Astrelis-Nav/SWARM_COMMs/README.md

# SWARM_COMMs
A modular communication system for underwater ROV swarms and multi-node vehicle systems.
