Astrelis-Nav/SWARM_COMMs/SWARM_PCB_Rev_2/Improvement Notes.txt

Pico 2 EN - floating not tied to GND (or 3.3V like previously)
