Astrelis-Nav/SWARM_COMMs/PCB Design/COMMs_Rev_2/RX_Rev_2/RX_3D_Model_Rev_2.1.step

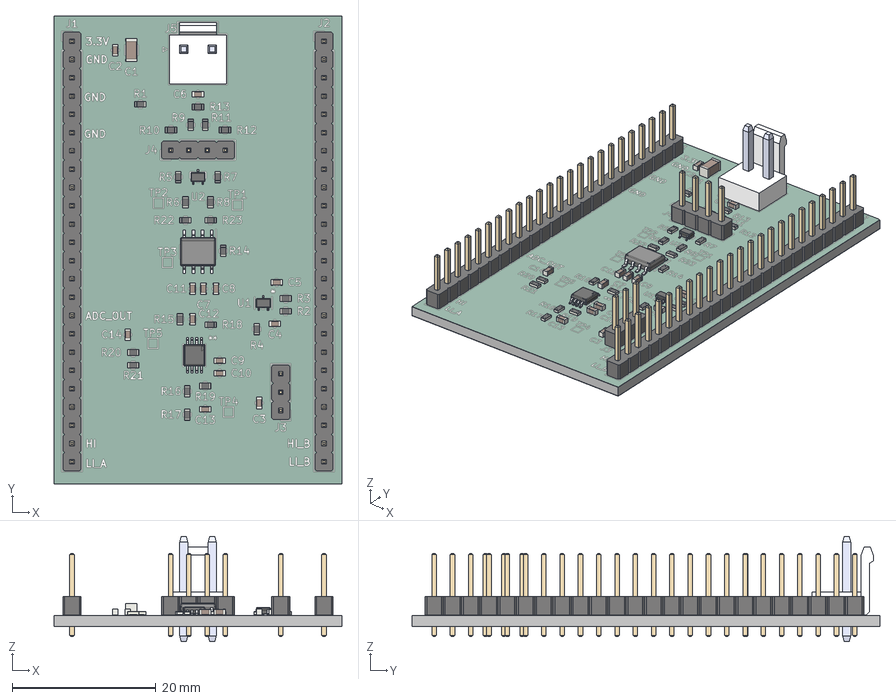
[picture p1: CAD file, 2026-03-30]
PCB Design/COMMs_Rev_2/RX_Rev_2/RX_3D_Model_Rev_2.1.step
40.0 x 65.0 x 14.6 mm
R_0603_1608Metric x 23
C_0603_1608Metric x 13
BODY_MUA08A
LEAD_MUA08A x 8
PinHeader_1x03_P2.54mm_Vertical
PinHeader_1x24_P2.54mm_Vertical x 2
BxP-VH_2
pin x 2
PinHeader_1x04_P2.54mm_Vertical
BODY-SOT x 2
LEAD-SOT x 6
PIN1-ID x 2
BODY-SO
LEAD-D0008A x 8
C_1206_3216Metric
RX_silkscreen x 2
RX_soldermask x 2
RX_PCB
