Astrelis-Nav/SWARM_COMMs/PCB Design/SENSOR_Rev_1/SENSOR_3D_Model_Rev_1.1.step

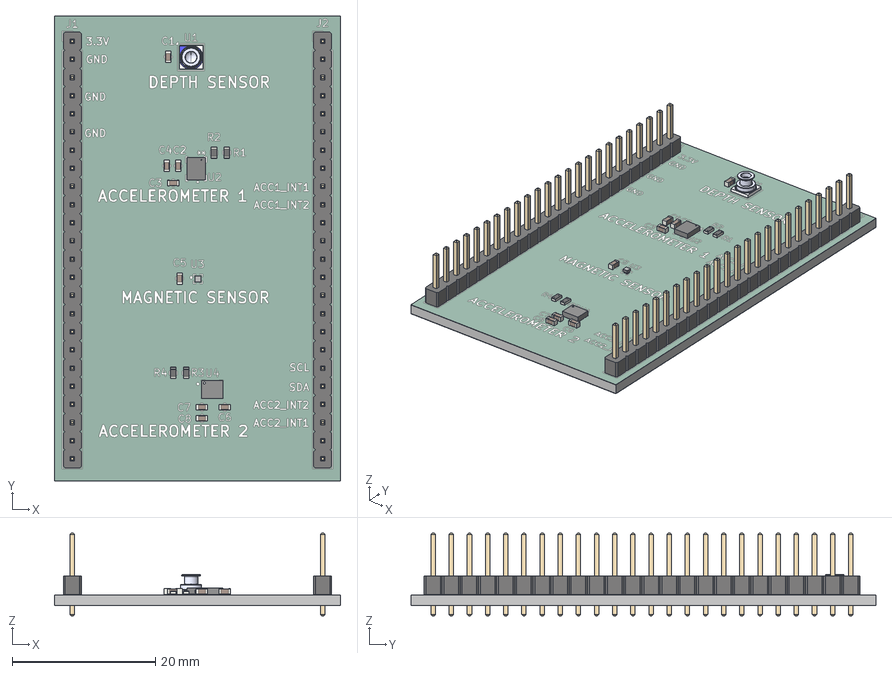
[picture p2: CAD file, 2026-03-30]
PCB Design/SENSOR_Rev_1/SENSOR_3D_Model_Rev_1.1.step
40.0 x 65.0 x 11.5 mm
C_0603_1608Metric x 8
LGA14_2P5X3_STM
R_0603_1608Metric x 4
PinHeader_1x24_P2.54mm_Vertical x 2
LSM6DSO32TR
MS583730BA01-50_MS583730BA01-50
MMC5603NJ
SENSOR_silkscreen x 2
SENSOR_soldermask x 2
SENSOR_PCB
