Astrelis-Nav/SWARM_COMMs/PCB Design/OUTPUTs_Rev_1/OUTPUTs_Schematic_Rev_1.2.pdf

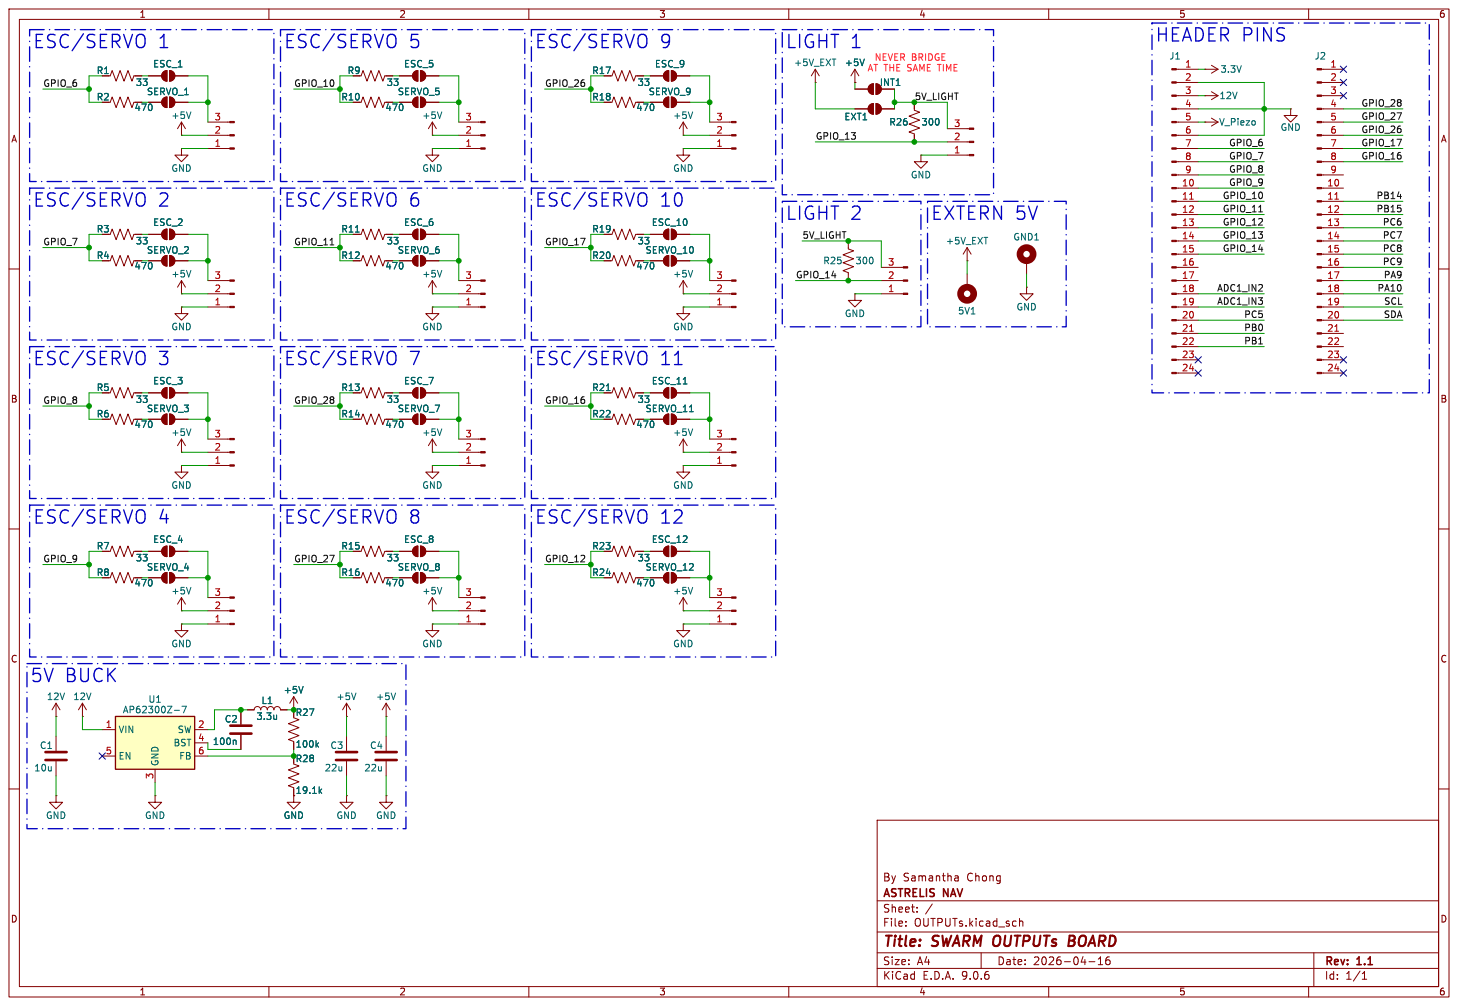
[picture p3: page 1]

Id: 1/1 Title: SWARM OUTPUTs BOARD
