Astrelis-Nav/SWARM_COMMs/PCB Design/PWR_Rev_1/PWR_Schematic_Rev_1.2.pdf

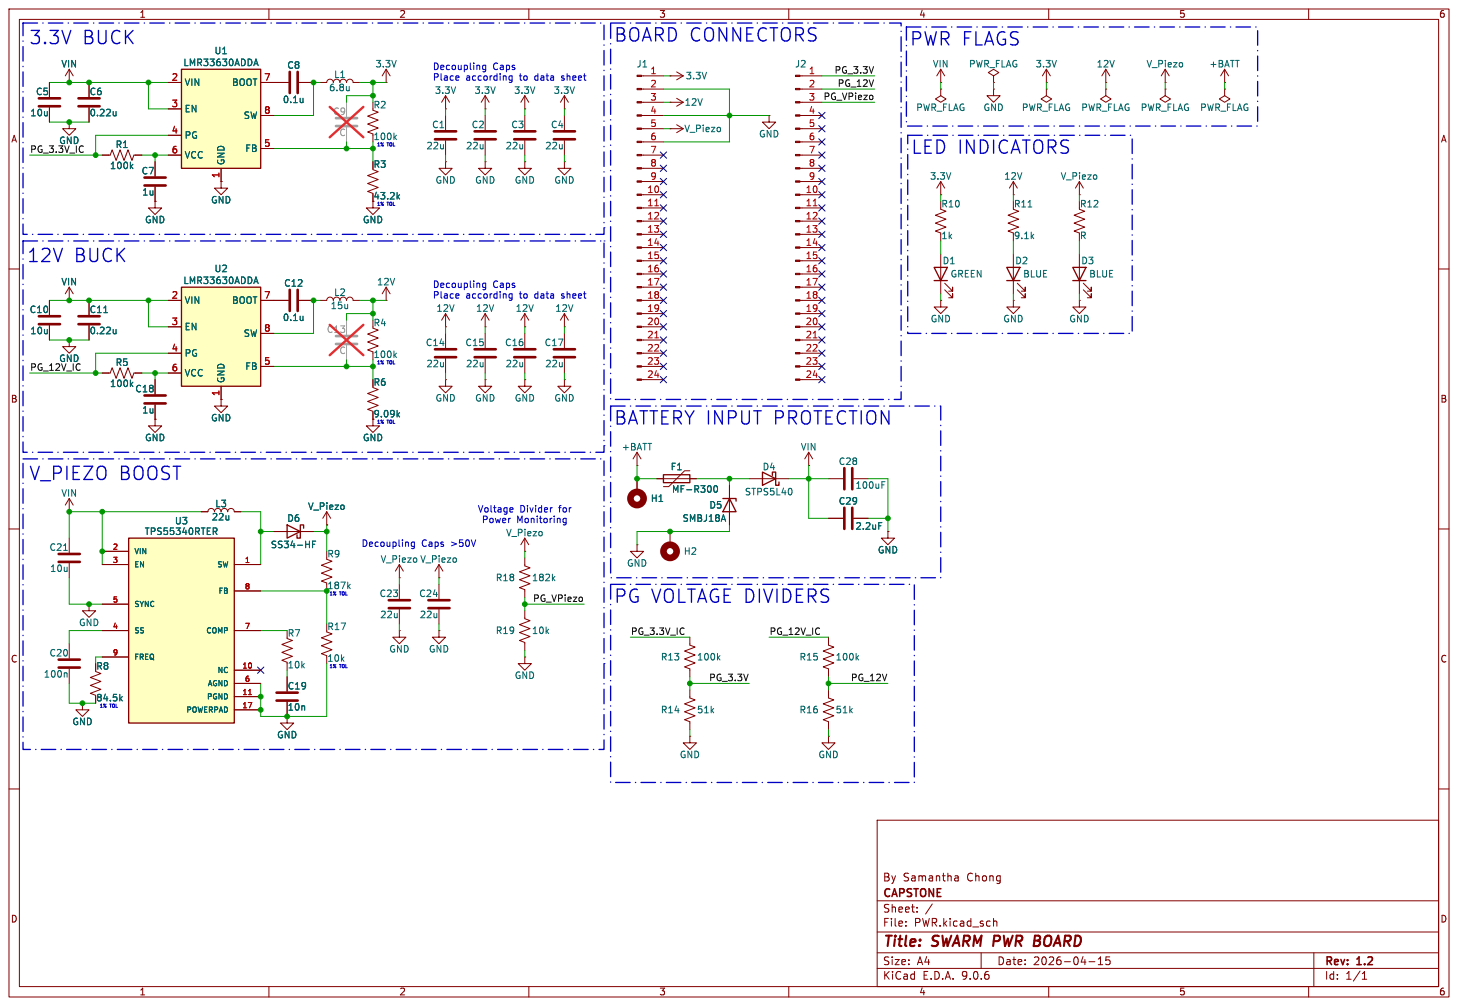
[picture p4: page 1]

1 BOOT 7 SW 8 FB GND 5 R1

By Samantha Chong
File: PWR.kicad_sch Sheet: / CAPSTONE

Id: 1/1 Title: SWARM PWR BOARD
