Astrelis-Nav/SWARM_COMMs/PCB Design/CONTROL_Rev_1/CONTROL_Schematic_Rev_1.1.pdf

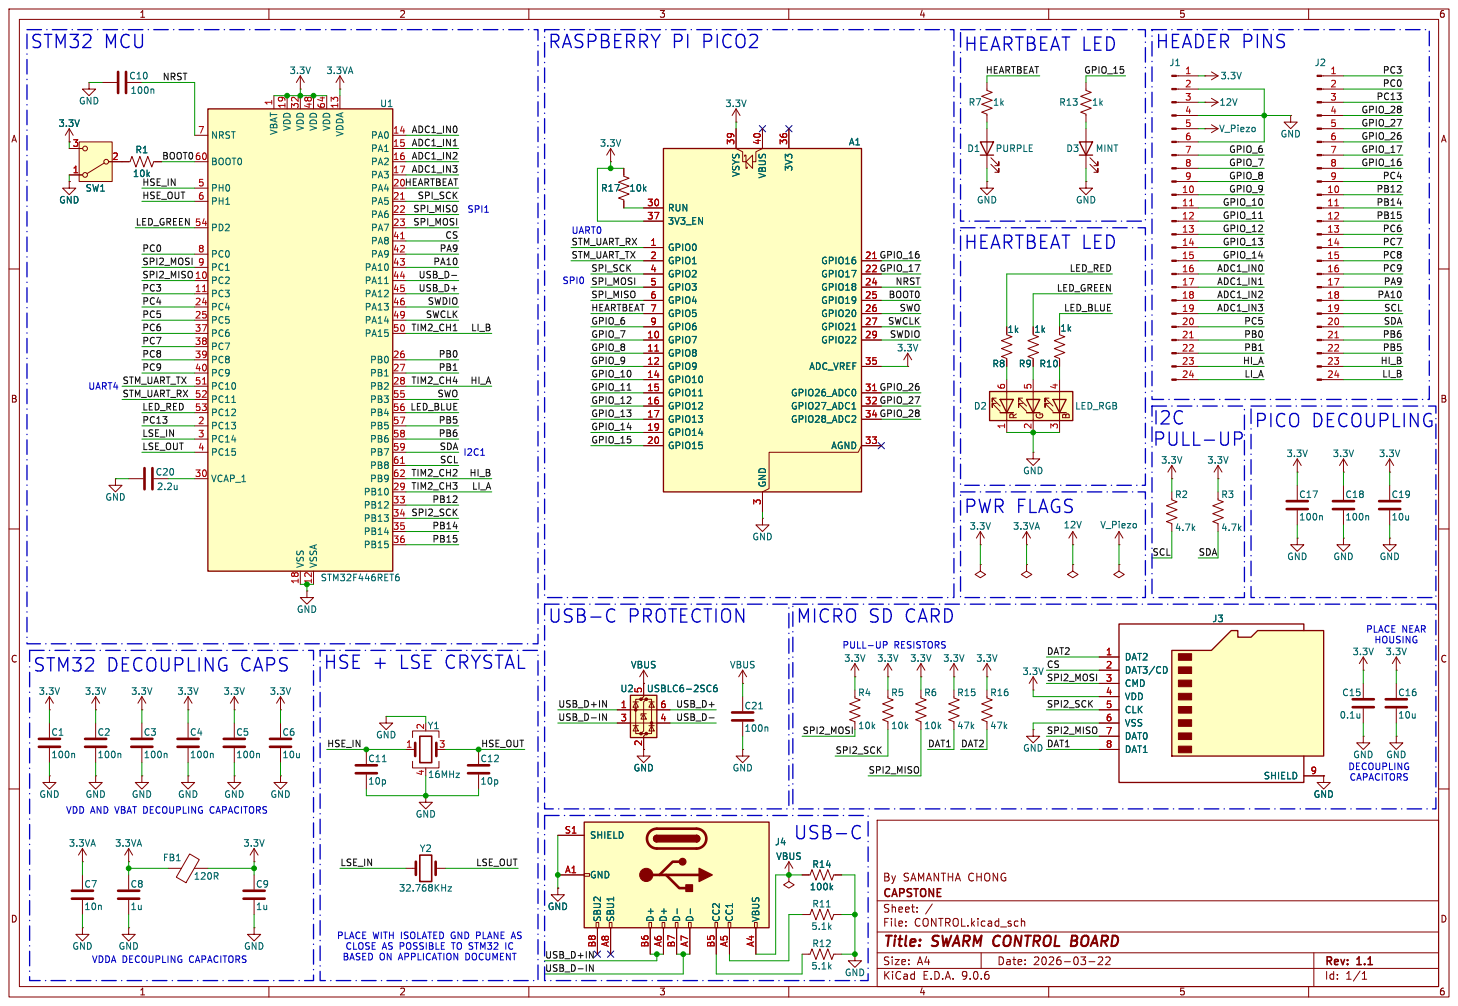
[picture p5: page 1]

1 VDD 19 VDD 32 VSS 18 VDD 48 VSSA 12 VDD 64 VDDA 13 PA0 14 PA1 15 PA2 16 PA3 17 PA4 20 PA5 21 PA6 22 PA7 23 PA8 41 PA9 42 PA10 43 PA11 44 PA12 45 PA13 46 PA14 49 PA15 50 PB0 26 PB1 27 PB2 28 PB3 55 PB4 56 PB5 57 PB6 58 PB7 59 PB8 61 PB9 62 PB10 29 PB12 33 PB13 34 PB14 35 PB15 36 U1 STM32F446RET6 D1 PURPLE R7 1k GND

100k VBUS GND
VDD AND VBAT DECOUPLING CAPACITORS

By SAMANTHA CHONG
File: CONTROL.kicad_sch Sheet: / CAPSTONE

Id: 1/1 Title: SWARM CONTROL BOARD

PLACE WITH ISOLATED GND PLANE AS CLOSE AS POSSIBLE TO STM32 IC

BASED ON APPLICATION DOCUMENT
