Astrelis-Nav/SWARM_COMMs/PCB Design/SENSOR_Rev_1/SENSOR_Schematic_Rev_1.1.pdf

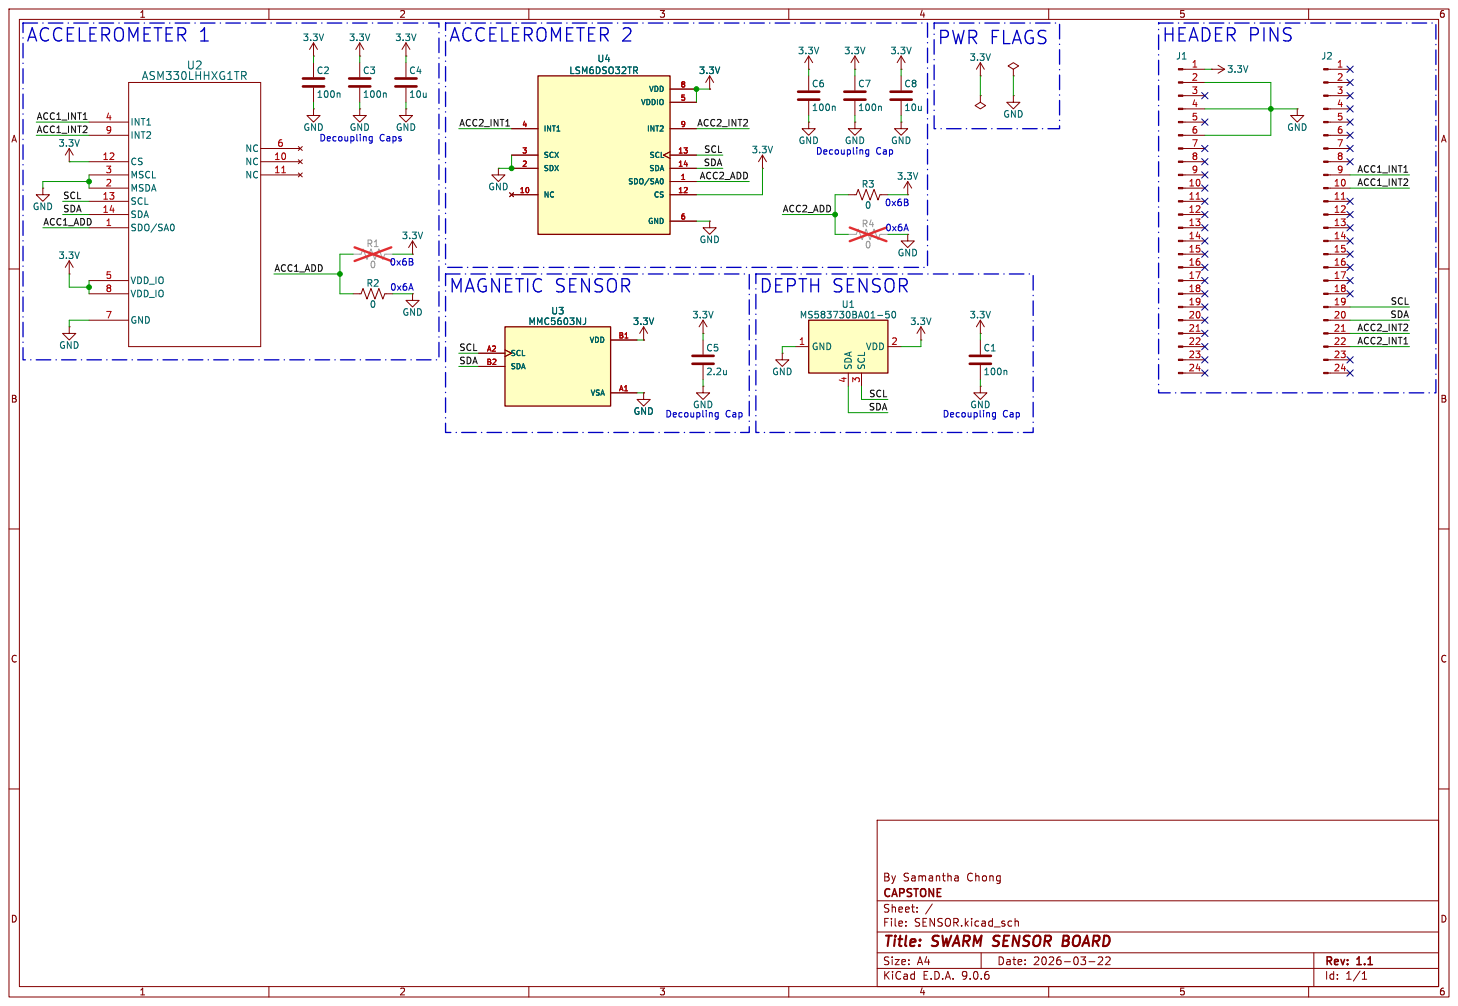
[picture p6: page 1]

By Samantha Chong
File: SENSOR.kicad_sch Sheet: / CAPSTONE

Id: 1/1 Title: SWARM SENSOR BOARD
