Astrelis-Nav/SWARM_COMMs/PCB Design/COMMs_Rev_2/RX_Rev_2/RX_Schematic_Rev_2.1.pdf

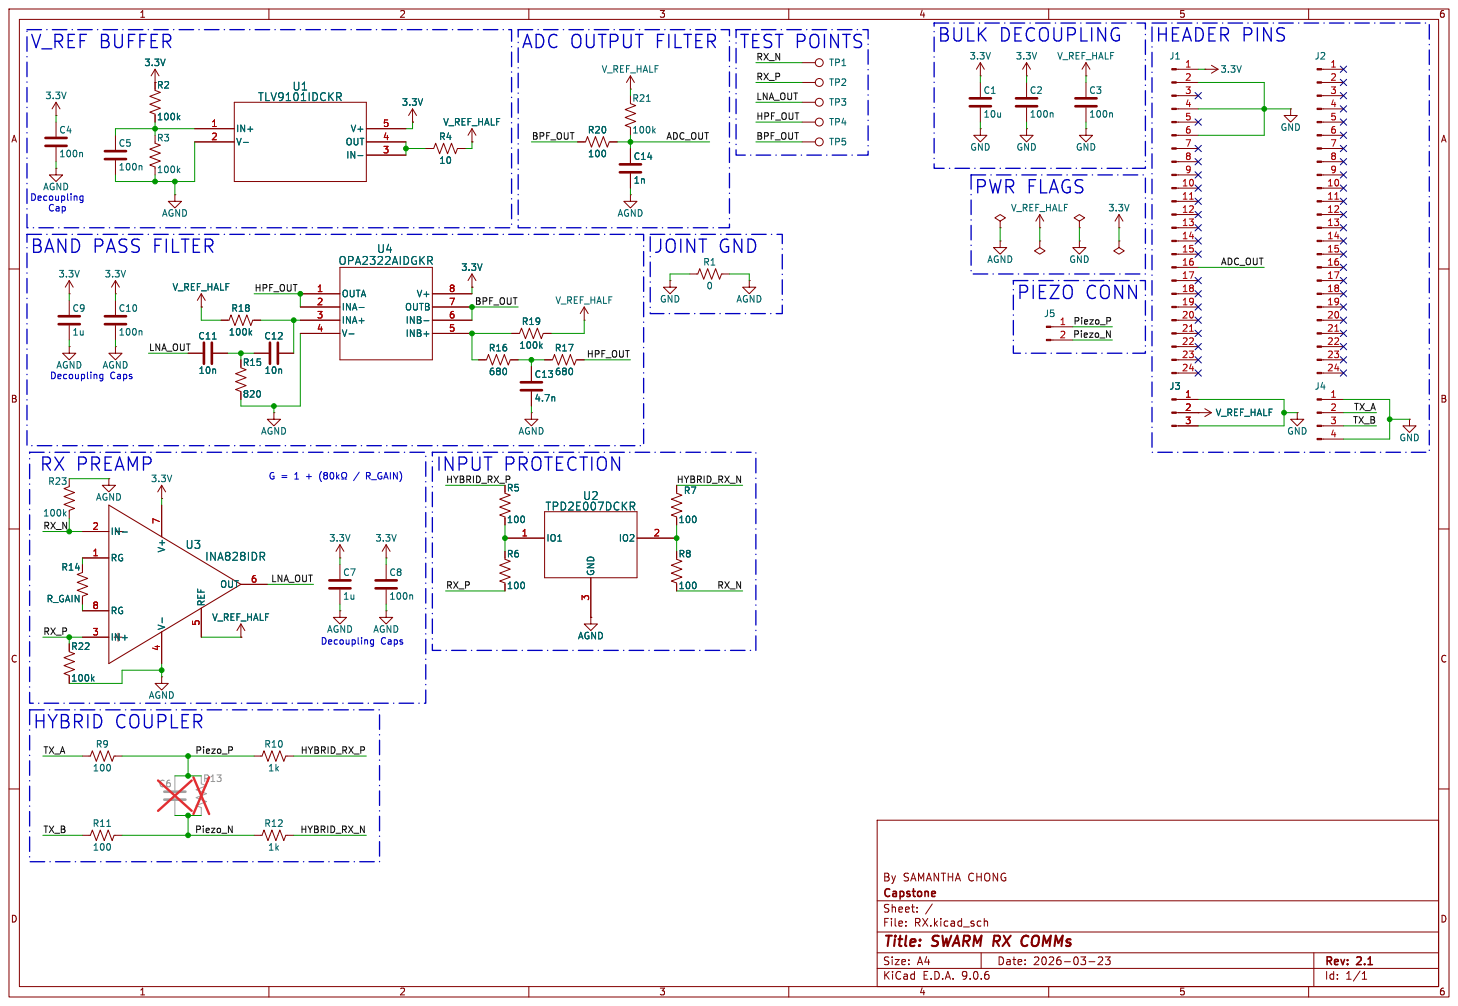
[picture p7: page 1]

By SAMANTHA CHONG
File: RX.kicad_sch Sheet: / Capstone

Id: 1/1 Title: SWARM RX COMMs
