Astrelis-Nav/SWARM_COMMs/PCB Design/COMMs_Rev_2/TX_Rev_2/TX_Schematic_Rev_2.1.pdf

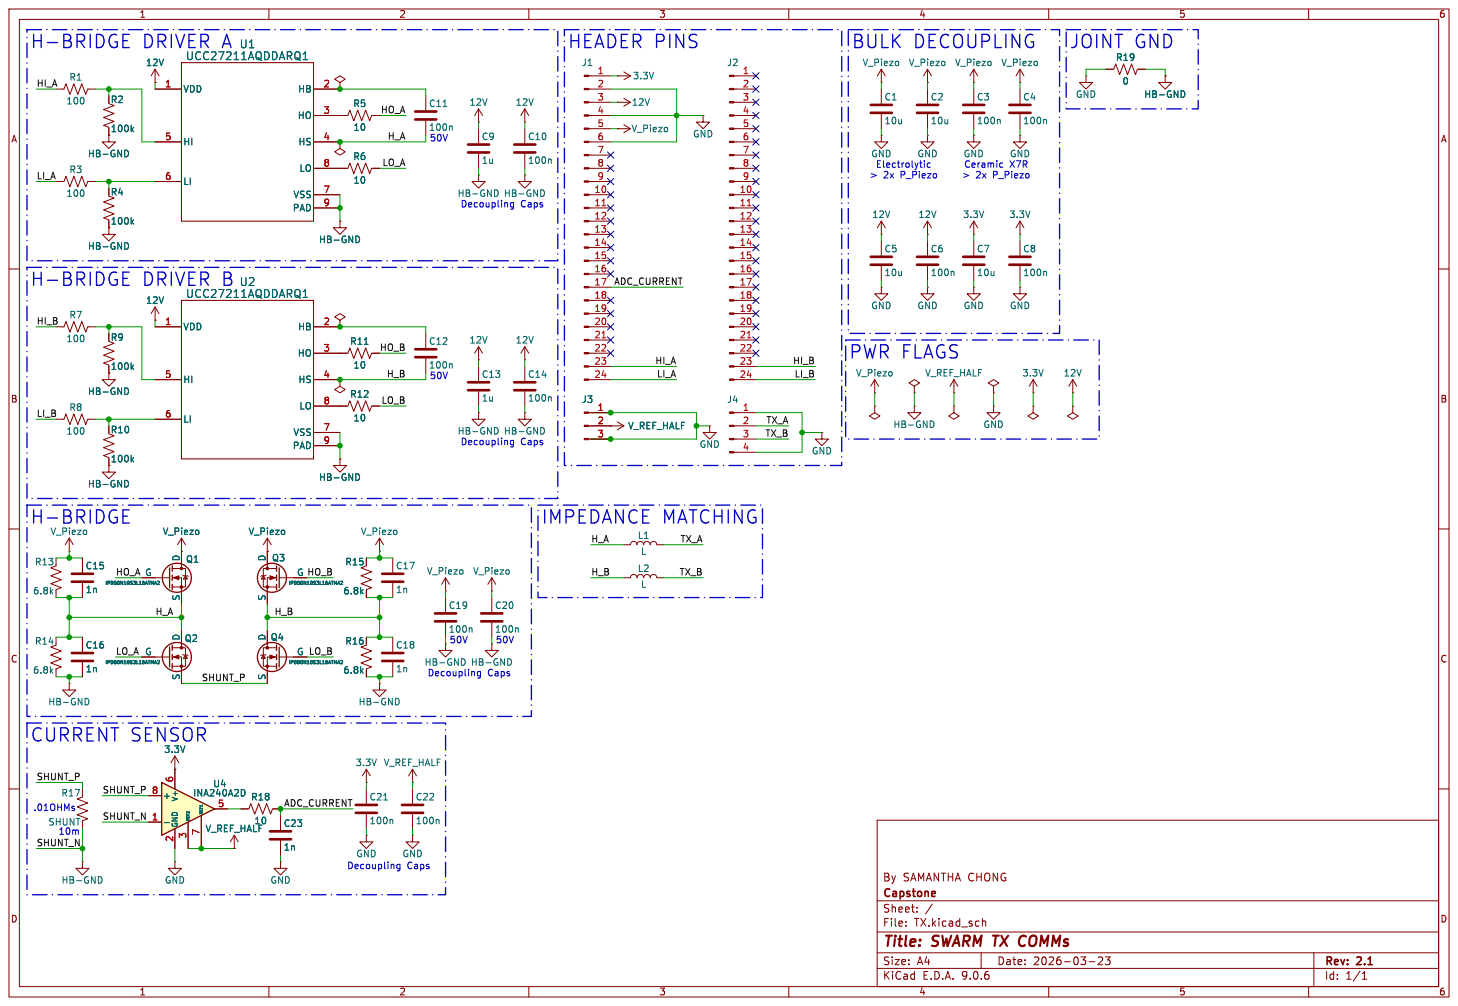
[picture p8: page 1]

By SAMANTHA CHONG
File: TX.kicad_sch Sheet: / Capstone

Id: 1/1 Title: SWARM TX COMMs
