Astrelis-Nav/SWARM_COMMs/SWARM_PCB_Rev_2/SWARM_PCB_Rev_2.pdf

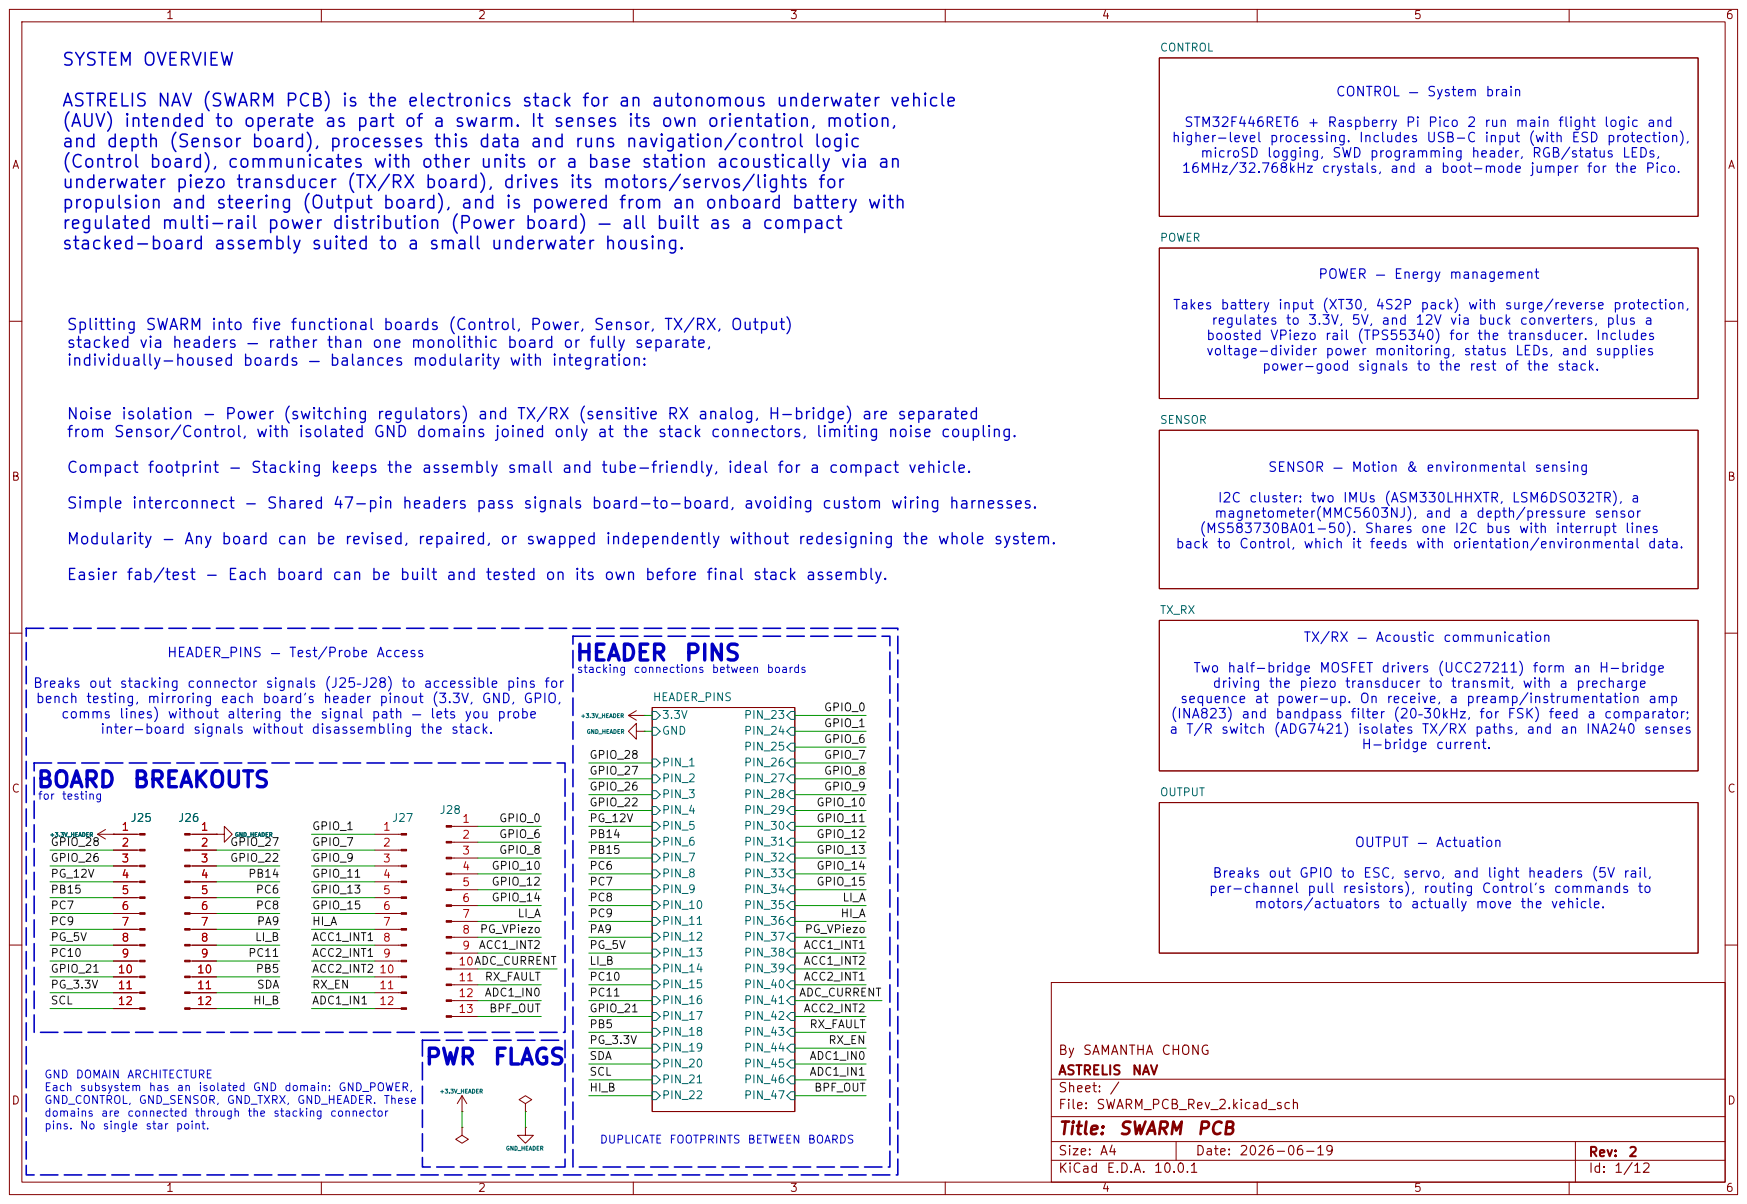
[picture p9: page 1]

ASTRELIS NAV (SWARM PCB) is the electronics stack for an autonomous underwater vehicle
(AUV) intended to operate as part of a swarm. It senses its own orientation, motion,
and depth (Sensor board), processes this data and runs navigation/control logic
(Control board), communicates with other units or a base station acoustically via an
underwater piezo transducer (TX/RX board), drives its motors/servos/lights for
propulsion and steering (Output board), and is powered from an onboard battery with
regulated multi-rail power distribution (Power board) — all built as a compact
stacked-board assembly suited to a small underwater housing.

STM32F446RET6 + Raspberry Pi Pico 2 run main flight logic and
higher-level processing. Includes USB-C input (with ESD protection),

stacked via headers — rather than one monolithic board or fully separate,
individually-housed boards — balances modularity with integration:

boosted VPiezo rail (TPS55340) for the transducer. Includes

power-good signals to the rest of the stack.

SENSOR — Motion & environmental sensing

TX/RX — Acoustic communication

Breaks out stacking connector signals (J25–J28) to accessible pins for

Two half-bridge MOSFET drivers (UCC27211) form an H-bridge

inter-board signals without disassembling the stack.
BOARD BREAKOUTS
for testing

motors/actuators to actually move the vehicle.

PWR FLAGS

GND DOMAIN ARCHITECTURE
Each subsystem has an isolated GND domain: GND_POWER,

Size: A4 | Rev: 2
KiCad E.D.A. 10.0.1 | Id: 1/12

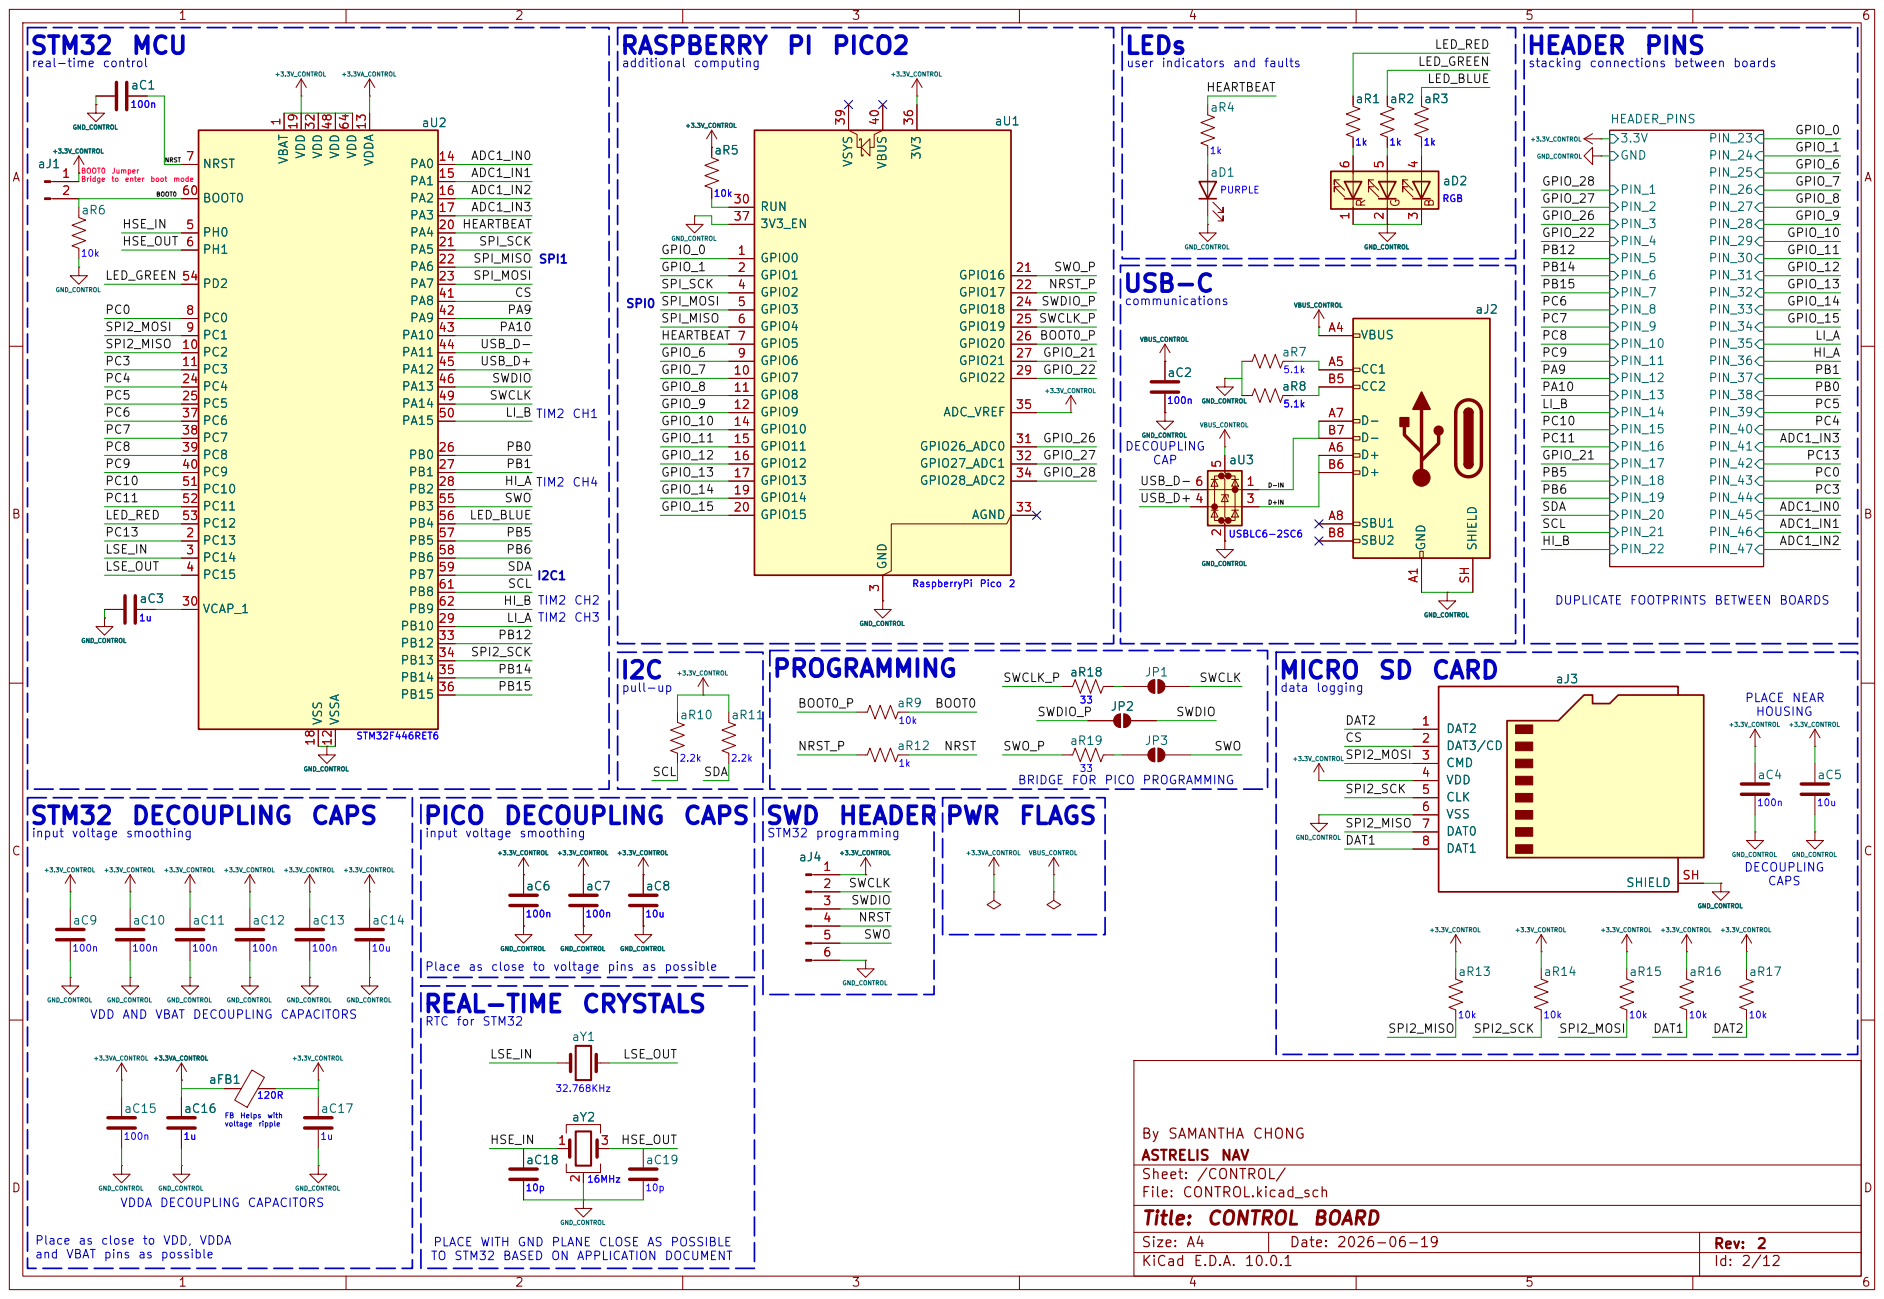
[picture p10: page 2]

user indicators and faults LEDs

VDD AND VBAT DECOUPLING CAPACITORS

TO STM32 BASED ON APPLICATION DOCUMENT

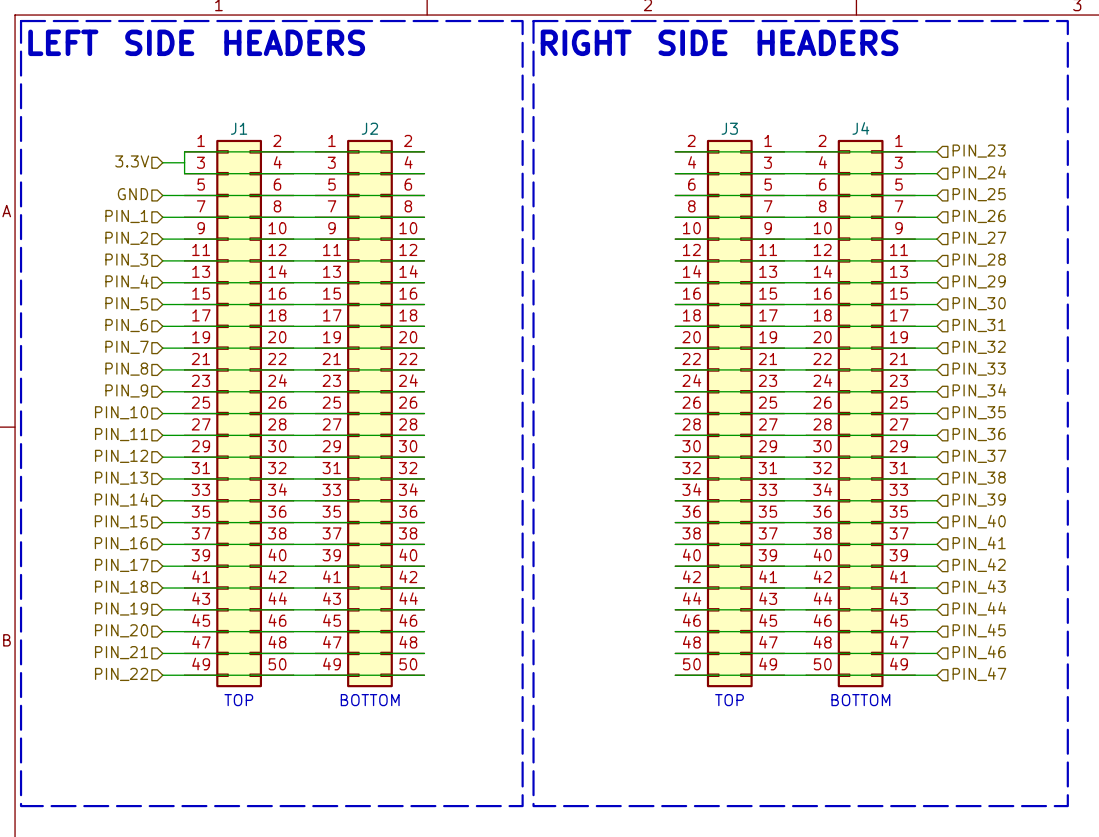
[picture p11: page 3]

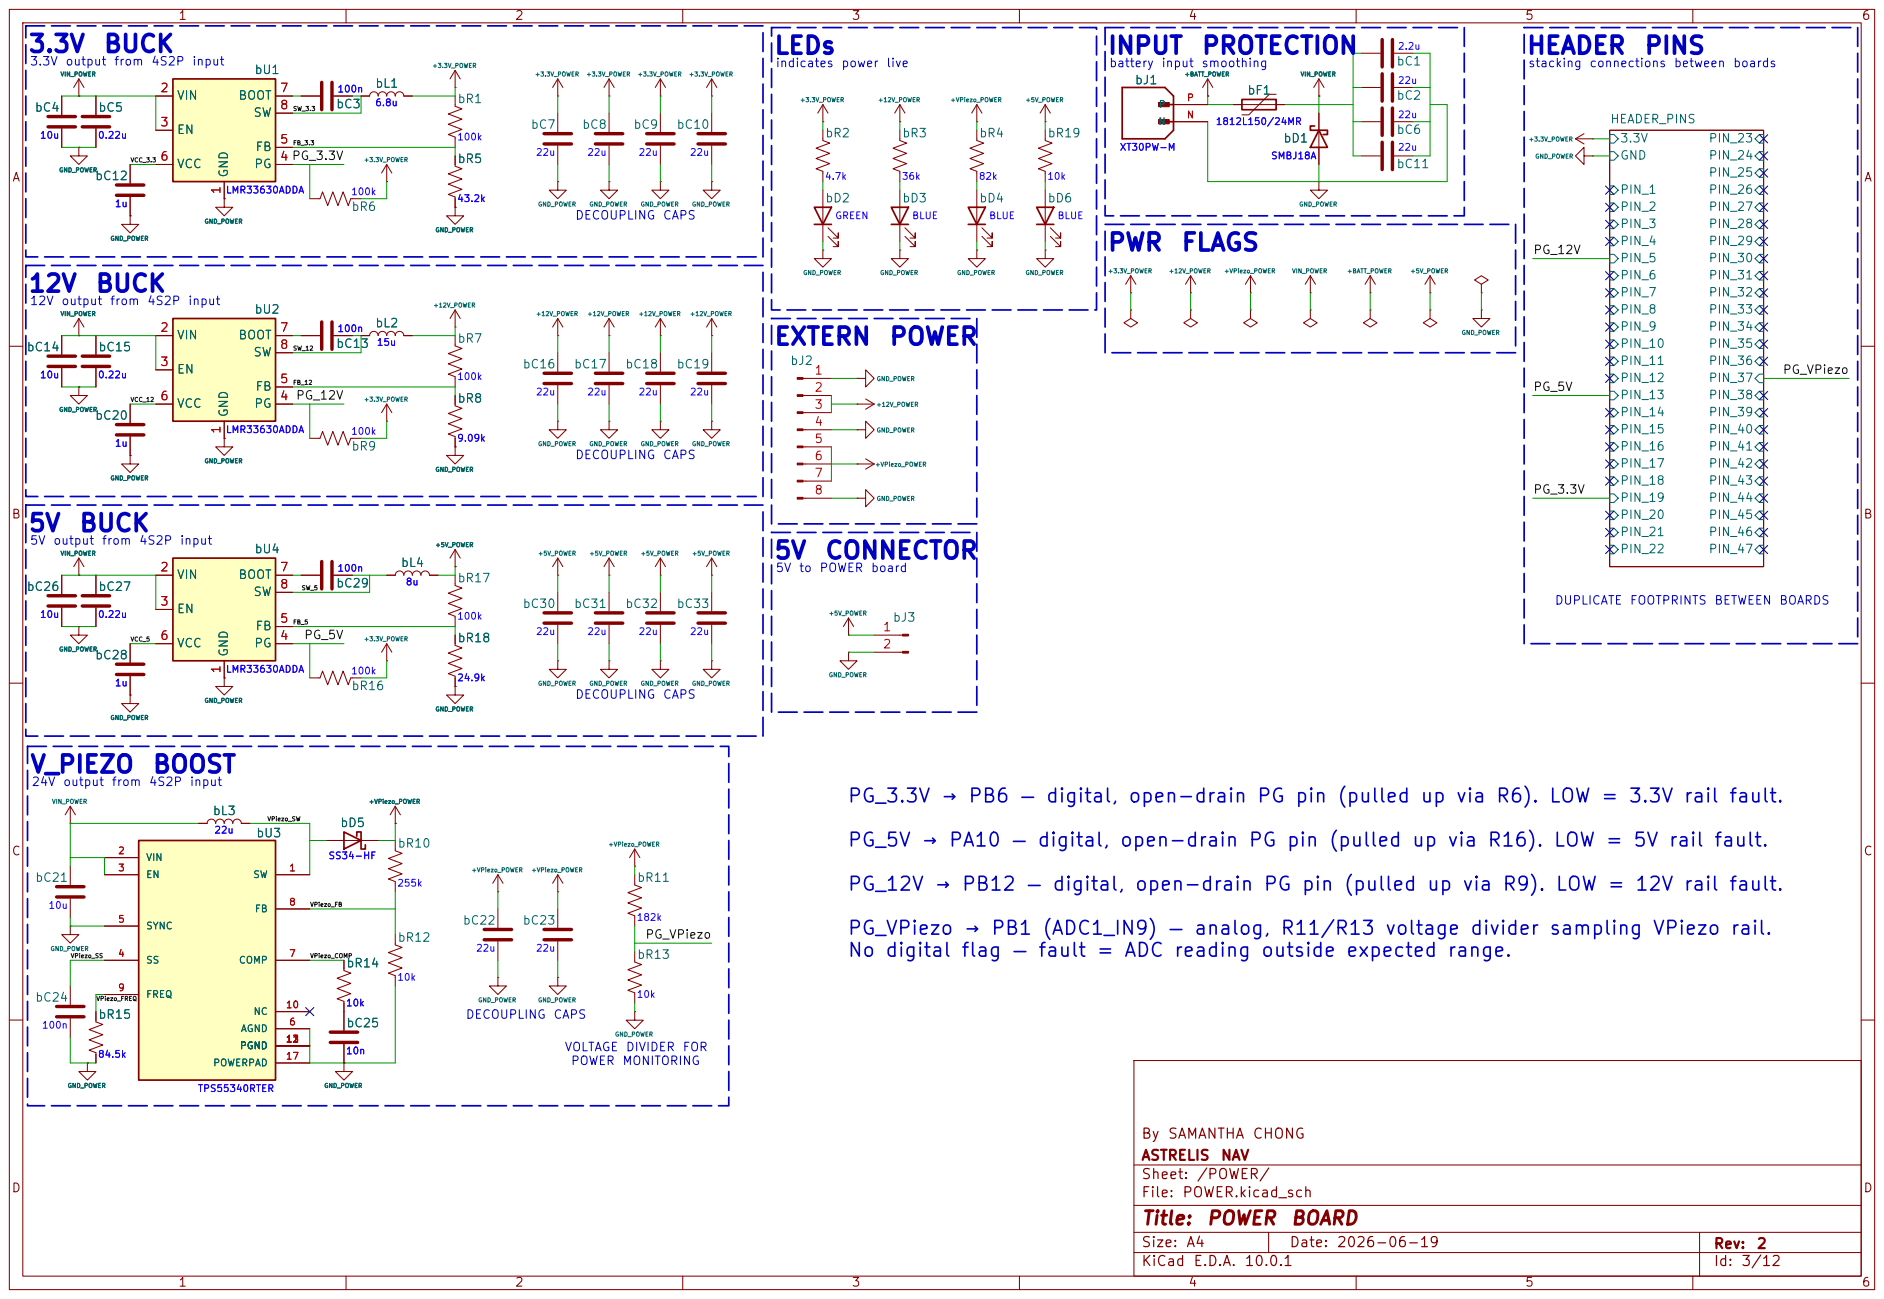
[picture p12: page 4]

3.3V BUCK 3.3V output from 4S2P input | LEDs +3.3V_POWER +12V_POWER 4.7k bR2 bR3 82k 10k GND_POWER

DECOUPLING CAPS 12V BUCK 12V output from 4S2P input

PG_3.3V → PB6 — digital, open-drain PG pin (pulled up via R6). LOW = 3.3V rail fault.

PG_5V → PA10 — digital, open-drain PG pin (pulled up via R16). LOW = 5V rail fault.

PG_12V → PB12 — digital, open-drain PG pin (pulled up via R9). LOW = 12V rail fault.

PG_VPiezo → PB1 (ADC1_IN9) — analog, R11/R13 voltage divider sampling VPiezo rail.
No digital flag — fault = ADC reading outside expected range.

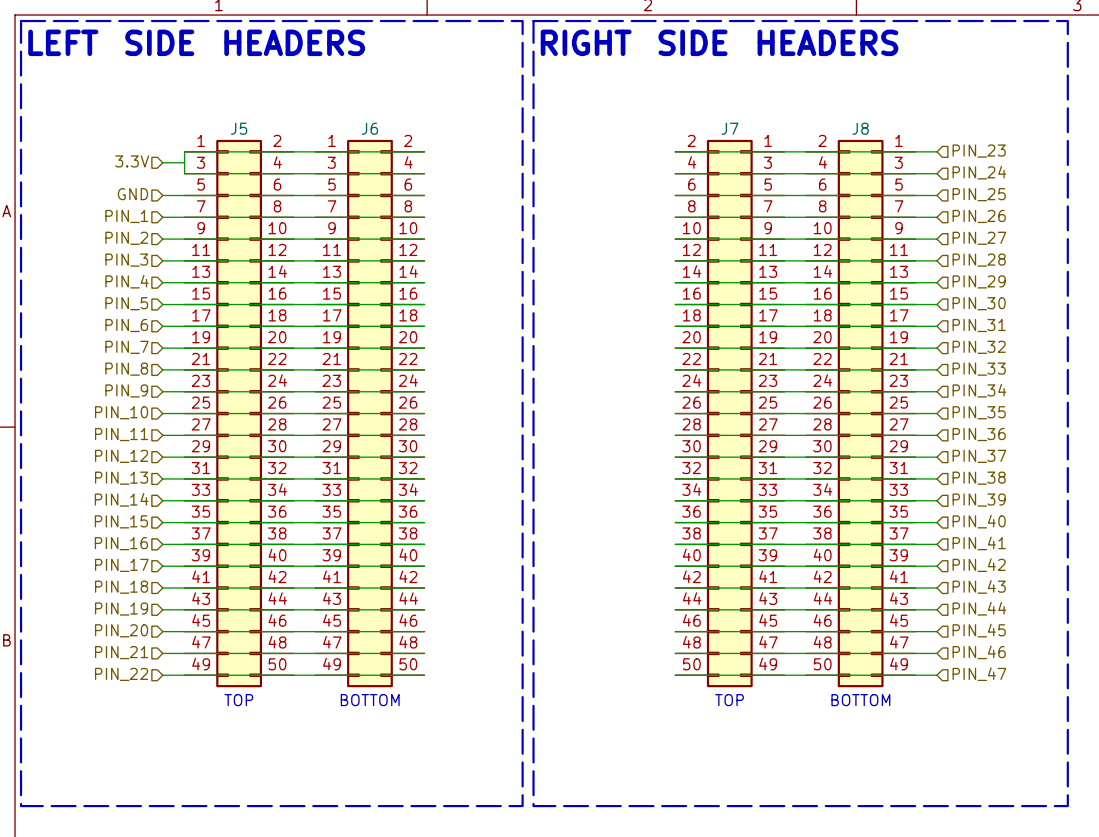
[picture p13: page 5]

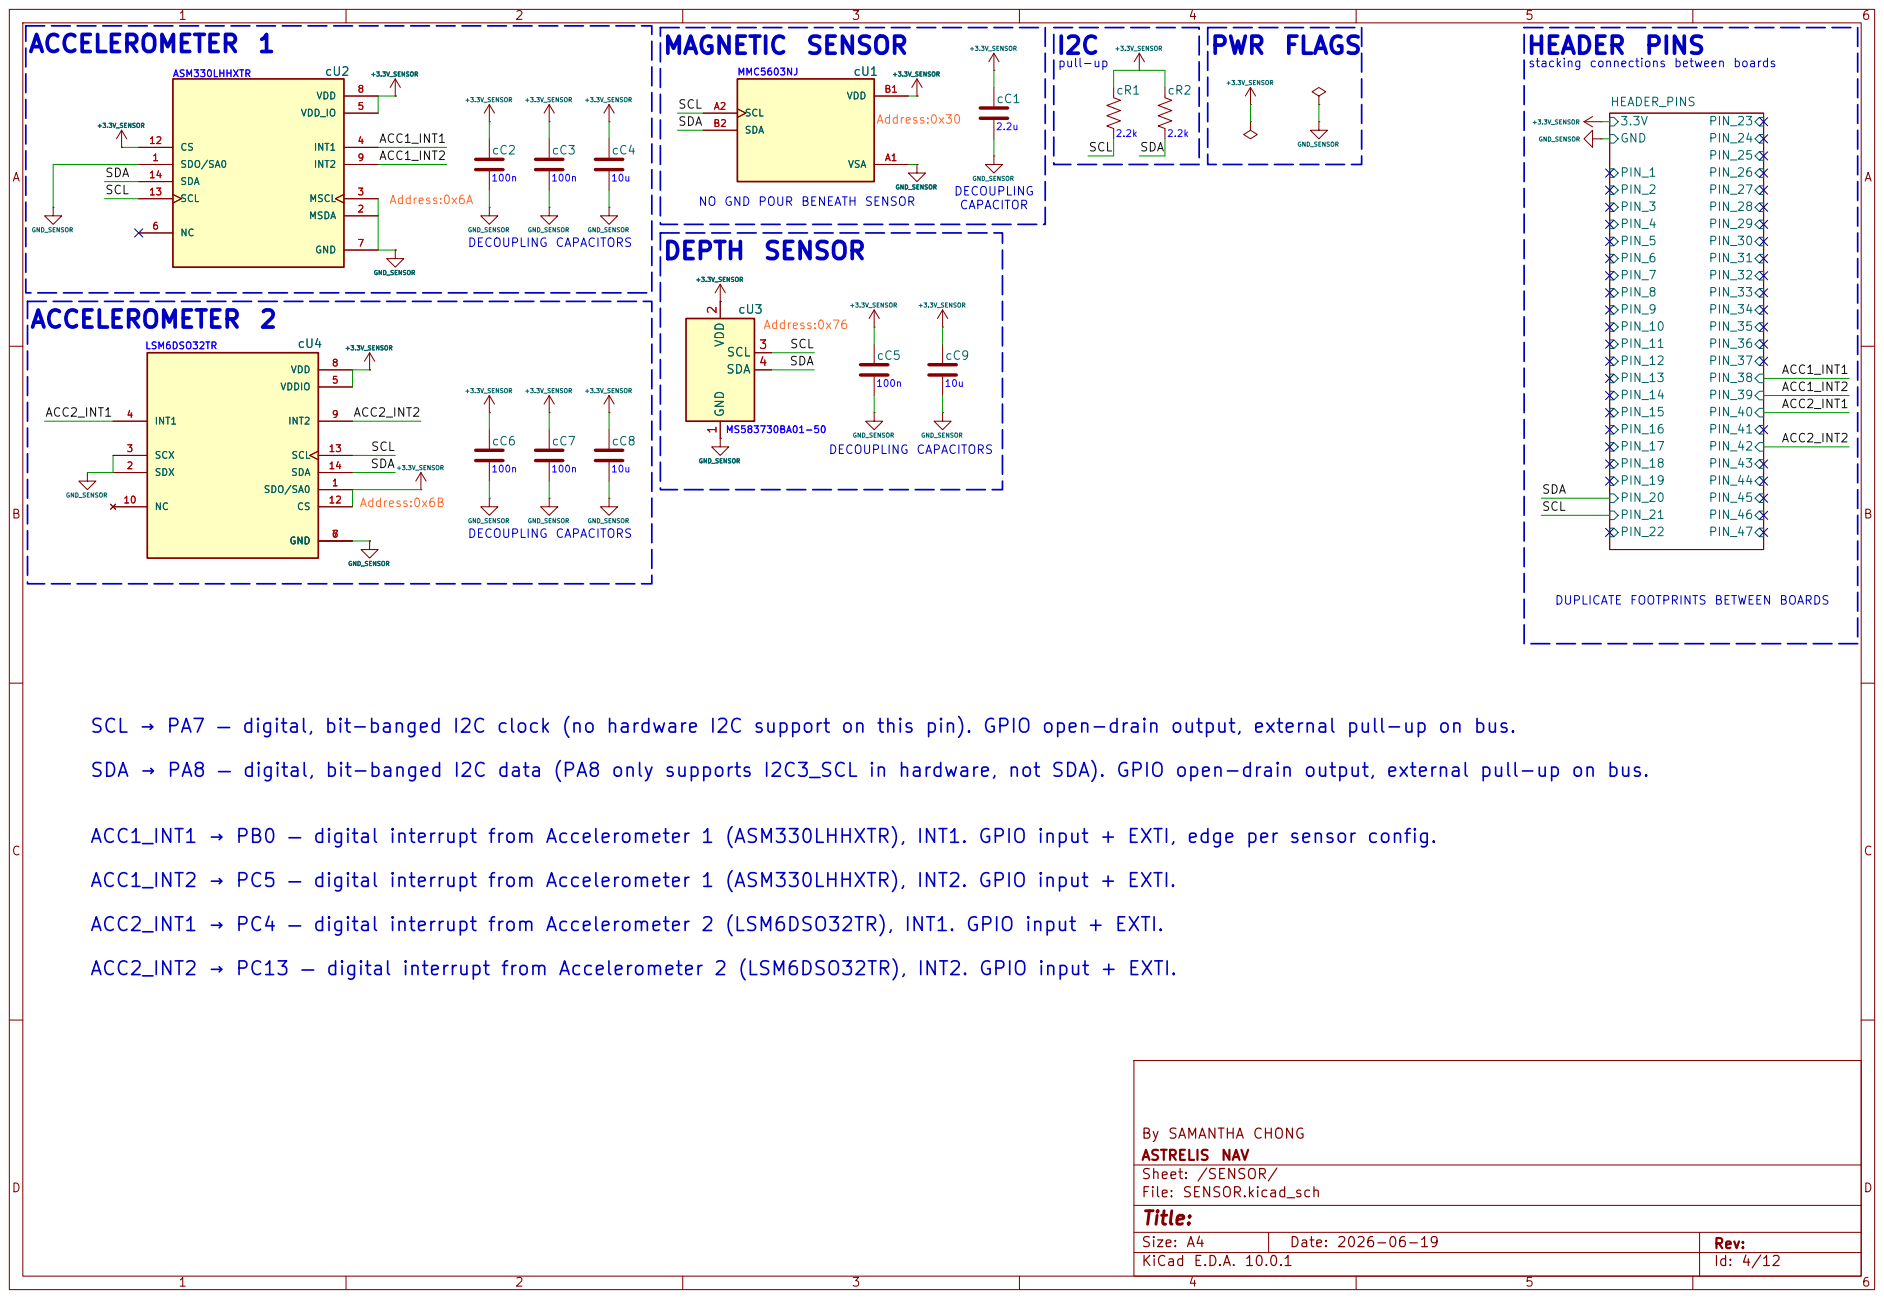
[picture p14: page 6]

SCL → PA7 — digital, bit-banged I2C clock (no hardware I2C support on this pin). GPIO open-drain output, external pull-up on bus.

SDA → PA8 — digital, bit-banged I2C data (PA8 only supports I2C3_SCL in hardware, not SDA). GPIO open-drain output, external pull-up on bus.

ACC1_INT1 → PB0 — digital interrupt from Accelerometer 1 (ASM330LHHXTR), INT1. GPIO input + EXTI, edge per sensor config.

ACC1_INT2 → PC5 — digital interrupt from Accelerometer 1 (ASM330LHHXTR), INT2. GPIO input + EXTI.

ACC2_INT1 → PC4 — digital interrupt from Accelerometer 2 (LSM6DSO32TR), INT1. GPIO input + EXTI.

ACC2_INT2 → PC13 — digital interrupt from Accelerometer 2 (LSM6DSO32TR), INT2. GPIO input + EXTI.

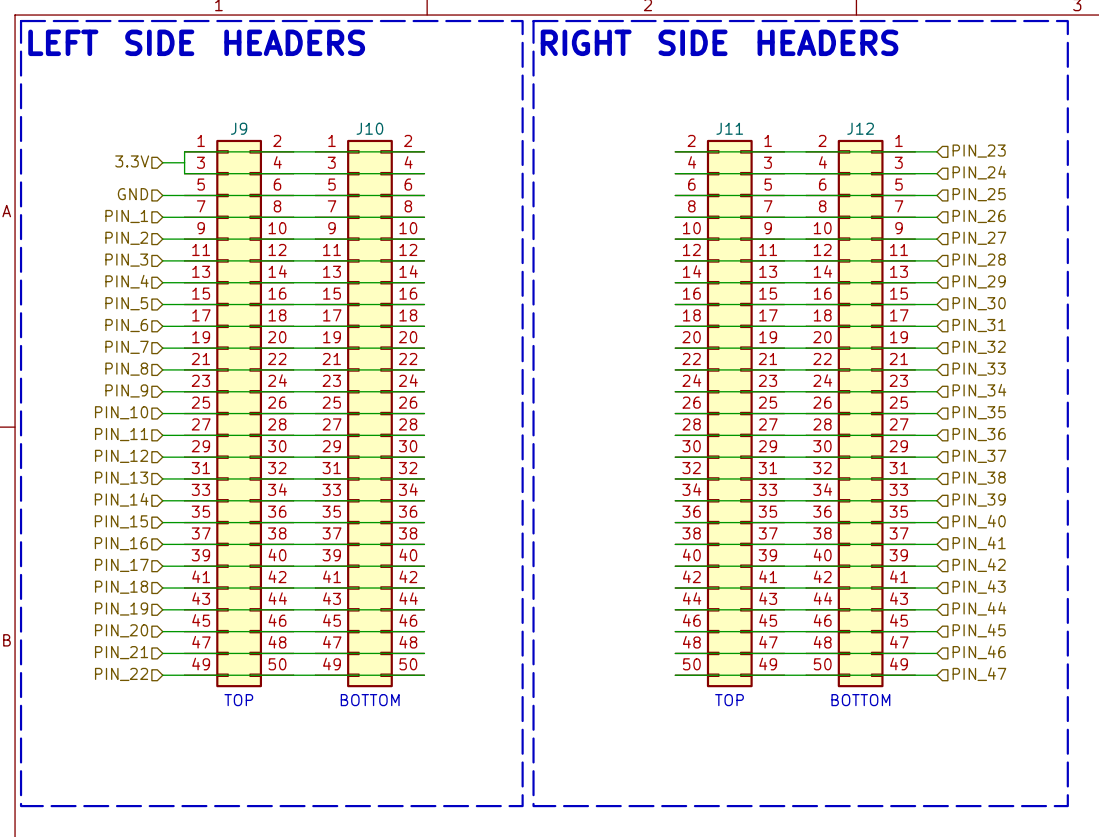
[picture p15: page 7]

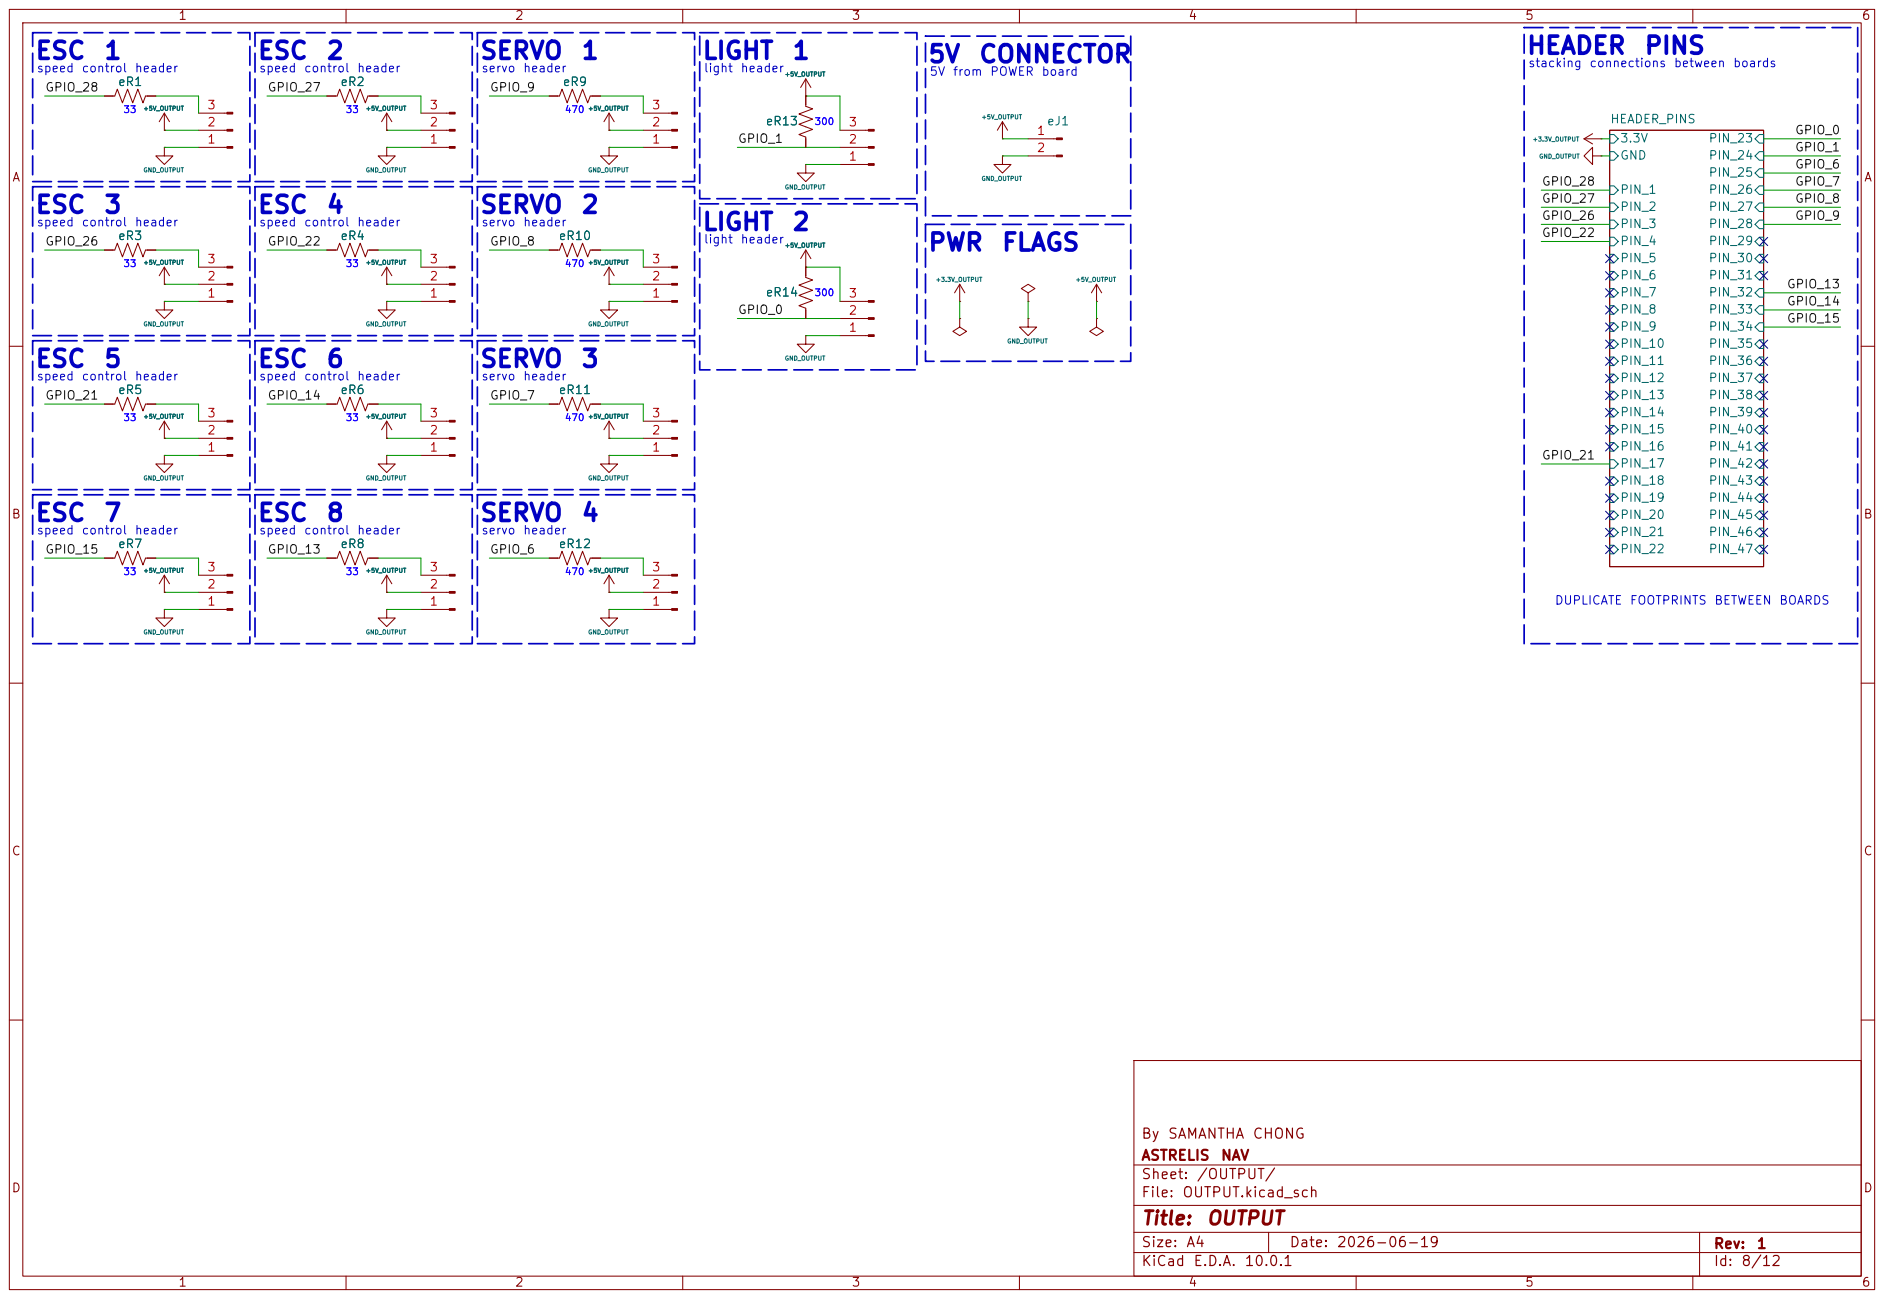
[picture p16: page 8]

5V from POWER board 5V CONNECTOR

speed control header ESC 5

speed control header | | ESC 4 speed control header ESC 3 speed control header ESC 6 eR4 | | servo header eR4 | 1

GND_OUTPUT | 1 | speed control header | 1 | servo header SERVO 3 servo header ESC 7

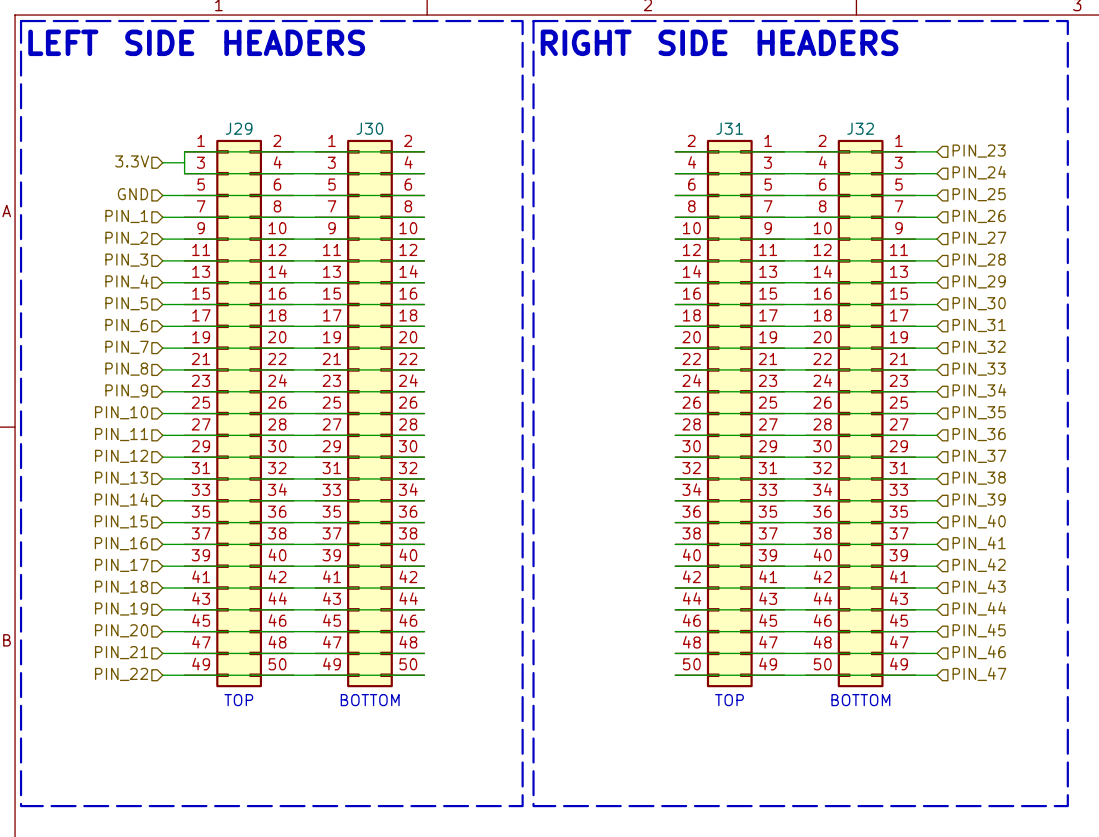
[picture p17: page 9]

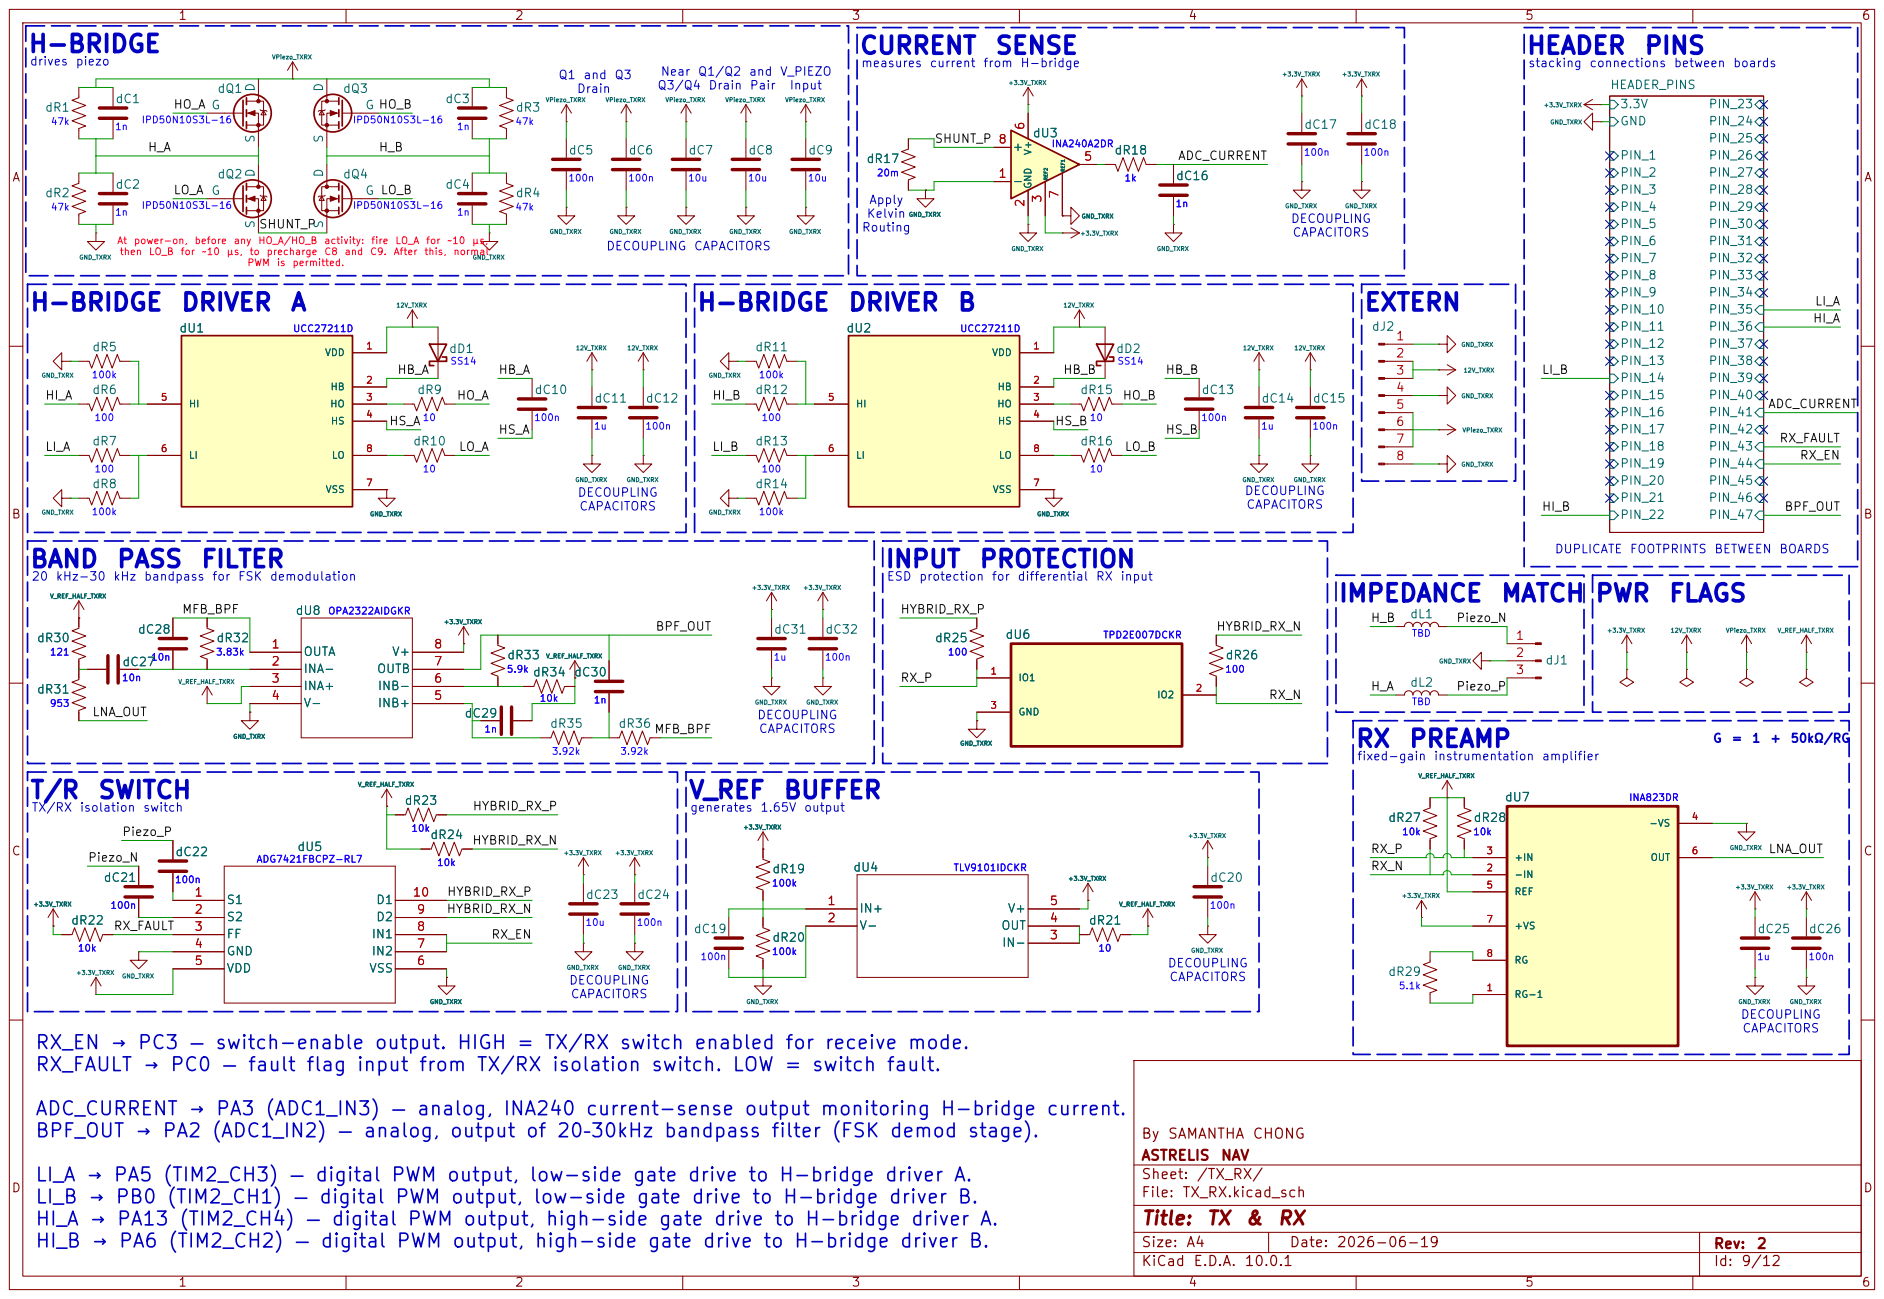
[picture p18: page 10]

H-BRIDGE
stacking connections between boards Q1 and Q3 Drain 20 kHz-30 kHz bandpass for FSK demodulation

CURRENT SENSE measures current from H-bridge

fixed-gain instrumentation amplifier DECOUPLING

DUPLICATE FOOTPRINTS BETWEEN BOARDS
GND_TXRX +3.3V_TXRX

RX PREAMP V_REF_HALF_TXRX V_REF_HALF_TXRXdR28

V_REF_HALF_TXRX | V_REF BUFFER generates 1.65V output

CAPACITORS RX_EN → PC3 — switch-enable output. HIGH = TX/RX switch enabled for receive mode.
RX_FAULT → PC0 — fault flag input from TX/RX isolation switch. LOW = switch fault.

ADC_CURRENT → PA3 (ADC1_IN3) — analog, INA240 current-sense output monitoring H-bridge current.
BPF_OUT → PA2 (ADC1_IN2) — analog, output of 20–30kHz bandpass filter (FSK demod stage).

LI_A → PA5 (TIM2_CH3) — digital PWM output, low-side gate drive to H-bridge driver A.
LI_B → PB0 (TIM2_CH1) — digital PWM output, low-side gate drive to H-bridge driver B.
HI_A → PA13 (TIM2_CH4) — digital PWM output, high-side gate drive to H-bridge driver A.
HI_B → PA6 (TIM2_CH2) — digital PWM output, high-side gate drive to H-bridge driver B.

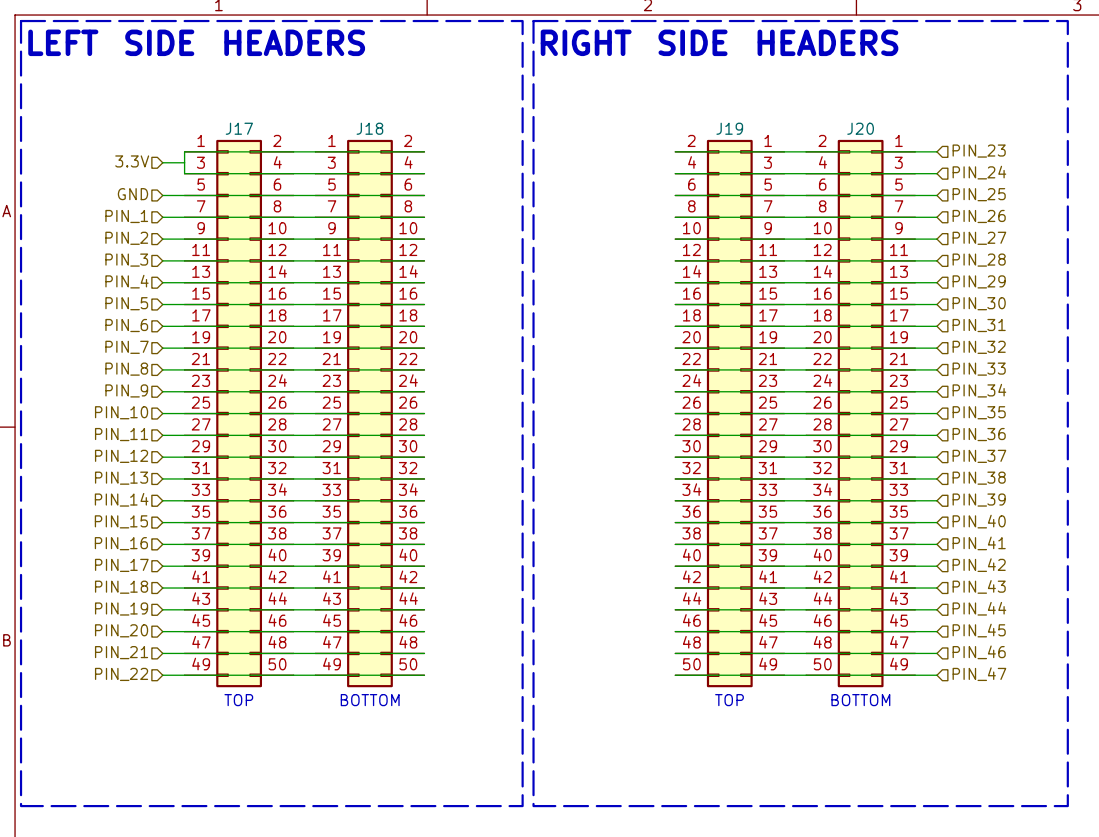
[picture p19: page 11]

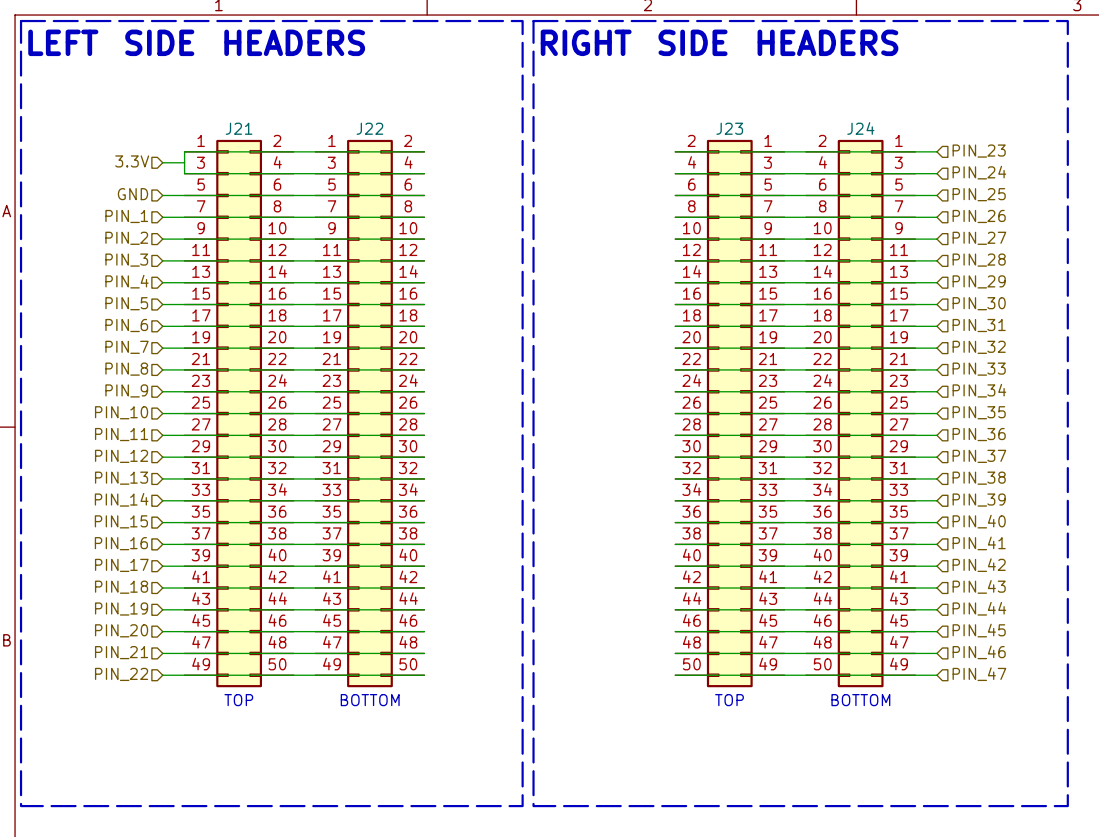
[picture p20: page 12]
