Astrelis-Nav/SWARM_COMMs/PCB Design/COMMs_Rev_1/COMMs_V1.0_Schematic.pdf

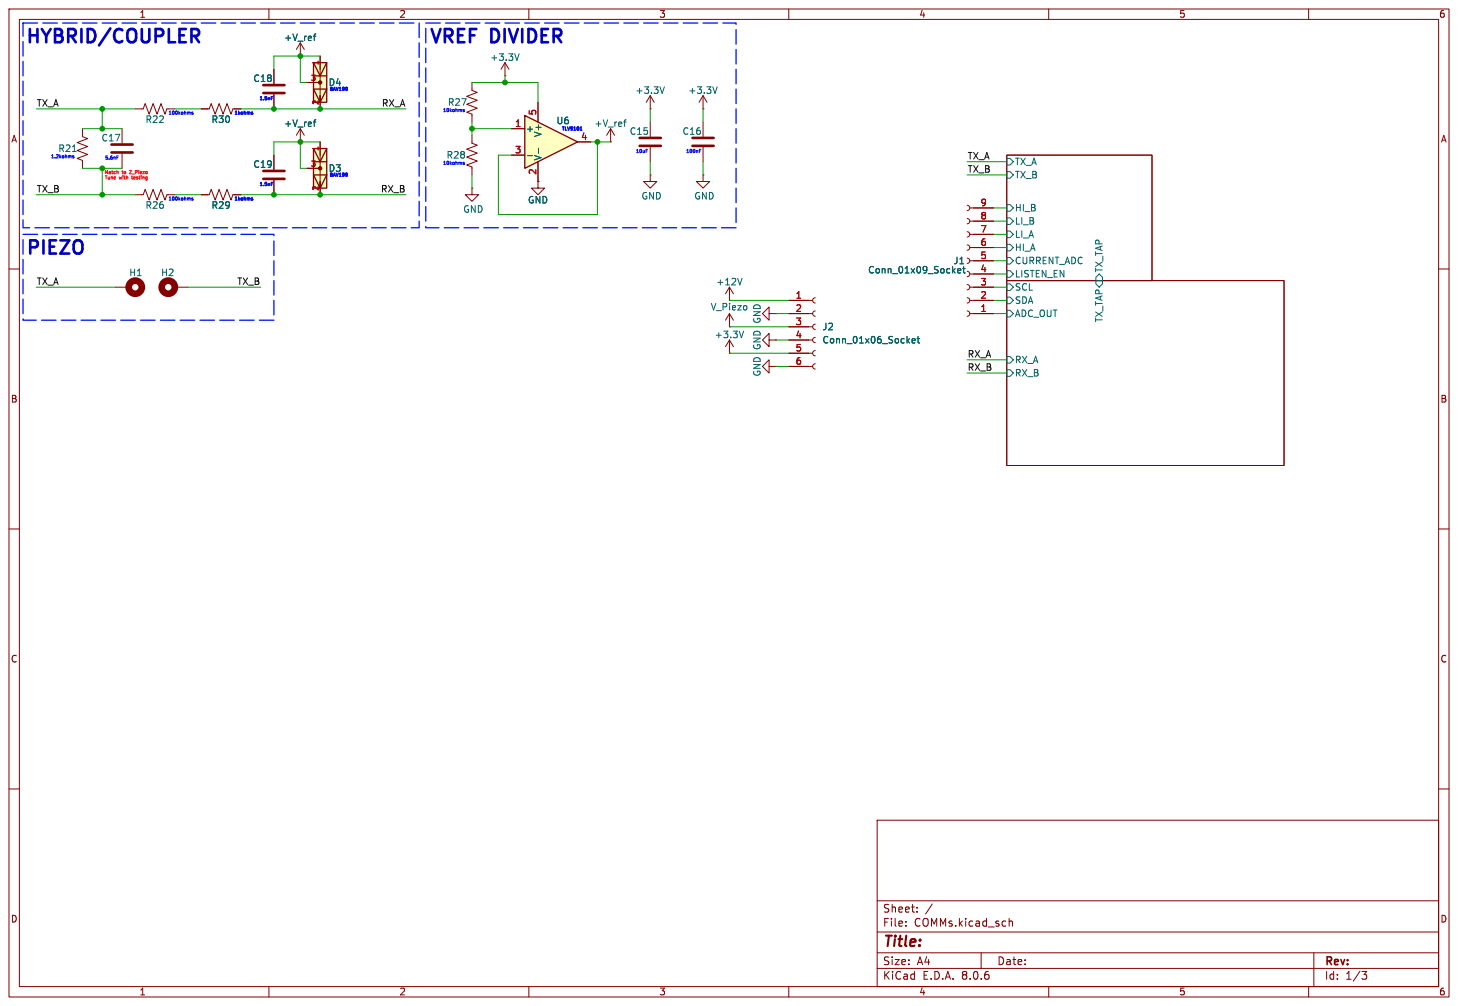
[picture p21: page 1]

Id: 1/3 Title: File: COMMs.kicad_sch Sheet: /

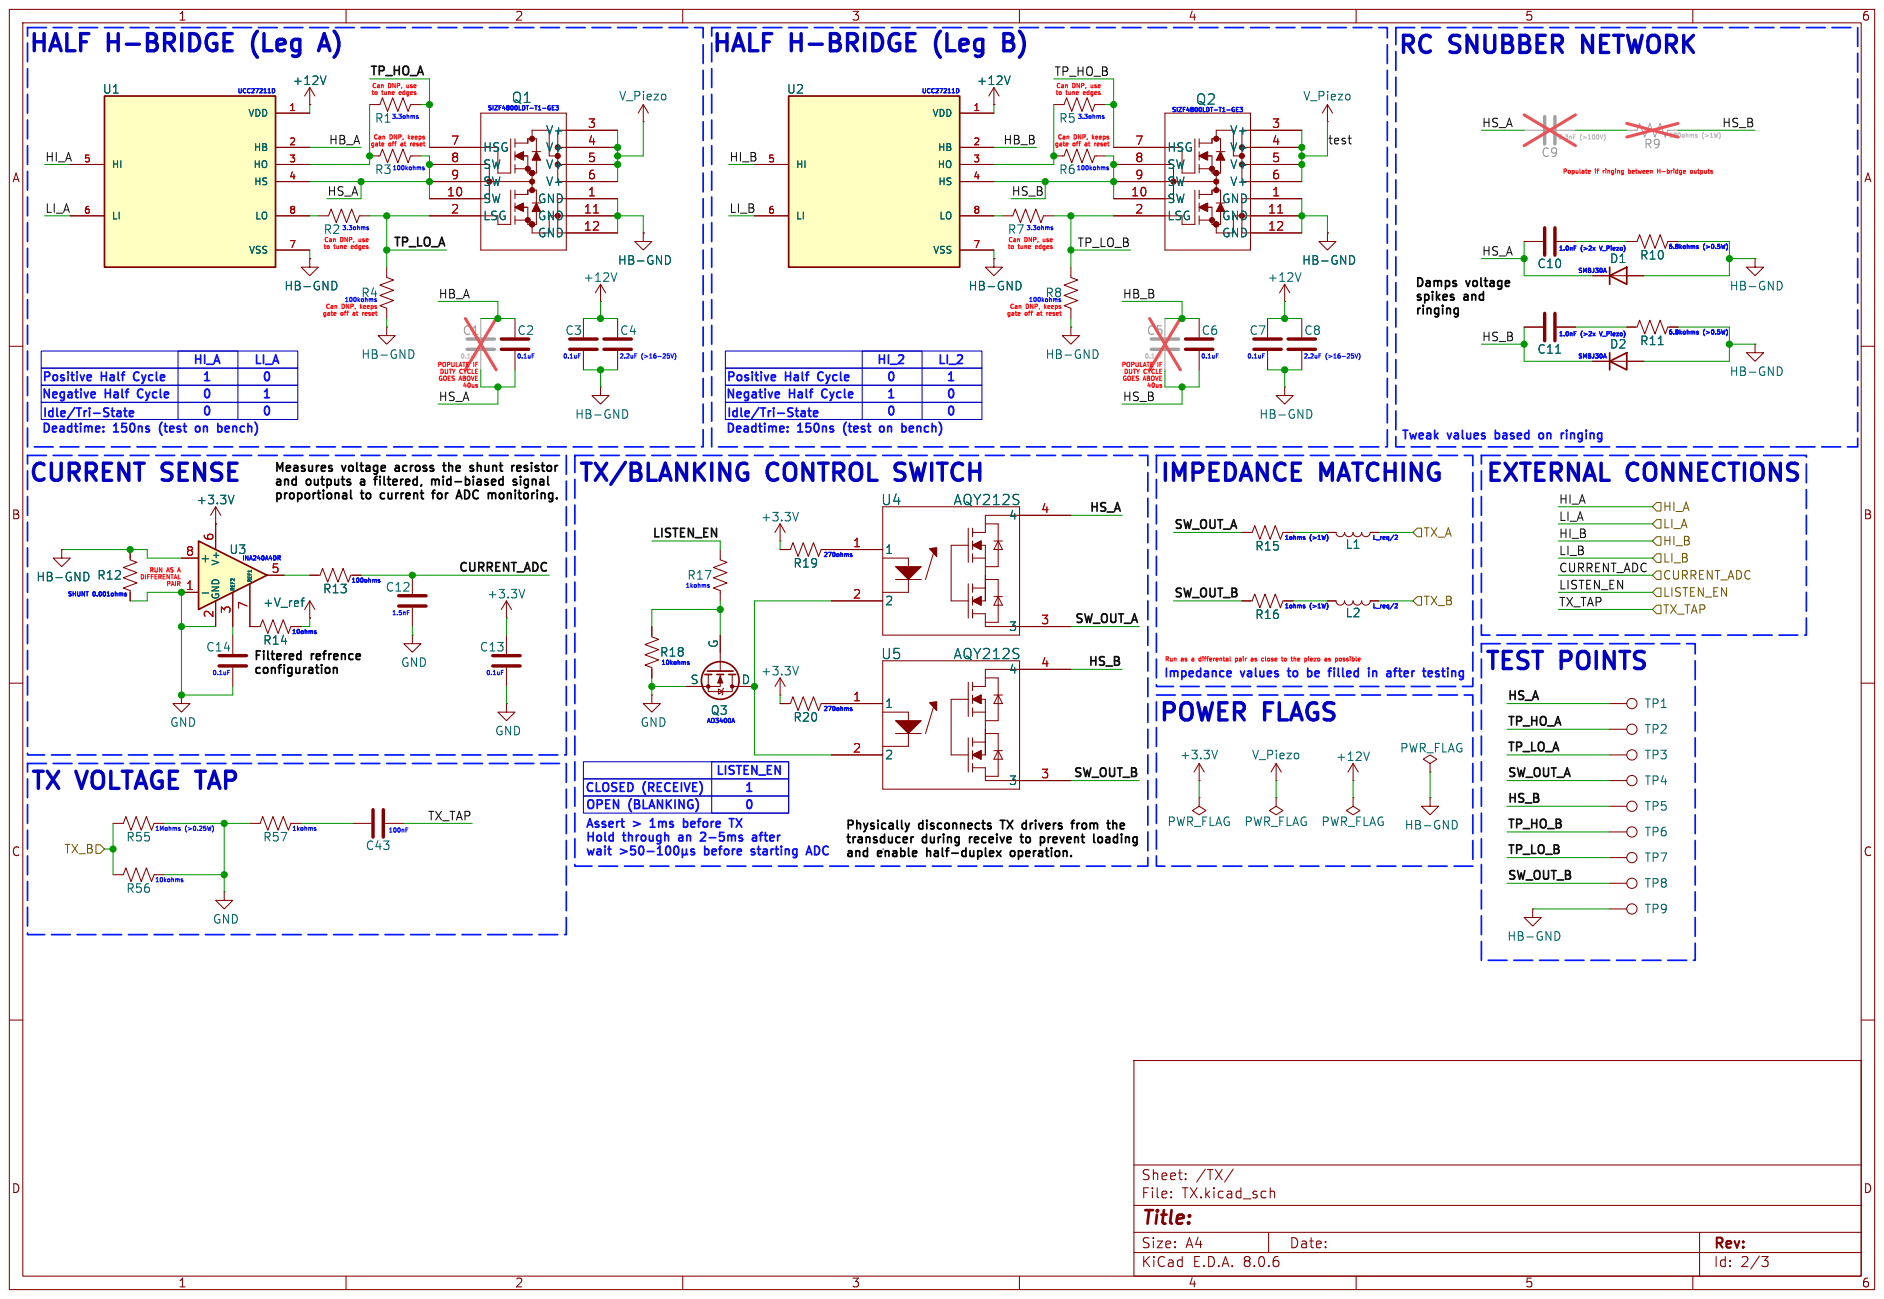
[picture p22: page 2]

to tune edges Positive Half Cycle

to tune edges Can DNP, use

Can DNP, keeps gate off at reset CURRENT SENSE

to tune edges Can DNP, keeps gate off at reset Negative Half Cycle

POPULATE IF DUTY CYCLE GOES ABOVE

Deadtime: 150ns (test on bench)

Tweak values based on ringing
EXTERNAL CONNECTIONS

TX/BLANKING CONTROL SWITCH

RUN AS A DIFFERENTAL PAIR TX VOLTAGE TAP

Id: 2/3 Title: File: TX.kicad_sch Sheet: /TX/ C12

transducer during receive to prevent loading

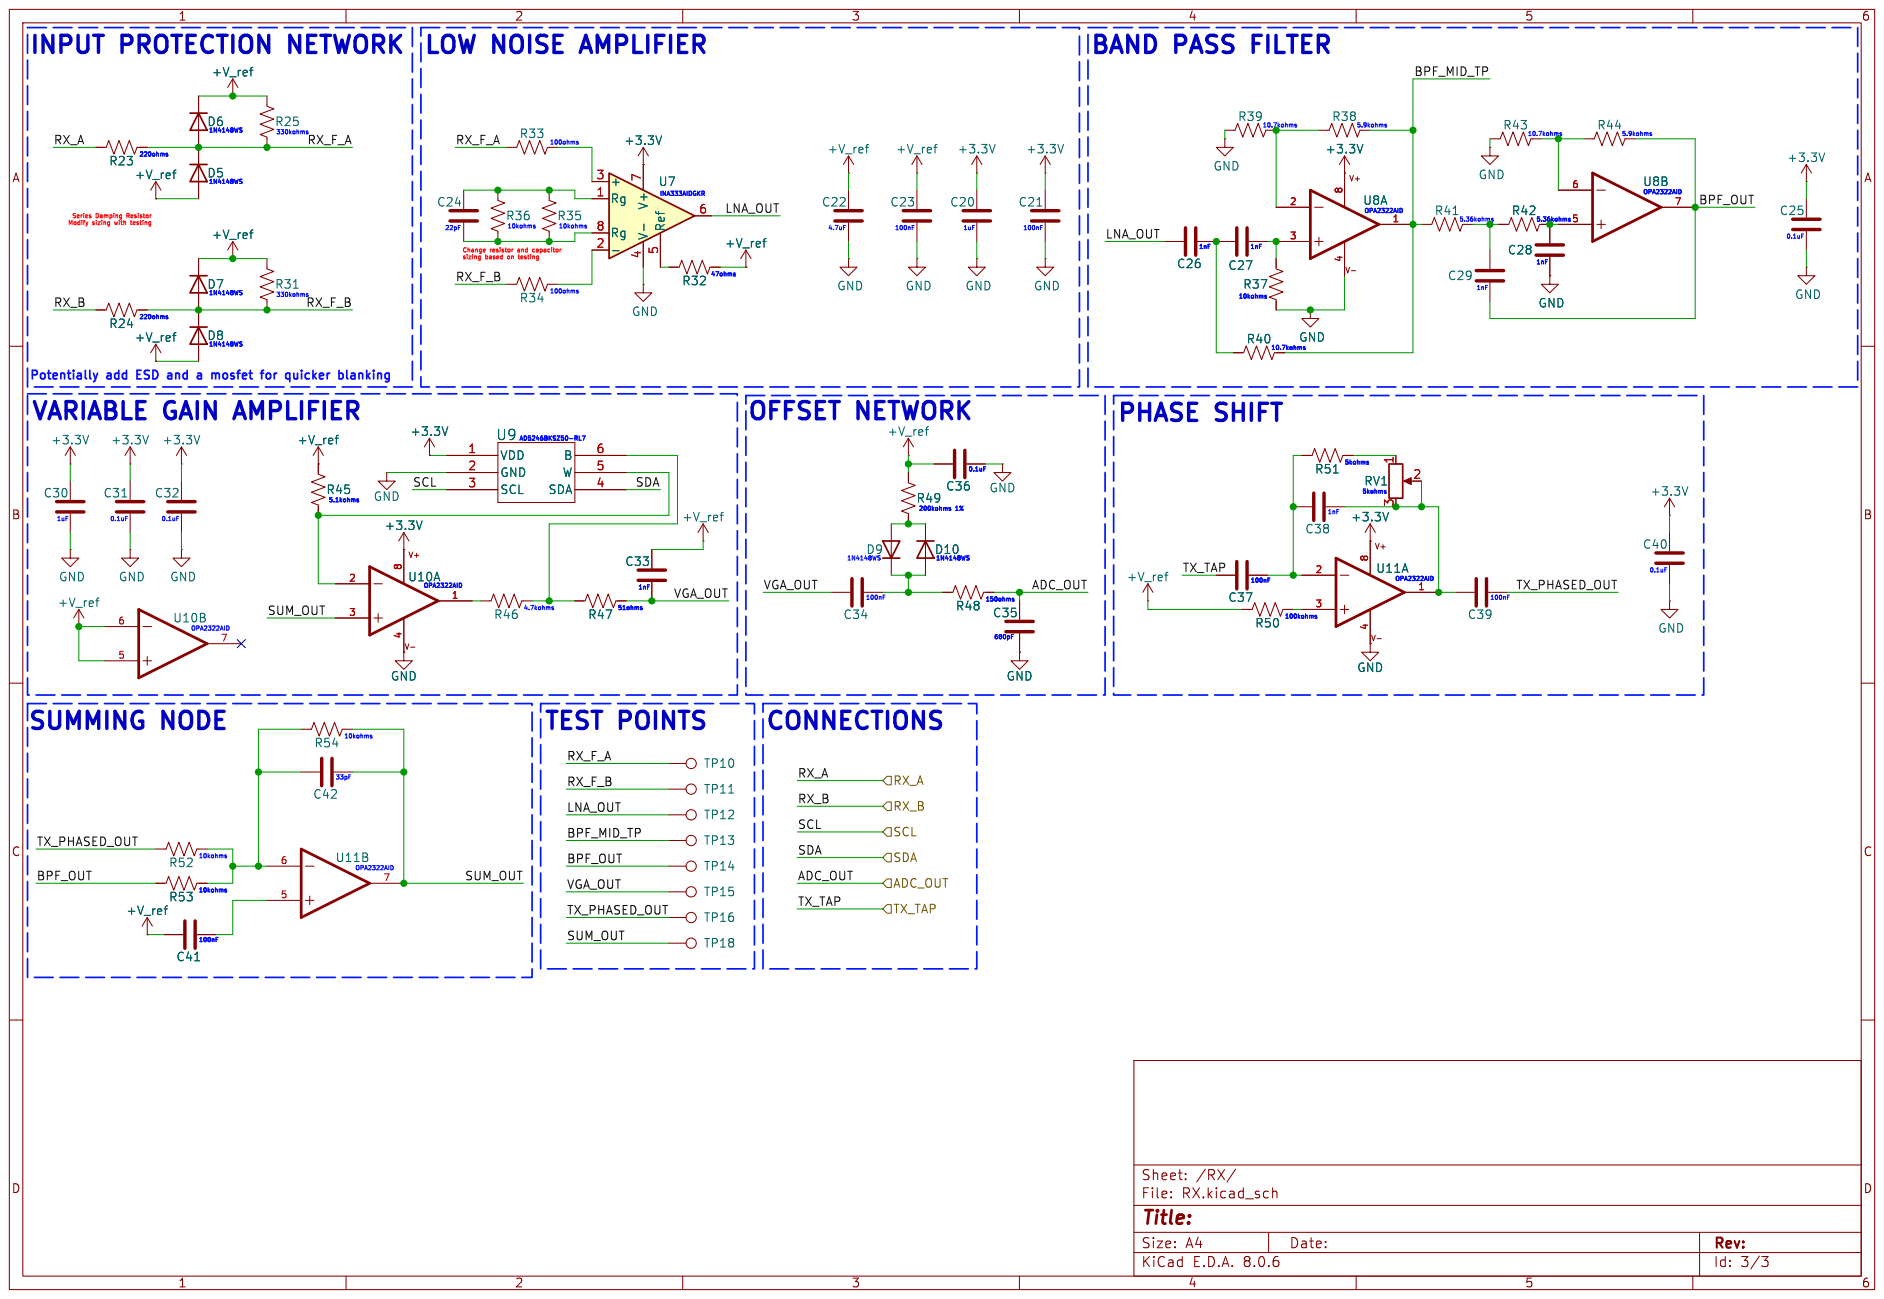
[picture p23: page 3]

Id: 3/3 Title: File: RX.kicad_sch Sheet: /RX/
