Astrelis-Nav/SWARM_COMMs/PCB Design/COMMs_Rev_1/Schematic/COMMs.pdf

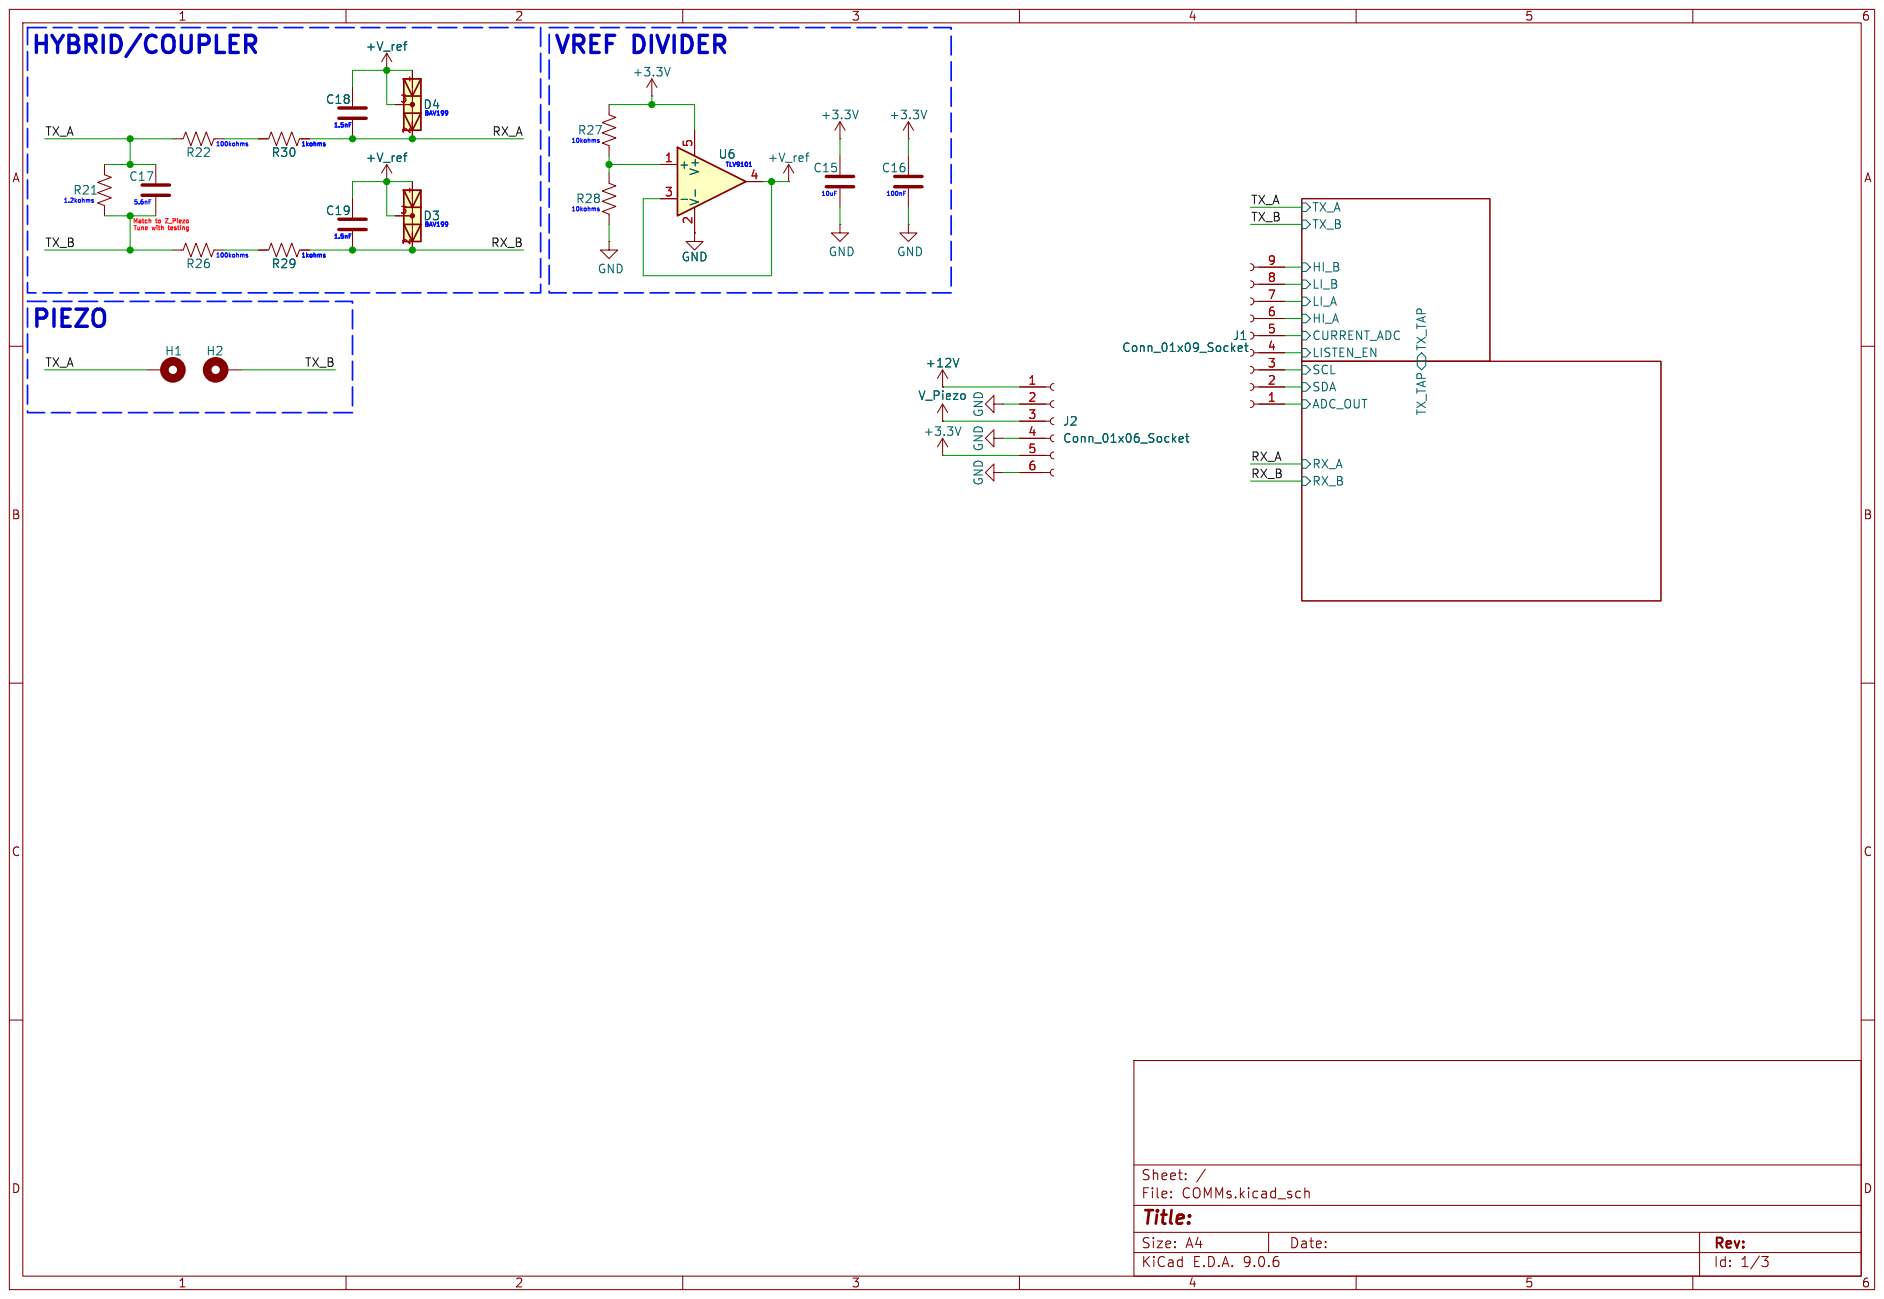
[picture p24: page 1]

Id: 1/3 Title: File: COMMs.kicad_sch Sheet: /

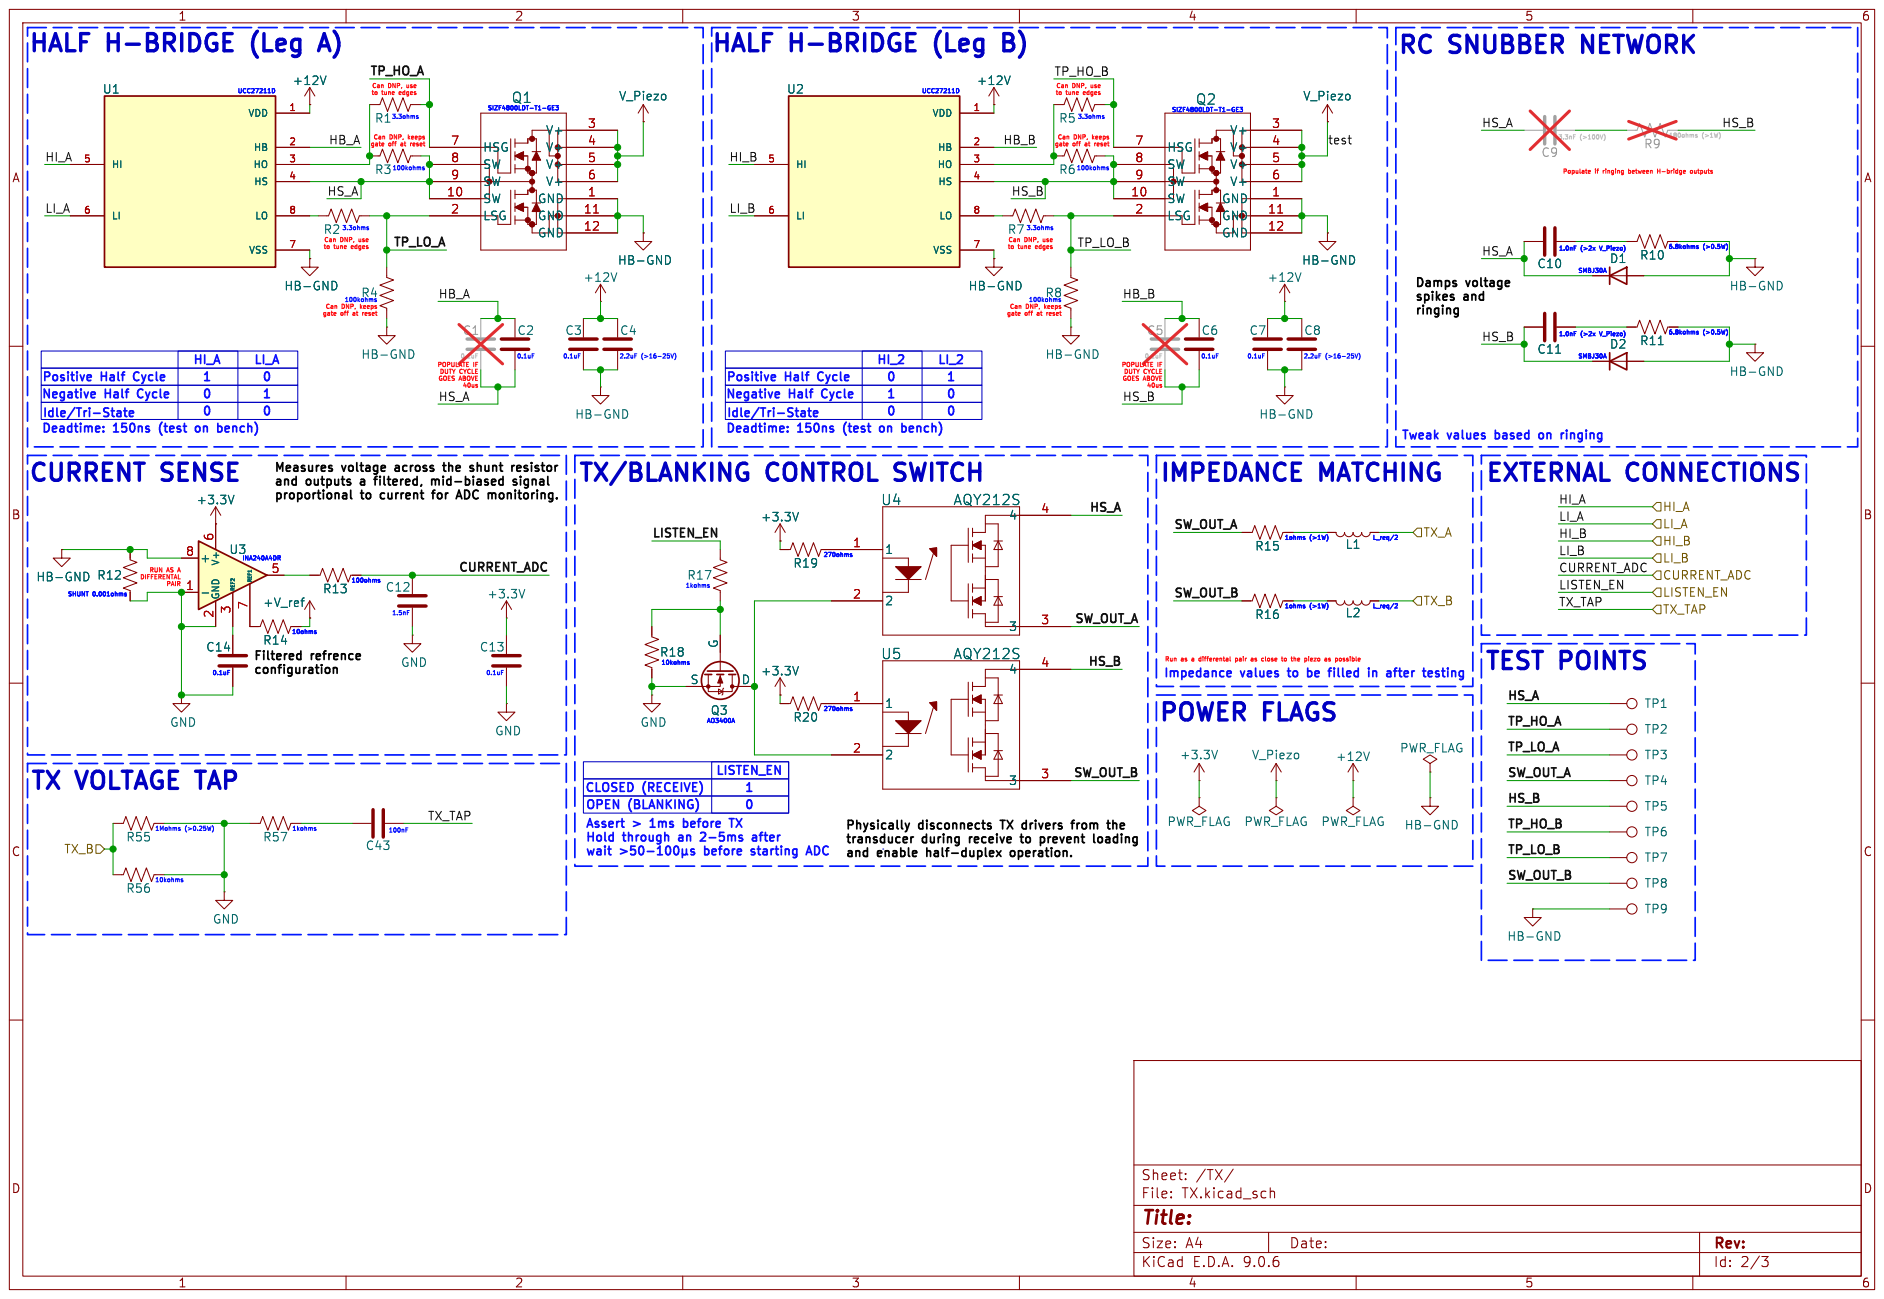
[picture p25: page 2]

40us Can DNP, keeps gate off at reset Can DNP, use

V_Piezo GND
to tune edges TX/BLANKING CONTROL SWITCH

Can DNP, keeps gate off at reset Deadtime: 150ns (test on bench)

to tune edges CURRENT SENSE

Can DNP, keeps gate off at reset Can DNP, use

SMBJ30A R12
Deadtime: 150ns (test on bench)

POPULATE IF DUTY CYCLE GOES ABOVE

Tweak values based on ringing

RUN AS A DIFFERENTAL PAIR TX VOLTAGE TAP
HB-GND

Impedance values to be filled in after testing

Physically disconnects TX drivers from the
transducer during receive to prevent loading

Id: 2/3 Title: File: TX.kicad_sch Sheet: /TX/

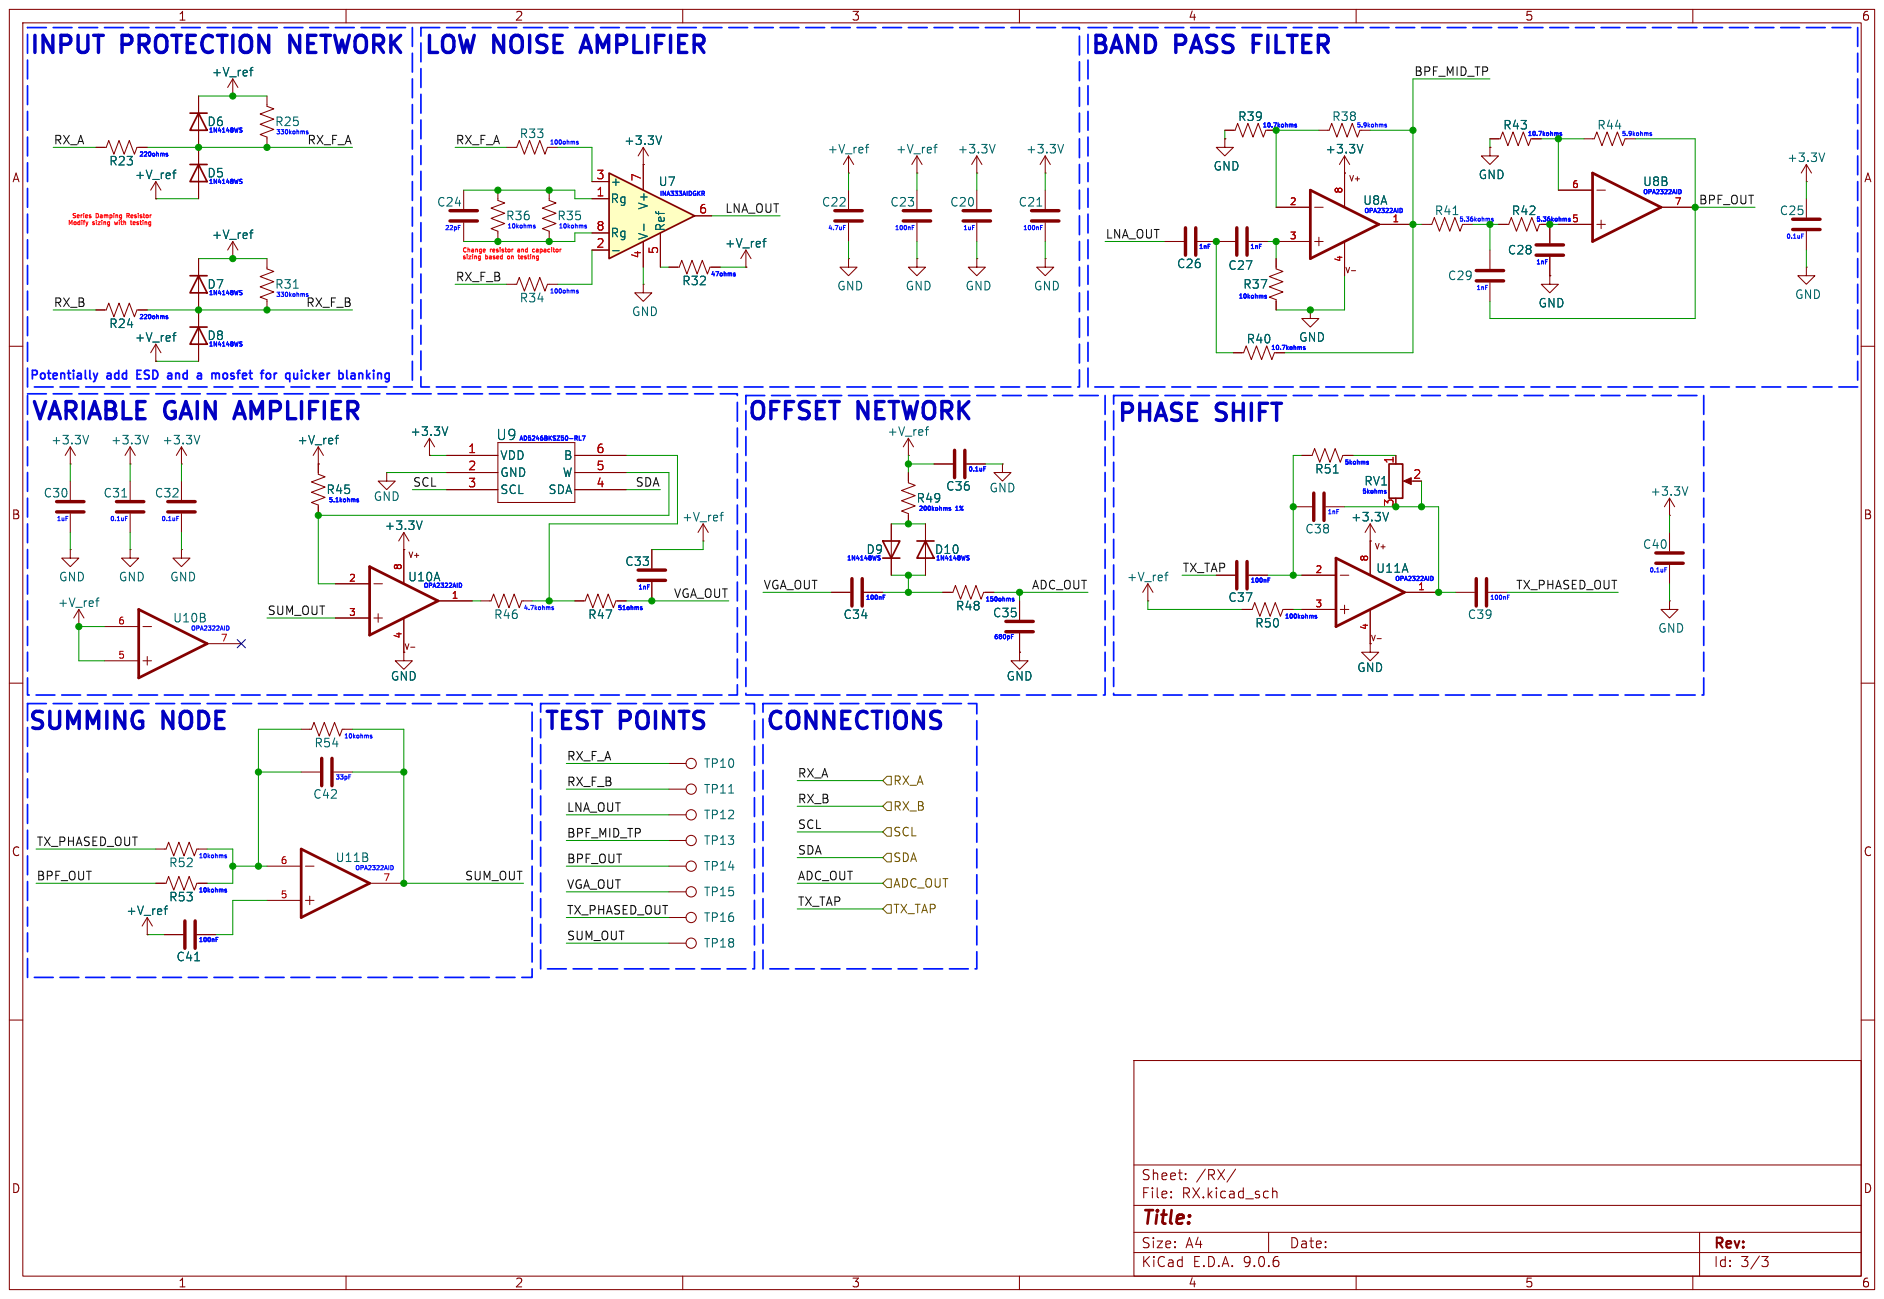
[picture p26: page 3]

Id: 3/3 Title: File: RX.kicad_sch Sheet: /RX/
