Astrelis-Nav/SWARM_COMMs/SWARM_PCB_Rev_2/SWARM_PCB_Rev_2.kicad_pcb

## KiCad design SWARM_PCB_Rev_2/SWARM_PCB_Rev_2.kicad_pcb (2026-07-07)

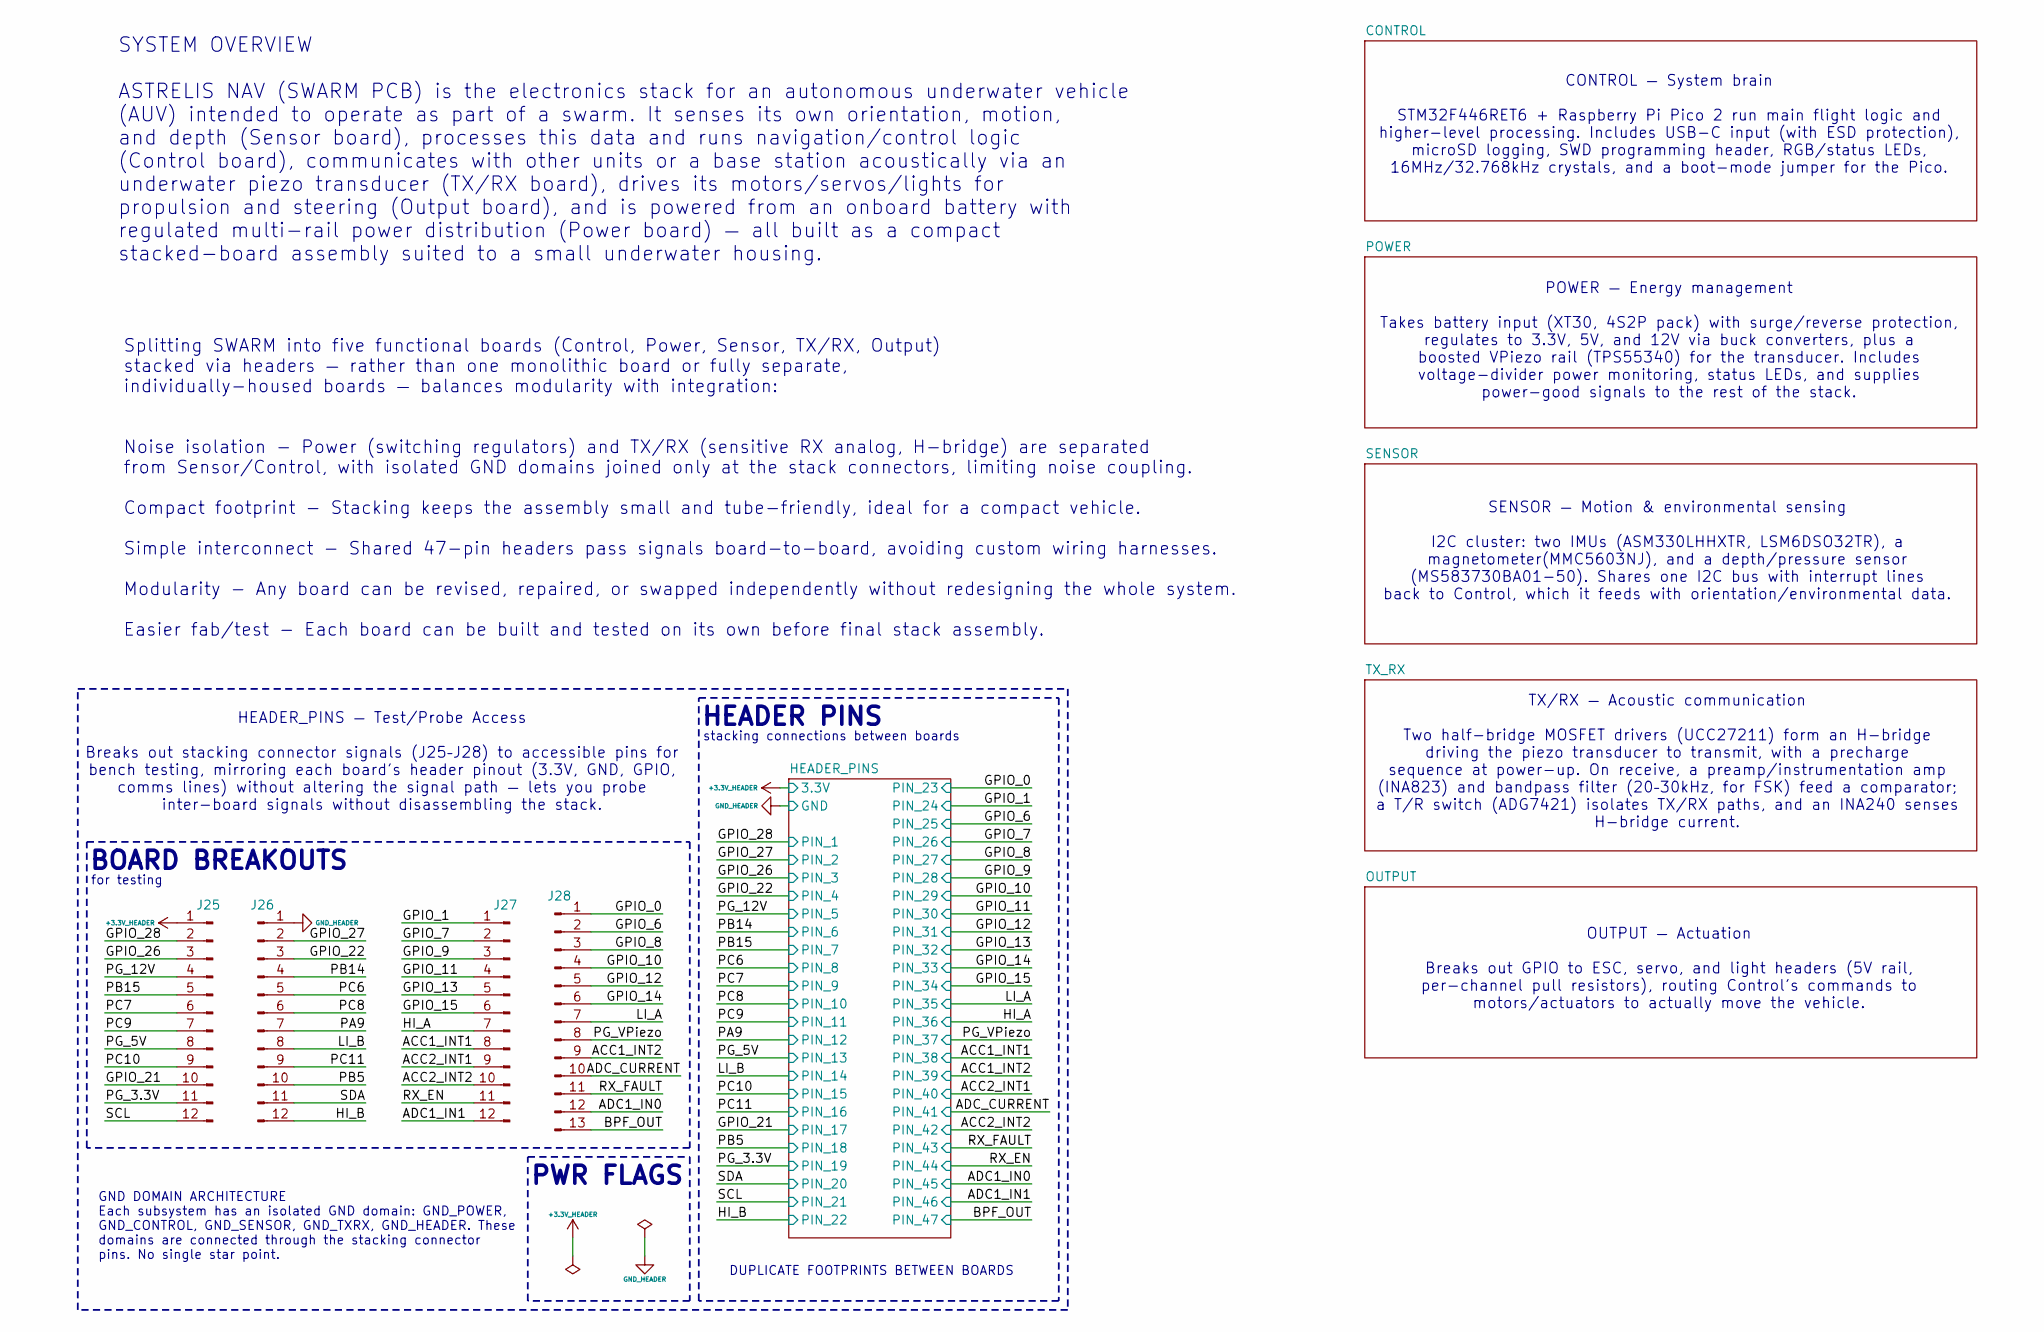
[picture p27: schematic SWARM_PCB_Rev_2.kicad_sch, SWARM PCB]

Parts:
J25, J26, J27: Conn_01x12_Pin; PinSocket_1x12_P2.54mm_Vertical
J28: Conn_01x13_Pin; PinSocket_1x13_P2.54mm_Vertical

Connections:
+3.3V_HEADER: J25.1; also elsewhere on the board
/ACC1_INT1: J27.8; also elsewhere on the board
/ACC1_INT2: J28.9; also elsewhere on the board
/ACC2_INT1: J27.9; also elsewhere on the board
/ACC2_INT2: J27.10; also elsewhere on the board
/ADC1_IN0: J28.12; also elsewhere on the board
/ADC1_IN1: J27.12; also elsewhere on the board
/ADC_CURRENT: J28.10; also elsewhere on the board
/BPF_OUT: J28.13; also elsewhere on the board
/GPIO_0: J28.1; also elsewhere on the board
/GPIO_1: J27.1; also elsewhere on the board
/GPIO_6: J28.2; also elsewhere on the board
/GPIO_7: J27.2; also elsewhere on the board
/GPIO_8: J28.3; also elsewhere on the board
/GPIO_9: J27.3; also elsewhere on the board
/GPIO_10: J28.4; also elsewhere on the board
/GPIO_11: J27.4; also elsewhere on the board
/GPIO_12: J28.5; also elsewhere on the board
/GPIO_13: J27.5; also elsewhere on the board
/GPIO_14: J28.6; also elsewhere on the board
/GPIO_15: J27.6; also elsewhere on the board
/GPIO_21: J25.10; also elsewhere on the board
/GPIO_22: J26.3; also elsewhere on the board
/GPIO_26: J25.3; also elsewhere on the board
/GPIO_27: J26.2; also elsewhere on the board
/GPIO_28: J25.2; also elsewhere on the board
/HI_A: J27.7; also elsewhere on the board
/HI_B: J26.12; also elsewhere on the board
/LI_A: J28.7; also elsewhere on the board
/LI_B: J26.8; also elsewhere on the board
/PA9: J26.7; also elsewhere on the board
/PB5: J26.10; also elsewhere on the board
/PB14: J26.4; also elsewhere on the board
/PB15: J25.5; also elsewhere on the board
/PC6: J26.5; also elsewhere on the board
/PC7: J25.6; also elsewhere on the board
/PC8: J26.6; also elsewhere on the board
/PC9: J25.7; also elsewhere on the board
/PC10: J25.9; also elsewhere on the board
/PC11: J26.9; also elsewhere on the board
/PG_3.3V: J25.11; also elsewhere on the board
/PG_5V: J25.8; also elsewhere on the board
/PG_12V: J25.4; also elsewhere on the board
/PG_VPiezo: J28.8; also elsewhere on the board
/RX_EN: J27.11; also elsewhere on the board
/RX_FAULT: J28.11; also elsewhere on the board
/SCL: J25.12; also elsewhere on the board
/SDA: J26.11; also elsewhere on the board
GND_HEADER: J26.1; also elsewhere on the board

Notes on the sheet:
SYSTEM OVERVIEW ASTRELIS NAV (SWARM PCB) is the electronics stack for an autonomous underwater vehicle (AUV) intended to operate as part of a swarm. It senses its own orientation, motion, and depth (Sensor board), processes this data and runs navigation/control logic (Control board), communicates w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
for testing
DUPLICATE FOOTPRINTS BETWEEN BOARDS
HEADER_PINS — Test/Probe Access Breaks out stacking connector signals (J25–J28) to accessible pins for bench testing, mirroring each board's header pinout (3.3V, GND, GPIO, comms lines) without altering the signal path — lets you probe inter-board signals without disassembling the stack.
SENSOR — Motion & environmental sensing I2C cluster: two IMUs (ASM330LHHXTR, LSM6DSO32TR), a magnetometer(MMC5603NJ), and a depth/pressure sensor (MS583730BA01-50). Shares one I2C bus with interrupt lines back to Control, which it feeds with orientation/environmental data.
Splitting SWARM into five functional boards (Control, Power, Sensor, TX/RX, Output) stacked via headers — rather than one monolithic board or fully separate, individually-housed boards — balances modularity with integration: Noise isolation - Power (switching regulators) and TX/RX (sensitive RX ana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
POWER — Energy management Takes battery input (XT30, 4S2P pack) with surge/reverse protection, regulates to 3.3V, 5V, and 12V via buck converters, plus a boosted VPiezo rail (TPS55340) for the transducer. Includes voltage-divider power monitoring, status LEDs, and supplies power-good signals to the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
stacking connections between boards
BOARD BREAKOUTS
GND DOMAIN ARCHITECTURE Each subsystem has an isolated GND domain: GND_POWER, GND_CONTROL, GND_SENSOR, GND_TXRX, GND_HEADER. These domains are connected through the stacking connector pins. No single star point.
OUTPUT — Actuation Breaks out GPIO to ESC, servo, and light headers (5V rail, per-channel pull resistors), routing Control's commands to motors/actuators to actually move the vehicle.
CONTROL — System brain STM32F446RET6 + Raspberry Pi Pico 2 run main flight logic and higher-level processing. Includes USB-C input (with ESD protection), microSD logging, SWD programming header, RGB/status LEDs, 16MHz/32.768kHz crystals, and a boot-mode jumper for the Pico.
TX/RX — Acoustic communication Two half-bridge MOSFET drivers (UCC27211) form an H-bridge driving the piezo transducer to transmit, with a precharge sequence at power-up. On receive, a preamp/instrumentation amp (INA823) and bandpass filter (20–30kHz, for FSK) feed a comparator; a T/R switch (ADG74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
HEADER PINS
PWR FLAGS

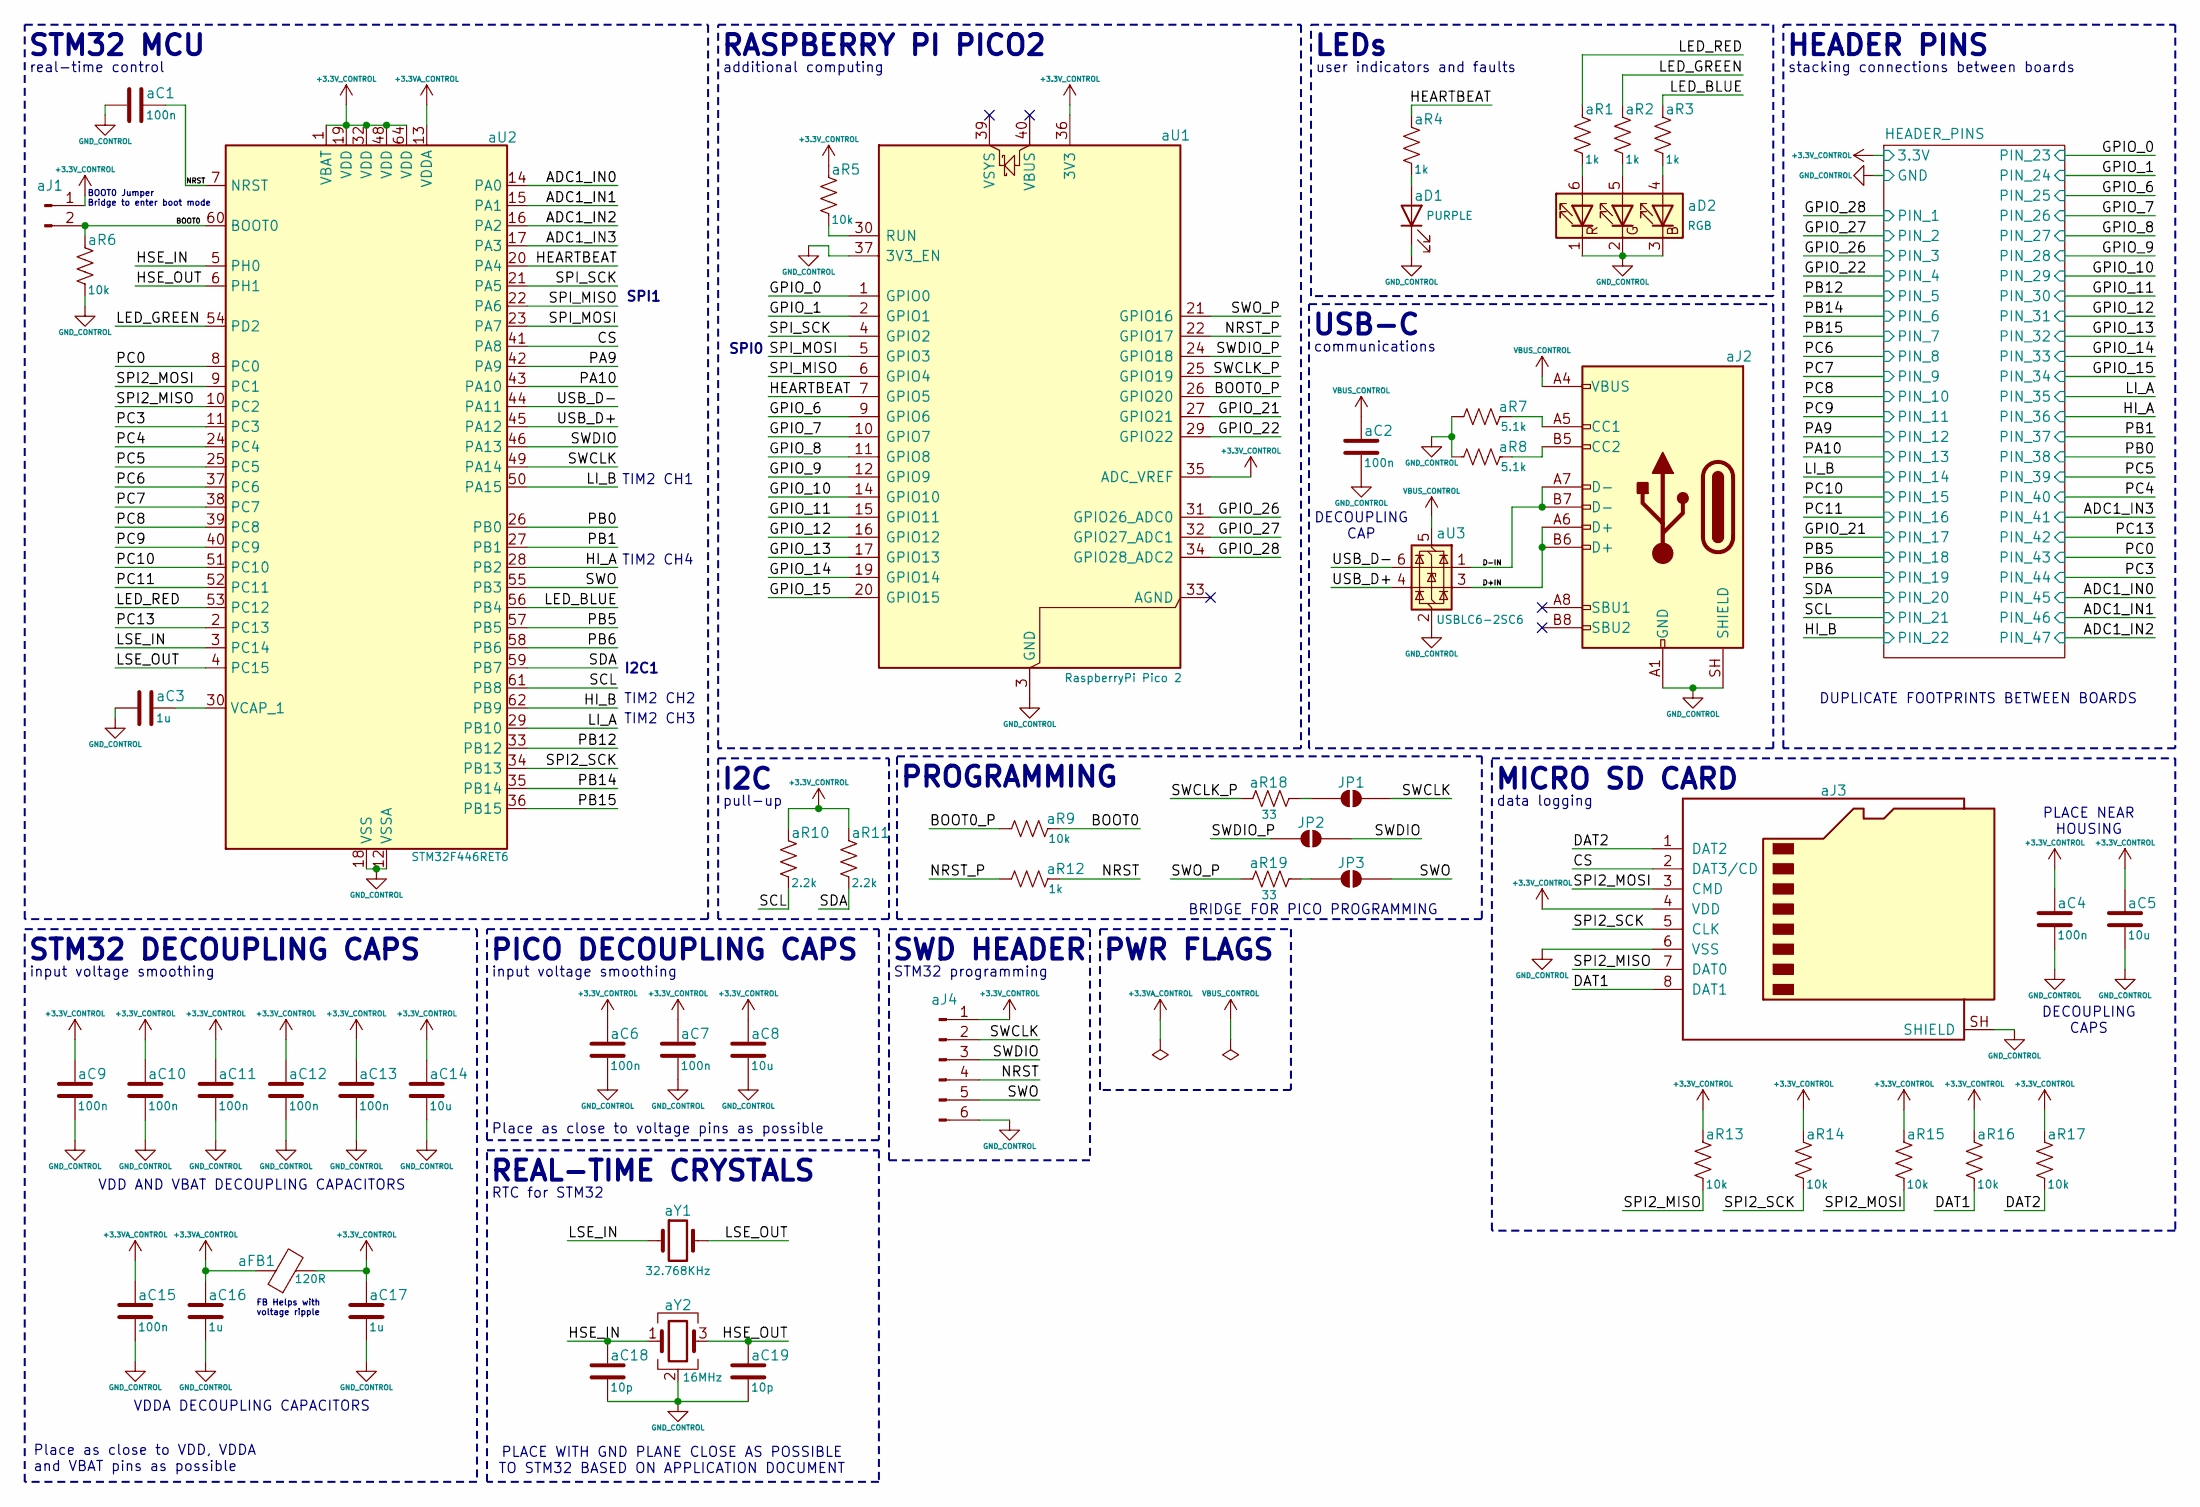
[picture p28: schematic CONTROL.kicad_sch, CONTROL BOARD]

Parts:
JP1, JP2, JP3: SolderJumper_2_Open; SolderJumper-2_P1.3mm_Open_TrianglePad1.0x1.5mm
aC1, aC2, aC4, aC6, aC7, aC9, aC10, aC11, aC12, aC13, aC15: 100n; C_0603_1608Metric; MPN GRM188R71C104KA01D
aC3: 1u; C_0603_1608Metric; MPN GRM188R60J105KE15D
aC5, aC8, aC14: 10u; C_0603_1608Metric; MPN GRM188R60J106ME47D
aC16, aC17: 1u; C_0603_1608Metric; MPN GRM188R61A105KA61D
aC18, aC19: 10p; C_0603_1608Metric; MPN GRM1885C1H100JA01D
aD1: PURPLE; LED_JE2835_CRW
aD2: RGB; LED_RGB_PLCC-6
aFB1: 120R; R_0603_1608Metric; MPN BLM18BD121SN1D
aJ1: Conn_01x02_Pin; PinHeader_1x02_P1.00mm_Vertical
aJ2: USB_C_Receptacle_USB2.0_16P; USB_C_Receptacle_GCT_USB4085; MPN USB4085-GF-A
aJ3: Micro_SD_Card; AMPHENOL_1140084168; MPN 1140084168
aJ4: Conn_01x06_Pin; PinHeader_1x06_P1.00mm_Vertical
aR1, aR2, aR3, aR4, aR12: 1k; R_0603_1608Metric; MPN RC0603FR-071KL
aR5, aR6, aR9, aR13, aR14, aR15, aR16, aR17: 10k; R_0603_1608Metric; MPN RC0603FR-0710KL
aR7, aR8: 5.1k; R_0603_1608Metric; MPN RC0603FR-075K1L
aR10, aR11: 2.2k; R_0603_1608Metric; MPN RC0603FR-074K7L
aR18, aR19: 33; R_0603_1608Metric; MPN RC0603FR-0733RL
aU1: RaspberryPi Pico 2; RaspberryPi_Pico_SMD; MPN SC0918
aU2: STM32F446RET6; LQFP-64_10x10mm_P0.5mm; MPN STM32F446RET6
aU3: USBLC6-2SC6; SOT-23-6; MPN USBLC6-2SC6
aY1: 32.768KHz; Crystal_SMD_MicroCrystal_CM9V-T1A-2Pin_1.6x1.0mm; MPN CM9V-T1A-32.768KDZB-UT
aY2: 16MHz; Crystal_SMD_SeikoEpson_FA238-4Pin_3.2x2.5mm; MPN FA-238 16.0000MB

Connections:
+3.3VA_CONTROL: aC15.2, aC16.2, aFB1.1, aU2.13 (VDDA)
+3.3V_CONTROL: aC4.2, aC5.2, aC6.2, aC7.2, aC8.2, aC9.2, aC10.2, aC11.2, aC12.2, aC13.2, aC14.2, aC17.2, aFB1.2, aJ1.1, aJ3.4 (VDD), aJ4.1, aR5.2, aR10.2, aR11.2, aR13.2, aR14.2, aR15.2, aR16.2, aR17.2, aU1.35 (ADC_VREF), aU1.36 (3V3), aU2.1 (VBAT), aU2.19 (VDD), aU2.32 (VDD), aU2.48 (VDD), aU2.64 (VDD); also elsewhere on the board
/CONTROL/ADC1_IN0: aU2.14 (PA0); also elsewhere on the board
/CONTROL/ADC1_IN1: aU2.15 (PA1); also elsewhere on the board
/CONTROL/ADC1_IN2: aU2.16 (PA2); also elsewhere on the board
/CONTROL/ADC1_IN3: aU2.17 (PA3); also elsewhere on the board
/CONTROL/BOOT0: aJ1.2, aR6.2, aR9.1, aU2.60 (BOOT0)
/CONTROL/BOOT0_P: aR9.2, aU1.26 (GPIO20)
/CONTROL/CS: aJ3.2 (DAT3/CD), aU2.41 (PA8)
/CONTROL/D+IN: aJ2.A6 (D+), aJ2.B6 (D+), aU3.3 (I/O2)
/CONTROL/D-IN: aJ2.A7 (D-), aJ2.B7 (D-), aU3.1 (I/O1)
/CONTROL/DAT1: aJ3.8 (DAT1), aR16.1
/CONTROL/DAT2: aJ3.1 (DAT2), aR17.1
/CONTROL/GPIO_0: aU1.1 (GPIO0); also elsewhere on the board
/CONTROL/GPIO_1: aU1.2 (GPIO1); also elsewhere on the board
/CONTROL/GPIO_6: aU1.9 (GPIO6); also elsewhere on the board
/CONTROL/GPIO_7: aU1.10 (GPIO7); also elsewhere on the board
/CONTROL/GPIO_8: aU1.11 (GPIO8); also elsewhere on the board
/CONTROL/GPIO_9: aU1.12 (GPIO9); also elsewhere on the board
/CONTROL/GPIO_10: aU1.14 (GPIO10); also elsewhere on the board
/CONTROL/GPIO_11: aU1.15 (GPIO11); also elsewhere on the board
/CONTROL/GPIO_12: aU1.16 (GPIO12); also elsewhere on the board
/CONTROL/GPIO_13: aU1.17 (GPIO13); also elsewhere on the board
/CONTROL/GPIO_14: aU1.19 (GPIO14); also elsewhere on the board
/CONTROL/GPIO_15: aU1.20 (GPIO15); also elsewhere on the board
/CONTROL/GPIO_21: aU1.27 (GPIO21); also elsewhere on the board
/CONTROL/GPIO_22: aU1.29 (GPIO22); also elsewhere on the board
/CONTROL/GPIO_26: aU1.31 (GPIO26_ADC0); also elsewhere on the board
/CONTROL/GPIO_27: aU1.32 (GPIO27_ADC1); also elsewhere on the board
/CONTROL/GPIO_28: aU1.34 (GPIO28_ADC2); also elsewhere on the board
/CONTROL/HEARTBEAT: aR4.2, aU1.7 (GPIO5), aU2.20 (PA4)
/CONTROL/HI_A: aU2.28 (PB2); also elsewhere on the board
/CONTROL/HI_B: aU2.62 (PB9); also elsewhere on the board
/CONTROL/HSE_IN: aC18.2, aU2.5 (PH0), aY2.1
/CONTROL/HSE_OUT: aC19.2, aU2.6 (PH1), aY2.3
/CONTROL/LED_BLUE: aR3.2, aU2.56 (PB4)
/CONTROL/LED_GREEN: aR2.2, aU2.54 (PD2)
/CONTROL/LED_RED: aR1.2, aU2.53 (PC12)
/CONTROL/LI_A: aU2.29 (PB10); also elsewhere on the board
/CONTROL/LI_B: aU2.50 (PA15); also elsewhere on the board
/CONTROL/LSE_IN: aU2.3 (PC14), aY1.1
/CONTROL/LSE_OUT: aU2.4 (PC15), aY1.2
/CONTROL/NRST: aC1.2, aJ4.4, aR12.1, aU2.7 (NRST)
/CONTROL/NRST_P: aR12.2, aU1.22 (GPIO17)
/CONTROL/PA9: aU2.42 (PA9); also elsewhere on the board
/CONTROL/PA10: aU2.43 (PA10); also elsewhere on the board
/CONTROL/PB0: aU2.26 (PB0); also elsewhere on the board
/CONTROL/PB1: aU2.27 (PB1); also elsewhere on the board
/CONTROL/PB5: aU2.57 (PB5); also elsewhere on the board
/CONTROL/PB6: aU2.58 (PB6); also elsewhere on the board
/CONTROL/PB12: aU2.33 (PB12); also elsewhere on the board
/CONTROL/PB14: aU2.35 (PB14); also elsewhere on the board
/CONTROL/PB15: aU2.36 (PB15); also elsewhere on the board
/CONTROL/PC0: aU2.8 (PC0); also elsewhere on the board
/CONTROL/PC3: aU2.11 (PC3); also elsewhere on the board
/CONTROL/PC4: aU2.24 (PC4); also elsewhere on the board
/CONTROL/PC5: aU2.25 (PC5); also elsewhere on the board
/CONTROL/PC6: aU2.37 (PC6); also elsewhere on the board
/CONTROL/PC7: aU2.38 (PC7); also elsewhere on the board
/CONTROL/PC8: aU2.39 (PC8); also elsewhere on the board
/CONTROL/PC9: aU2.40 (PC9); also elsewhere on the board
/CONTROL/PC10: aU2.51 (PC10); also elsewhere on the board
/CONTROL/PC11: aU2.52 (PC11); also elsewhere on the board
/CONTROL/PC13: aU2.2 (PC13); also elsewhere on the board
/CONTROL/SCL: aR10.1, aU2.61 (PB8); also elsewhere on the board
/CONTROL/SDA: aR11.1, aU2.59 (PB7); also elsewhere on the board
/CONTROL/SPI2_MISO: aJ3.7 (DAT0), aR13.1, aU2.10 (PC2)
/CONTROL/SPI2_MOSI: aJ3.3 (CMD), aR15.1, aU2.9 (PC1)
/CONTROL/SPI2_SCK: aJ3.5 (CLK), aR14.1, aU2.34 (PB13)
/CONTROL/SPI_MISO: aU1.6 (GPIO4), aU2.22 (PA6)
/CONTROL/SPI_MOSI: aU1.5 (GPIO3), aU2.23 (PA7)
/CONTROL/SPI_SCK: aU1.4 (GPIO2), aU2.21 (PA5)
/CONTROL/SWCLK: JP1.2 (B), aJ4.2, aU2.49 (PA14)
/CONTROL/SWCLK_P: aR18.2, aU1.25 (GPIO19)
/CONTROL/SWDIO: JP2.2 (B), aJ4.3, aU2.46 (PA13)
/CONTROL/SWDIO_P: JP2.1 (A), aU1.24 (GPIO18)
/CONTROL/SWO: JP3.2 (B), aJ4.5, aU2.55 (PB3)
/CONTROL/SWO_P: aR19.2, aU1.21 (GPIO16)
/CONTROL/USB_D+: aU2.45 (PA12), aU3.4 (I/O2)
/CONTROL/USB_D-: aU2.44 (PA11), aU3.6 (I/O1)
GND_CONTROL: aC1.1, aC2.1, aC3.1, aC4.1, aC5.1, aC6.1, aC7.1, aC8.1, aC9.1, aC10.1, aC11.1, aC12.1, aC13.1, aC14.1, aC15.1, aC16.1, aC17.1, aC18.1, aC19.1, aD1.1 (K), aD2.1 (RK), aD2.2 (GK), aD2.3 (BK), aJ2.A1 (GND), aJ2.A12 (GND), aJ2.B1 (GND), aJ2.B12 (GND), aJ2.SH (SHIELD), aJ3.6 (VSS), aJ3.SH (SHIELD), aJ4.6, aR6.1, aR7.2, aR8.2, aU1.3 (GND), aU1.8 (GND), aU1.13 (GND), aU1.18 (GND), aU1.23 (GND), aU1.28 (GND), aU1.37 (3V3_EN), aU1.38 (GND), aU2.12 (VSSA), aU2.18 (VSS), aU2.31 (VSS), aU2.47 (VSS), aU2.63 (VSS), aU3.2 (GND), aY2.2 (G), aY2.4 (G); also elsewhere on the board
unnamed: JP1.1 (A), aR18.1
unnamed: JP3.1 (A), aR19.1
unnamed: aD1.2 (A), aR4.1
unnamed: aD2.4 (BA), aR3.1
unnamed: aD2.5 (GA), aR2.1
unnamed: aD2.6 (RA), aR1.1
unnamed: aJ2.A5 (CC1), aR7.1
unnamed: aJ2.B5 (CC2), aR8.1
unnamed: aR5.1, aU1.30 (RUN)
unnamed: aC3.2, aU2.30 (VCAP_1)
VBUS_CONTROL: aC2.2, aJ2.A4 (VBUS), aJ2.A9 (VBUS), aJ2.B4 (VBUS), aJ2.B9 (VBUS), aU3.5 (VBUS)

Notes on the sheet:
DECOUPLING CAP
VDDA DECOUPLING CAPACITORS
user indicators and faults
real-time control
DECOUPLING CAPS
Place as close to voltage pins as possible
data logging
FB Helps with voltage ripple
STM32 MCU
BOOT0 Jumper Bridge to enter boot mode
SPI1
BRIDGE FOR PICO PROGRAMMING
STM32 programming
communications
Place as close to VDD, VDDA and VBAT pins as possible
USB-C
I2C
STM32 DECOUPLING CAPS
TIM2 CH3
PLACE WITH GND PLANE CLOSE AS POSSIBLE TO STM32 BASED ON APPLICATION DOCUMENT
PLACE NEAR HOUSING
SWD HEADER
additional computing
PWR FLAGS
input voltage smoothing
RTC for STM32
LEDs
TIM2 CH4
VDD AND VBAT DECOUPLING CAPACITORS
SPI0
HEADER PINS
I2C1
MICRO SD CARD
TIM2 CH2
PROGRAMMING
pull-up
RASPBERRY PI PICO2
stacking connections between boards
PICO DECOUPLING CAPS
TIM2 CH1
DUPLICATE FOOTPRINTS BETWEEN BOARDS
REAL-TIME CRYSTALS

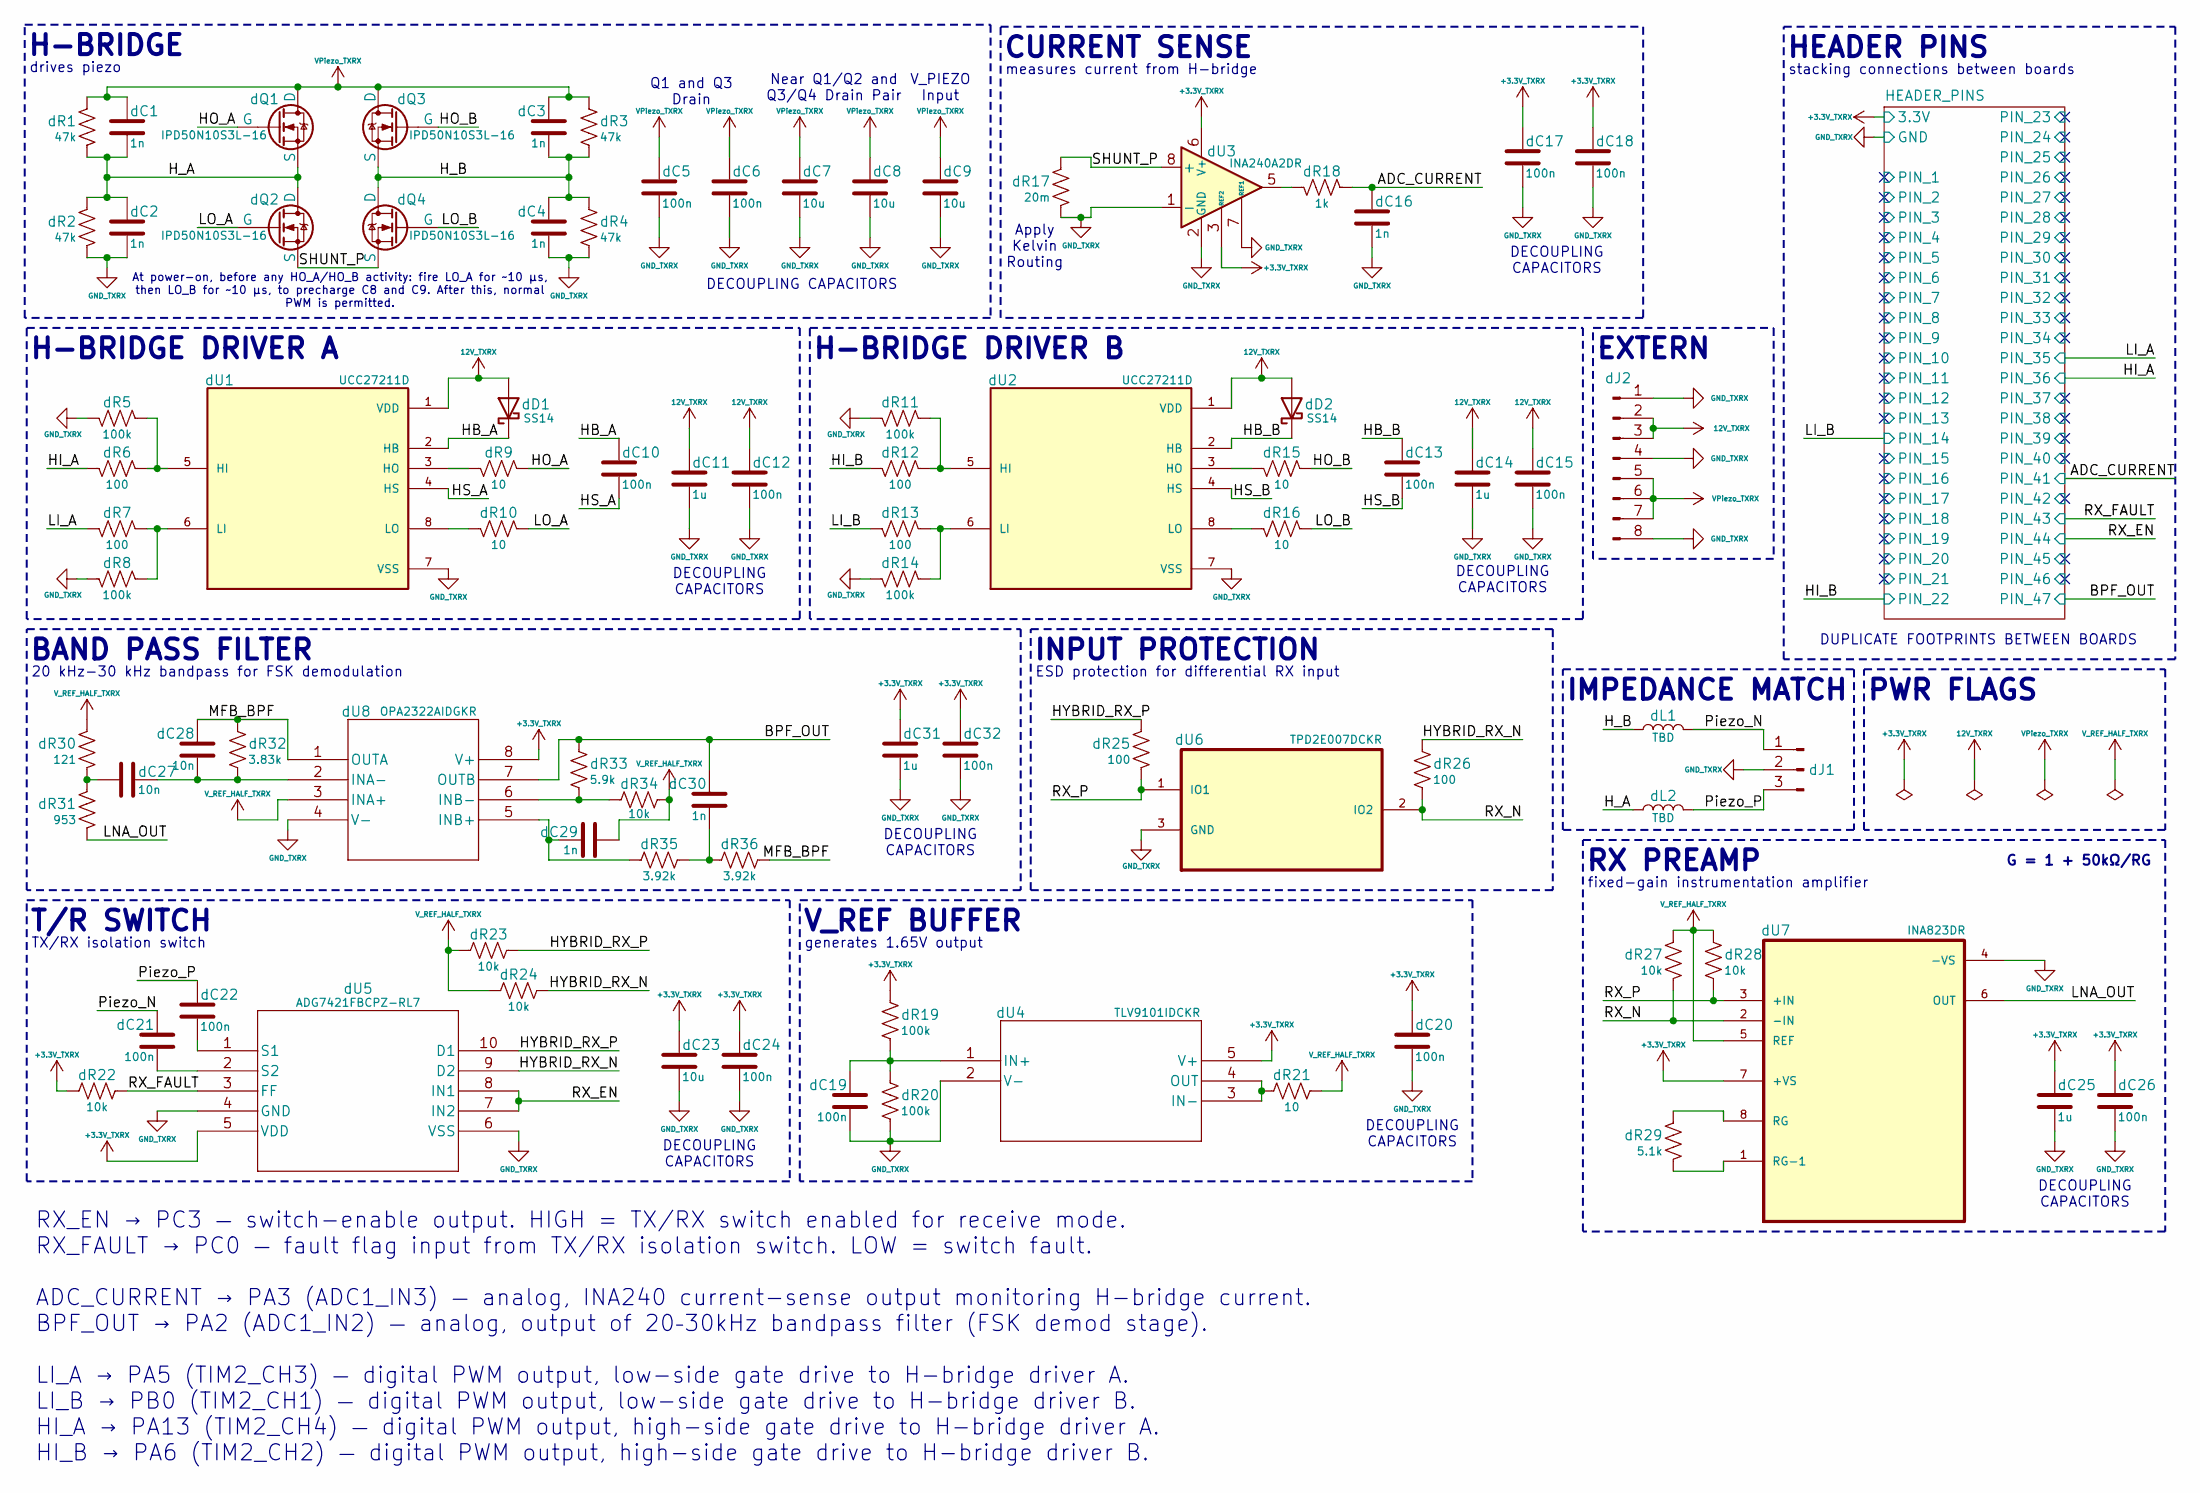
[picture p29: schematic TX_RX.kicad_sch, TX & RX]

Parts:
dC1, dC2, dC3, dC4, dC16, dC29, dC30: 1n; C_0603_1608Metric; MPN GRM1885C1H102JA01D
dC5, dC6, dC10, dC12, dC13, dC15, dC17, dC18, dC19, dC20, dC21, dC22, dC24, dC26, dC32: 100n; C_0603_1608Metric; MPN GRM188R71C104KA01D
dC7, dC8, dC9: 10u; C_1210_3225Metric; MPN GRM32ER71H106KA12
dC11, dC14: 1u; C_0805_2012Metric; MPN GRM21BR61A105KA73L
dC23: 10u; C_0805_2012Metric_Pad1.18x1.45mm_HandSolder; MPN GRM21BR61A106KE18L
dC25, dC31: 1u; C_0603_1608Metric; MPN GRM188R61A105KA61D
dC27, dC28: 10n; C_0603_1608Metric; MPN GRM188R71H103KA01D
dD1, dD2: SS14; D_SMA
dJ1: Conn_01x03_Pin; JST_XH_B3B-XH-AM_1x03_P2.50mm_Vertical; MPN B3B-XH-AM
dJ2: Conn_01x08_Pin; JST_PH_B8B-PH-SM4-TB_1x08-1MP_P2.00mm_Vertical; MPN B8B-PH-SM4-TB(LF)(SN)
dL1, dL2: TBD; L_Panasonic_PCC-M0630M
dQ1, dQ2, dQ3, dQ4: IPD50N10S3L-16; TO-252-2; MPN IPD50N10S3L-16
dR1, dR2, dR3, dR4: 47k; R_0603_1608Metric; MPN RC0603FR-0747KL
dR5, dR8, dR11, dR14, dR19, dR20: 100k; R_0603_1608Metric; MPN RC0603FR-07100KL
dR6, dR7, dR12, dR13, dR25, dR26: 100; R_0603_1608Metric; MPN RC0603FR-07100RL
dR9, dR10, dR15, dR16, dR21: 10; R_0603_1608Metric; MPN RC0603FR-0710RL
dR17: 20m; R_2512_6332Metric; MPN WSL2512R0200FEA
dR18: 1k; R_0603_1608Metric; MPN RC0603FR-071KL
dR22, dR23, dR24, dR27, dR28, dR34: 10k; R_0603_1608Metric; MPN RC0603FR-0710KL
dR29: 5.1k; R_0603_1608Metric; MPN RC0603FR-075K1L
dR30: 121; R_0603_1608Metric; MPN RC0603FR-07121RL
dR31: 953; R_0603_1608Metric; MPN RC0603FR-07953RL
dR32: 3.83k; R_0603_1608Metric; MPN RC0603FR-073K83L
dR33: 5.9k; R_0603_1608Metric; MPN RC0603FR-075K9L
dR35, dR36: 3.92k; R_0603_1608Metric; MPN RC0603FR-073K92L
dU1, dU2: UCC27211D; SOIC127P599X175-8N; PARTREV F; DigiKey_Part_Number 296-30016-5-ND
dU3: INA240A2DR; SOIC-8_3.9x4.9mm_P1.27mm; MPN INA240A2DR
dU4: TLV9101IDCKR; SC70-5_DCK_TEX; MPN TLV9101IDCKR
dU5: ADG7421FBCPZ-RL7; CP-10-16_ADI; MPN ADG7421FBCPZ-RL7
dU6: TPD2E007DCKR; DCK3; MPN TPD2E007DCKR
dU7: INA823DR; SOIC127P599X175-8N; MPN INA823DR
dU8: OPA2322AIDGKR; DGK8; MPN OPA2322AIDGKR

Connections:
12V_TXRX: dC11.2, dC12.2, dC14.2, dC15.2, dD1.2 (A), dD2.2 (A), dJ2.2, dJ2.3, dU1.1 (VDD), dU2.1 (VDD)
+3.3V_TXRX: dC17.2, dC18.2, dC20.2, dC23.2, dC24.2, dC25.2, dC26.2, dC31.2, dC32.2, dR19.2, dR22.2, dU3.3 (REF2), dU3.6 (V+), dU4.5 (V+), dU5.5 (VDD), dU7.7 (+VS), dU8.8 (V+); also elsewhere on the board
/TX_RX/ADC_CURRENT: dC16.2, dR18.1; also elsewhere on the board
/TX_RX/BPF_OUT: dC30.2, dR33.2, dU8.7 (OUTB); also elsewhere on the board
/TX_RX/HB_A: dC10.2, dD1.1 (K), dU1.2 (HB)
/TX_RX/HB_B: dC13.2, dD2.1 (K), dU2.2 (HB)
/TX_RX/HI_A: dR6.2; also elsewhere on the board
/TX_RX/HI_B: dR12.2; also elsewhere on the board
/TX_RX/HS_A: dC10.1, dU1.4 (HS)
/TX_RX/HS_B: dC13.1, dU2.4 (HS)
/TX_RX/HYBRID_RX_N: dR24.1, dR26.2, dU5.9 (D2)
/TX_RX/HYBRID_RX_P: dR23.1, dR25.2, dU5.10 (D1)
/TX_RX/LI_A: dR7.2; also elsewhere on the board
/TX_RX/LI_B: dR13.2; also elsewhere on the board
/TX_RX/LNA_OUT: dR31.1, dU7.6 (OUT)
/TX_RX/MFB_BPF: dC28.2, dR32.2, dR36.1, dU8.1 (OUTA)
/TX_RX/Piezo_N: dC21.2, dJ1.1, dL1.2
/TX_RX/Piezo_P: dC22.2, dJ1.3, dL2.2
/TX_RX/RX_EN: dU5.7 (IN2), dU5.8 (IN1); also elsewhere on the board
/TX_RX/RX_FAULT: dR22.1, dU5.3 (FF); also elsewhere on the board
/TX_RX/RX_N: dR26.1, dR27.1, dU6.2 (IO2), dU7.2 (-IN)
/TX_RX/RX_P: dR25.1, dR28.1, dU6.1 (IO1), dU7.3 (+IN)
/TX_RX/SHUNT_P: dQ2.3 (S), dQ4.3 (S), dR17.2, dU3.8 (+)
GND_TXRX: dC2.1, dC4.1, dC5.1, dC6.1, dC7.1, dC8.1, dC9.1, dC11.1, dC12.1, dC14.1, dC15.1, dC16.1, dC17.1, dC18.1, dC19.1, dC20.1, dC23.1, dC24.1, dC25.1, dC26.1, dC31.1, dC32.1, dJ1.2, dJ2.1, dJ2.4, dJ2.8, dR2.1, dR4.1, dR5.2, dR8.2, dR11.2, dR14.2, dR17.1, dR20.1, dU1.7 (VSS), dU2.7 (VSS), dU3.1 (-), dU3.2 (GND), dU3.4 (GND), dU3.7 (REF1), dU4.2 (V-), dU5.4 (GND), dU5.6 (VSS), dU6.3 (GND), dU7.4 (-VS), dU8.4 (V-); also elsewhere on the board
unnamed: dC27.2, dR30.1, dR31.2
unnamed: dC30.1, dR35.1, dR36.2
unnamed: dR18.2, dU3.5
unnamed: dR5.1, dR6.1, dU1.5 (HI)
unnamed: dR9.2, dU1.3 (HO)
unnamed: dR7.1, dR8.1, dU1.6 (LI)
unnamed: dR10.2, dU1.8 (LO)
unnamed: dR11.1, dR12.1, dU2.5 (HI)
unnamed: dR15.2, dU2.3 (HO)
unnamed: dR13.1, dR14.1, dU2.6 (LI)
unnamed: dR16.2, dU2.8 (LO)
unnamed: dC19.2, dR19.1, dR20.2, dU4.1 (IN+)
unnamed: dR21.2, dU4.3 (IN-), dU4.4 (OUT)
unnamed: dC22.1, dU5.1 (S1)
unnamed: dC21.1, dU5.2 (S2)
unnamed: dR29.2, dU7.8 (RG)
unnamed: dR29.1, dU7.1 (RG-1)
unnamed: dC27.1, dC28.1, dR32.1, dU8.2 (INA-)
unnamed: dC29.1, dR35.2, dU8.5 (INB+)
unnamed: dR33.1, dR34.2, dU8.6 (INB-)
V_REF_HALF_TXRX: dC29.2, dR21.1, dR23.2, dR24.2, dR27.2, dR28.2, dR30.2, dR34.1, dU7.5 (REF), dU8.3 (INA+)

Notes on the sheet:
DECOUPLING CAPACITORS
INPUT PROTECTION
H-BRIDGE DRIVER B
stacking connections between boards
20 kHz-30 kHz bandpass for FSK demodulation
drives piezo
V_PIEZO Input
Near Q1/Q2 and Q3/Q4 Drain Pair
CURRENT SENSE
G = 1 + 50kΩ/RG
EXTERN
Q1 and Q3 Drain
ESD protection for differential RX input
BAND PASS FILTER
T/R SWITCH
PWR FLAGS
IMPEDANCE MATCH
Apply Kelvin Routing
TX/RX isolation switch
DUPLICATE FOOTPRINTS BETWEEN BOARDS
H-BRIDGE DRIVER A
V_REF BUFFER
RX_EN → PC3 — switch-enable output. HIGH = TX/RX switch enabled for receive mode. RX_FAULT → PC0 — fault flag input from TX/RX isolation switch. LOW = switch fault. ADC_CURRENT → PA3 (ADC1_IN3) — analog, INA240 current-sense output monitoring H-bridge current. BPF_OUT → PA2 (ADC1_IN2) — analog, out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
H-BRIDGE
generates 1.65V output
HEADER PINS
RX PREAMP
measures current from H-bridge
fixed-gain instrumentation amplifier
DECOUPLING CAPACITORS
At power-on, before any HO_A/HO_B activity: fire LO_A for ~10 µs, then LO_B for ~10 µs, to precharge C8 and C9. After this, normal PWM is permitted.
