Astrelis-Nav/SWARM_COMMs/SWARM_PCB_Rev_2/SWARM_PCB_Rev_2.kicad_pcb

## KiCad design SWARM_PCB_Rev_2/SWARM_PCB_Rev_2.kicad_pcb (continued)

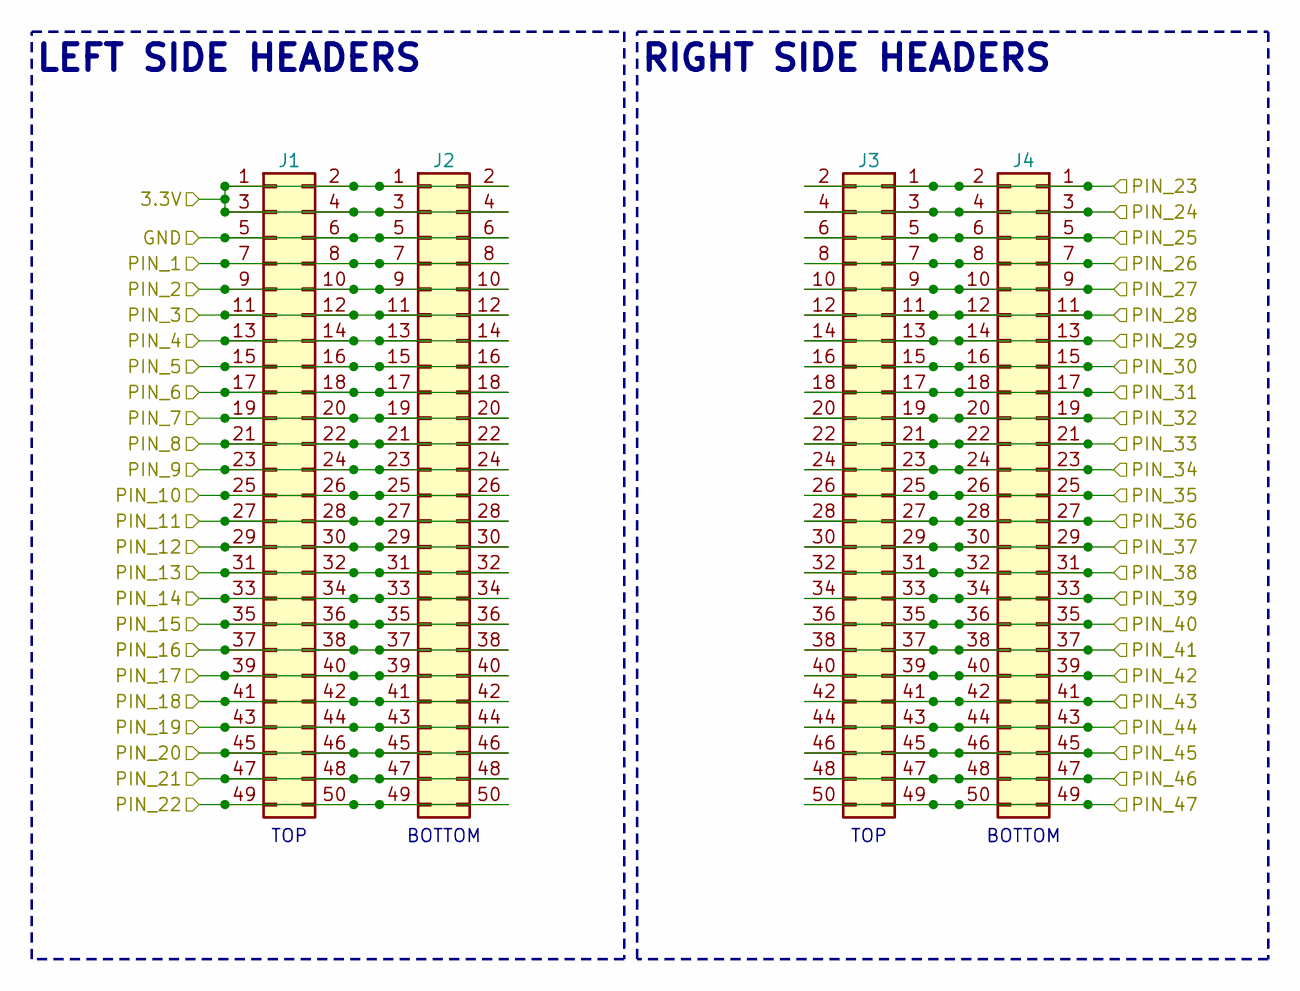
[picture p30: schematic HEADER_PINS.kicad_sch]

Parts:
J1: Conn_02x25_Odd_Even; HIROSE_DF40C-50DP-0.4V_51_
J2, J3, J4: Conn_02x25_Odd_Even; HIROSE_DF40C-50DP-0.4V_51_; MPN DF40C-50DP-0.4V(51)

Connections:
+3.3V_CONTROL: J1.1, J1.2, J1.3, J1.4, J2.1, J2.2, J2.3, J2.4; also elsewhere on the board
/CONTROL/ADC1_IN0: J3.45, J3.46, J4.45, J4.46; also elsewhere on the board
/CONTROL/ADC1_IN1: J3.47, J3.48, J4.47, J4.48; also elsewhere on the board
/CONTROL/ADC1_IN2: J3.49, J3.50, J4.49, J4.50; also elsewhere on the board
/CONTROL/ADC1_IN3: J3.37, J3.38, J4.37, J4.38; also elsewhere on the board
/CONTROL/GPIO_0: J3.1, J3.2, J4.1, J4.2; also elsewhere on the board
/CONTROL/GPIO_1: J3.3, J3.4, J4.3, J4.4; also elsewhere on the board
/CONTROL/GPIO_6: J3.5, J3.6, J4.5, J4.6; also elsewhere on the board
/CONTROL/GPIO_7: J3.7, J3.8, J4.7, J4.8; also elsewhere on the board
/CONTROL/GPIO_8: J3.9, J3.10, J4.9, J4.10; also elsewhere on the board
/CONTROL/GPIO_9: J3.11, J3.12, J4.11, J4.12; also elsewhere on the board
/CONTROL/GPIO_10: J3.13, J3.14, J4.13, J4.14; also elsewhere on the board
/CONTROL/GPIO_11: J3.15, J3.16, J4.15, J4.16; also elsewhere on the board
/CONTROL/GPIO_12: J3.17, J3.18, J4.17, J4.18; also elsewhere on the board
/CONTROL/GPIO_13: J3.19, J3.20, J4.19, J4.20; also elsewhere on the board
/CONTROL/GPIO_14: J3.21, J3.22, J4.21, J4.22; also elsewhere on the board
/CONTROL/GPIO_15: J3.23, J3.24, J4.23, J4.24; also elsewhere on the board
/CONTROL/GPIO_21: J1.39, J1.40, J2.39, J2.40; also elsewhere on the board
/CONTROL/GPIO_22: J1.13, J1.14, J2.13, J2.14; also elsewhere on the board
/CONTROL/GPIO_26: J1.11, J1.12, J2.11, J2.12; also elsewhere on the board
/CONTROL/GPIO_27: J1.9, J1.10, J2.9, J2.10; also elsewhere on the board
/CONTROL/GPIO_28: J1.7, J1.8, J2.7, J2.8; also elsewhere on the board
/CONTROL/HI_A: J3.27, J3.28, J4.27, J4.28; also elsewhere on the board
/CONTROL/HI_B: J1.49, J1.50, J2.49, J2.50; also elsewhere on the board
/CONTROL/LI_A: J3.25, J3.26, J4.25, J4.26; also elsewhere on the board
/CONTROL/LI_B: J1.33, J1.34, J2.33, J2.34; also elsewhere on the board
/CONTROL/PA9: J1.29, J1.30, J2.29, J2.30; also elsewhere on the board
/CONTROL/PA10: J1.31, J1.32, J2.31, J2.32; also elsewhere on the board
/CONTROL/PB0: J3.31, J3.32, J4.31, J4.32; also elsewhere on the board
/CONTROL/PB1: J3.29, J3.30, J4.29, J4.30; also elsewhere on the board
/CONTROL/PB5: J1.41, J1.42, J2.41, J2.42; also elsewhere on the board
/CONTROL/PB6: J1.43, J1.44, J2.43, J2.44; also elsewhere on the board
/CONTROL/PB12: J1.15, J1.16, J2.15, J2.16; also elsewhere on the board
/CONTROL/PB14: J1.17, J1.18, J2.17, J2.18; also elsewhere on the board
/CONTROL/PB15: J1.19, J1.20, J2.19, J2.20; also elsewhere on the board
/CONTROL/PC0: J3.41, J3.42, J4.41, J4.42; also elsewhere on the board
/CONTROL/PC3: J3.43, J3.44, J4.43, J4.44; also elsewhere on the board
/CONTROL/PC4: J3.35, J3.36, J4.35, J4.36; also elsewhere on the board
/CONTROL/PC5: J3.33, J3.34, J4.33, J4.34; also elsewhere on the board
/CONTROL/PC6: J1.21, J1.22, J2.21, J2.22; also elsewhere on the board
/CONTROL/PC7: J1.23, J1.24, J2.23, J2.24; also elsewhere on the board
/CONTROL/PC8: J1.25, J1.26, J2.25, J2.26; also elsewhere on the board
/CONTROL/PC9: J1.27, J1.28, J2.27, J2.28; also elsewhere on the board
/CONTROL/PC10: J1.35, J1.36, J2.35, J2.36; also elsewhere on the board
/CONTROL/PC11: J1.37, J1.38, J2.37, J2.38; also elsewhere on the board
/CONTROL/PC13: J3.39, J3.40, J4.39, J4.40; also elsewhere on the board
/CONTROL/SCL: J1.47, J1.48, J2.47, J2.48; also elsewhere on the board
/CONTROL/SDA: J1.45, J1.46, J2.45, J2.46; also elsewhere on the board
GND_CONTROL: J1.5, J1.6, J2.5, J2.6; also elsewhere on the board

Parts of its further copies:
J5, J9, J17, J21, J29: Conn_02x25_Odd_Even; HIROSE_DF40C-50DP-0.4V_51_
J6, J7, J8, J10, J11, J12, J18, J19, J20, J22, J23, J24, J30, J31, J32: Conn_02x25_Odd_Even; HIROSE_DF40C-50DP-0.4V_51_; MPN DF40C-50DP-0.4V(51)

Connections of its further copies:
+3.3V_HEADER: J21.1, J21.2, J21.3, J21.4, J22.1, J22.2, J22.3, J22.4; also elsewhere on the board
+3.3V_OUTPUT: J29.1, J29.2, J29.3, J29.4, J30.1, J30.2, J30.3, J30.4
+3.3V_POWER: J5.1, J5.2, J5.3, J5.4, J6.1, J6.2, J6.3, J6.4; also elsewhere on the board
+3.3V_SENSOR: J9.1, J9.2, J9.3, J9.4, J10.1, J10.2, J10.3, J10.4; also elsewhere on the board
+3.3V_TXRX: J17.1, J17.2, J17.3, J17.4, J18.1, J18.2, J18.3, J18.4; also elsewhere on the board
/ACC1_INT1: J23.31, J23.32, J24.31, J24.32; also elsewhere on the board
/ACC1_INT2: J23.33, J23.34, J24.33, J24.34; also elsewhere on the board
/ACC2_INT1: J23.35, J23.36, J24.35, J24.36; also elsewhere on the board
/ACC2_INT2: J23.39, J23.40, J24.39, J24.40; also elsewhere on the board
/ADC1_IN0: J23.45, J23.46, J24.45, J24.46; also elsewhere on the board
/ADC1_IN1: J23.47, J23.48, J24.47, J24.48; also elsewhere on the board
/ADC_CURRENT: J23.37, J23.38, J24.37, J24.38; also elsewhere on the board
/BPF_OUT: J23.49, J23.50, J24.49, J24.50; also elsewhere on the board
/GPIO_0: J23.1, J23.2, J24.1, J24.2; also elsewhere on the board
/GPIO_1: J23.3, J23.4, J24.3, J24.4; also elsewhere on the board
/GPIO_6: J23.5, J23.6, J24.5, J24.6; also elsewhere on the board
/GPIO_7: J23.7, J23.8, J24.7, J24.8; also elsewhere on the board
/GPIO_8: J23.9, J23.10, J24.9, J24.10; also elsewhere on the board
/GPIO_9: J23.11, J23.12, J24.11, J24.12; also elsewhere on the board
/GPIO_10: J23.13, J23.14, J24.13, J24.14; also elsewhere on the board
/GPIO_11: J23.15, J23.16, J24.15, J24.16; also elsewhere on the board
/GPIO_12: J23.17, J23.18, J24.17, J24.18; also elsewhere on the board
/GPIO_13: J23.19, J23.20, J24.19, J24.20; also elsewhere on the board
/GPIO_14: J23.21, J23.22, J24.21, J24.22; also elsewhere on the board
/GPIO_15: J23.23, J23.24, J24.23, J24.24; also elsewhere on the board
/GPIO_21: J21.39, J21.40, J22.39, J22.40; also elsewhere on the board
/GPIO_22: J21.13, J21.14, J22.13, J22.14; also elsewhere on the board
/GPIO_26: J21.11, J21.12, J22.11, J22.12; also elsewhere on the board
/GPIO_27: J21.9, J21.10, J22.9, J22.10; also elsewhere on the board
/GPIO_28: J21.7, J21.8, J22.7, J22.8; also elsewhere on the board
/HI_A: J23.27, J23.28, J24.27, J24.28; also elsewhere on the board
/HI_B: J21.49, J21.50, J22.49, J22.50; also elsewhere on the board
/LI_A: J23.25, J23.26, J24.25, J24.26; also elsewhere on the board
/LI_B: J21.33, J21.34, J22.33, J22.34; also elsewhere on the board
/OUTPUT/GPIO_0: J31.1, J31.2, J32.1, J32.2; also elsewhere on the board
/OUTPUT/GPIO_1: J31.3, J31.4, J32.3, J32.4; also elsewhere on the board
/OUTPUT/GPIO_6: J31.5, J31.6, J32.5, J32.6; also elsewhere on the board
/OUTPUT/GPIO_7: J31.7, J31.8, J32.7, J32.8; also elsewhere on the board
/OUTPUT/GPIO_8: J31.9, J31.10, J32.9, J32.10; also elsewhere on the board
/OUTPUT/GPIO_9: J31.11, J31.12, J32.11, J32.12; also elsewhere on the board
/OUTPUT/GPIO_13: J31.19, J31.20, J32.19, J32.20; also elsewhere on the board
/OUTPUT/GPIO_14: J31.21, J31.22, J32.21, J32.22; also elsewhere on the board
/OUTPUT/GPIO_15: J31.23, J31.24, J32.23, J32.24; also elsewhere on the board
/OUTPUT/GPIO_21: J29.39, J29.40, J30.39, J30.40; also elsewhere on the board
/OUTPUT/GPIO_22: J29.13, J29.14, J30.13, J30.14; also elsewhere on the board
/OUTPUT/GPIO_26: J29.11, J29.12, J30.11, J30.12; also elsewhere on the board
/OUTPUT/GPIO_27: J29.9, J29.10, J30.9, J30.10; also elsewhere on the board
/OUTPUT/GPIO_28: J29.7, J29.8, J30.7, J30.8; also elsewhere on the board
/OUTPUT/HEADER_PINS/PIN_5: J29.15, J29.16, J30.15, J30.16
/OUTPUT/HEADER_PINS/PIN_6: J29.17, J29.18, J30.17, J30.18
/OUTPUT/HEADER_PINS/PIN_7: J29.19, J29.20, J30.19, J30.20
/OUTPUT/HEADER_PINS/PIN_8: J29.21, J29.22, J30.21, J30.22
/OUTPUT/HEADER_PINS/PIN_9: J29.23, J29.24, J30.23, J30.24
/OUTPUT/HEADER_PINS/PIN_10: J29.25, J29.26, J30.25, J30.26
/OUTPUT/HEADER_PINS/PIN_11: J29.27, J29.28, J30.27, J30.28
/OUTPUT/HEADER_PINS/PIN_12: J29.29, J29.30, J30.29, J30.30
/OUTPUT/HEADER_PINS/PIN_13: J29.31, J29.32, J30.31, J30.32
/OUTPUT/HEADER_PINS/PIN_14: J29.33, J29.34, J30.33, J30.34
/OUTPUT/HEADER_PINS/PIN_15: J29.35, J29.36, J30.35, J30.36
/OUTPUT/HEADER_PINS/PIN_16: J29.37, J29.38, J30.37, J30.38
/OUTPUT/HEADER_PINS/PIN_18: J29.41, J29.42, J30.41, J30.42
/OUTPUT/HEADER_PINS/PIN_19: J29.43, J29.44, J30.43, J30.44
/OUTPUT/HEADER_PINS/PIN_20: J29.45, J29.46, J30.45, J30.46
/OUTPUT/HEADER_PINS/PIN_21: J29.47, J29.48, J30.47, J30.48
/OUTPUT/HEADER_PINS/PIN_22: J29.49, J29.50, J30.49, J30.50
/OUTPUT/HEADER_PINS/PIN_29: J31.13, J31.14, J32.13, J32.14
/OUTPUT/HEADER_PINS/PIN_30: J31.15, J31.16, J32.15, J32.16
/OUTPUT/HEADER_PINS/PIN_31: J31.17, J31.18, J32.17, J32.18
/OUTPUT/HEADER_PINS/PIN_35: J31.25, J31.26, J32.25, J32.26
/OUTPUT/HEADER_PINS/PIN_36: J31.27, J31.28, J32.27, J32.28
/OUTPUT/HEADER_PINS/PIN_37: J31.29, J31.30, J32.29, J32.30
/OUTPUT/HEADER_PINS/PIN_38: J31.31, J31.32, J32.31, J32.32
/OUTPUT/HEADER_PINS/PIN_39: J31.33, J31.34, J32.33, J32.34
/OUTPUT/HEADER_PINS/PIN_40: J31.35, J31.36, J32.35, J32.36
/OUTPUT/HEADER_PINS/PIN_41: J31.37, J31.38, J32.37, J32.38
/OUTPUT/HEADER_PINS/PIN_42: J31.39, J31.40, J32.39, J32.40
/OUTPUT/HEADER_PINS/PIN_43: J31.41, J31.42, J32.41, J32.42
/OUTPUT/HEADER_PINS/PIN_44: J31.43, J31.44, J32.43, J32.44
/OUTPUT/HEADER_PINS/PIN_45: J31.45, J31.46, J32.45, J32.46
/OUTPUT/HEADER_PINS/PIN_46: J31.47, J31.48, J32.47, J32.48
/OUTPUT/HEADER_PINS/PIN_47: J31.49, J31.50, J32.49, J32.50
/PA9: J21.29, J21.30, J22.29, J22.30; also elsewhere on the board
/PB5: J21.41, J21.42, J22.41, J22.42; also elsewhere on the board
/PB14: J21.17, J21.18, J22.17, J22.18; also elsewhere on the board
/PB15: J21.19, J21.20, J22.19, J22.20; also elsewhere on the board
/PC6: J21.21, J21.22, J22.21, J22.22; also elsewhere on the board
/PC7: J21.23, J21.24, J22.23, J22.24; also elsewhere on the board
/PC8: J21.25, J21.26, J22.25, J22.26; also elsewhere on the board
/PC9: J21.27, J21.28, J22.27, J22.28; also elsewhere on the board
/PC10: J21.35, J21.36, J22.35, J22.36; also elsewhere on the board
/PC11: J21.37, J21.38, J22.37, J22.38; also elsewhere on the board
/PG_3.3V: J21.43, J21.44, J22.43, J22.44; also elsewhere on the board
/PG_5V: J21.31, J21.32, J22.31, J22.32; also elsewhere on the board
/PG_12V: J21.15, J21.16, J22.15, J22.16; also elsewhere on the board
/PG_VPiezo: J23.29, J23.30, J24.29, J24.30; also elsewhere on the board
/POWER/HEADER_PINS/PIN_1: J5.7, J5.8, J6.7, J6.8
/POWER/HEADER_PINS/PIN_2: J5.9, J5.10, J6.9, J6.10
/POWER/HEADER_PINS/PIN_3: J5.11, J5.12, J6.11, J6.12
/POWER/HEADER_PINS/PIN_4: J5.13, J5.14, J6.13, J6.14
/POWER/HEADER_PINS/PIN_6: J5.17, J5.18, J6.17, J6.18
/POWER/HEADER_PINS/PIN_7: J5.19, J5.20, J6.19, J6.20
/POWER/HEADER_PINS/PIN_8: J5.21, J5.22, J6.21, J6.22
/POWER/HEADER_PINS/PIN_9: J5.23, J5.24, J6.23, J6.24
/POWER/HEADER_PINS/PIN_10: J5.25, J5.26, J6.25, J6.26
/POWER/HEADER_PINS/PIN_11: J5.27, J5.28, J6.27, J6.28
/POWER/HEADER_PINS/PIN_12: J5.29, J5.30, J6.29, J6.30
/POWER/HEADER_PINS/PIN_14: J5.33, J5.34, J6.33, J6.34
/POWER/HEADER_PINS/PIN_15: J5.35, J5.36, J6.35, J6.36
/POWER/HEADER_PINS/PIN_16: J5.37, J5.38, J6.37, J6.38
/POWER/HEADER_PINS/PIN_17: J5.39, J5.40, J6.39, J6.40
/POWER/HEADER_PINS/PIN_18: J5.41, J5.42, J6.41, J6.42
/POWER/HEADER_PINS/PIN_20: J5.45, J5.46, J6.45, J6.46
/POWER/HEADER_PINS/PIN_21: J5.47, J5.48, J6.47, J6.48
/POWER/HEADER_PINS/PIN_22: J5.49, J5.50, J6.49, J6.50
/POWER/HEADER_PINS/PIN_23: J7.1, J7.2, J8.1, J8.2
/POWER/HEADER_PINS/PIN_24: J7.3, J7.4, J8.3, J8.4
/POWER/HEADER_PINS/PIN_25: J7.5, J7.6, J8.5, J8.6
/POWER/HEADER_PINS/PIN_26: J7.7, J7.8, J8.7, J8.8
/POWER/HEADER_PINS/PIN_27: J7.9, J7.10, J8.9, J8.10
/POWER/HEADER_PINS/PIN_28: J7.11, J7.12, J8.11, J8.12
/POWER/HEADER_PINS/PIN_29: J7.13, J7.14, J8.13, J8.14
/POWER/HEADER_PINS/PIN_30: J7.15, J7.16, J8.15, J8.16
/POWER/HEADER_PINS/PIN_31: J7.17, J7.18, J8.17, J8.18
/POWER/HEADER_PINS/PIN_32: J7.19, J7.20, J8.19, J8.20
/POWER/HEADER_PINS/PIN_33: J7.21, J7.22, J8.21, J8.22
/POWER/HEADER_PINS/PIN_34: J7.23, J7.24, J8.23, J8.24
/POWER/HEADER_PINS/PIN_35: J7.25, J7.26, J8.25, J8.26
/POWER/HEADER_PINS/PIN_36: J7.27, J7.28, J8.27, J8.28
/POWER/HEADER_PINS/PIN_38: J7.31, J7.32, J8.31, J8.32
/POWER/HEADER_PINS/PIN_39: J7.33, J7.34, J8.33, J8.34
/POWER/HEADER_PINS/PIN_40: J7.35, J7.36, J8.35, J8.36
/POWER/HEADER_PINS/PIN_41: J7.37, J7.38, J8.37, J8.38
/POWER/HEADER_PINS/PIN_42: J7.39, J7.40, J8.39, J8.40
/POWER/HEADER_PINS/PIN_43: J7.41, J7.42, J8.41, J8.42
/POWER/HEADER_PINS/PIN_44: J7.43, J7.44, J8.43, J8.44
/POWER/HEADER_PINS/PIN_45: J7.45, J7.46, J8.45, J8.46
/POWER/HEADER_PINS/PIN_46: J7.47, J7.48, J8.47, J8.48
/POWER/HEADER_PINS/PIN_47: J7.49, J7.50, J8.49, J8.50
/POWER/PG_3.3V: J5.43, J5.44, J6.43, J6.44; also elsewhere on the board
/POWER/PG_5V: J5.31, J5.32, J6.31, J6.32; also elsewhere on the board
/POWER/PG_12V: J5.15, J5.16, J6.15, J6.16; also elsewhere on the board
/POWER/PG_VPiezo: J7.29, J7.30, J8.29, J8.30; also elsewhere on the board
/RX_EN: J23.43, J23.44, J24.43, J24.44; also elsewhere on the board
/RX_FAULT: J23.41, J23.42, J24.41, J24.42; also elsewhere on the board
/SCL: J21.47, J21.48, J22.47, J22.48; also elsewhere on the board
/SDA: J21.45, J21.46, J22.45, J22.46; also elsewhere on the board
/SENSOR/ACC1_INT1: J11.31, J11.32, J12.31, J12.32; also elsewhere on the board
/SENSOR/ACC1_INT2: J11.33, J11.34, J12.33, J12.34; also elsewhere on the board
/SENSOR/ACC2_INT1: J11.35, J11.36, J12.35, J12.36; also elsewhere on the board
/SENSOR/ACC2_INT2: J11.39, J11.40, J12.39, J12.40; also elsewhere on the board
/SENSOR/HEADER_PINS/PIN_1: J9.7, J9.8, J10.7, J10.8
/SENSOR/HEADER_PINS/PIN_2: J9.9, J9.10, J10.9, J10.10
/SENSOR/HEADER_PINS/PIN_3: J9.11, J9.12, J10.11, J10.12
/SENSOR/HEADER_PINS/PIN_4: J9.13, J9.14, J10.13, J10.14
/SENSOR/HEADER_PINS/PIN_5: J9.15, J9.16, J10.15, J10.16
/SENSOR/HEADER_PINS/PIN_6: J9.17, J9.18, J10.17, J10.18
/SENSOR/HEADER_PINS/PIN_7: J9.19, J9.20, J10.19, J10.20
/SENSOR/HEADER_PINS/PIN_8: J9.21, J9.22, J10.21, J10.22
/SENSOR/HEADER_PINS/PIN_9: J9.23, J9.24, J10.23, J10.24
/SENSOR/HEADER_PINS/PIN_10: J9.25, J9.26, J10.25, J10.26
/SENSOR/HEADER_PINS/PIN_11: J9.27, J9.28, J10.27, J10.28
/SENSOR/HEADER_PINS/PIN_12: J9.29, J9.30, J10.29, J10.30
/SENSOR/HEADER_PINS/PIN_13: J9.31, J9.32, J10.31, J10.32
/SENSOR/HEADER_PINS/PIN_14: J9.33, J9.34, J10.33, J10.34
/SENSOR/HEADER_PINS/PIN_15: J9.35, J9.36, J10.35, J10.36
/SENSOR/HEADER_PINS/PIN_16: J9.37, J9.38, J10.37, J10.38
/SENSOR/HEADER_PINS/PIN_17: J9.39, J9.40, J10.39, J10.40
/SENSOR/HEADER_PINS/PIN_18: J9.41, J9.42, J10.41, J10.42
/SENSOR/HEADER_PINS/PIN_19: J9.43, J9.44, J10.43, J10.44
/SENSOR/HEADER_PINS/PIN_22: J9.49, J9.50, J10.49, J10.50
/SENSOR/HEADER_PINS/PIN_23: J11.1, J11.2, J12.1, J12.2
/SENSOR/HEADER_PINS/PIN_24: J11.3, J11.4, J12.3, J12.4
/SENSOR/HEADER_PINS/PIN_25: J11.5, J11.6, J12.5, J12.6
/SENSOR/HEADER_PINS/PIN_26: J11.7, J11.8, J12.7, J12.8
/SENSOR/HEADER_PINS/PIN_27: J11.9, J11.10, J12.9, J12.10
/SENSOR/HEADER_PINS/PIN_28: J11.11, J11.12, J12.11, J12.12
/SENSOR/HEADER_PINS/PIN_29: J11.13, J11.14, J12.13, J12.14
/SENSOR/HEADER_PINS/PIN_30: J11.15, J11.16, J12.15, J12.16
/SENSOR/HEADER_PINS/PIN_31: J11.17, J11.18, J12.17, J12.18
/SENSOR/HEADER_PINS/PIN_32: J11.19, J11.20, J12.19, J12.20
/SENSOR/HEADER_PINS/PIN_33: J11.21, J11.22, J12.21, J12.22
/SENSOR/HEADER_PINS/PIN_34: J11.23, J11.24, J12.23, J12.24
/SENSOR/HEADER_PINS/PIN_35: J11.25, J11.26, J12.25, J12.26
/SENSOR/HEADER_PINS/PIN_36: J11.27, J11.28, J12.27, J12.28
/SENSOR/HEADER_PINS/PIN_37: J11.29, J11.30, J12.29, J12.30
/SENSOR/HEADER_PINS/PIN_41: J11.37, J11.38, J12.37, J12.38
/SENSOR/HEADER_PINS/PIN_43: J11.41, J11.42, J12.41, J12.42
/SENSOR/HEADER_PINS/PIN_44: J11.43, J11.44, J12.43, J12.44
/SENSOR/HEADER_PINS/PIN_45: J11.45, J11.46, J12.45, J12.46
/SENSOR/HEADER_PINS/PIN_46: J11.47, J11.48, J12.47, J12.48
/SENSOR/HEADER_PINS/PIN_47: J11.49, J11.50, J12.49, J12.50
/SENSOR/SCL: J9.47, J9.48, J10.47, J10.48; also elsewhere on the board
/SENSOR/SDA: J9.45, J9.46, J10.45, J10.46; also elsewhere on the board
/TX_RX/ADC_CURRENT: J19.37, J19.38, J20.37, J20.38; also elsewhere on the board
/TX_RX/BPF_OUT: J19.49, J19.50, J20.49, J20.50; also elsewhere on the board
/TX_RX/HEADER_PINS/PIN_1: J17.7, J17.8, J18.7, J18.8
/TX_RX/HEADER_PINS/PIN_2: J17.9, J17.10, J18.9, J18.10
/TX_RX/HEADER_PINS/PIN_3: J17.11, J17.12, J18.11, J18.12
/TX_RX/HEADER_PINS/PIN_4: J17.13, J17.14, J18.13, J18.14
/TX_RX/HEADER_PINS/PIN_5: J17.15, J17.16, J18.15, J18.16
/TX_RX/HEADER_PINS/PIN_6: J17.17, J17.18, J18.17, J18.18
/TX_RX/HEADER_PINS/PIN_7: J17.19, J17.20, J18.19, J18.20
/TX_RX/HEADER_PINS/PIN_8: J17.21, J17.22, J18.21, J18.22
/TX_RX/HEADER_PINS/PIN_9: J17.23, J17.24, J18.23, J18.24
/TX_RX/HEADER_PINS/PIN_10: J17.25, J17.26, J18.25, J18.26
/TX_RX/HEADER_PINS/PIN_11: J17.27, J17.28, J18.27, J18.28
/TX_RX/HEADER_PINS/PIN_12: J17.29, J17.30, J18.29, J18.30
/TX_RX/HEADER_PINS/PIN_13: J17.31, J17.32, J18.31, J18.32
/TX_RX/HEADER_PINS/PIN_15: J17.35, J17.36, J18.35, J18.36
/TX_RX/HEADER_PINS/PIN_16: J17.37, J17.38, J18.37, J18.38
/TX_RX/HEADER_PINS/PIN_17: J17.39, J17.40, J18.39, J18.40
/TX_RX/HEADER_PINS/PIN_18: J17.41, J17.42, J18.41, J18.42
/TX_RX/HEADER_PINS/PIN_19: J17.43, J17.44, J18.43, J18.44
/TX_RX/HEADER_PINS/PIN_20: J17.45, J17.46, J18.45, J18.46
/TX_RX/HEADER_PINS/PIN_21: J17.47, J17.48, J18.47, J18.48
/TX_RX/HEADER_PINS/PIN_23: J19.1, J19.2, J20.1, J20.2
/TX_RX/HEADER_PINS/PIN_24: J19.3, J19.4, J20.3, J20.4
/TX_RX/HEADER_PINS/PIN_25: J19.5, J19.6, J20.5, J20.6
/TX_RX/HEADER_PINS/PIN_26: J19.7, J19.8, J20.7, J20.8
/TX_RX/HEADER_PINS/PIN_27: J19.9, J19.10, J20.9, J20.10
/TX_RX/HEADER_PINS/PIN_28: J19.11, J19.12, J20.11, J20.12
/TX_RX/HEADER_PINS/PIN_29: J19.13, J19.14, J20.13, J20.14
/TX_RX/HEADER_PINS/PIN_30: J19.15, J19.16, J20.15, J20.16
/TX_RX/HEADER_PINS/PIN_31: J19.17, J19.18, J20.17, J20.18
/TX_RX/HEADER_PINS/PIN_32: J19.19, J19.20, J20.19, J20.20
/TX_RX/HEADER_PINS/PIN_33: J19.21, J19.22, J20.21, J20.22
/TX_RX/HEADER_PINS/PIN_34: J19.23, J19.24, J20.23, J20.24
/TX_RX/HEADER_PINS/PIN_37: J19.29, J19.30, J20.29, J20.30
/TX_RX/HEADER_PINS/PIN_38: J19.31, J19.32, J20.31, J20.32
/TX_RX/HEADER_PINS/PIN_39: J19.33, J19.34, J20.33, J20.34
/TX_RX/HEADER_PINS/PIN_40: J19.35, J19.36, J20.35, J20.36
/TX_RX/HEADER_PINS/PIN_42: J19.39, J19.40, J20.39, J20.40
/TX_RX/HEADER_PINS/PIN_45: J19.45, J19.46, J20.45, J20.46
/TX_RX/HEADER_PINS/PIN_46: J19.47, J19.48, J20.47, J20.48
/TX_RX/HI_A: J19.27, J19.28, J20.27, J20.28; also elsewhere on the board
/TX_RX/HI_B: J17.49, J17.50, J18.49, J18.50; also elsewhere on the board
/TX_RX/LI_A: J19.25, J19.26, J20.25, J20.26; also elsewhere on the board
/TX_RX/LI_B: J17.33, J17.34, J18.33, J18.34; also elsewhere on the board
/TX_RX/RX_EN: J19.43, J19.44, J20.43, J20.44; also elsewhere on the board
/TX_RX/RX_FAULT: J19.41, J19.42, J20.41, J20.42; also elsewhere on the board
GND_HEADER: J21.5, J21.6, J22.5, J22.6; also elsewhere on the board
GND_OUTPUT: J29.5, J29.6, J30.5, J30.6; also elsewhere on the board
GND_POWER: J5.5, J5.6, J6.5, J6.6; also elsewhere on the board
GND_SENSOR: J9.5, J9.6, J10.5, J10.6; also elsewhere on the board
GND_TXRX: J17.5, J17.6, J18.5, J18.6; also elsewhere on the board

Notes on the sheet:
BOTTOM
TOP
RIGHT SIDE HEADERS
LEFT SIDE HEADERS

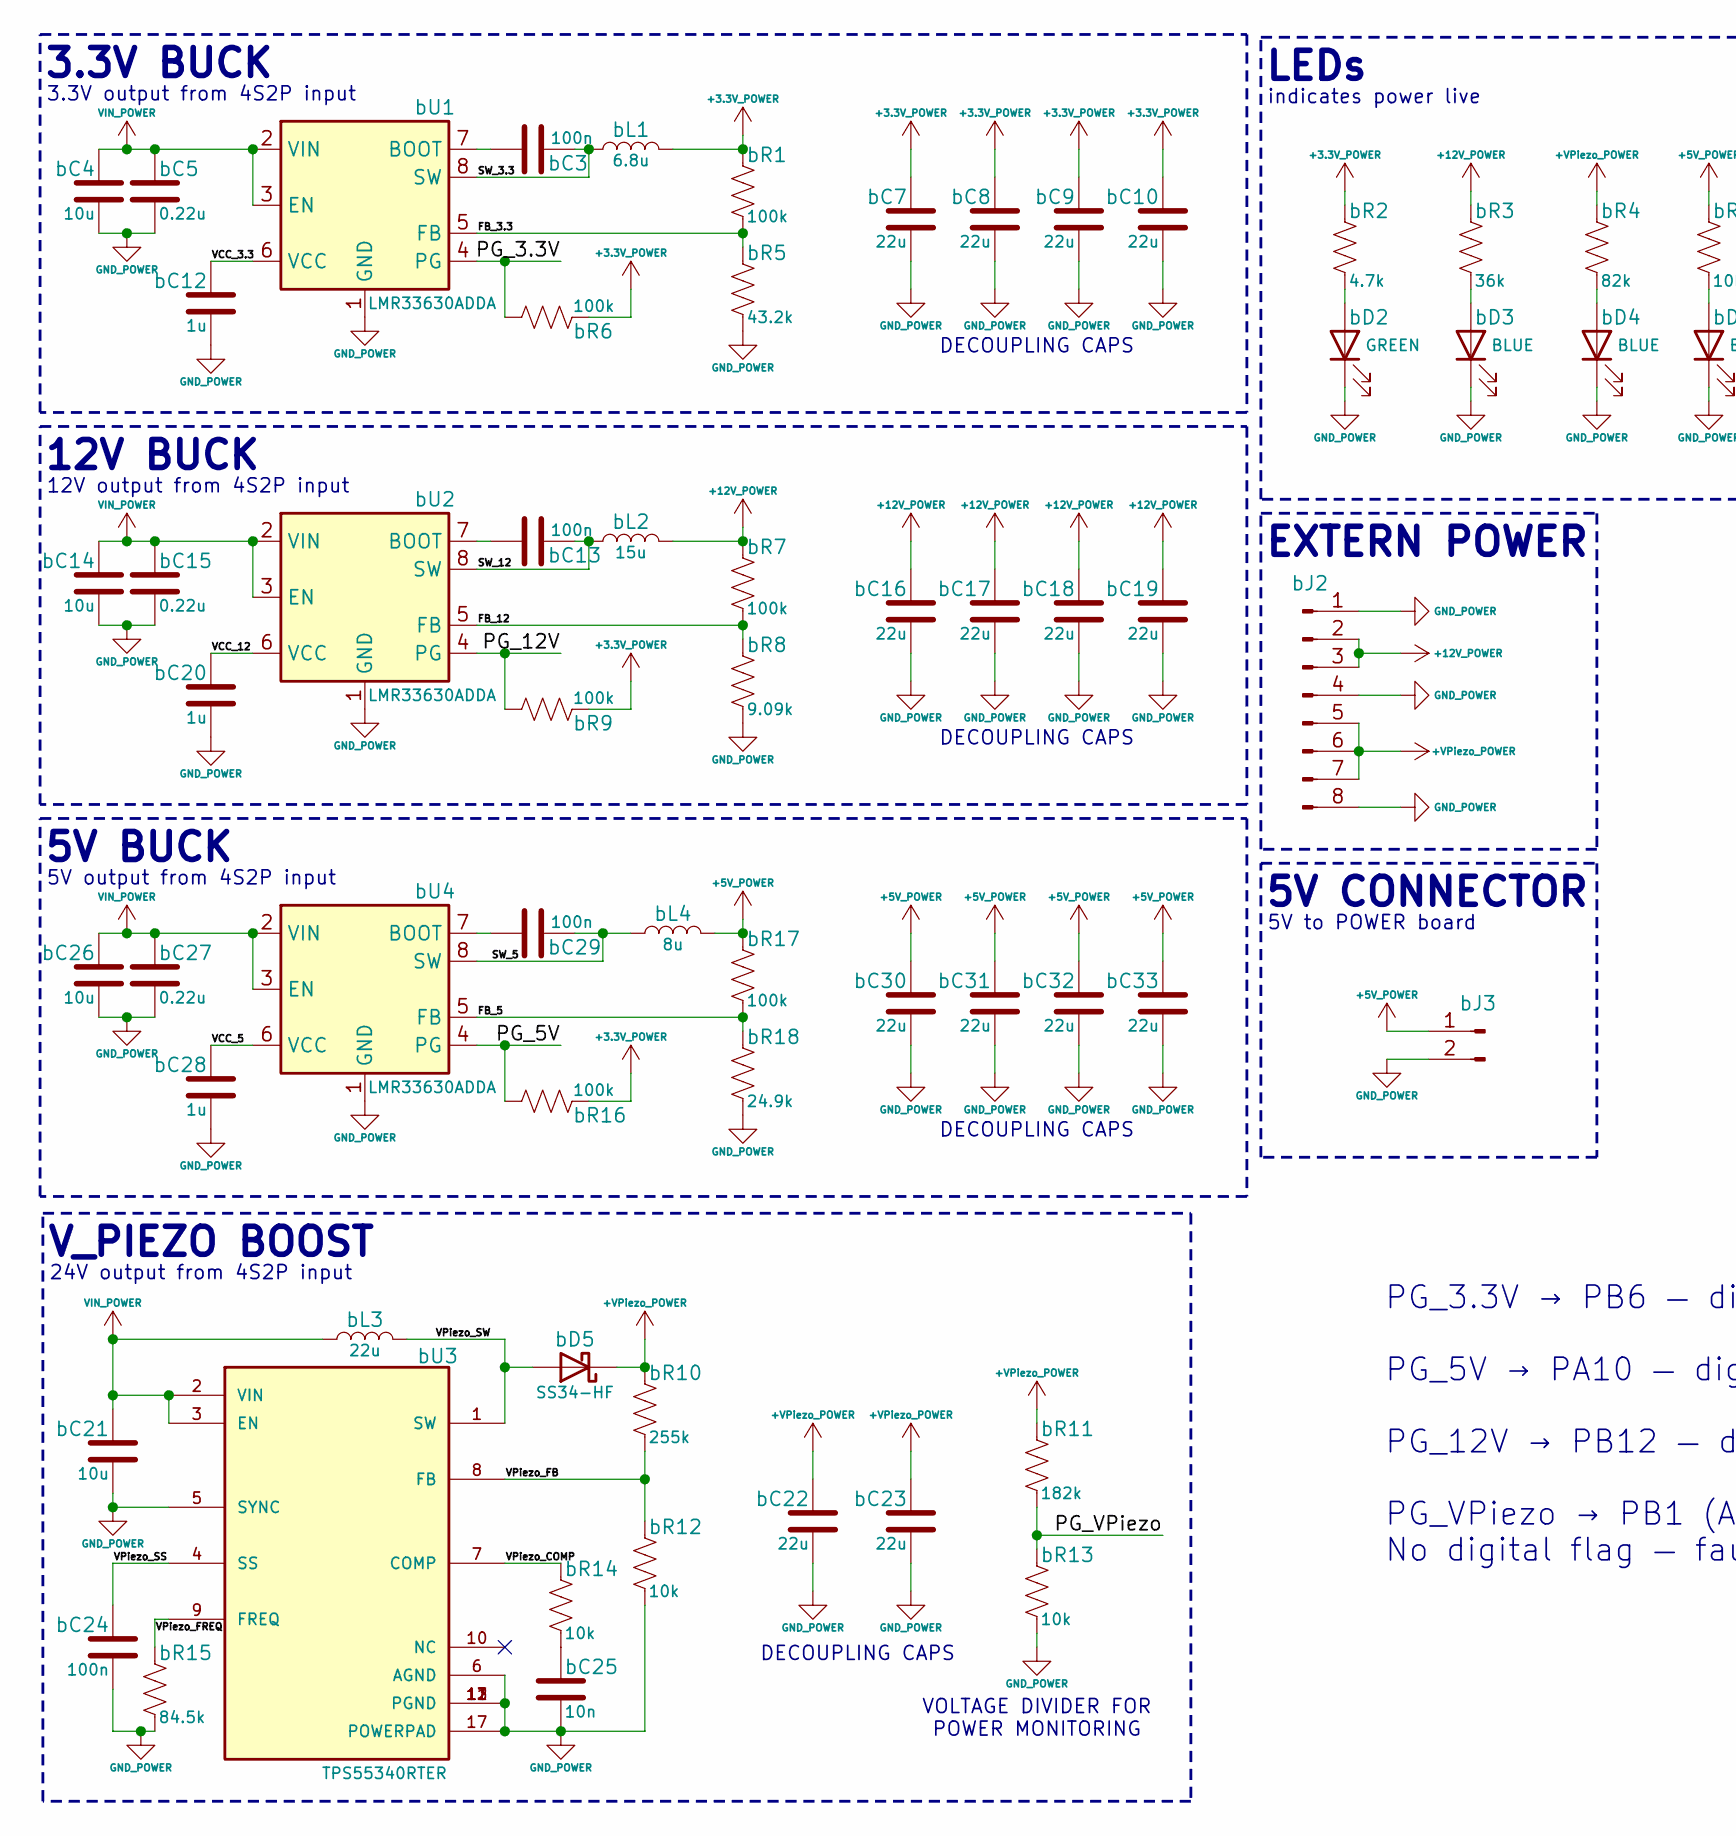
[picture p31: schematic POWER.kicad_sch, POWER BOARD, part in row 1, column 1]

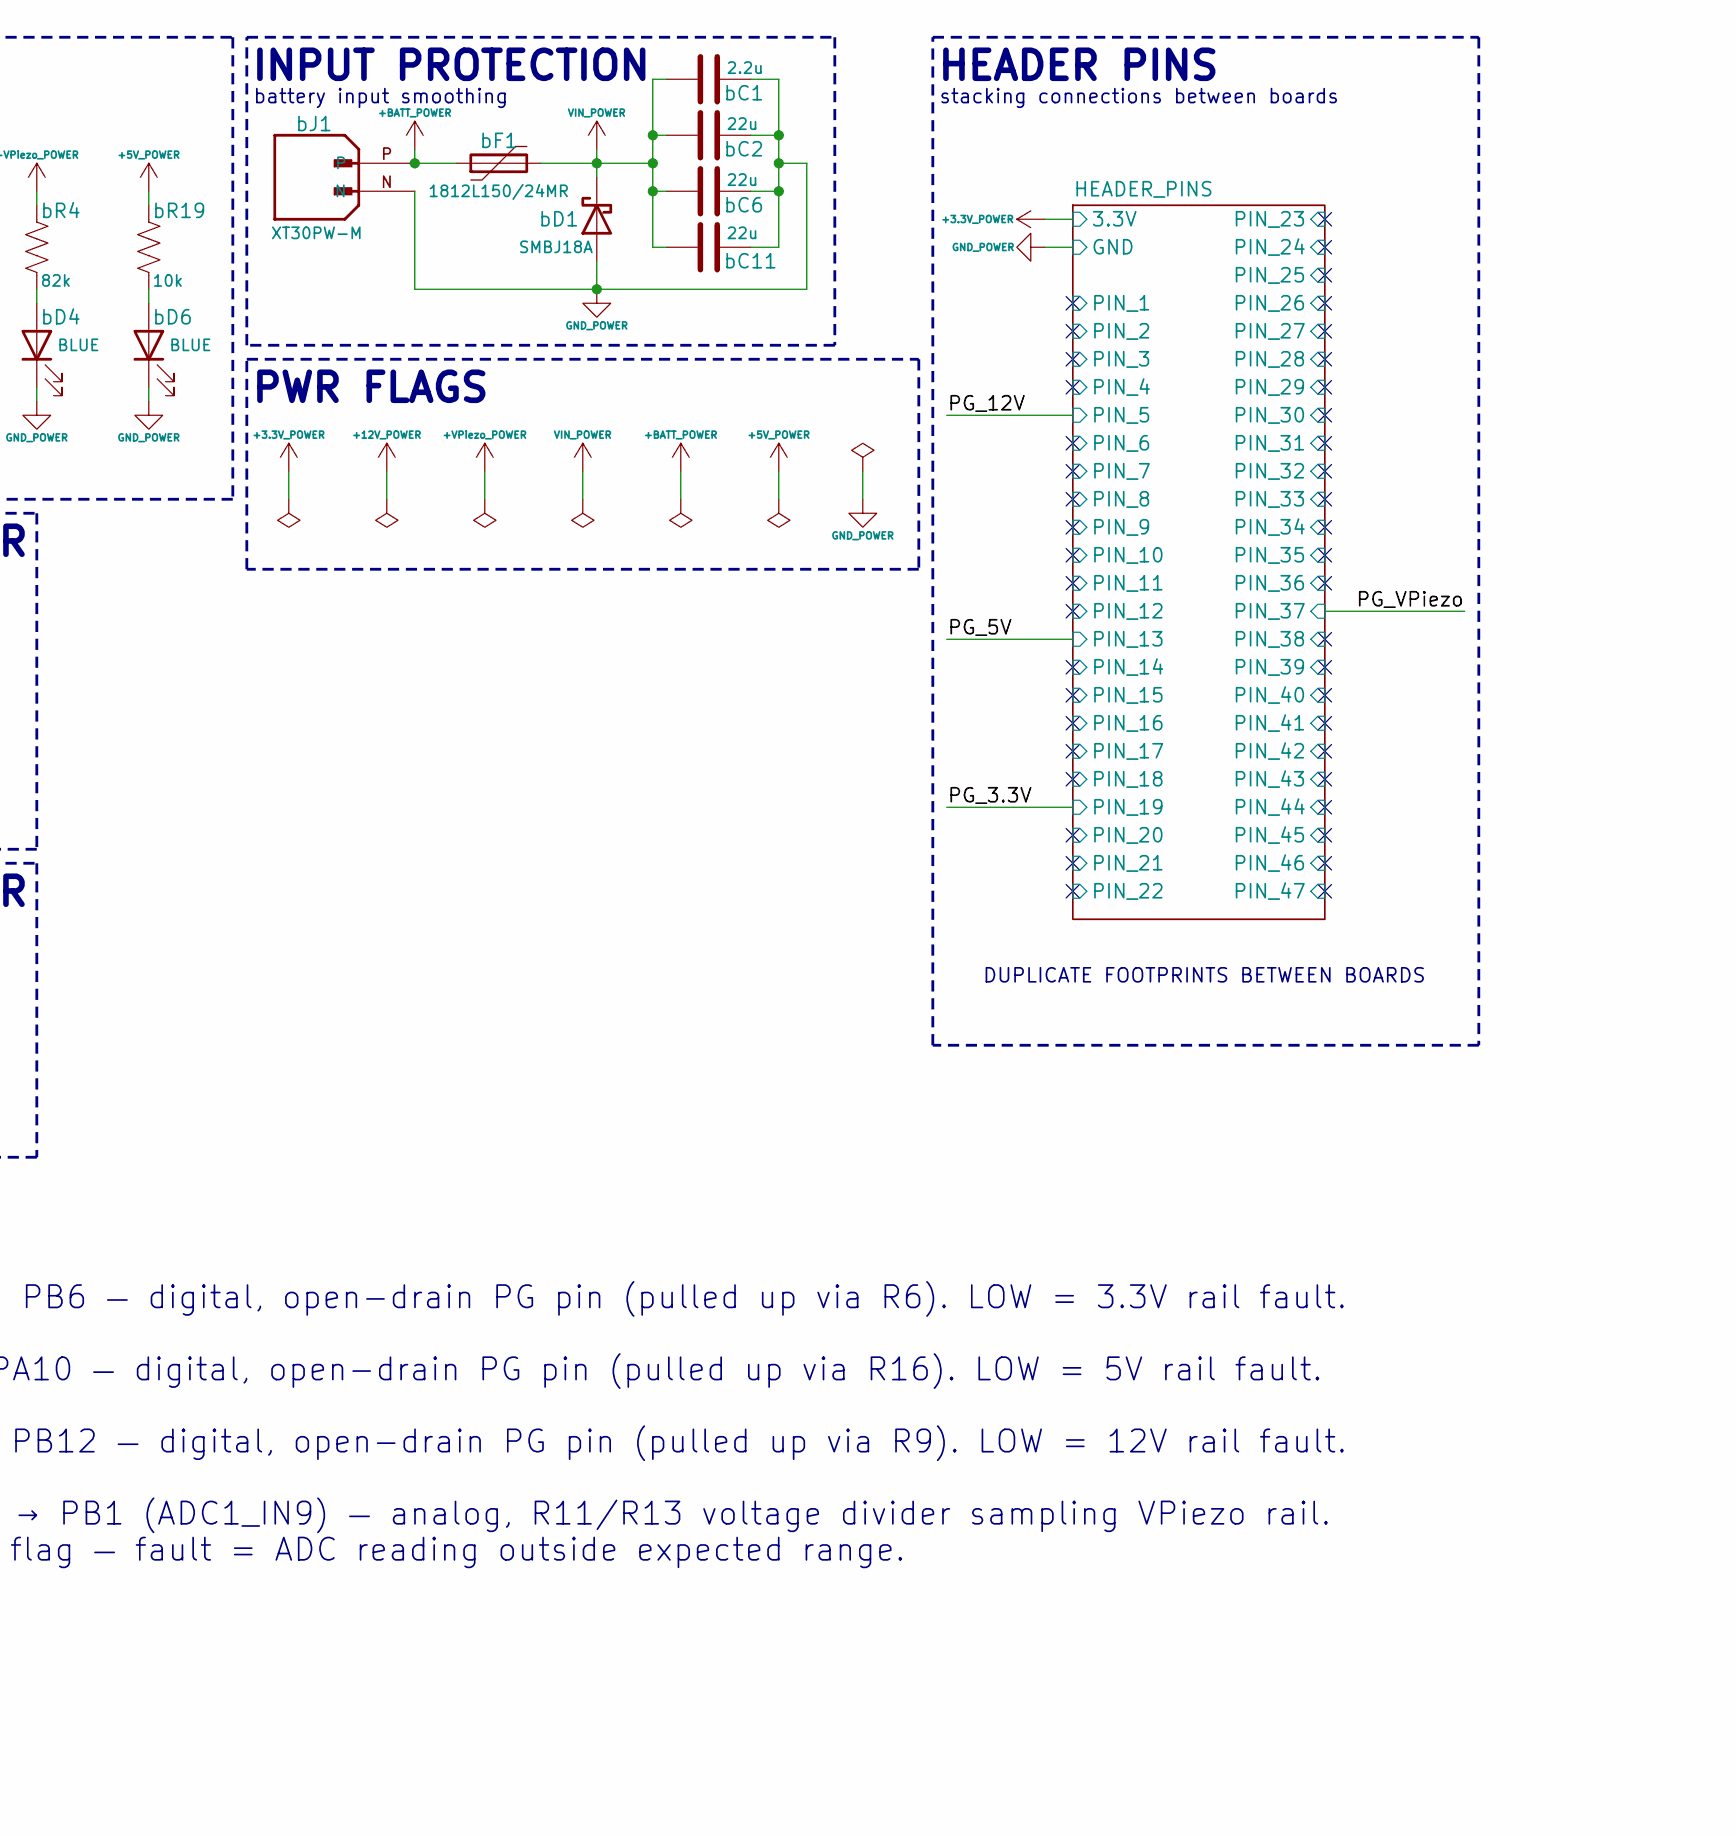
[picture p32: schematic POWER.kicad_sch, POWER BOARD, part in row 1, column 2]

Parts:
bC1: 2.2u; C_0805_2012Metric; MPN GRM21BR71H225KA12L
bC2, bC6, bC11, bC22, bC23: 22u; C_1210_3225Metric; MPN GRM32ER61H226KE15L
bC3, bC13, bC24, bC29: 100n; C_0603_1608Metric; MPN GRM188R71C104KA01D
bC4, bC14, bC21, bC26: 10u; C_0805_2012Metric; MPN GRM21BR71H106KA73L
bC5, bC15, bC27: 0.22u; C_0603_1608Metric; MPN GRM21BR71H224KA73L
bC7, bC8, bC9, bC10, bC16, bC17, bC18, bC19, bC30, bC31, bC32, bC33: 22u; C_0805_2012Metric; MPN GRM21BR61E226ME11L
bC12, bC20, bC28: 1u; C_0603_1608Metric; MPN GRM188R61A105KA61D
bC25: 10n; C_0603_1608Metric; MPN GRM188R71H103KA01D
bD1: SMBJ18A; D_SMB; MPN SMBJ18A
bD2: GREEN; LED_JE2835_CRW
bD3, bD4, bD6: BLUE; LED_JE2835_CRW
bD5: SS34-HF; D_SMA; MPN SS34-HF
bF1: 1812L150/24MR; Fuse_1812_4532Metric; MPN 1812L150/24MR
bJ1: XT30PW-M; AMASS_XT30PW-M; PARTREV 1.2
bJ2: Conn_01x08_Pin; JST_PH_B8B-PH-SM4-TB_1x08-1MP_P2.00mm_Vertical; MPN B8B-PH-SM4-TB(LF)(SN)
bJ3: Conn_01x02_Pin; JST_PH_B2B-PH-SM4-TB_1x02-1MP_P2.00mm_Vertical
bL1: 6.8u; L_Wuerth_MAPI-5030; MPN 7447799068
bL2: 15u; L_Wuerth_MAPI-5030; MPN 7447799150
bL3: 22u; L_Panasonic_PCC-M0630M; MPN ETQP6M220YGC
bL4: 8u; L_Wuerth_MAPI-5030; MPN 7447799068
bR1, bR6, bR7, bR9, bR16, bR17: 100k; R_0603_1608Metric; MPN RC0603FR-07100KL
bR2: 4.7k; R_0603_1608Metric; MPN RC0603FR-074K7L
bR3: 36k; R_0603_1608Metric; MPN RC0603FR-0736KL
bR4: 82k; R_0603_1608Metric; MPN RC0603FR-0782KL
bR5: 43.2k; R_0603_1608Metric; MPN RC0603FR-0743K2L
bR8: 9.09k; R_0603_1608Metric; MPN RC0603FR-079K09L
bR10: 255k; R_0603_1608Metric; MPN RC0603FR-07255KL
bR11: 182k; R_0603_1608Metric; MPN RC0603FR-07182KL
bR12, bR13, bR14: 10k; R_0603_1608Metric; MPN RC0603FR-0710KL
bR15: 84.5k; R_0603_1608Metric; MPN RC0603FR-0784K5L
bR18: 24.9k; R_0603_1608Metric; MPN RC0603FR-0743K2L
bR19: 10k; R_0603_1608Metric; MPN RC0603FR-0782KL
bU1, bU2, bU4: LMR33630ADDA; Texas_HSOP-8-1EP_3.9x4.9mm_P1.27mm_ThermalVias; MPN LMR33630ADDA
bU3: TPS55340RTER; QFN50P300X300X80-17N; MPN TPS55340RTER

Connections:
+3.3V_POWER: bC7.2, bC8.2, bC9.2, bC10.2, bL1.2, bR1.2, bR2.2, bR6.1, bR9.1, bR16.1; also elsewhere on the board
+5V_POWER: bC30.2, bC31.2, bC32.2, bC33.2, bJ3.1, bL4.2, bR17.2, bR19.2
+12V_POWER: bC16.2, bC17.2, bC18.2, bC19.2, bJ2.2, bJ2.3, bL2.2, bR3.2, bR7.2
+BATT_POWER: bF1.1, bJ1.P
+VPiezo_POWER: bC22.2, bC23.2, bD5.1 (K), bJ2.5, bJ2.6, bJ2.7, bR4.2, bR10.2, bR11.2
/POWER/FB_3.3: bR1.1, bR5.2, bU1.5 (FB)
/POWER/FB_5: bR17.1, bR18.2, bU4.5 (FB)
/POWER/FB_12: bR7.1, bR8.2, bU2.5 (FB)
/POWER/PG_3.3V: bR6.2, bU1.4 (PG); also elsewhere on the board
/POWER/PG_5V: bR16.2, bU4.4 (PG); also elsewhere on the board
/POWER/PG_12V: bR9.2, bU2.4 (PG); also elsewhere on the board
/POWER/PG_VPiezo: bR11.1, bR13.2; also elsewhere on the board
/POWER/SW_3.3: bC3.2, bL1.1, bU1.8 (SW)
/POWER/SW_5: bC29.2, bL4.1, bU4.8 (SW)
/POWER/SW_12: bC13.2, bL2.1, bU2.8 (SW)
/POWER/VCC_3.3: bC12.2, bU1.6 (VCC)
/POWER/VCC_5: bC28.2, bU4.6 (VCC)
/POWER/VCC_12: bC20.2, bU2.6 (VCC)
/POWER/VPiezo_COMP: bR14.2, bU3.7 (COMP)
/POWER/VPiezo_FB: bR10.1, bR12.2, bU3.8 (FB)
/POWER/VPiezo_FREQ: bR15.2, bU3.9 (FREQ)
/POWER/VPiezo_SS: bC24.2, bU3.4 (SS)
/POWER/VPiezo_SW: bD5.2 (A), bL3.2, bU3.1 (SW), bU3.15 (SW), bU3.16 (SW)
GND_POWER: bC1.2, bC2.2, bC4.1, bC5.1, bC6.2, bC7.1, bC8.1, bC9.1, bC10.1, bC11.2, bC12.1, bC14.1, bC15.1, bC16.1, bC17.1, bC18.1, bC19.1, bC20.1, bC21.1, bC22.1, bC23.1, bC24.1, bC25.1, bC26.1, bC27.1, bC28.1, bC30.1, bC31.1, bC32.1, bC33.1, bD1.2 (A), bD2.1 (K), bD3.1 (K), bD4.1 (K), bD6.1 (K), bJ1.N, bJ2.1, bJ2.4, bJ2.8, bJ3.2, bR5.1, bR8.1, bR12.1, bR13.1, bR15.1, bR18.1, bU1.1 (GND), bU1.9 (GND), bU2.1 (GND), bU2.9 (GND), bU3.5 (SYNC), bU3.6 (AGND), bU3.11 (PGND), bU3.12 (PGND), bU3.13 (PGND), bU3.17 (POWERPAD), bU4.1 (GND), bU4.9 (GND); also elsewhere on the board
unnamed: bC25.2, bR14.1
unnamed: bD2.2 (A), bR2.1
unnamed: bD3.2 (A), bR3.1
unnamed: bD4.2 (A), bR4.1
unnamed: bD6.2 (A), bR19.1
unnamed: bC3.1, bU1.7 (BOOT)
unnamed: bC13.1, bU2.7 (BOOT)
unnamed: bC29.1, bU4.7 (BOOT)
VIN_POWER: bC1.1, bC2.1, bC4.2, bC5.2, bC6.1, bC11.1, bC14.2, bC15.2, bC21.2, bC26.2, bC27.2, bD1.1 (K), bF1.2, bL3.1, bU1.2 (VIN), bU1.3 (EN), bU2.2 (VIN), bU2.3 (EN), bU3.2 (VIN), bU3.3 (EN), bU4.2 (VIN), bU4.3 (EN)

Notes on the sheet:
DECOUPLING CAPS
3.3V BUCK
24V output from 4S2P input
DUPLICATE FOOTPRINTS BETWEEN BOARDS
HEADER PINS
indicates power live
5V CONNECTOR
5V to POWER board
VOLTAGE DIVIDER FOR POWER MONITORING
LEDs
12V BUCK
5V output from 4S2P input
battery input smoothing
PWR FLAGS
PG_3.3V → PB6 — digital, open-drain PG pin (pulled up via R6). LOW = 3.3V rail fault. PG_5V → PA10 — digital, open-drain PG pin (pulled up via R16). LOW = 5V rail fault. PG_12V → PB12 — digital, open-drain PG pin (pulled up via R9). LOW = 12V rail fault. PG_VPiezo → PB1 (ADC1_IN9) — analog, R11/R13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
INPUT PROTECTION
12V output from 4S2P input
5V BUCK
3.3V output from 4S2P input
stacking connections between boards
V_PIEZO BOOST
EXTERN POWER
