Astrelis-Nav/SWARM_COMMs/SWARM_PCB_Rev_2/SWARM_PCB_Rev_2.kicad_pcb

## KiCad design SWARM_PCB_Rev_2/SWARM_PCB_Rev_2.kicad_pcb (continued)

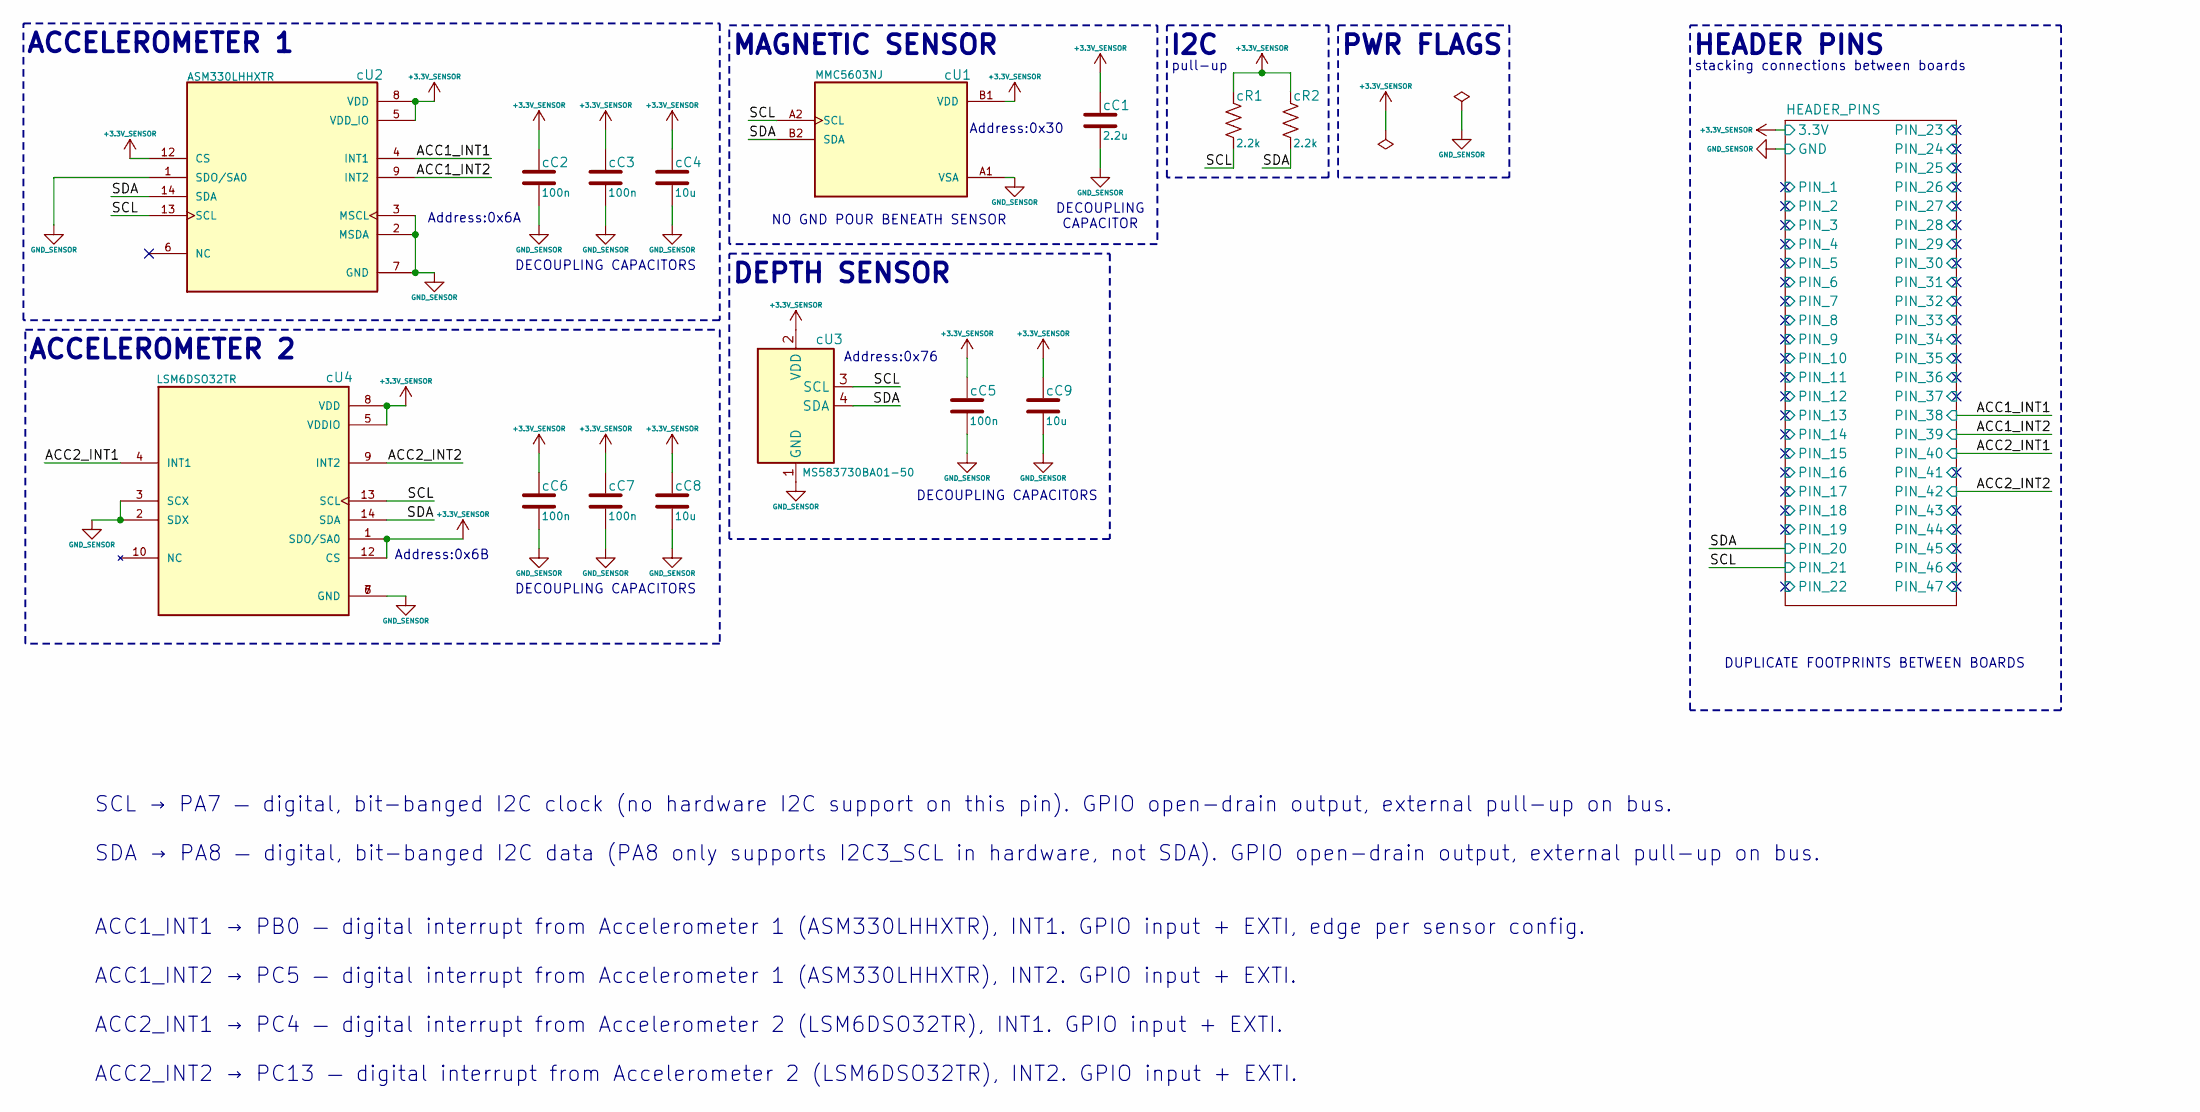
[picture p33: schematic SENSOR.kicad_sch]

Parts:
cC1: 2.2u; C_0603_1608Metric; MPN GRM188R60J225KE15D
cC2, cC3, cC5, cC6, cC7: 100n; C_0603_1608Metric; MPN GRM188R71C104KA01D
cC4, cC8, cC9: 10u; C_0603_1608Metric; MPN GRM188R60J106ME47D
cR1, cR2: 2.2k; R_0603_1608Metric; MPN RC0603FR-072K2L
cU1: MMC5603NJ; XDCR_MMC5603NJ; PARTREV B
cU2: ASM330LHHXTR; XDCR_ASM330LHHXTR; PARTREV 8
cU3: MS583730BA01-50; TE_MS5837-xxBA; MPN MS583730BA01-50
cU4: LSM6DSO32TR; XDCR_LSM6DSO32TR; PARTREV 1

Connections:
+3.3V_SENSOR: cC1.2, cC2.2, cC3.2, cC4.2, cC5.2, cC6.2, cC7.2, cC8.2, cC9.2, cR1.2, cR2.2, cU1.B1 (VDD), cU2.5 (VDD_IO), cU2.8 (VDD), cU2.12 (CS), cU3.2 (VDD), cU4.1 (SDO/SA0), cU4.5 (VDDIO), cU4.8 (VDD), cU4.12 (CS); also elsewhere on the board
/SENSOR/ACC1_INT1: cU2.4 (INT1); also elsewhere on the board
/SENSOR/ACC1_INT2: cU2.9 (INT2); also elsewhere on the board
/SENSOR/ACC2_INT1: cU4.4 (INT1); also elsewhere on the board
/SENSOR/ACC2_INT2: cU4.9 (INT2); also elsewhere on the board
/SENSOR/SCL: cR1.1, cU1.A2 (SCL), cU2.13 (SCL), cU3.3 (SCL), cU4.13 (SCL); also elsewhere on the board
/SENSOR/SDA: cR2.1, cU1.B2 (SDA), cU2.14 (SDA), cU3.4 (SDA), cU4.14 (SDA); also elsewhere on the board
GND_SENSOR: cC1.1, cC2.1, cC3.1, cC4.1, cC5.1, cC6.1, cC7.1, cC8.1, cC9.1, cU1.A1 (VSA), cU2.1 (SDO/SA0), cU2.2 (MSDA), cU2.3 (MSCL), cU2.7 (GND), cU3.1 (GND), cU4.2 (SDX), cU4.3 (SCX), cU4.6 (GND), cU4.7 (GND); also elsewhere on the board

Notes on the sheet:
Address:0x76
DECOUPLING CAPACITOR
DEPTH SENSOR
stacking connections between boards
MAGNETIC SENSOR
Address:0x6A
SCL → PA7 — digital, bit-banged I2C clock (no hardware I2C support on this pin). GPIO open-drain output, external pull-up on bus. SDA → PA8 — digital, bit-banged I2C data (PA8 only supports I2C3_SCL in hardware, not SDA). GPIO open-drain output, external pull-up on bus. ACC1_INT1 → PB0 — digital in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
DUPLICATE FOOTPRINTS BETWEEN BOARDS
DECOUPLING CAPACITORS
pull-up
Address:0x6B
ACCELEROMETER 2
Address:0x30
I2C
NO GND POUR BENEATH SENSOR
DECOUPLING CAPACITORS
PWR FLAGS
ACCELEROMETER 1
HEADER PINS

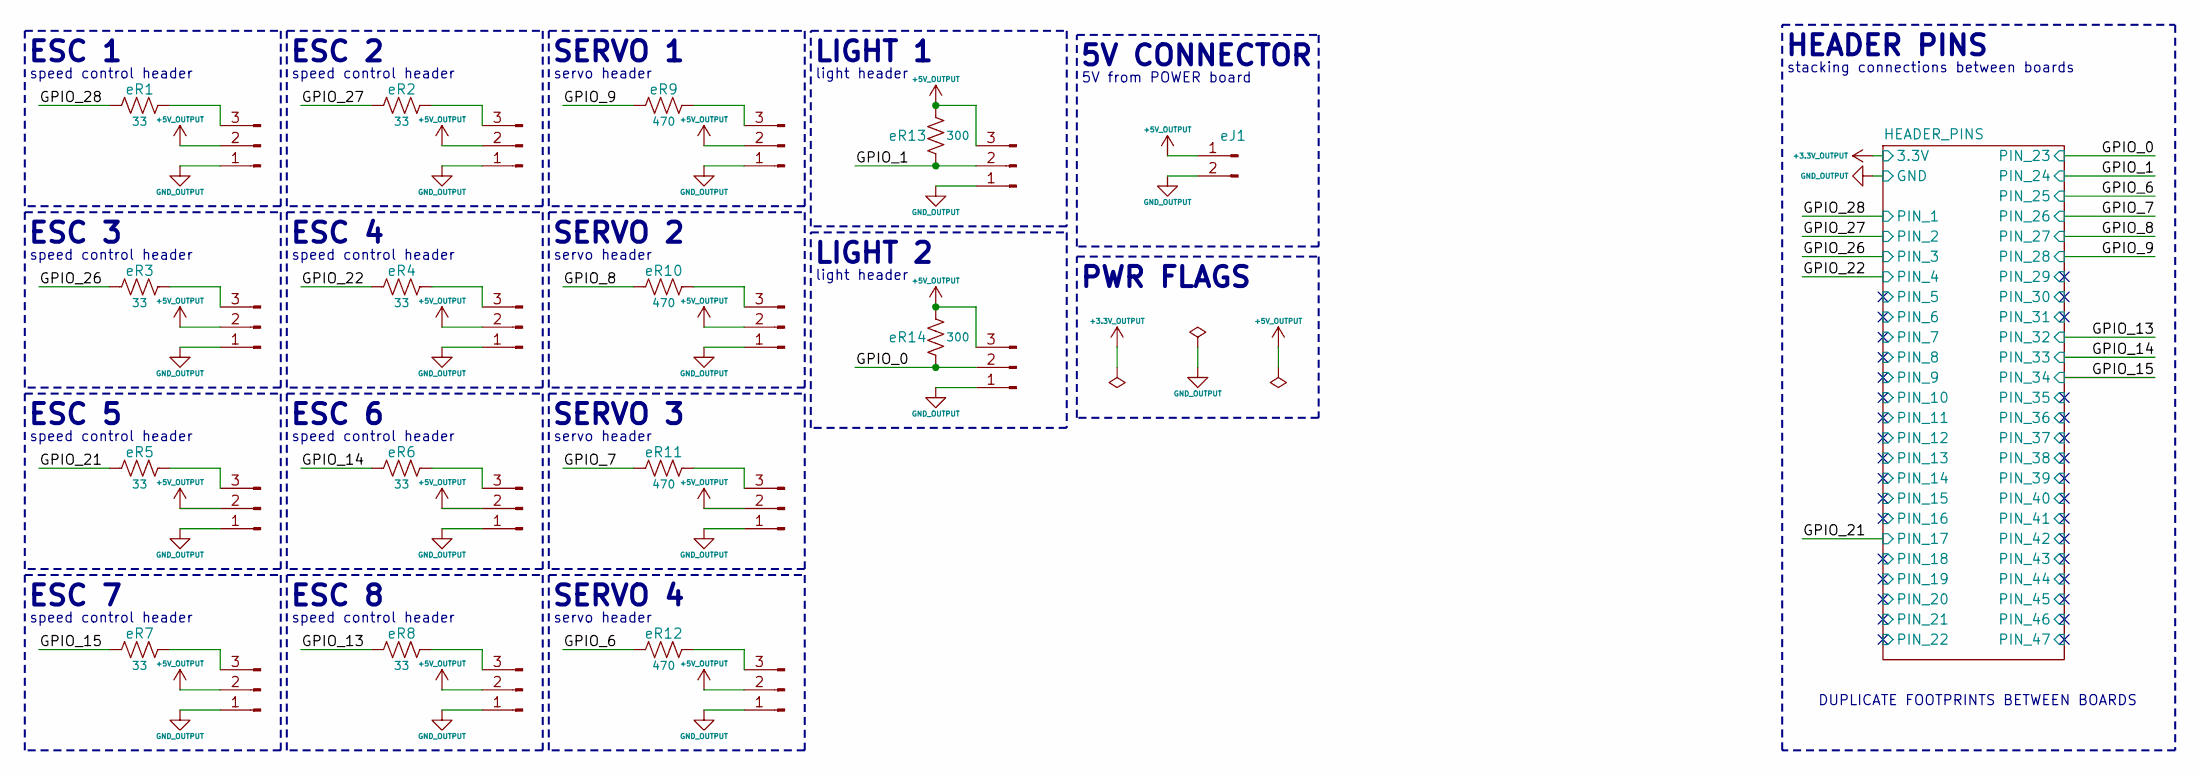
[picture p34: schematic OUTPUT.kicad_sch]

Parts:
OUT_1, OUT_2, OUT_3, OUT_4, OUT_5, OUT_6, OUT_7, OUT_8, OUT_9, OUT_10, OUT_11, OUT_12, OUT_13, OUT_14: Conn_01x03_Pin; PinHeader_1x03_P2.54mm_Vertical
eJ1: Conn_01x02_Pin; JST_PH_B2B-PH-SM4-TB_1x02-1MP_P2.00mm_Vertical
eR1, eR2, eR3, eR4, eR5, eR6, eR7, eR8: 33; R_0603_1608Metric
eR9, eR10, eR11, eR12: 470; R_0603_1608Metric
eR13, eR14: 300; R_0603_1608Metric

Connections:
+5V_OUTPUT: OUT_1.2, OUT_2.2, OUT_3.2, OUT_4.2, OUT_5.2, OUT_6.2, OUT_7.2, OUT_8.2, OUT_9.2, OUT_10.2, OUT_11.2, OUT_12.2, OUT_13.3, OUT_14.3, eJ1.1, eR13.2, eR14.2
/OUTPUT/GPIO_0: OUT_14.2, eR14.1; also elsewhere on the board
/OUTPUT/GPIO_1: OUT_13.2, eR13.1; also elsewhere on the board
/OUTPUT/GPIO_6: eR12.1; also elsewhere on the board
/OUTPUT/GPIO_7: eR11.1; also elsewhere on the board
/OUTPUT/GPIO_8: eR10.1; also elsewhere on the board
/OUTPUT/GPIO_9: eR9.1; also elsewhere on the board
/OUTPUT/GPIO_13: eR8.1; also elsewhere on the board
/OUTPUT/GPIO_14: eR6.1; also elsewhere on the board
/OUTPUT/GPIO_15: eR7.1; also elsewhere on the board
/OUTPUT/GPIO_21: eR5.1; also elsewhere on the board
/OUTPUT/GPIO_22: eR4.1; also elsewhere on the board
/OUTPUT/GPIO_26: eR3.1; also elsewhere on the board
/OUTPUT/GPIO_27: eR2.1; also elsewhere on the board
/OUTPUT/GPIO_28: eR1.1; also elsewhere on the board
GND_OUTPUT: OUT_1.1, OUT_2.1, OUT_3.1, OUT_4.1, OUT_5.1, OUT_6.1, OUT_7.1, OUT_8.1, OUT_9.1, OUT_10.1, OUT_11.1, OUT_12.1, OUT_13.1, OUT_14.1, eJ1.2; also elsewhere on the board
unnamed: OUT_1.3, eR1.2
unnamed: OUT_2.3, eR2.2
unnamed: OUT_3.3, eR3.2
unnamed: OUT_4.3, eR4.2
unnamed: OUT_5.3, eR5.2
unnamed: OUT_6.3, eR6.2
unnamed: OUT_7.3, eR7.2
unnamed: OUT_8.3, eR8.2
unnamed: OUT_9.3, eR9.2
unnamed: OUT_10.3, eR10.2
unnamed: OUT_11.3, eR11.2
unnamed: OUT_12.3, eR12.2

Notes on the sheet:
servo header
ESC 1
SERVO 1
ESC 8
ESC 3
ESC 5
SERVO 2
speed control header
PWR FLAGS
SERVO 4
ESC 4
light header
DUPLICATE FOOTPRINTS BETWEEN BOARDS
ESC 7
ESC 6
LIGHT 2
5V from POWER board
5V CONNECTOR
LIGHT 1
HEADER PINS
stacking connections between boards
ESC 2
SERVO 3

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
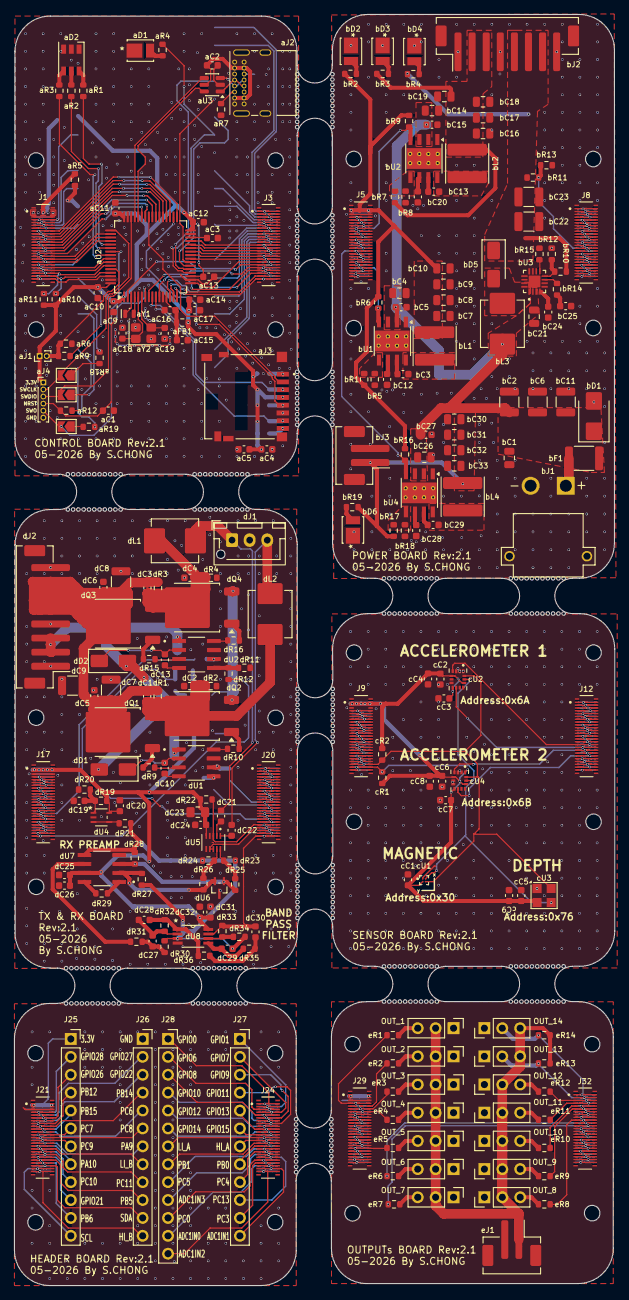
[picture p35: board SWARM_PCB_Rev_2.kicad_pcb from above]

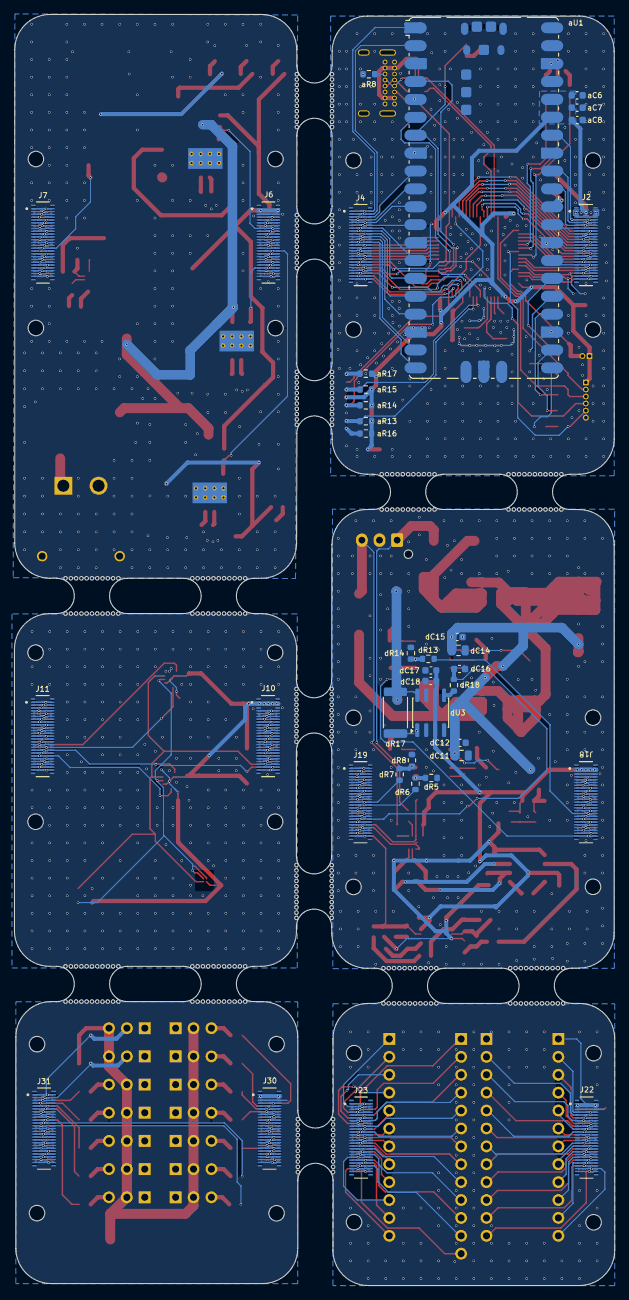
[picture p36: board SWARM_PCB_Rev_2.kicad_pcb from below]

Board: 2 copper layers, 85.2 x 180.4 mm, 295 parts (38 on the bottom side), 419 nets.

Other parts of the board:
mouse-bite-5mm-slot, mouse-bite-5mm-slot#2, mouse-bite-5mm-slot#3, mouse-bite-5mm-slot#4, mouse-bite-5mm-slot#5, mouse-bite-5mm-slot#6, mouse-bite-5mm-slot#7, mouse-bite-5mm-slot#8, mouse-bite-5mm-slot#9, mouse-bite-5mm-slot#10, mouse-bite-5mm-slot#11, mouse-bite-5mm-slot#12, mouse-bite-5mm-slot#13, mouse-bite-5mm-slot#14: VAL**; mouse-bite-5mm-slot
