Astrelis-Nav/SWARM_COMMs/PCB Design/COMMs_Rev_2/RX_Rev_2/RX.kicad_pcb

## KiCad design PCB Design/COMMs_Rev_2/RX_Rev_2/RX.kicad_pcb (2026-04-30)

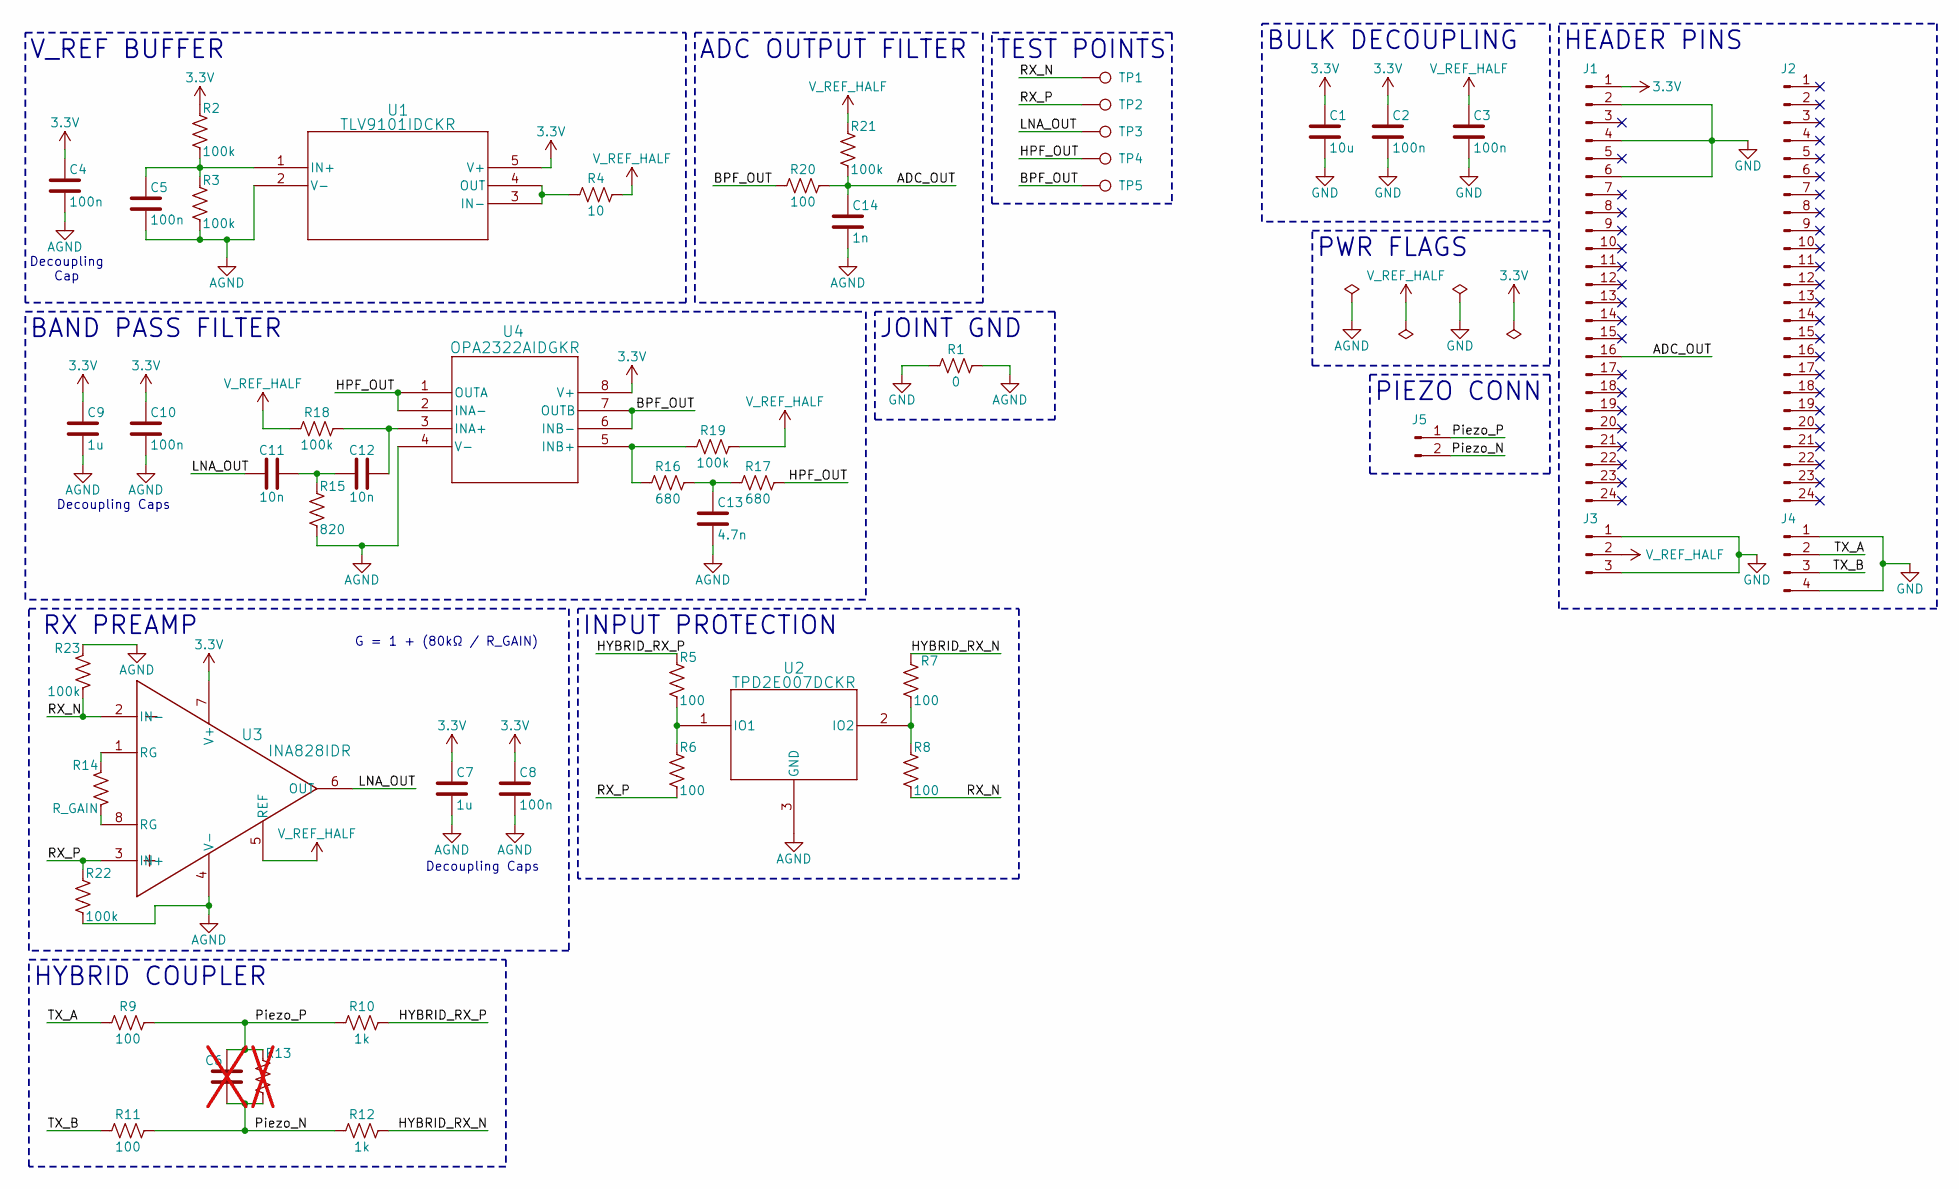
[picture p37: schematic RX.kicad_sch, SWARM RX COMMs]

Parts:
C1: 10u; C_1206_3216Metric
C2, C3, C4, C5, C8, C10: 100n; C_0603_1608Metric
C6: C_0603_1608Metric; not fitted
C7, C9: 1u; C_0603_1608Metric
C11, C12: 10n; C_0603_1608Metric
C13: 4.7n; C_0603_1608Metric
C14: 1n; C_0603_1608Metric
J1, J2: Conn_01x24_Pin; PinHeader_1x24_P2.54mm_Vertical
J3: Conn_01x03_Pin; PinHeader_1x03_P2.54mm_Vertical
J4: Conn_01x04_Pin; PinHeader_1x04_P2.54mm_Vertical
J5: Conn_01x02_Pin; JST_VH_B2P-VH_1x02_P3.96mm_Vertical
R1: 0; R_0603_1608Metric
R2, R3, R18, R19, R21, R22, R23: 100k; R_0603_1608Metric
R4: 10; R_0603_1608Metric
R5, R6, R7, R8, R9, R11, R20: 100; R_0603_1608Metric
R10, R12: 1k; R_0603_1608Metric
R13: R_0603_1608Metric; not fitted
R14: R_GAIN; R_0603_1608Metric
R15: 820; R_0603_1608Metric
R16, R17: 680; R_0603_1608Metric
TP1, TP2, TP3, TP4, TP5: TestPoint; TestPoint_Pad_1.0x1.0mm
U1: TLV9101IDCKR; SC70-5_DCK_TEX
U2: TPD2E007DCKR; DCK3
U3: INA828IDR; D0008A_L
U4: OPA2322AIDGKR; DGK8

Connections:
3.3V: C1.1, C2.1, C4.1, C7.1, C8.1, C9.1, C10.1, J1.1, R2.1, U1.5 (V+), U3.7 (V+), U4.8 (V+)
/ADC_OUT: C14.1, J1.16, R20.2, R21.2
/BPF_OUT: R20.1, TP5.1, U4.6 (INB-), U4.7 (OUTB)
/HPF_OUT: R17.2, TP4.1, U4.1 (OUTA), U4.2 (INA-)
/HYBRID_RX_N: R7.1, R12.2
/HYBRID_RX_P: R5.1, R10.2
/LNA_OUT: C11.1, TP3.1, U3.6 (OUT)
/Piezo_N: C6.2, J5.2, R11.2, R12.1, R13.2
/Piezo_P: C6.1, J5.1, R9.2, R10.1, R13.1
/RX_N: R8.2, R23.2, TP1.1, U3.2 (IN-)
/RX_P: R6.2, R22.1, TP2.1, U3.3 (IN+)
/TX_A: J4.2, R9.1
/TX_B: J4.3, R11.1
AGND: C4.2, C5.2, C7.2, C8.2, C9.2, C10.2, C13.2, C14.2, R1.2, R3.2, R15.2, R22.2, R23.1, U1.2 (V-), U2.3 (GND), U3.4 (V-), U4.4 (V-)
GND: C1.2, C2.2, C3.2, J1.2, J1.4, J1.6, J3.1, J3.3, J4.1, J4.4, R1.1
unnamed: C11.2, C12.1, R15.1
unnamed: C13.1, R16.2, R17.1
unnamed: R14.1, U3.1 (RG)
unnamed: R14.2, U3.8 (RG)
unnamed: C5.1, R2.2, R3.1, U1.1 (IN+)
unnamed: R4.1, U1.3 (IN-), U1.4 (OUT)
unnamed: R5.2, R6.1, U2.1 (IO1)
unnamed: R7.2, R8.1, U2.2 (IO2)
unnamed: C12.2, R18.2, U4.3 (INA+)
unnamed: R16.1, R19.1, U4.5 (INB+)
V_REF_HALF: C3.1, J3.2, R4.2, R18.1, R19.2, R21.1, U3.5 (REF)

Notes on the sheet:
RX PREAMP
ADC OUTPUT FILTER
V_REF BUFFER
HYBRID COUPLER
Decoupling Caps
G = 1 + (80kΩ / R_GAIN)
TEST POINTS
JOINT GND
BAND PASS FILTER
INPUT PROTECTION
PIEZO CONN
BULK DECOUPLING
Decoupling Cap
PWR FLAGS
HEADER PINS

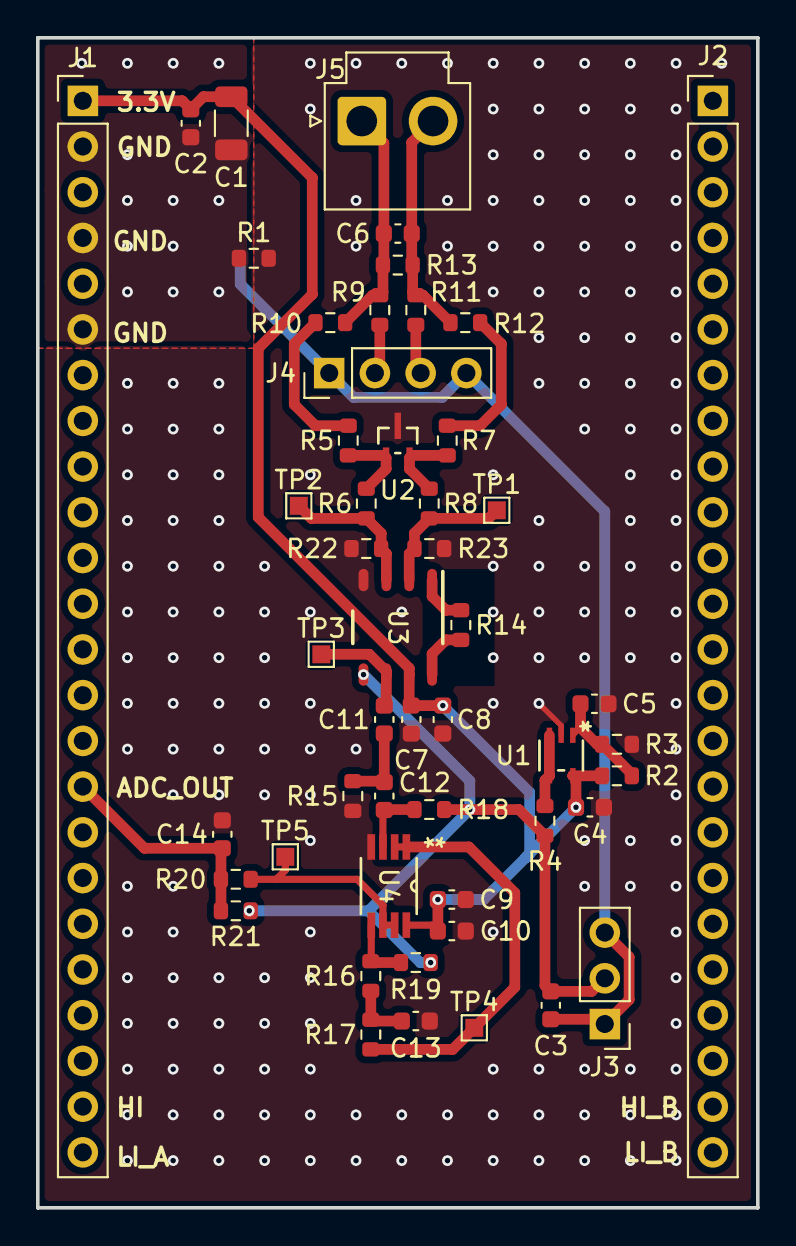
[picture p38: board RX.kicad_pcb from above]

Board: 2 copper layers, 40.0 x 65.0 mm, 51 parts (0 on the bottom side), 26 nets.
