Astrelis-Nav/SWARM_COMMs/PCB Design/CONTROL_Rev_1/CONTROL.kicad_pcb

## KiCad design PCB Design/CONTROL_Rev_1/CONTROL.kicad_pcb (2026-03-30)

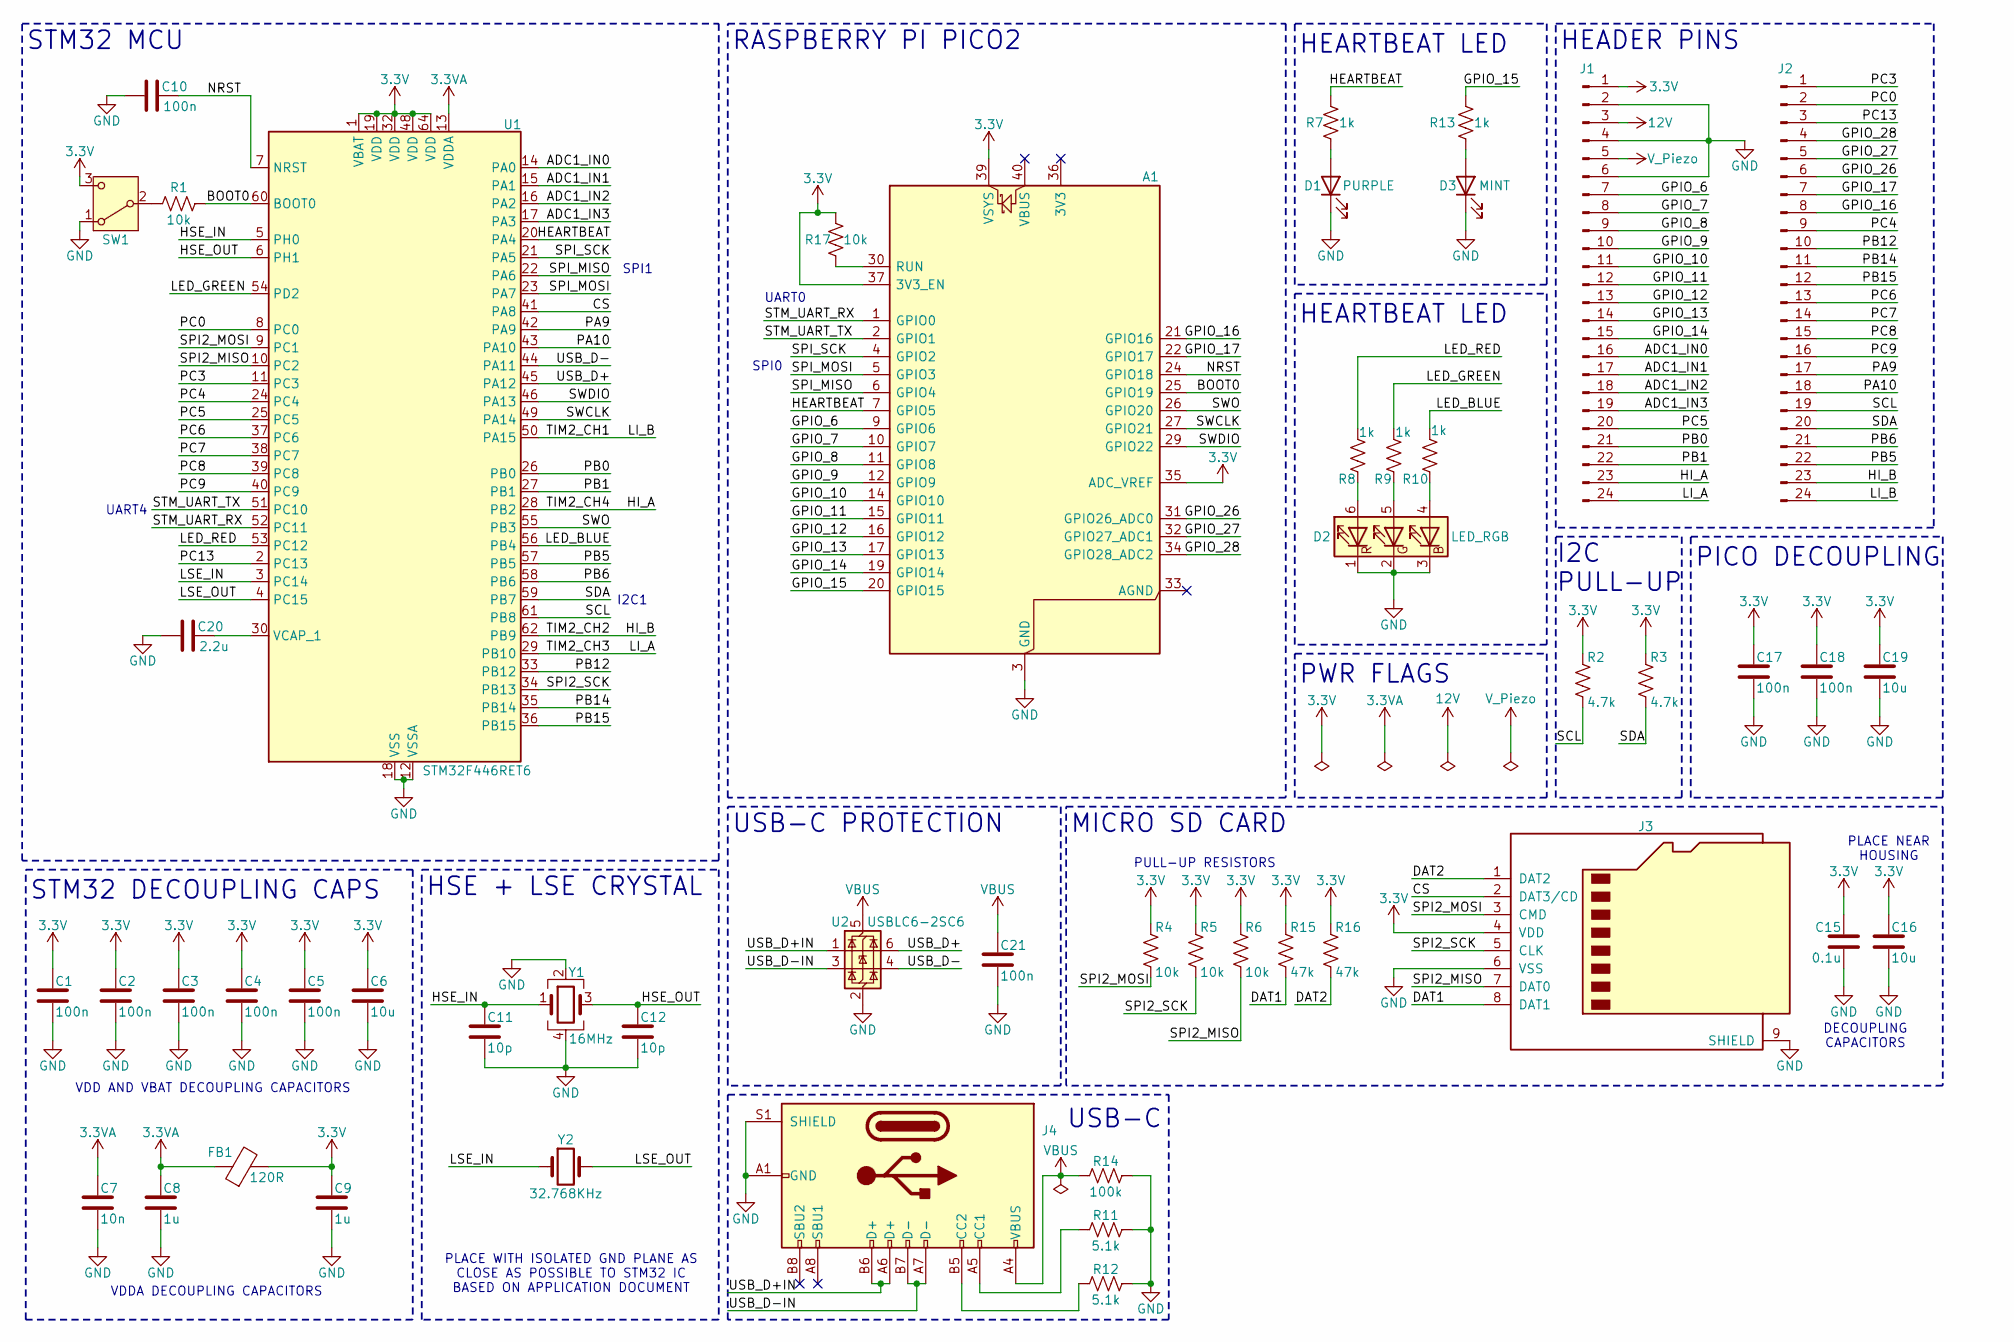
[picture p39: schematic CONTROL.kicad_sch, SWARM CONTROL BOARD]

Parts:
A1: RaspberryPi_Pico; RaspberryPi_Pico_Common_THT
C1, C2, C3, C4, C5, C10, C17, C18, C21: 100n; C_0603_1608Metric
C6, C16, C19: 10u; C_0603_1608Metric
C7: 10n; C_0603_1608Metric
C8, C9: 1u; C_0603_1608Metric
C11, C12: 10p; C_0603_1608Metric
C15: 0.1u; C_0603_1608Metric
C20: 2.2u; C_0603_1608Metric
D1: PURPLE; JB2835AWTWU57EA0000N0000001
D2: LED_RGB; LED_RGB_PLCC-6
D3: MINT; JB2835AWTWU57EA0000N0000001
FB1: 120R; L_0603_1608Metric
J1, J2: Conn_01x24_Pin; PinHeader_1x24_P2.54mm_Vertical
J3: Micro_SD_Card; AMPHENOL_1140084168
J4: USB_C_Receptacle_USB2.0_16P; USB_C_Receptacle_GCT_USB4085
R1, R4, R5, R6, R17: 10k; R_0603_1608Metric
R2, R3: 4.7k; R_0603_1608Metric
R7, R8, R9, R10, R13: 1k; R_0603_1608Metric
R11, R12: 5.1k; R_0603_1608Metric
R14: 100k; R_0603_1608Metric
R15, R16: 47k; R_0603_1608Metric
SW1: SW_SPDT; B-TYPE
U1: STM32F446RET6; LQFP-64_10x10mm_P0.5mm
U2: USBLC6-2SC6; SOT-23-6
Y1: 16MHz; Crystal_SMD_3225-4Pin_3.2x2.5mm
Y2: 32.768KHz; XTAL_ABS05W-32.768KHZ-D-2-T

Connections:
3.3V: A1.35 (ADC_VREF), A1.37 (3V3_EN), A1.39 (VSYS), C1.1, C2.1, C3.1, C4.1, C5.1, C6.1, C9.1, C15.1, C16.1, C17.1, C18.1, C19.1, FB1.2, J1.1, J3.4 (VDD), R2.1, R3.1, R4.1, R5.1, R6.1, R15.1, R16.1, R17.2, SW1.3 (C), U1.1 (VBAT), U1.19 (VDD), U1.32 (VDD), U1.48 (VDD), U1.64 (VDD)
3.3VA: C7.1, C8.1, FB1.1, U1.13 (VDDA)
12V: J1.3
/ADC1_IN0: J1.16, U1.14 (PA0)
/ADC1_IN1: J1.17, U1.15 (PA1)
/ADC1_IN2: J1.18, U1.16 (PA2)
/ADC1_IN3: J1.19, U1.17 (PA3)
/BOOT0: A1.25 (GPIO19), R1.2, U1.60 (BOOT0)
/CS: J3.2 (DAT3/CD), U1.41 (PA8)
/DAT1: J3.8 (DAT1), R15.2
/DAT2: J3.1 (DAT2), R16.2
/GPIO_6: A1.9 (GPIO6), J1.7
/GPIO_7: A1.10 (GPIO7), J1.8
/GPIO_8: A1.11 (GPIO8), J1.9
/GPIO_9: A1.12 (GPIO9), J1.10
/GPIO_10: A1.14 (GPIO10), J1.11
/GPIO_11: A1.15 (GPIO11), J1.12
/GPIO_12: A1.16 (GPIO12), J1.13
/GPIO_13: A1.17 (GPIO13), J1.14
/GPIO_14: A1.19 (GPIO14), J1.15
/GPIO_15: A1.20 (GPIO15), R13.2
/GPIO_16: A1.21 (GPIO16), J2.8
/GPIO_17: A1.22 (GPIO17), J2.7
/GPIO_26: A1.31 (GPIO26_ADC0), J2.6
/GPIO_27: A1.32 (GPIO27_ADC1), J2.5
/GPIO_28: A1.34 (GPIO28_ADC2), J2.4
/HEARTBEAT: A1.7 (GPIO5), R7.2, U1.20 (PA4)
/HI_A: J1.23, U1.28 (PB2)
/HI_B: J2.23, U1.62 (PB9)
/HSE_IN: C11.1, U1.5 (PH0), Y1.1
/HSE_OUT: C12.1, U1.6 (PH1), Y1.3
/LED_BLUE: R10.2, U1.56 (PB4)
/LED_GREEN: R9.2, U1.54 (PD2)
/LED_RED: R8.2, U1.53 (PC12)
/LI_A: J1.24, U1.29 (PB10)
/LI_B: J2.24, U1.50 (PA15)
/LSE_IN: U1.3 (PC14), Y2.1
/LSE_OUT: U1.4 (PC15), Y2.2
/NRST: A1.24 (GPIO18), C10.2, U1.7 (NRST)
/PA9: J2.17, U1.42 (PA9)
/PA10: J2.18, U1.43 (PA10)
/PB0: J1.21, U1.26 (PB0)
/PB1: J1.22, U1.27 (PB1)
/PB5: J2.22, U1.57 (PB5)
/PB6: J2.21, U1.58 (PB6)
/PB12: J2.10, U1.33 (PB12)
/PB14: J2.11, U1.35 (PB14)
/PB15: J2.12, U1.36 (PB15)
/PC0: J2.2, U1.8 (PC0)
/PC3: J2.1, U1.11 (PC3)
/PC4: J2.9, U1.24 (PC4)
/PC5: J1.20, U1.25 (PC5)
/PC6: J2.13, U1.37 (PC6)
/PC7: J2.14, U1.38 (PC7)
/PC8: J2.15, U1.39 (PC8)
/PC9: J2.16, U1.40 (PC9)
/PC13: J2.3, U1.2 (PC13)
/SCL: J2.19, R2.2, U1.61 (PB8)
/SDA: J2.20, R3.2, U1.59 (PB7)
/SPI2_MISO: J3.7 (DAT0), R6.2, U1.10 (PC2)
/SPI2_MOSI: J3.3 (CMD), R4.2, U1.9 (PC1)
/SPI2_SCK: J3.5 (CLK), R5.2, U1.34 (PB13)
/SPI_MISO: A1.6 (GPIO4), U1.22 (PA6)
/SPI_MOSI: A1.5 (GPIO3), U1.23 (PA7)
/SPI_SCK: A1.4 (GPIO2), U1.21 (PA5)
/STM_UART_RX: A1.1 (GPIO0), U1.52 (PC11)
/STM_UART_TX: A1.2 (GPIO1), U1.51 (PC10)
/SWCLK: A1.27 (GPIO21), U1.49 (PA14)
/SWDIO: A1.29 (GPIO22), U1.46 (PA13)
/SWO: A1.26 (GPIO20), U1.55 (PB3)
/USB_D+: U1.45 (PA12), U2.6 (I/O1)
/USB_D+IN: J4.A6 (D+), J4.B6 (D+), U2.1 (I/O1)
/USB_D-: U1.44 (PA11), U2.4 (I/O2)
/USB_D-IN: J4.A7 (D-), J4.B7 (D-), U2.3 (I/O2)
GND: A1.3 (GND), A1.8 (GND), A1.13 (GND), A1.18 (GND), A1.23 (GND), A1.28 (GND), A1.38 (GND), C1.2, C2.2, C3.2, C4.2, C5.2, C6.2, C7.2, C8.2, C9.2, C10.1, C11.2, C12.2, C15.2, C16.2, C17.2, C18.2, C19.2, C20.1, C21.2, D1.1 (K), D2.1 (RK), D2.2 (GK), D2.3 (BK), D3.1 (K), J1.2, J1.4, J1.6, J3.6 (VSS), J3.9 (SHIELD), J4.A1 (GND), J4.A12 (GND), J4.B1 (GND), J4.B12 (GND), J4.S1 (SHIELD), R11.2, R12.2, R14.2, SW1.1 (A), U1.12 (VSSA), U1.18 (VSS), U1.31 (VSS), U1.47 (VSS), U1.63 (VSS), U2.2 (GND), Y1.2, Y1.4
unnamed: A1.30 (RUN), R17.1
unnamed: D1.2 (A), R7.1
unnamed: D2.4 (BA), R10.1
unnamed: D2.5 (GA), R9.1
unnamed: D2.6 (RA), R8.1
unnamed: D3.2 (A), R13.1
unnamed: J4.A5 (CC1), R11.1
unnamed: J4.B5 (CC2), R12.1
unnamed: R1.1, SW1.2 (B)
unnamed: C20.2, U1.30 (VCAP_1)
VBUS: C21.1, J4.A4 (VBUS), J4.A9 (VBUS), J4.B4 (VBUS), J4.B9 (VBUS), R14.1, U2.5 (VBUS)
V_Piezo: J1.5

Notes on the sheet:
SPI0
SPI1
I2C1
PWR FLAGS
UART0
VDD AND VBAT DECOUPLING CAPACITORS
USB-C
HSE + LSE CRYSTAL
PICO DECOUPLING
HEADER PINS
STM32 DECOUPLING CAPS
UART4
USB-C PROTECTION
PULL-UP RESISTORS
HEARTBEAT LED
PLACE WITH ISOLATED GND PLANE AS CLOSE AS POSSIBLE TO STM32 IC BASED ON APPLICATION DOCUMENT
PLACE NEAR HOUSING
STM32 MCU
I2C PULL-UP
MICRO SD CARD
VDDA DECOUPLING CAPACITORS
RASPBERRY PI PICO2
DECOUPLING CAPACITORS

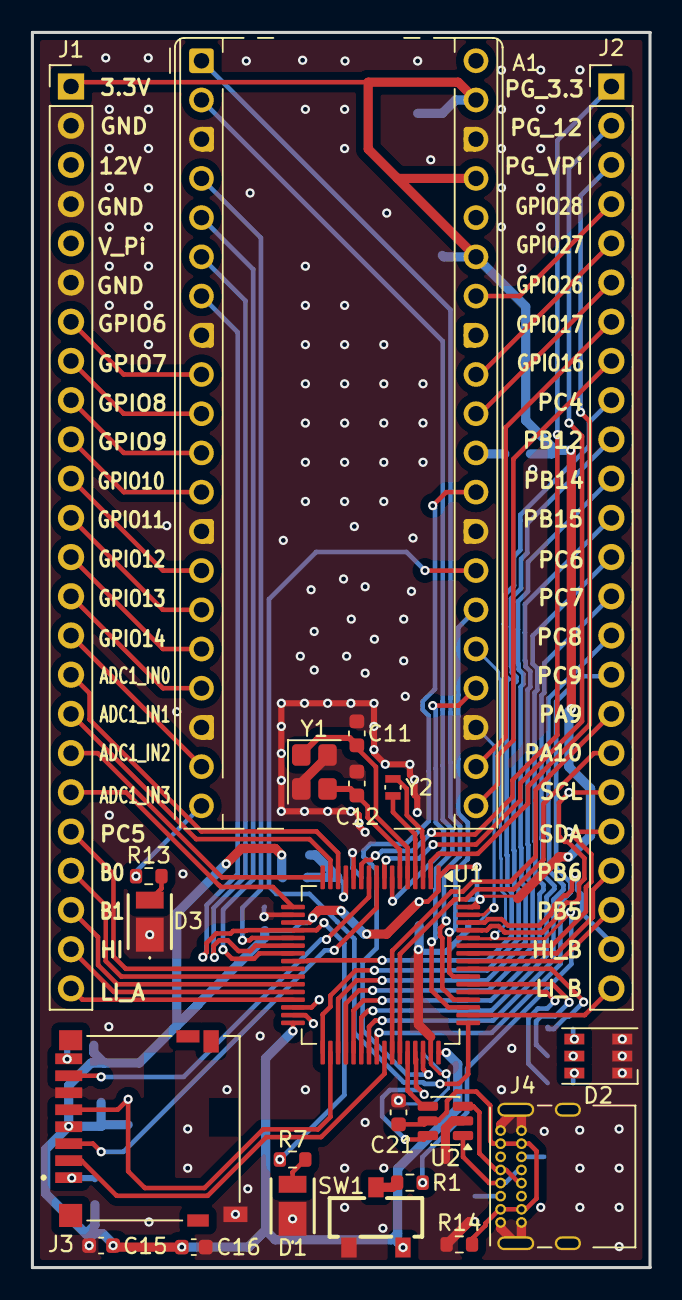
[picture p40: board CONTROL.kicad_pcb from above]

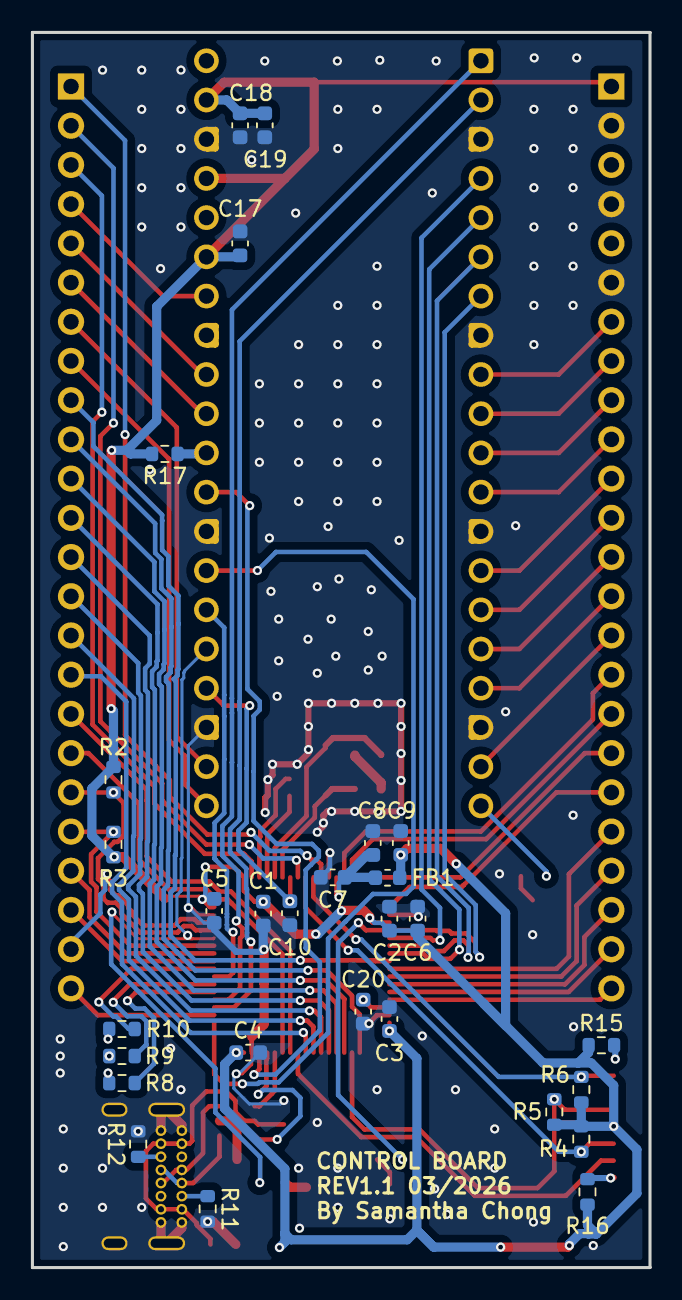
[picture p41: board CONTROL.kicad_pcb from below]

Board: 2 copper layers, 40.0 x 80.0 mm, 50 parts (28 on the bottom side), 85 nets.
