Astrelis-Nav/SWARM_COMMs/PCB Design/PWR_Rev_1/PWR.kicad_pcb

## KiCad design PCB Design/PWR_Rev_1/PWR.kicad_pcb (2026-04-15)

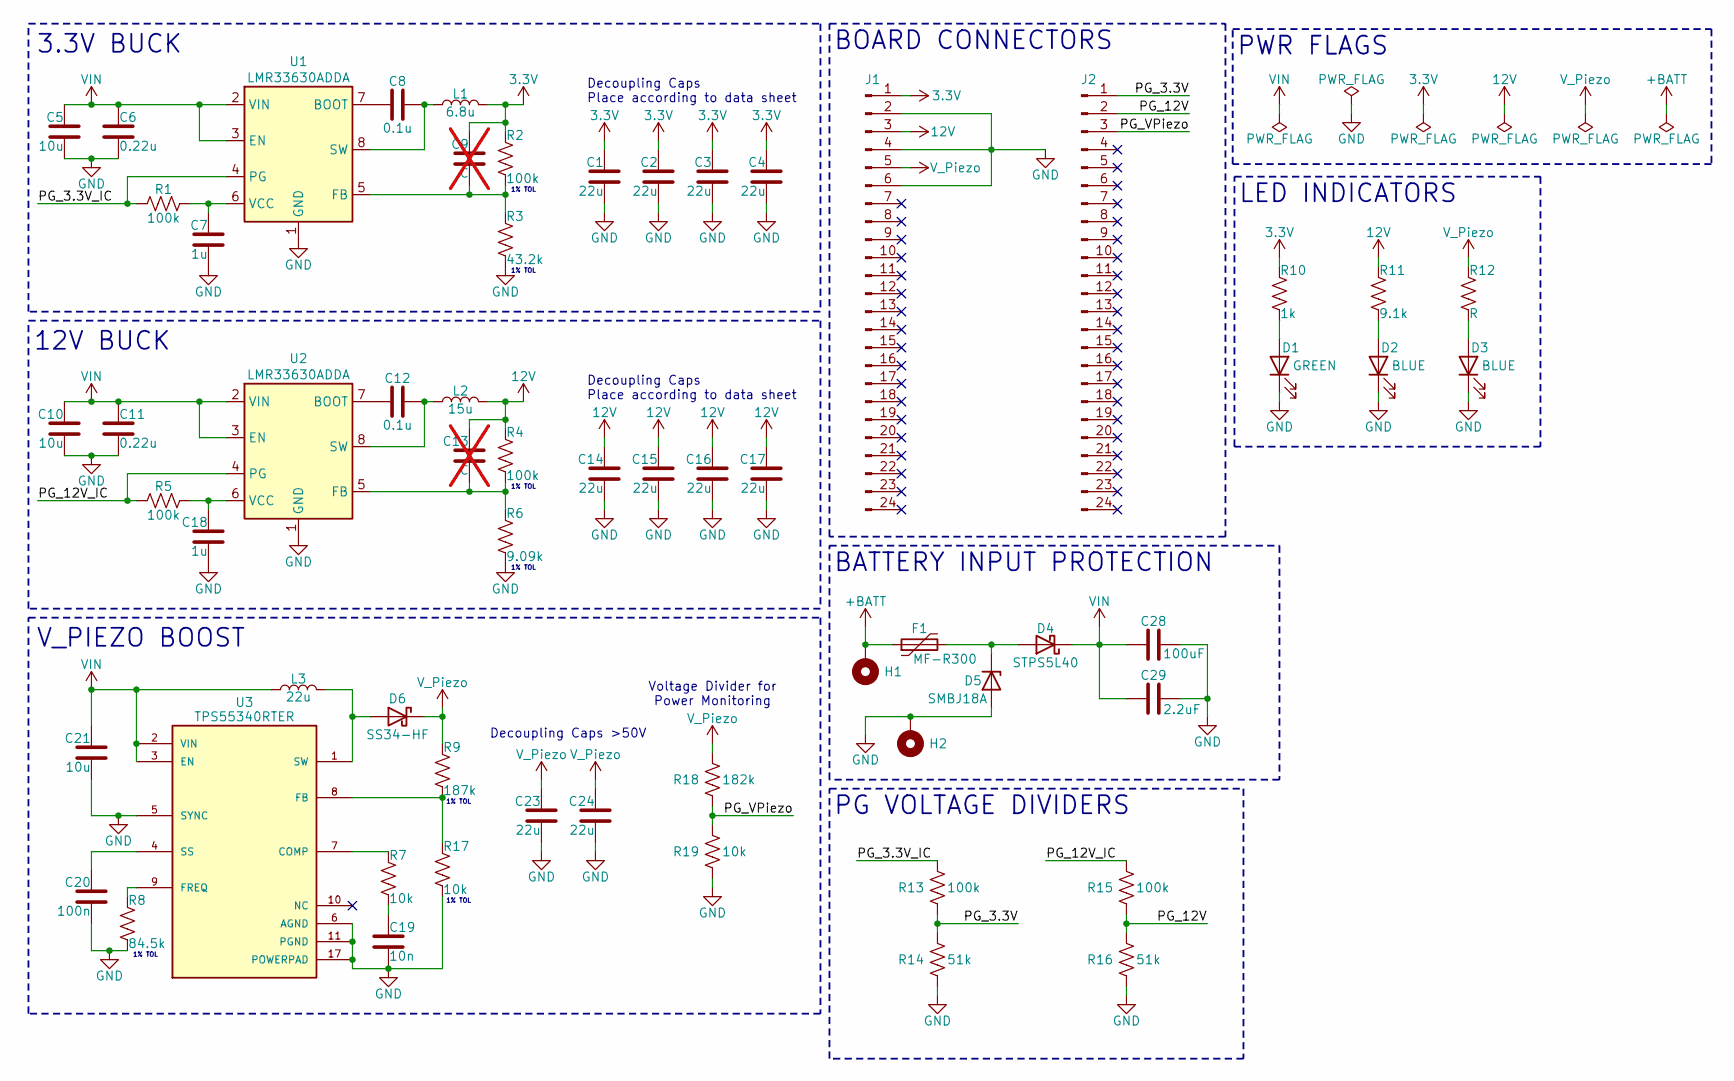
[picture p42: schematic PWR.kicad_sch, SWARM PWR BOARD]

Parts:
C1, C2, C3, C4, C14, C15, C16, C17, C23, C24: 22u; C_1210_3225Metric
C5, C10: 10u; C_1210_3225Metric
C6, C11: 0.22u; C_0603_1608Metric
C7, C18: 1u; C_0603_1608Metric
C8, C12: 0.1u; C_0603_1608Metric
C9, C13: C; C_0603_1608Metric; not fitted
C19: 10n; C_0603_1608Metric
C20: 100n; C_0603_1608Metric
C21: 10u; C_1206_3216Metric
C28: 100uF; C_Elec_6.3x5.8
C29: 2.2uF; C_0603_1608Metric
D1: GREEN; LED_JE2835_CRW
D2, D3: BLUE; LED_JE2835_CRW
D4: STPS5L40; D_DO-201AD_P12.70mm_Horizontal
D5: SMBJ18A; D_SMB
D6: SS34-HF; D_SMA
F1: MF-R300; Fuse_Bourns_MF-RHT300
H1, H2: MountingHole_Pad; MountingHole_2.2mm_M2_Pad_TopBottom
J1, J2: Conn_01x24_Pin; PinHeader_1x24_P2.54mm_Vertical
L1: 6.8u; L_Wuerth_MAPI-5030
L2: 15u; L_Wuerth_MAPI-5030
L3: 22u; L_Bourns_SDR0604
R1, R2, R4, R5, R13, R15: 100k; R_0603_1608Metric
R3: 43.2k; R_0603_1608Metric
R6: 9.09k; R_0603_1608Metric
R7, R17, R19: 10k; R_0603_1608Metric
R8: 84.5k; R_0603_1608Metric
R9: 187k; R_0603_1608Metric
R10: 1k; R_0603_1608Metric
R11: 9.1k; R_0603_1608Metric
R12: R; R_0603_1608Metric
R14, R16: 51k; R_0603_1608Metric
R18: 182k; R_0603_1608Metric
U1, U2: LMR33630ADDA; Texas_HSOP-8-1EP_3.9x4.9mm_P1.27mm_ThermalVias
U3: TPS55340RTER; QFN50P300X300X80-17N; DigiKey_Part_Number 296-37677-1-ND

Connections:
3.3V: C1.1, C2.1, C3.1, C4.1, C9.1, J1.1, L1.2, R2.2, R10.2
12V: C13.1, C14.1, C15.1, C16.1, C17.1, J1.3, L2.2, R4.2, R11.2
+BATT: F1.1, H1.1
/PG_3.3V: J2.1, R13.1, R14.2
/PG_3.3V_IC: R1.1, R13.2, U1.4 (PG)
/PG_12V: J2.2, R15.1, R16.2
/PG_12V_IC: R5.1, R15.2, U2.4 (PG)
/PG_VPiezo: J2.3, R18.1, R19.2
GND: C1.2, C2.2, C3.2, C4.2, C5.2, C6.2, C7.2, C10.2, C11.2, C14.2, C15.2, C16.2, C17.2, C18.2, C19.2, C20.2, C21.2, C23.2, C24.2, C28.2, C29.2, D1.1 (K), D2.1 (K), D3.1 (K), D5.2 (A), H2.1, J1.2, J1.4, J1.6, R3.1, R6.1, R8.1, R14.1, R16.1, R17.1, R19.1, U1.1 (GND), U1.9 (GND), U2.1 (GND), U2.9 (GND), U3.5 (SYNC), U3.6 (AGND), U3.11 (PGND), U3.12 (PGND), U3.13 (PGND), U3.17 (POWERPAD)
unnamed: C19.1, R7.1
unnamed: D1.2 (A), R10.1
unnamed: D2.2 (A), R11.1
unnamed: D3.2 (A), R12.1
unnamed: D4.2 (A), D5.1 (K), F1.2
unnamed: D6.2 (A), L3.2, U3.1 (SW), U3.15 (SW), U3.16 (SW)
unnamed: C8.2, U1.7 (BOOT)
unnamed: C9.2, R2.1, R3.2, U1.5 (FB)
unnamed: C8.1, L1.1, U1.8 (SW)
unnamed: C7.1, R1.2, U1.6 (VCC)
unnamed: C12.2, U2.7 (BOOT)
unnamed: C13.2, R4.1, R6.2, U2.5 (FB)
unnamed: C12.1, L2.1, U2.8 (SW)
unnamed: C18.1, R5.2, U2.6 (VCC)
unnamed: R7.2, U3.7 (COMP)
unnamed: R9.1, R17.2, U3.8 (FB)
unnamed: R8.2, U3.9 (FREQ)
unnamed: C20.1, U3.4 (SS)
VIN: C5.1, C6.1, C10.1, C11.1, C21.1, C28.1, C29.1, D4.1 (K), L3.1, U1.2 (VIN), U1.3 (EN), U2.2 (VIN), U2.3 (EN), U3.2 (VIN), U3.3 (EN)
V_Piezo: C23.1, C24.1, D6.1 (K), J1.5, R9.2, R12.2, R18.2

Notes on the sheet:
1% TOL
PG VOLTAGE DIVIDERS
12V BUCK
LED INDICATORS
Decoupling Caps >50V
Decoupling Caps Place according to data sheet
V_PIEZO BOOST
PWR FLAGS
BATTERY INPUT PROTECTION
Voltage Divider for Power Monitoring
3.3V BUCK
BOARD CONNECTORS

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
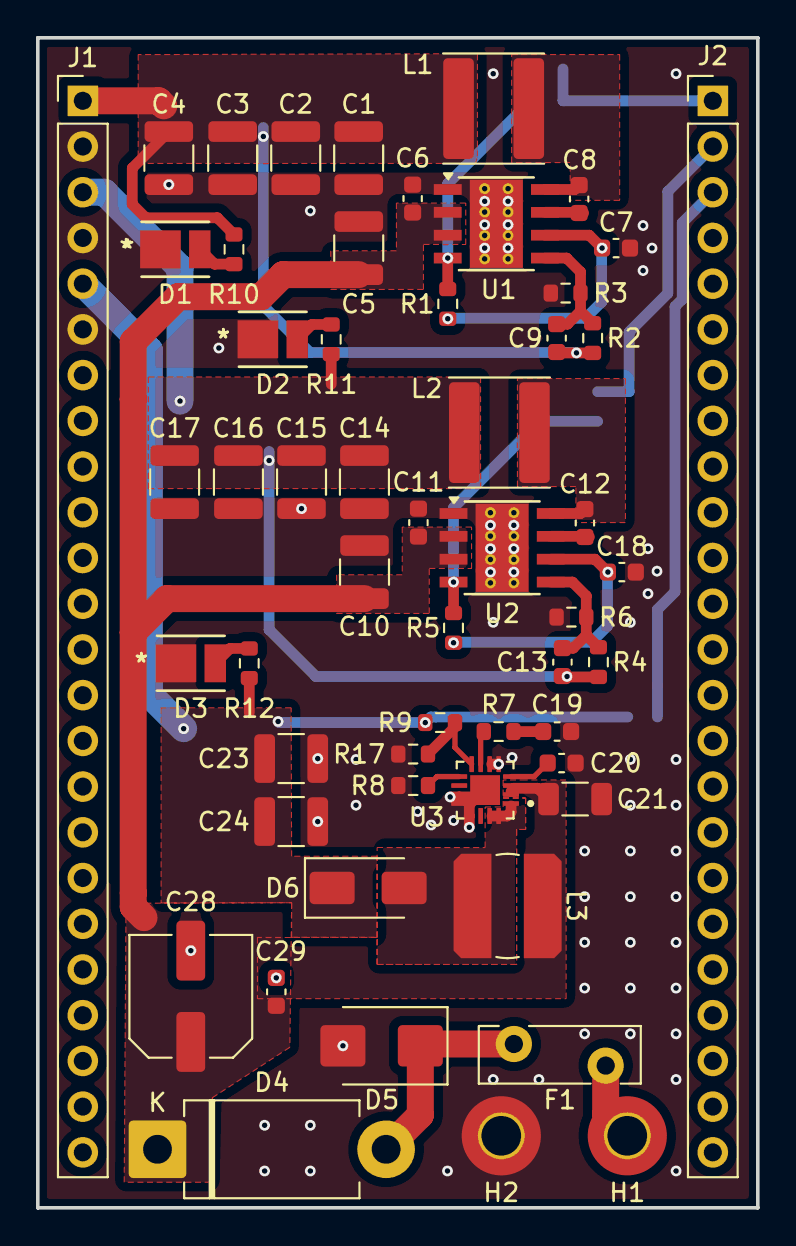
[picture p43: board PWR.kicad_pcb from above]

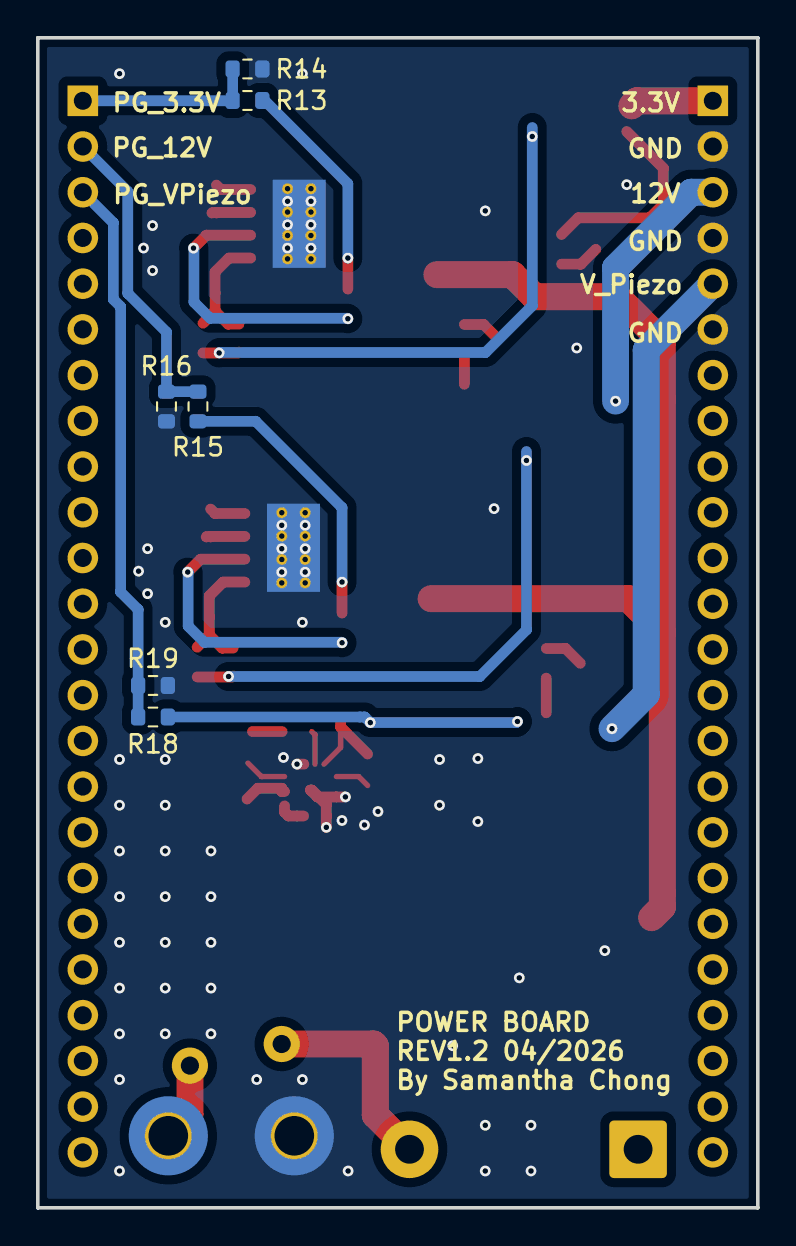
[picture p44: board PWR.kicad_pcb from below]

Board: 2 copper layers, 40.0 x 65.0 mm, 61 parts (6 on the bottom side), 29 nets.
