Astrelis-Nav/SWARM_COMMs/PCB Design/OUTPUTs_Rev_1/OUTPUTs.kicad_pcb

## KiCad design PCB Design/OUTPUTs_Rev_1/OUTPUTs.kicad_pcb (2026-04-16)

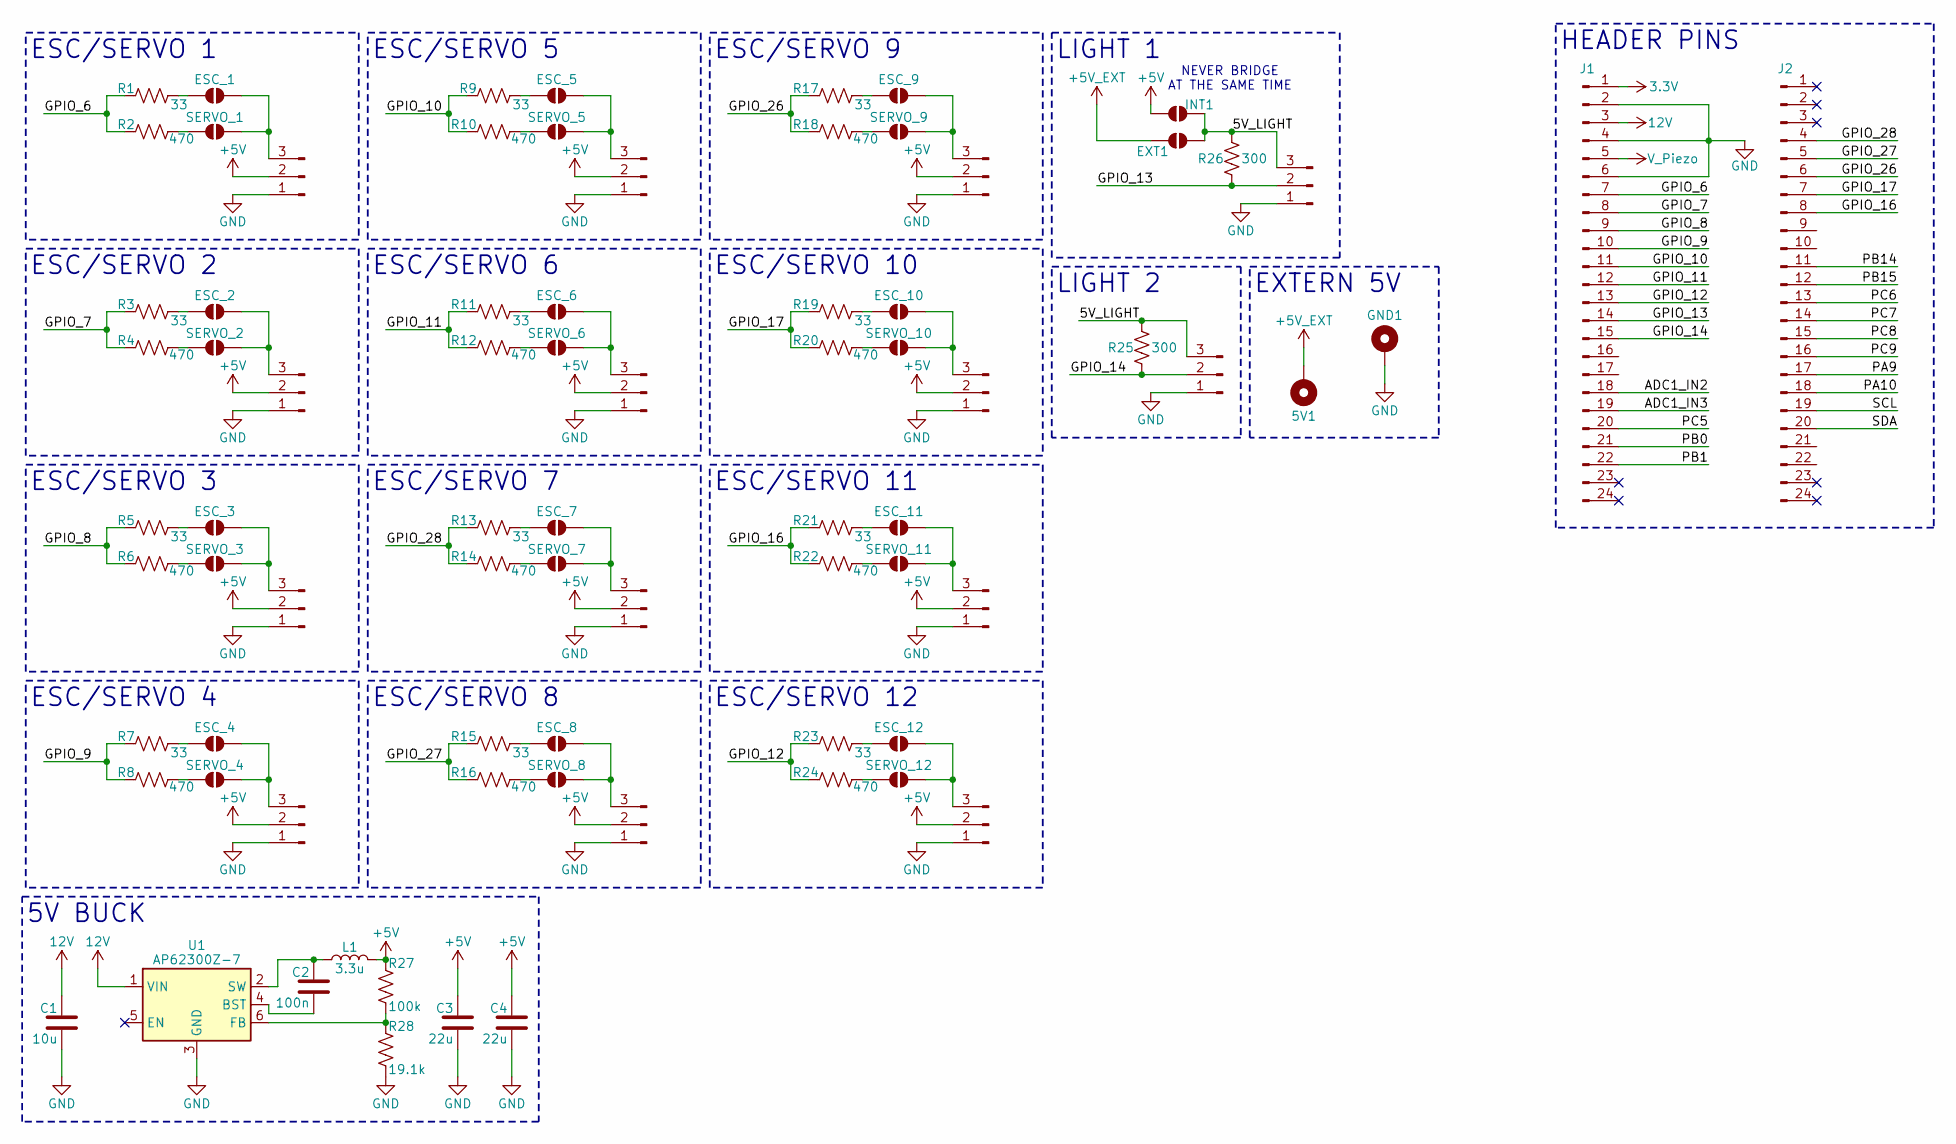
[picture p45: schematic OUTPUTs.kicad_sch, SWARM OUTPUTs BOARD]

Parts:
5V1: MountingHole_Pad; MountingHole_2.2mm_M2_Pad_Via
C1: 10u; C_0603_1608Metric
C2: 100n; C_0603_1608Metric
C3, C4: 22u; C_0603_1608Metric
ESC_1, ESC_2, ESC_3, ESC_4, ESC_5, ESC_6, ESC_7, ESC_8, ESC_9, ESC_10, ESC_11, ESC_12: SolderJumper_2_Open; SolderJumper-2_P1.3mm_Open_TrianglePad1.0x1.5mm
EXT1: SolderJumper_2_Open; SolderJumper-2_P1.3mm_Open_TrianglePad1.0x1.5mm
GND1: MountingHole_Pad; MountingHole_2.2mm_M2_Pad_Via
INT1: SolderJumper_2_Open; SolderJumper-2_P1.3mm_Open_TrianglePad1.0x1.5mm
J1, J2: Conn_01x24_Pin; PinHeader_1x24_P2.54mm_Vertical
L1: 3.3u; L_1008_2520Metric
LIGHT_1, LIGHT_2: Conn_01x03_Pin; PinHeader_1x03_P2.54mm_Vertical
OUT_1, OUT_2, OUT_3, OUT_4, OUT_5, OUT_6, OUT_7, OUT_8, OUT_9, OUT_10, OUT_11, OUT_12: Conn_01x03_Pin; PinHeader_1x03_P2.54mm_Vertical
R1, R3, R5, R7, R9, R11, R13, R15, R17, R19, R21, R23: 33; R_0603_1608Metric
R2, R4, R6, R8, R10, R12, R14, R16, R18, R20, R22, R24: 470; R_0603_1608Metric
R25, R26: 300; R_0603_1608Metric
R27: 100k; R_0603_1608Metric
R28: 19.1k; R_0603_1608Metric
SERVO_1, SERVO_2, SERVO_3, SERVO_4, SERVO_5, SERVO_6, SERVO_7, SERVO_8, SERVO_9, SERVO_10, SERVO_11, SERVO_12: SolderJumper_2_Open; SolderJumper-2_P1.3mm_Open_TrianglePad1.0x1.5mm
U1: AP62300Z-7; SOT-563

Connections:
3.3V: J1.1
12V: C1.1, J1.3, U1.1 (VIN)
+5V: C3.1, C4.1, INT1.1 (A), L1.2, OUT_1.2, OUT_2.2, OUT_3.2, OUT_4.2, OUT_5.2, OUT_6.2, OUT_7.2, OUT_8.2, OUT_9.2, OUT_10.2, OUT_11.2, OUT_12.2, R27.2
+5V_EXT: 5V1.1, EXT1.1 (A)
/5V_LIGHT: EXT1.2 (B), INT1.2 (B), LIGHT_1.3, LIGHT_2.3, R25.2, R26.2
/ADC1_IN2: J1.18
/ADC1_IN3: J1.19
/GPIO_6: J1.7, R1.1, R2.1
/GPIO_7: J1.8, R3.1, R4.1
/GPIO_8: J1.9, R5.1, R6.1
/GPIO_9: J1.10, R7.1, R8.1
/GPIO_10: J1.11, R9.1, R10.1
/GPIO_11: J1.12, R11.1, R12.1
/GPIO_12: J1.13, R23.1, R24.1
/GPIO_13: J1.14, LIGHT_2.2, R26.1
/GPIO_14: J1.15, LIGHT_1.2, R25.1
/GPIO_16: J2.8, R21.1, R22.1
/GPIO_17: J2.7, R19.1, R20.1
/GPIO_26: J2.6, R17.1, R18.1
/GPIO_27: J2.5, R15.1, R16.1
/GPIO_28: J2.4, R13.1, R14.1
/PA9: J2.17
/PA10: J2.18
/PB0: J1.21
/PB1: J1.22
/PB14: J2.11
/PB15: J2.12
/PC5: J1.20
/PC6: J2.13
/PC7: J2.14
/PC8: J2.15
/PC9: J2.16
/SCL: J2.19
/SDA: J2.20
GND: C1.2, C3.2, C4.2, GND1.1, J1.2, J1.4, J1.6, LIGHT_1.1, LIGHT_2.1, OUT_1.1, OUT_2.1, OUT_3.1, OUT_4.1, OUT_5.1, OUT_6.1, OUT_7.1, OUT_8.1, OUT_9.1, OUT_10.1, OUT_11.1, OUT_12.1, R28.1, U1.3 (GND)
unnamed: ESC_1.1 (A), R1.2
unnamed: ESC_1.2 (B), OUT_1.3, SERVO_1.2 (B)
unnamed: ESC_2.1 (A), R3.2
unnamed: ESC_2.2 (B), OUT_2.3, SERVO_2.2 (B)
unnamed: ESC_3.1 (A), R5.2
unnamed: ESC_3.2 (B), OUT_3.3, SERVO_3.2 (B)
unnamed: ESC_4.1 (A), R7.2
unnamed: ESC_4.2 (B), OUT_4.3, SERVO_4.2 (B)
unnamed: ESC_5.1 (A), R9.2
unnamed: ESC_5.2 (B), OUT_5.3, SERVO_5.2 (B)
unnamed: ESC_6.1 (A), R11.2
unnamed: ESC_6.2 (B), OUT_6.3, SERVO_6.2 (B)
unnamed: ESC_7.1 (A), R13.2
unnamed: ESC_7.2 (B), OUT_7.3, SERVO_7.2 (B)
unnamed: ESC_8.1 (A), R15.2
unnamed: ESC_8.2 (B), OUT_8.3, SERVO_8.2 (B)
unnamed: ESC_9.1 (A), R17.2
unnamed: ESC_9.2 (B), OUT_9.3, SERVO_9.2 (B)
unnamed: ESC_10.1 (A), R19.2
unnamed: ESC_10.2 (B), OUT_10.3, SERVO_10.2 (B)
unnamed: ESC_11.1 (A), R21.2
unnamed: ESC_11.2 (B), OUT_11.3, SERVO_11.2 (B)
unnamed: ESC_12.1 (A), R23.2
unnamed: ESC_12.2 (B), OUT_12.3, SERVO_12.2 (B)
unnamed: R2.2, SERVO_1.1 (A)
unnamed: R4.2, SERVO_2.1 (A)
unnamed: R6.2, SERVO_3.1 (A)
unnamed: R8.2, SERVO_4.1 (A)
unnamed: R10.2, SERVO_5.1 (A)
unnamed: R12.2, SERVO_6.1 (A)
unnamed: R14.2, SERVO_7.1 (A)
unnamed: R16.2, SERVO_8.1 (A)
unnamed: R18.2, SERVO_9.1 (A)
unnamed: R20.2, SERVO_10.1 (A)
unnamed: R22.2, SERVO_11.1 (A)
unnamed: R24.2, SERVO_12.1 (A)
unnamed: C2.2, U1.4 (BST)
unnamed: R27.1, R28.2, U1.6 (FB)
unnamed: C2.1, L1.1, U1.2 (SW)
V_Piezo: J1.5

Notes on the sheet:
ESC/SERVO 12
EXTERN 5V
ESC/SERVO 11
5V BUCK
ESC/SERVO 8
ESC/SERVO 3
LIGHT 2
ESC/SERVO 2
ESC/SERVO 1
HEADER PINS
ESC/SERVO 5
NEVER BRIDGE AT THE SAME TIME
ESC/SERVO 4
ESC/SERVO 7
ESC/SERVO 9
ESC/SERVO 10
LIGHT 1
ESC/SERVO 6

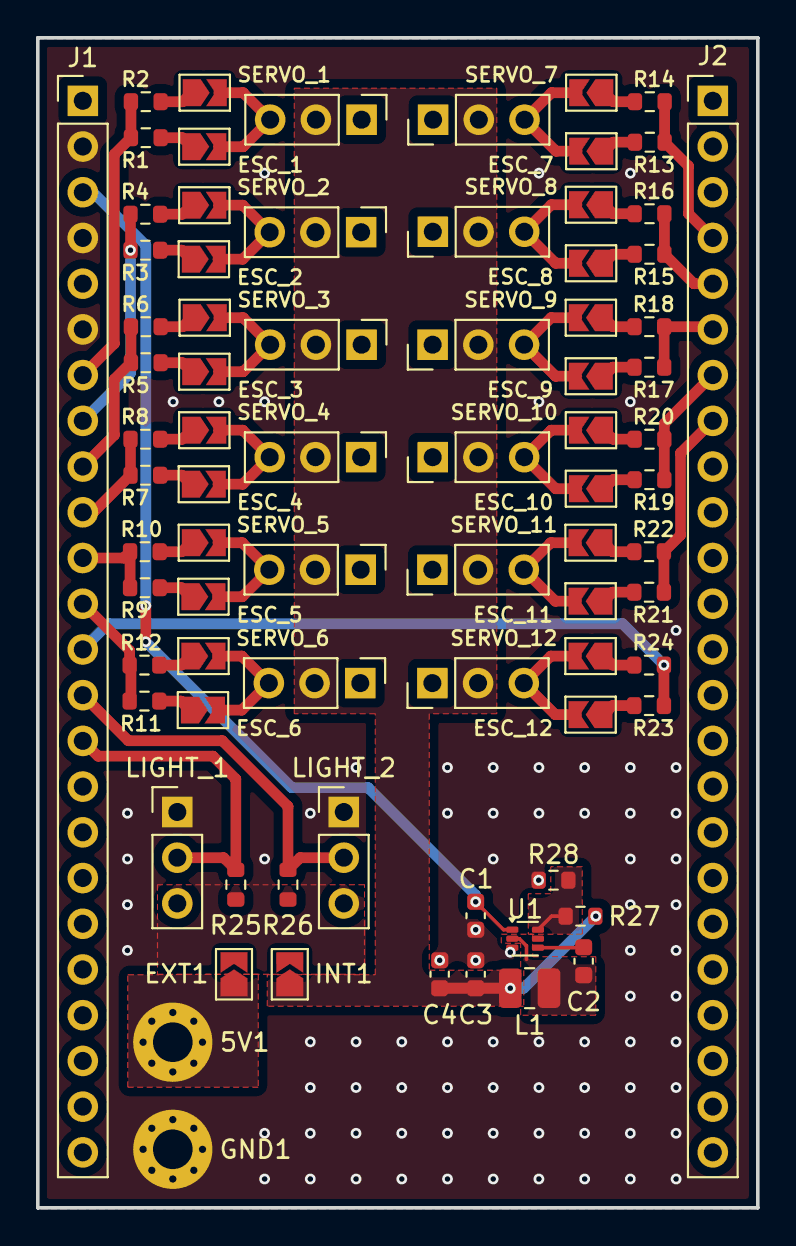
[picture p46: board OUTPUTs.kicad_pcb from above]

Board: 2 copper layers, 40.0 x 65.0 mm, 78 parts (0 on the bottom side), 58 nets.
