Astrelis-Nav/SWARM_COMMs/PCB Design/COMMs_Rev_2/TX_Rev_2/TX.kicad_pcb

## KiCad design PCB Design/COMMs_Rev_2/TX_Rev_2/TX.kicad_pcb (2026-03-30)

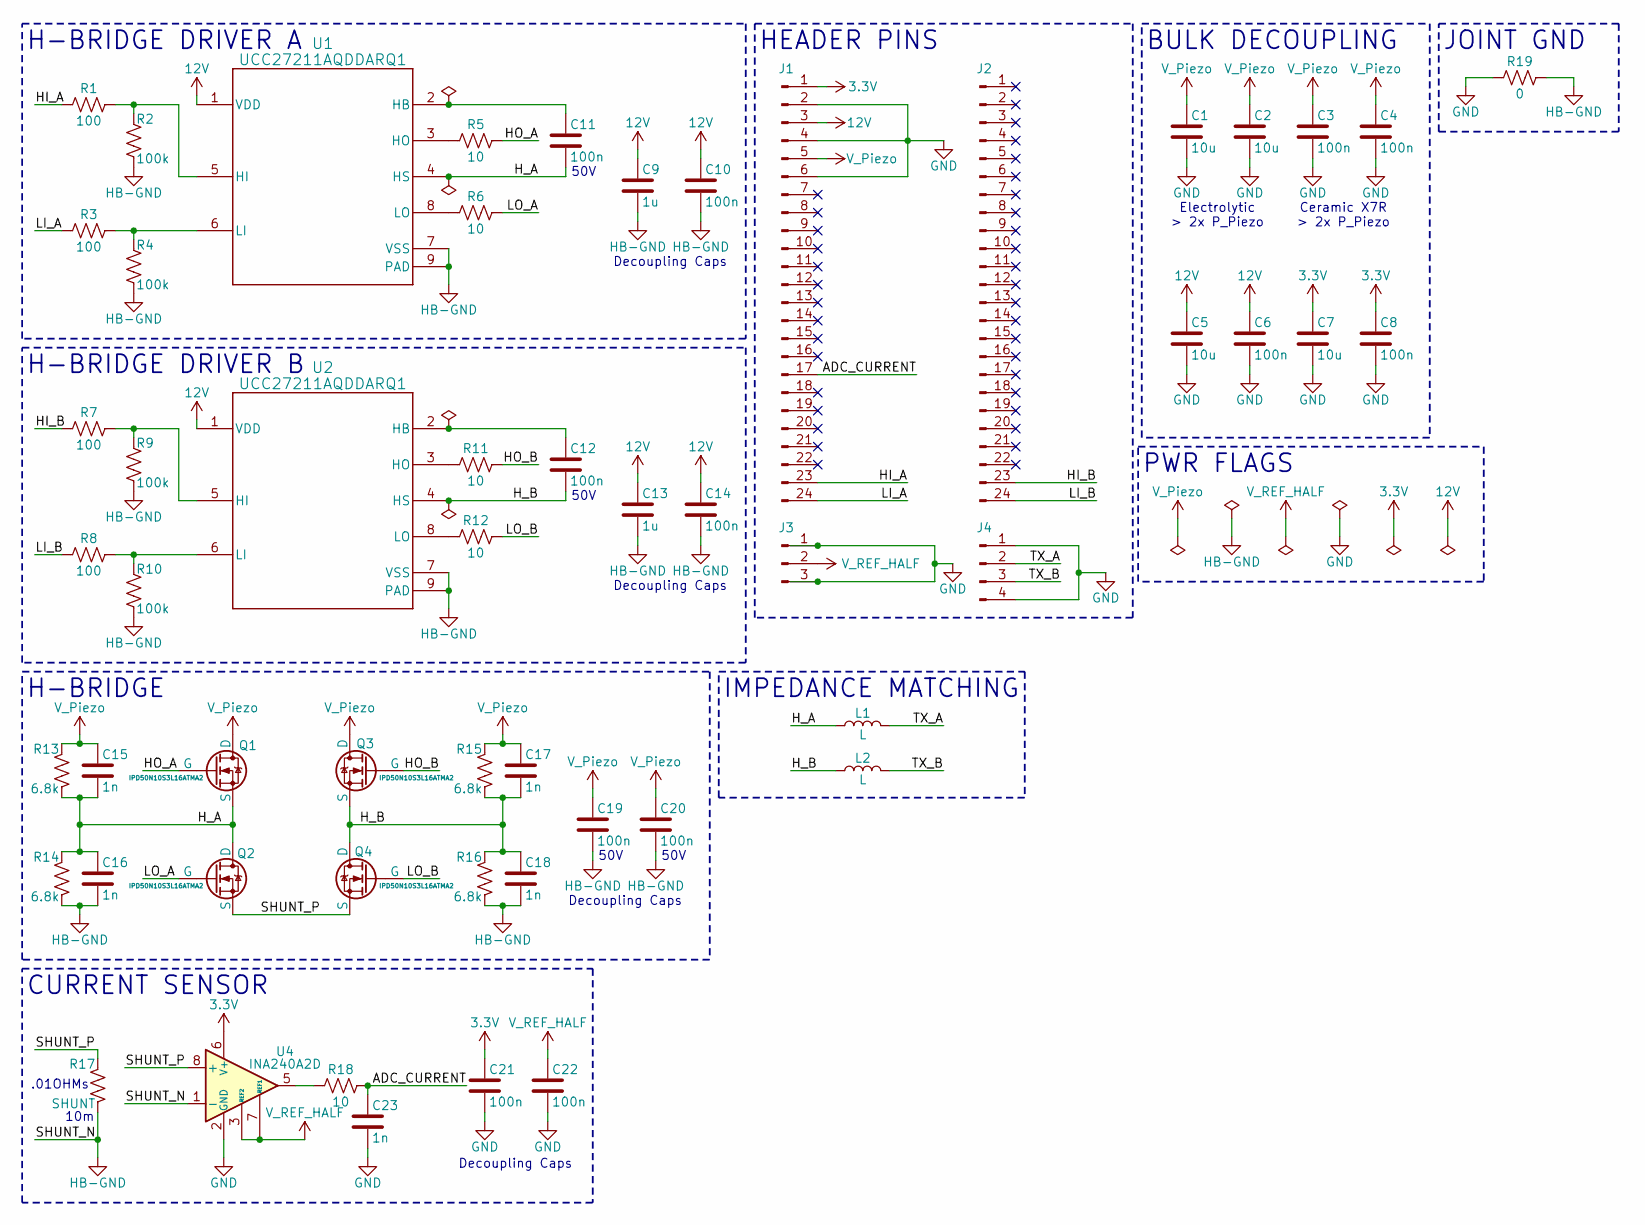
[picture p47: schematic TX.kicad_sch, SWARM TX COMMs]

Parts:
C1, C2, C5, C7: 10u; C_1206_3216Metric
C3, C4, C6, C8, C10, C11, C12, C14, C19, C20, C21, C22: 100n; C_0603_1608Metric
C9, C13: 1u; C_0603_1608Metric
C15, C16, C17, C18, C23: 1n; C_0603_1608Metric
J1, J2: Conn_01x24_Pin; PinHeader_1x24_P2.54mm_Vertical
J3: Conn_01x03_Pin; PinHeader_1x03_P2.54mm_Vertical
J4: Conn_01x04_Pin; PinHeader_1x04_P2.54mm_Vertical
L1, L2: L; L_Wuerth_MAPI-5030
Q1, Q2, Q3, Q4: IPD50N10S3L16ATMA2; TO-252-3_TabPin2
R1, R3, R7, R8: 100; R_0603_1608Metric
R2, R4, R9, R10: 100k; R_0603_1608Metric
R5, R6, R11, R12, R18: 10; R_0603_1608Metric
R13, R14, R15, R16: 6.8k; R_0603_1608Metric
R17: SHUNT; R_2512_6332Metric
R19: 0; R_0603_1608Metric
U1, U2: UCC27211AQDDARQ1; DDA0008E_L
U4: INA240A2D; SOIC-8_3.9x4.9mm_P1.27mm

Connections:
3.3V: C7.1, C8.1, C21.1, J1.1, U4.6 (V+)
12V: C5.1, C6.1, C9.1, C10.1, C13.1, C14.1, J1.3, U1.1 (VDD), U2.1 (VDD)
/ADC_CURRENT: C23.1, J1.17, R18.2
/HI_A: J1.23, R1.1
/HI_B: J2.23, R7.1
/HO_A: Q1.2 (G), R5.2
/HO_B: Q3.2 (G), R11.2
/H_A: C11.2, C15.2, C16.1, L1.1, Q1.3 (S), Q2.1 (D), R13.2, R14.1, U1.4 (HS)
/H_B: C12.2, C17.2, C18.1, L2.1, Q3.3 (S), Q4.1 (D), R15.2, R16.1, U2.4 (HS)
/LI_A: J1.24, R3.1
/LI_B: J2.24, R8.1
/LO_A: Q2.2 (G), R6.2
/LO_B: Q4.2 (G), R12.2
/SHUNT_P: Q2.3 (S), Q4.3 (S), R17.1, U4.8 (+)
/TX_A: J4.2, L1.2
/TX_B: J4.3, L2.2
GND: C1.2, C2.2, C3.2, C4.2, C5.2, C6.2, C7.2, C8.2, C21.2, C22.2, C23.2, J1.2, J1.4, J1.6, J3.1, J3.3, J4.1, J4.4, R19.1, U4.2 (GND), U4.4 (GND)
HB-GND: C9.2, C10.2, C13.2, C14.2, C16.2, C18.2, C19.2, C20.2, R2.2, R4.2, R9.2, R10.2, R14.2, R16.2, R17.2, R19.2, U1.7 (VSS), U1.9 (PAD), U2.7 (VSS), U2.9 (PAD), U4.1 (-)
unnamed: R18.1, U4.5
unnamed: C11.1, U1.2 (HB)
unnamed: R1.2, R2.1, U1.5 (HI)
unnamed: R5.1, U1.3 (HO)
unnamed: R3.2, R4.1, U1.6 (LI)
unnamed: R6.1, U1.8 (LO)
unnamed: C12.1, U2.2 (HB)
unnamed: R7.2, R9.1, U2.5 (HI)
unnamed: R11.1, U2.3 (HO)
unnamed: R8.2, R10.1, U2.6 (LI)
unnamed: R12.1, U2.8 (LO)
V_Piezo: C1.1, C2.1, C3.1, C4.1, C15.1, C17.1, C19.1, C20.1, J1.5, Q1.1 (D), Q3.1 (D), R13.1, R15.1
V_REF_HALF: C22.1, J3.2, U4.3 (REF2), U4.7 (REF1)

Notes on the sheet:
50V
Decoupling Caps
.01OHMs
Electrolytic > 2x P_Piezo
PWR FLAGS
10m
H-BRIDGE
H-BRIDGE DRIVER A
IMPEDANCE MATCHING
BULK DECOUPLING
JOINT GND
CURRENT SENSOR
HEADER PINS
H-BRIDGE DRIVER B
Ceramic X7R > 2x P_Piezo

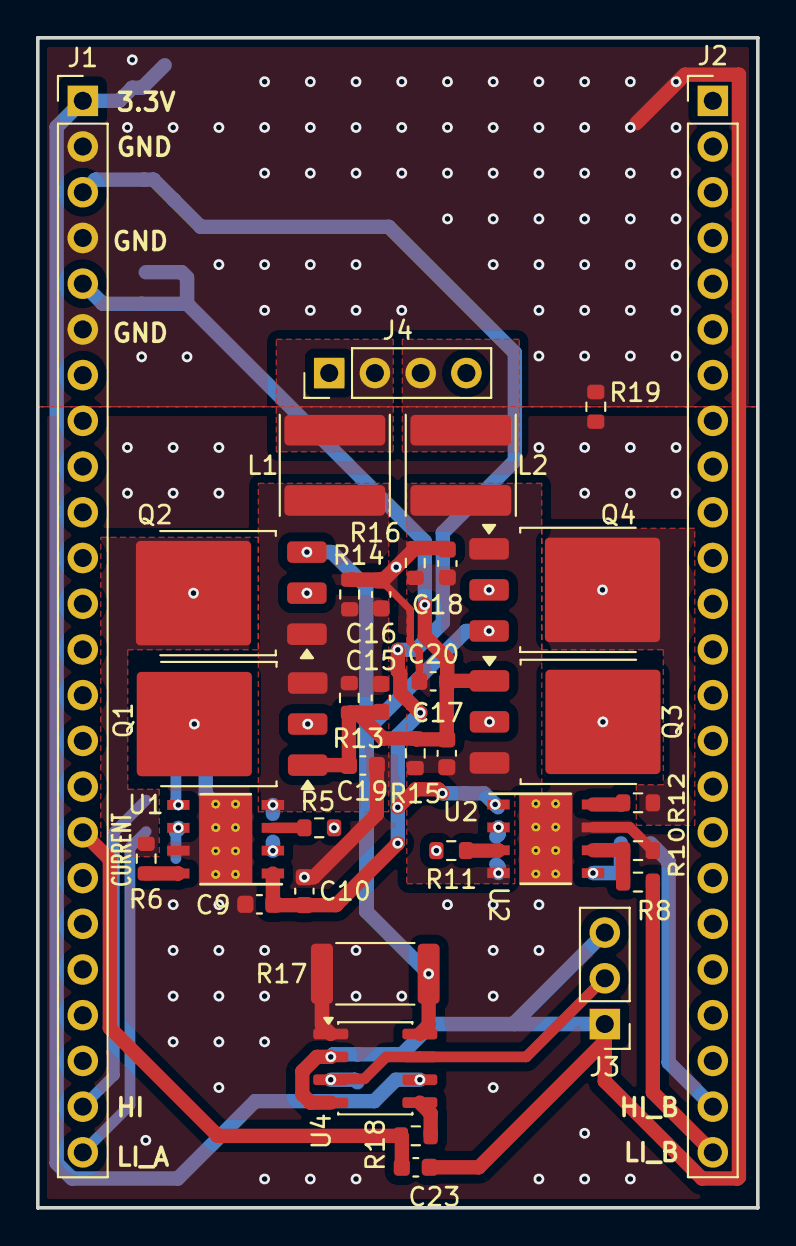
[picture p48: board TX.kicad_pcb from above]

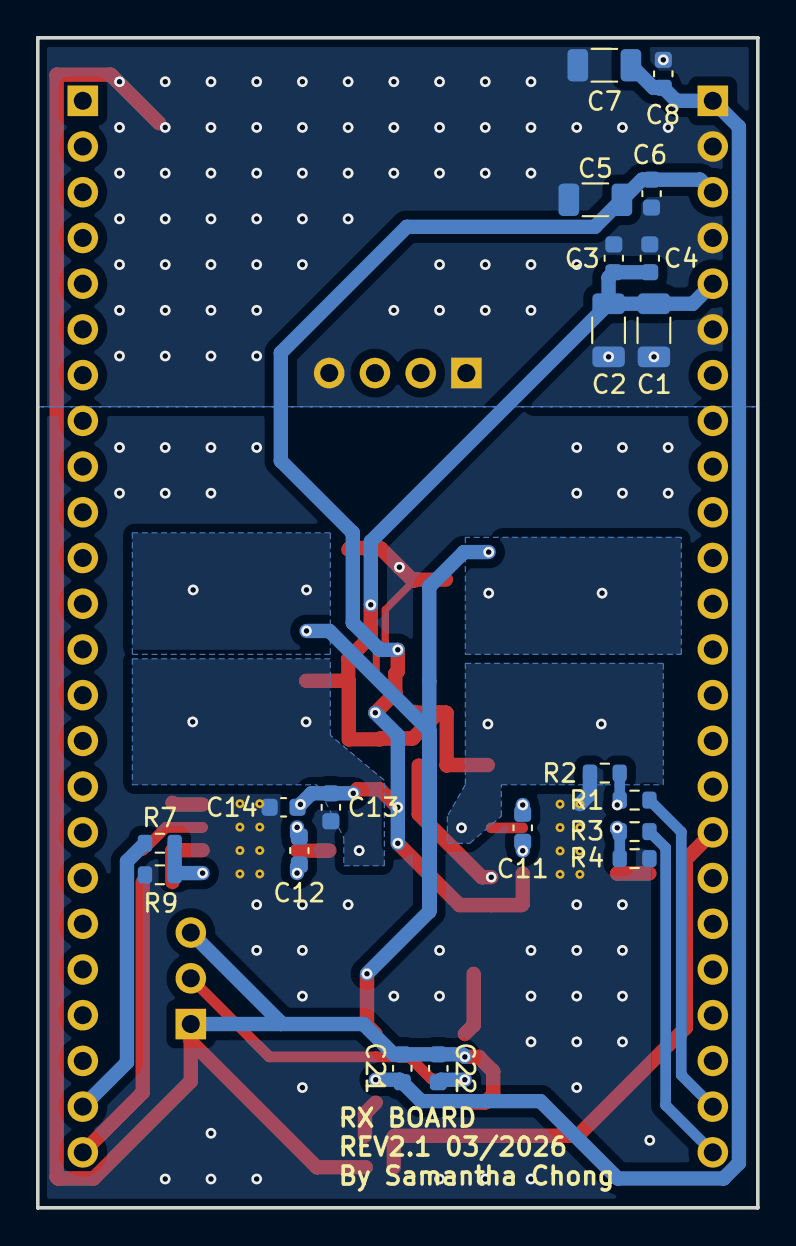
[picture p49: board TX.kicad_pcb from below]

Board: 2 copper layers, 40.0 x 65.0 mm, 55 parts (20 on the bottom side), 31 nets.
