Astrelis-Nav/SWARM_COMMs/PCB Design/SENSOR_Rev_1/SENSOR.kicad_pcb

## KiCad design PCB Design/SENSOR_Rev_1/SENSOR.kicad_pcb (2026-03-30)

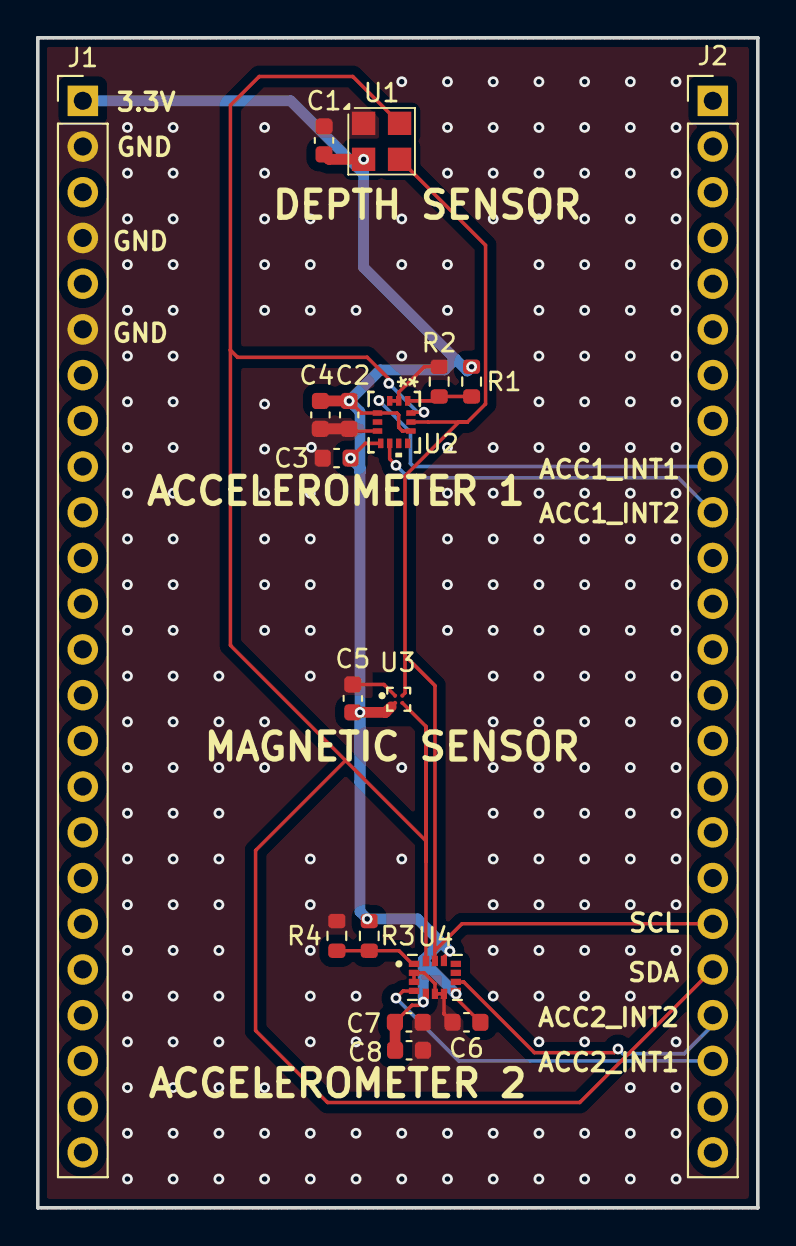
[picture p50: board SENSOR.kicad_pcb from above]

Board: 2 copper layers, 40.0 x 65.0 mm, 18 parts (0 on the bottom side), 10 nets.

Parts:
C1, C2, C3, C6, C7: 100n; C_0603_1608Metric
C4, C8: 10u; C_0603_1608Metric
C5: 2.2u; C_0603_1608Metric
J1, J2: Conn_01x24_Pin; PinHeader_1x24_P2.54mm_Vertical
R1, R2, R3, R4: 0; R_0603_1608Metric
U1: MS583730BA01-50; TE_MS5837-xxBA
U2: ASM330LHHXG1TR; LGA14_2P5X3_STM
U3: MMC5603NJ; XDCR_MMC5603NJ
U4: LSM6DSO32TR; XDCR_LSM6DSO32TR

Connections:
3.3V: C1.1, C2.1, C3.1, C4.1, C5.1, C6.1, C7.1, C8.1, J1.1, R1.2, R3.2, U1.2 (VDD), U2.5 (VDD_IO), U2.8 (VDD_IO), U2.12 (CS), U3.B1 (VDD), U4.5 (VDDIO), U4.8 (VDD), U4.12 (CS)
/ACC1_ADD: R1.1, R2.1, U2.1 (SDO/SA0)
/ACC1_INT1: J2.9, U2.4 (INT1)
/ACC1_INT2: J2.10, U2.9 (INT2)
/ACC2_ADD: R3.1, R4.1, U4.1 (SDO/SA0)
/ACC2_INT1: J2.22, U4.4 (INT1)
/ACC2_INT2: J2.21, U4.9 (INT2)
/SCL: J2.19, U1.3 (SCL), U2.13 (SCL), U3.A2 (SCL), U4.13 (SCL)
/SDA: J2.20, U1.4 (SDA), U2.14 (SDA), U3.B2 (SDA), U4.14 (SDA)
GND: C1.2, C2.2, C3.2, C4.2, C5.2, C6.2, C7.2, C8.2, J1.2, J1.4, J1.6, R2.2, R4.2, U1.1 (GND), U2.2 (MSDA), U2.3 (MSCL), U2.7 (GND), U3.A1 (VSA), U4.2 (SDX), U4.3 (SCX), U4.6 (GND), U4.7 (GND)
