Astrelis-Nav/SWARM_COMMs/PCB Design/COMMs_Rev_1/COMMs.kicad_pcb

## KiCad design PCB Design/COMMs_Rev_1/COMMs.kicad_pcb (2026-02-10, an earlier design)

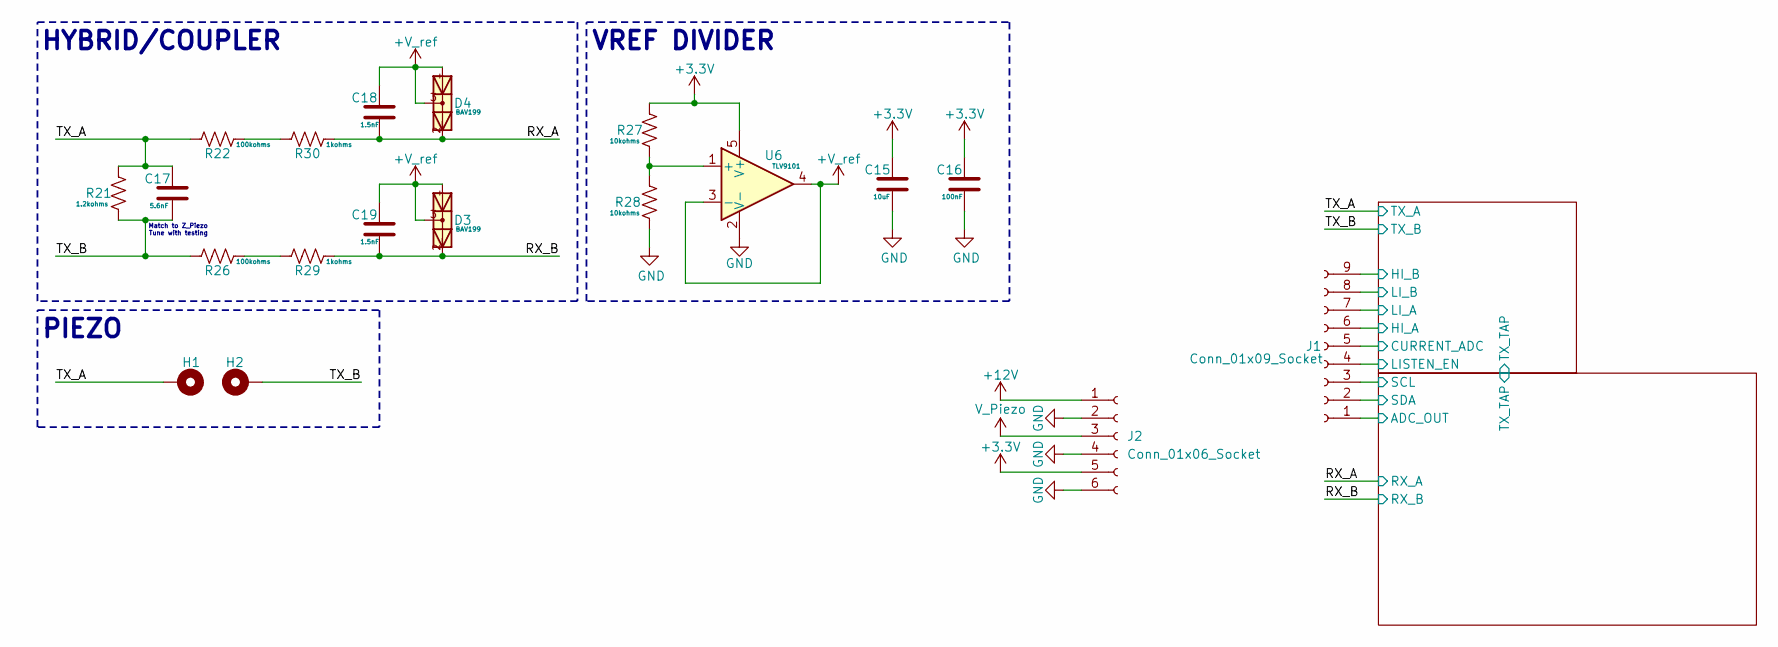
[picture p51: schematic COMMs.kicad_sch]

Parts:
C15: 10uF; C_0603_1608Metric
C16: 100nF; C_0603_1608Metric
C17: 5.6nF; C_0603_1608Metric
C18, C19: 1.5nF; C_0603_1608Metric
D3, D4: BAV199; SOT-23-3
H1, H2: MountingHole_Pad; MountingHole_2.7mm_M2.5_Pad_TopBottom
J1: Conn_01x09_Socket; PinHeader_1x09_P2.54mm_Vertical
J2: Conn_01x06_Socket; PinHeader_1x06_P2.54mm_Vertical
R21: 1.2kohms; R_0603_1608Metric
R22, R26: 100kohms; R_0603_1608Metric
R27, R28: 10kohms; R_0603_1608Metric
R29, R30: 1kohms; R_0603_1608Metric
U6: TLV9101; SOT-353_SC-70-5

Connections:
+3.3V: C15.1, C16.1, J2.5, R27.1, U6.5 (V+); also elsewhere on the board
+12V: J2.1; also elsewhere on the board
+V_ref: C18.1, C19.1, D3.1, D3.3, D4.1, D4.3, U6.3 (-), U6.4; also elsewhere on the board
/RX/ADC_OUT: J1.1; also elsewhere on the board
/RX/SCL: J1.3; also elsewhere on the board
/RX/SDA: J1.2; also elsewhere on the board
/RX_A: C18.2, D4.2, R30.2; also elsewhere on the board
/RX_B: C19.2, D3.2, R29.2; also elsewhere on the board
/TX/CURRENT_ADC: J1.5; also elsewhere on the board
/TX/HI_A: J1.6; also elsewhere on the board
/TX/HI_B: J1.9; also elsewhere on the board
/TX/LISTEN_EN: J1.4; also elsewhere on the board
/TX/LI_A: J1.7; also elsewhere on the board
/TX/LI_B: J1.8; also elsewhere on the board
/TX_A: C17.1, H1.1, R21.2, R22.1; also elsewhere on the board
/TX_B: C17.2, H2.1, R21.1, R26.1; also elsewhere on the board
GND: C15.2, C16.2, J2.2, J2.4, J2.6, R28.2, U6.2 (V-); also elsewhere on the board
unnamed: R22.2, R30.1
unnamed: R26.2, R29.1
unnamed: R27.2, R28.1, U6.1 (+)
V_Piezo: J2.3; also elsewhere on the board

Notes on the sheet:
HYBRID/COUPLER
VREF DIVIDER
Match to Z_Piezo Tune with testing
PIEZO
