Astrelis-Nav/SWARM_COMMs/PCB Design/COMMs_Rev_1/COMMs.kicad_pcb

## KiCad design PCB Design/COMMs_Rev_1/COMMs.kicad_pcb (continued)

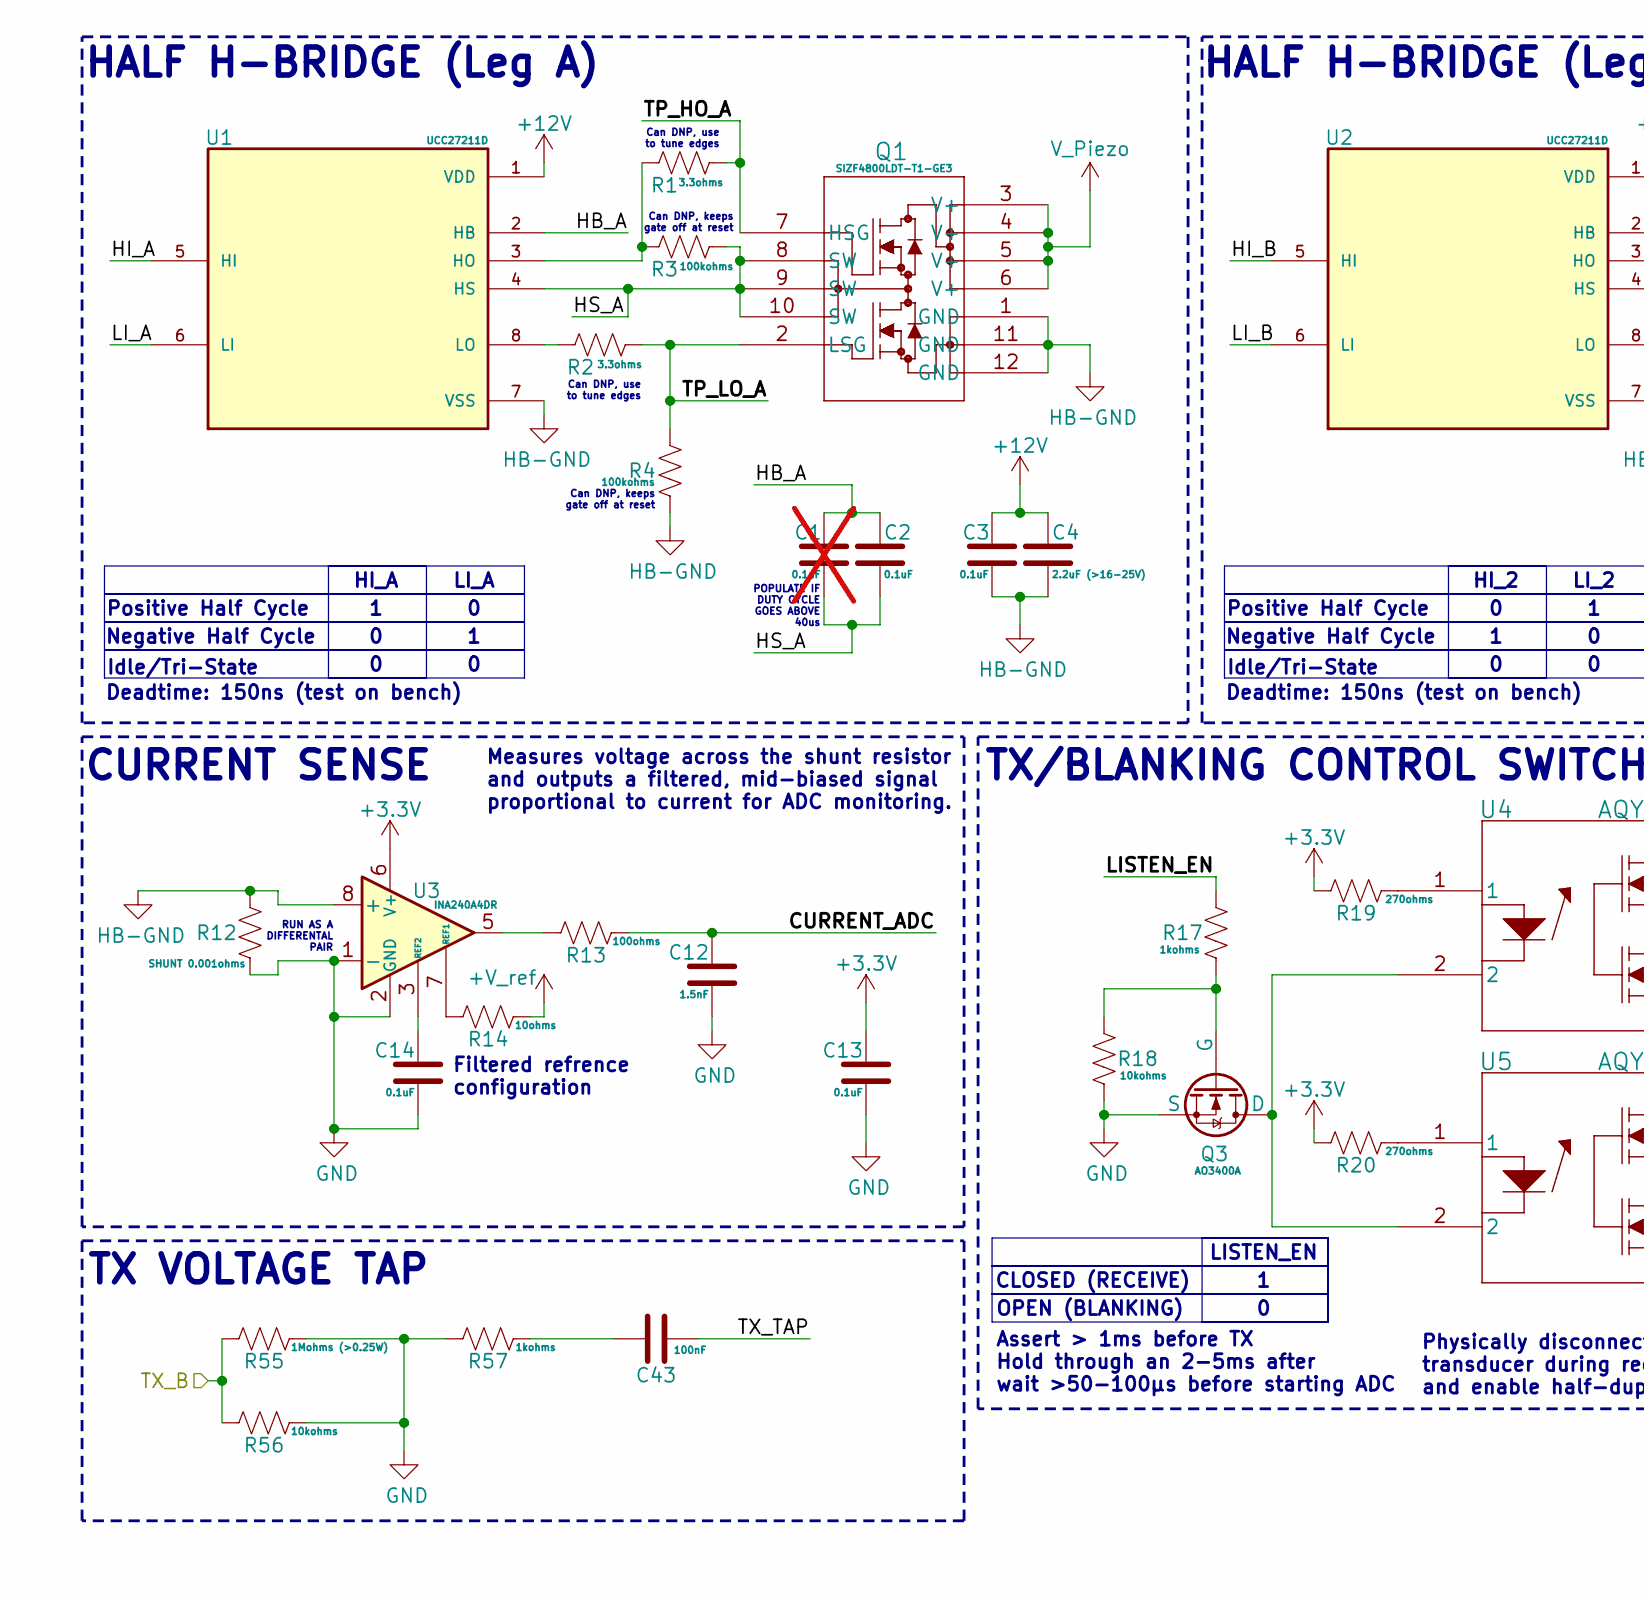
[picture p52: schematic TX.kicad_sch, part in row 1, column 1]

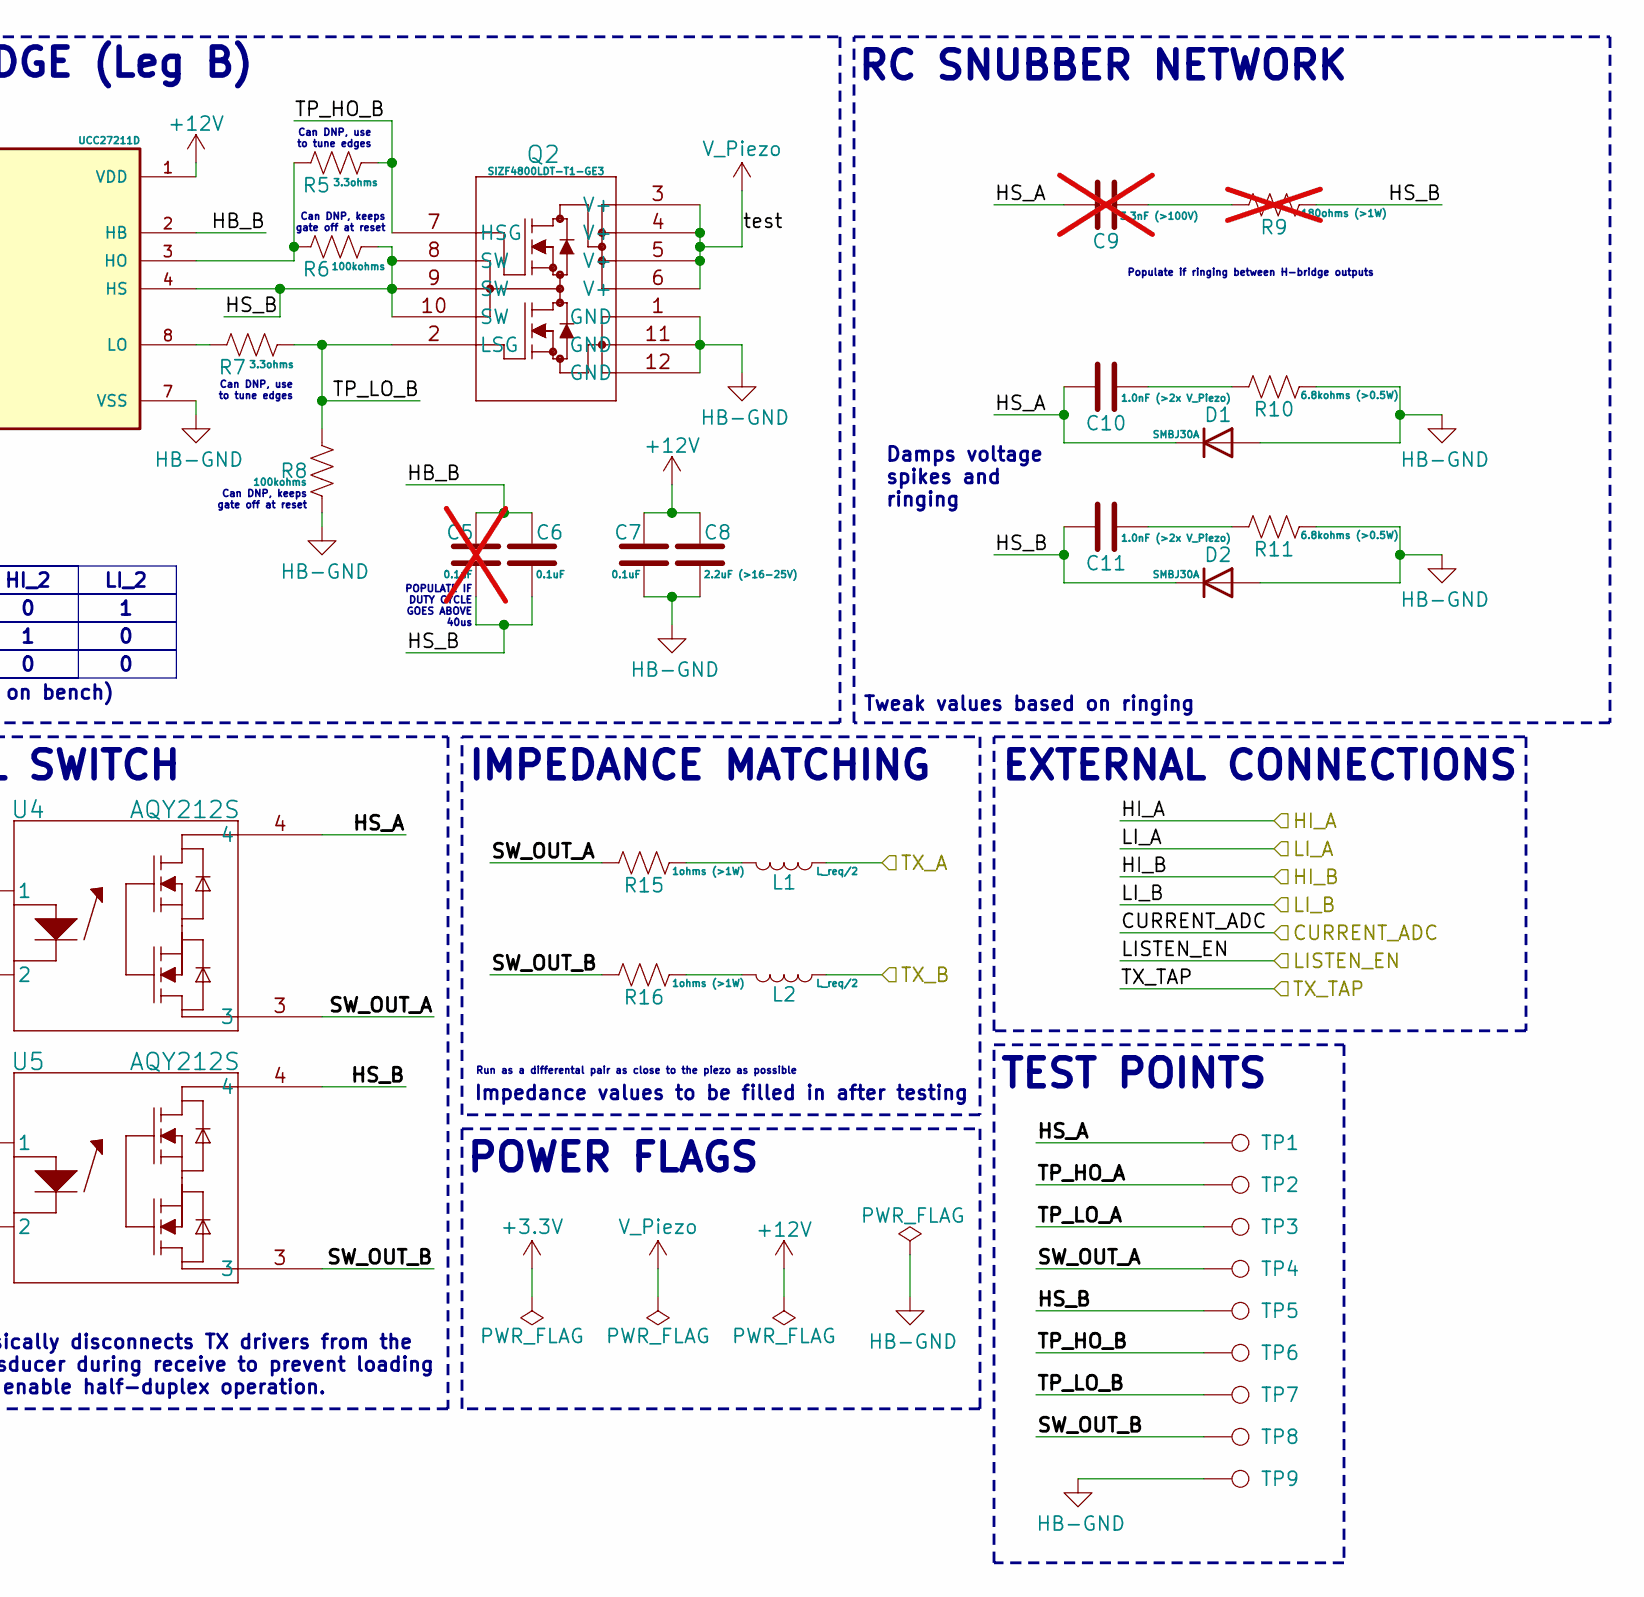
[picture p53: schematic TX.kicad_sch, part in row 1, column 2]

Parts:
C1, C5: 0.1uF; C_0603_1608Metric; not fitted
C2, C3, C6, C7, C13, C14: 0.1uF; C_0603_1608Metric
C4, C8: 2.2uF (>16-25V); C_0603_1608Metric
C9: 3.3nF (>100V); C_0603_1608Metric; not fitted
C10, C11: 1.0nF (>2x V_Piezo); C_0603_1608Metric
C12: 1.5nF; C_0603_1608Metric
C43: 100nF; C_0603_1608Metric
D1, D2: SMBJ30A; D_SMB
L1, L2: L_req/2; L_1210_3225Metric
Q1, Q2: SIZF4800LDT-T1-GE3; POWERPAIR_3X3FS_VIS
Q3: AO3400A; TSOT-23
R1, R2, R5, R7: 3.3ohms; R_0603_1608Metric
R3, R4, R6, R8: 100kohms; R_0603_1608Metric
R9: 180ohms (>1W); R_2512_6332Metric; not fitted
R10, R11: 6.8kohms (>0.5W); R_1206_3216Metric
R12: SHUNT 0.001ohms; R_2512_6332Metric
R13: 100ohms; R_0603_1608Metric
R14: 10ohms; R_0603_1608Metric
R15, R16: 1ohms (>1W); R_2512_6332Metric
R17, R57: 1kohms; R_0603_1608Metric
R18, R56: 10kohms; R_0603_1608Metric
R19, R20: 270ohms; R_0603_1608Metric
R55: 1Mohms (>0.25W); R_1206_3216Metric
TP1, TP2, TP3, TP4, TP5, TP6, TP7, TP8, TP9: TestPoint; TestPoint_Pad_D1.0mm
U1, U2: UCC27211D; SOIC127P599X175-8N; PARTREV F
U3: INA240A4DR; SOIC-8_3.9x4.9mm_P1.27mm
U4, U5: AQY212S; SOP4_PAN

Connections:
+3.3V: C13.1, R19.1, R20.1, U3.6 (V+); also elsewhere on the board
+12V: C3.1, C4.1, C7.1, C8.1, U1.1 (VDD), U2.1 (VDD); also elsewhere on the board
+V_ref: R14.1; also elsewhere on the board
/RX/TX_TAP: C43.2; also elsewhere on the board
/TX/CURRENT_ADC: C12.1, R13.2; also elsewhere on the board
/TX/HB_A: C1.1, C2.1, U1.2 (HB)
/TX/HB_B: C5.1, C6.1, U2.2 (HB)
/TX/HI_A: U1.5 (HI); also elsewhere on the board
/TX/HI_B: U2.5 (HI); also elsewhere on the board
/TX/HS_A: C1.2, C2.2, C9.1, C10.1, D1.1 (K), Q1.8 (SW), Q1.9 (SW), Q1.10 (SW), R3.2, TP1.1, U1.4 (HS), U4.4
/TX/HS_B: C5.2, C6.2, C11.1, D2.1 (K), Q2.8 (SW), Q2.9 (SW), Q2.10 (SW), R6.2, R9.2, TP5.1, U2.4 (HS), U5.4
/TX/LISTEN_EN: R17.2; also elsewhere on the board
/TX/LI_A: U1.6 (LI); also elsewhere on the board
/TX/LI_B: U2.6 (LI); also elsewhere on the board
/TX/SW_OUT_A: R15.1, TP4.1, U4.3
/TX/SW_OUT_B: R16.1, TP8.1, U5.3
/TX/TP_HO_A: Q1.7 (HSG), R1.2, TP2.1
/TX/TP_HO_B: Q2.7 (HSG), R5.2, TP6.1
/TX/TP_LO_A: Q1.2 (LSG), R2.2, R4.2, TP3.1
/TX/TP_LO_B: Q2.2 (LSG), R7.2, R8.2, TP7.1
/TX_A: L1.1; also elsewhere on the board
/TX_B: L2.1, R55.1, R56.1; also elsewhere on the board
GND: C12.2, C13.2, C14.2, Q3.3 (S), R12.1, R18.1, R55.2, R56.2, R57.1, U3.1 (-), U3.2 (GND), U3.4 (GND); also elsewhere on the board
HB-GND: C3.2, C4.2, C7.2, C8.2, D1.2 (A), D2.2 (A), Q1.1 (GND), Q1.11 (GND), Q1.12 (GND), Q2.1 (GND), Q2.11 (GND), Q2.12 (GND), R4.1, R8.1, R10.2, R11.2, R12.2, TP9.1, U1.7 (VSS), U2.7 (VSS), U3.8 (+)
unnamed: C9.2, R9.1
unnamed: C10.2, R10.1
unnamed: C11.2, R11.1
unnamed: C43.1, R57.2
unnamed: L1.2, R15.2
unnamed: L2.2, R16.2
unnamed: Q3.1 (D), U4.2, U5.2
unnamed: Q3.2 (G), R17.1, R18.2
unnamed: R13.1, U3.5
unnamed: R19.2, U4.1
unnamed: R20.2, U5.1
unnamed: R1.1, R3.1, U1.3 (HO)
unnamed: R2.1, U1.8 (LO)
unnamed: R5.1, R6.1, U2.3 (HO)
unnamed: R7.1, U2.8 (LO)
unnamed: R14.2, U3.7 (REF1)
unnamed: C14.1, U3.3 (REF2)
V_Piezo: Q1.3 (V+), Q1.4 (V+), Q1.5 (V+), Q1.6 (V+), Q2.3 (V+), Q2.4 (V+), Q2.5 (V+), Q2.6 (V+); also elsewhere on the board

Notes on the sheet:
Can DNP, use to tune edges
Run as a differental pair as close to the piezo as possible
POPULATE IF DUTY CYCLE GOES ABOVE 40us
LI_2
Can DNP, keeps gate off at reset
Filtered refrence configuration
CLOSED (RECEIVE)
RC SNUBBER NETWORK
Idle/Tri-State
HI_2
Populate if ringing between H-bridge outputs
LI_A
Negative Half Cycle
POWER FLAGS
Deadtime: 150ns (test on bench)
HI_A
Damps voltage spikes and ringing
TX VOLTAGE TAP
Positive Half Cycle
RUN AS A DIFFERENTAL PAIR
Physically disconnects TX drivers from the transducer during receive to prevent loading and enable half-duplex operation.
HALF H-BRIDGE (Leg A)
LISTEN_EN
IMPEDANCE MATCHING
TEST POINTS
EXTERNAL CONNECTIONS
CURRENT SENSE
OPEN (BLANKING)
Tweak values based on ringing
TX/BLANKING CONTROL SWITCH
Impedance values to be filled in after testing
HALF H-BRIDGE (Leg B)
Assert > 1ms before TX Hold through an 2-5ms after wait >50-100µs before starting ADC
Measures voltage across the shunt resistor and outputs a filtered, mid-biased signal proportional to current for ADC monitoring.

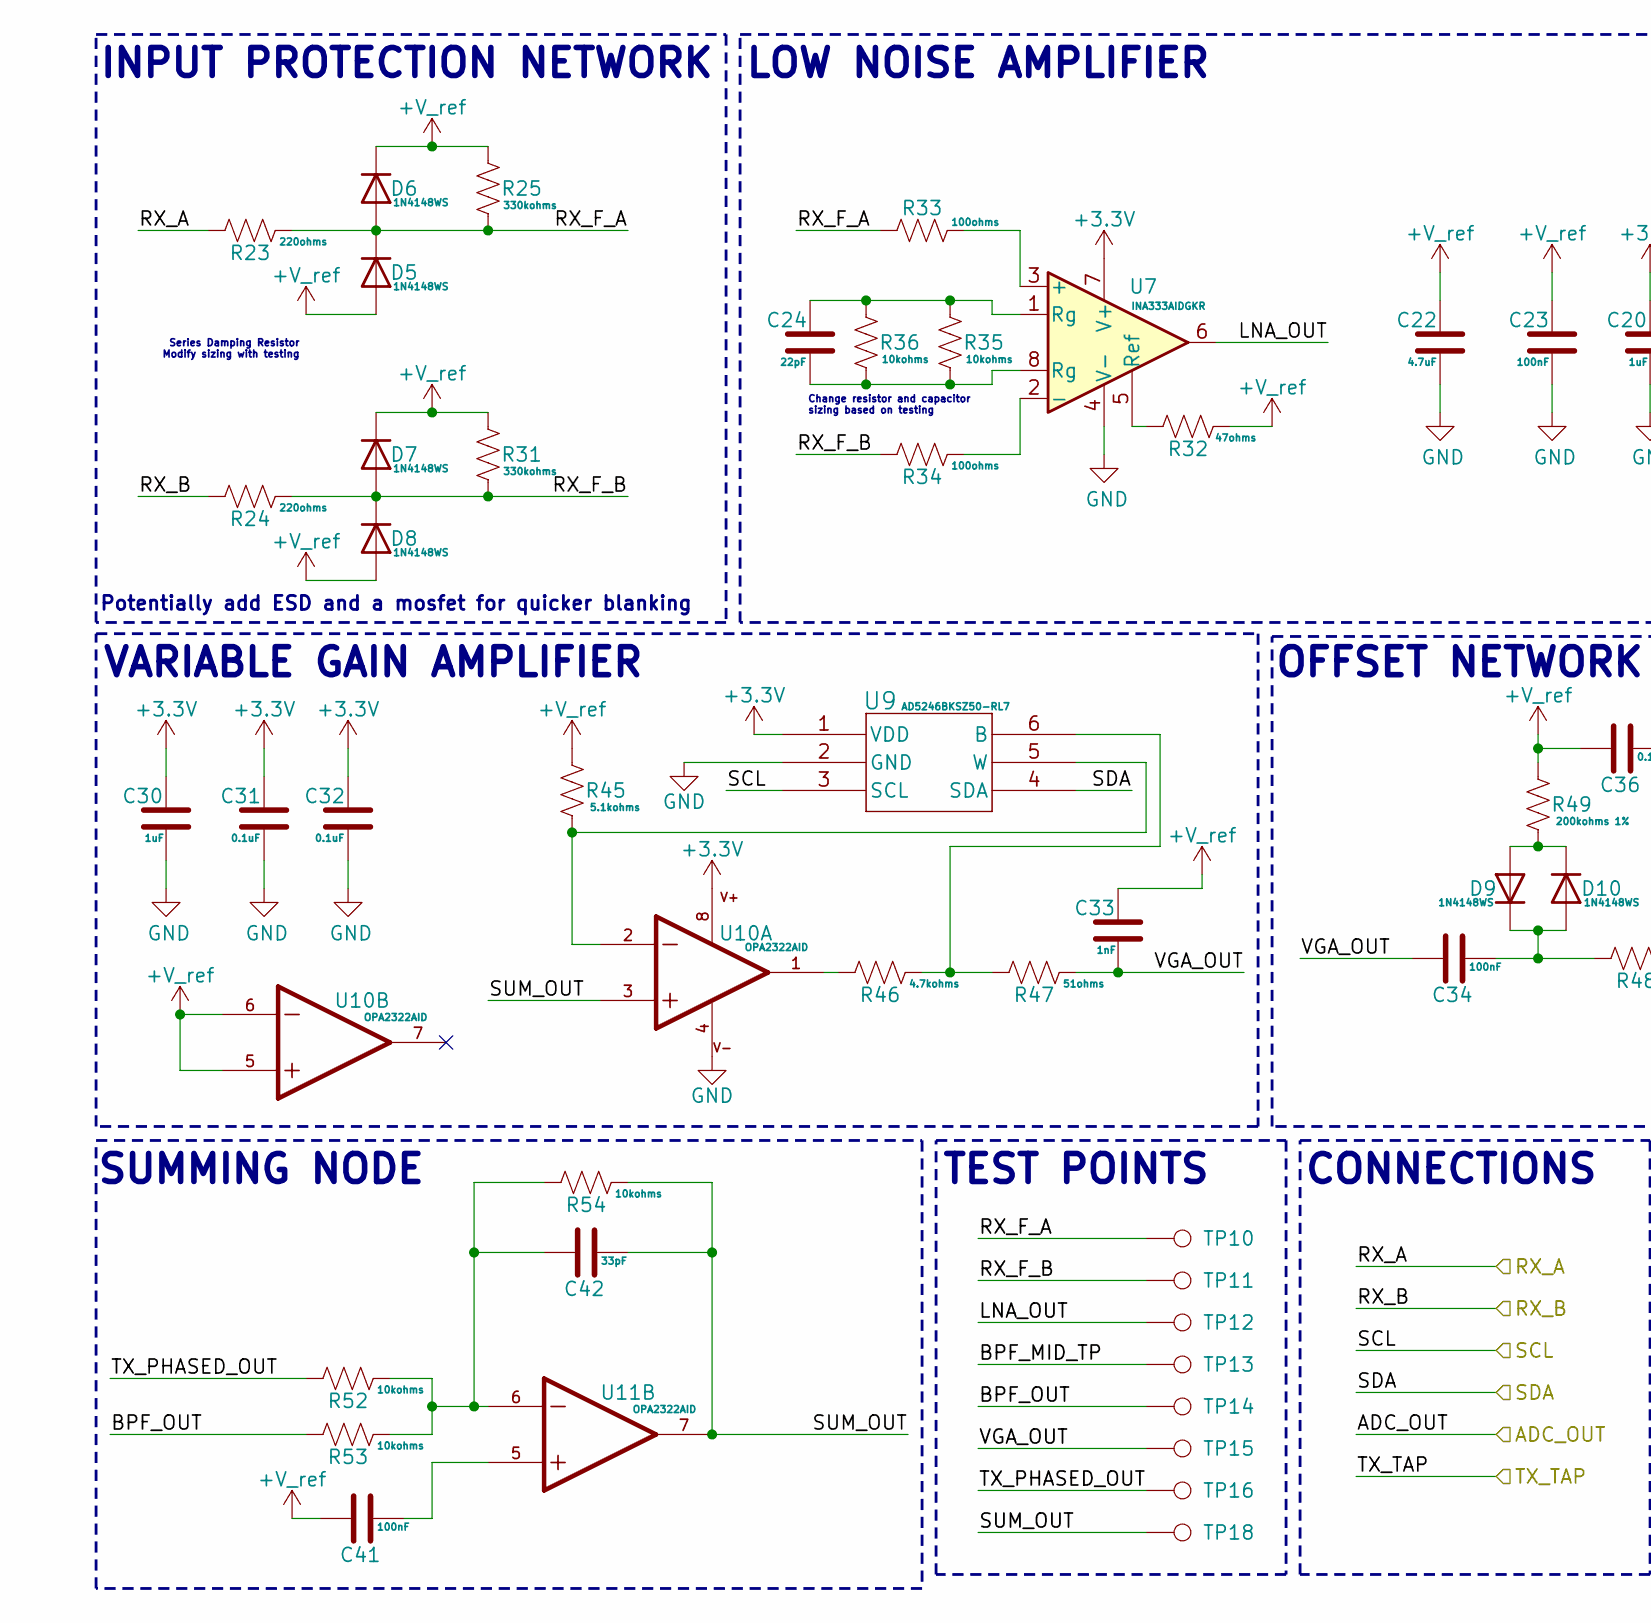
[picture p54: schematic RX.kicad_sch, part in row 1, column 1]

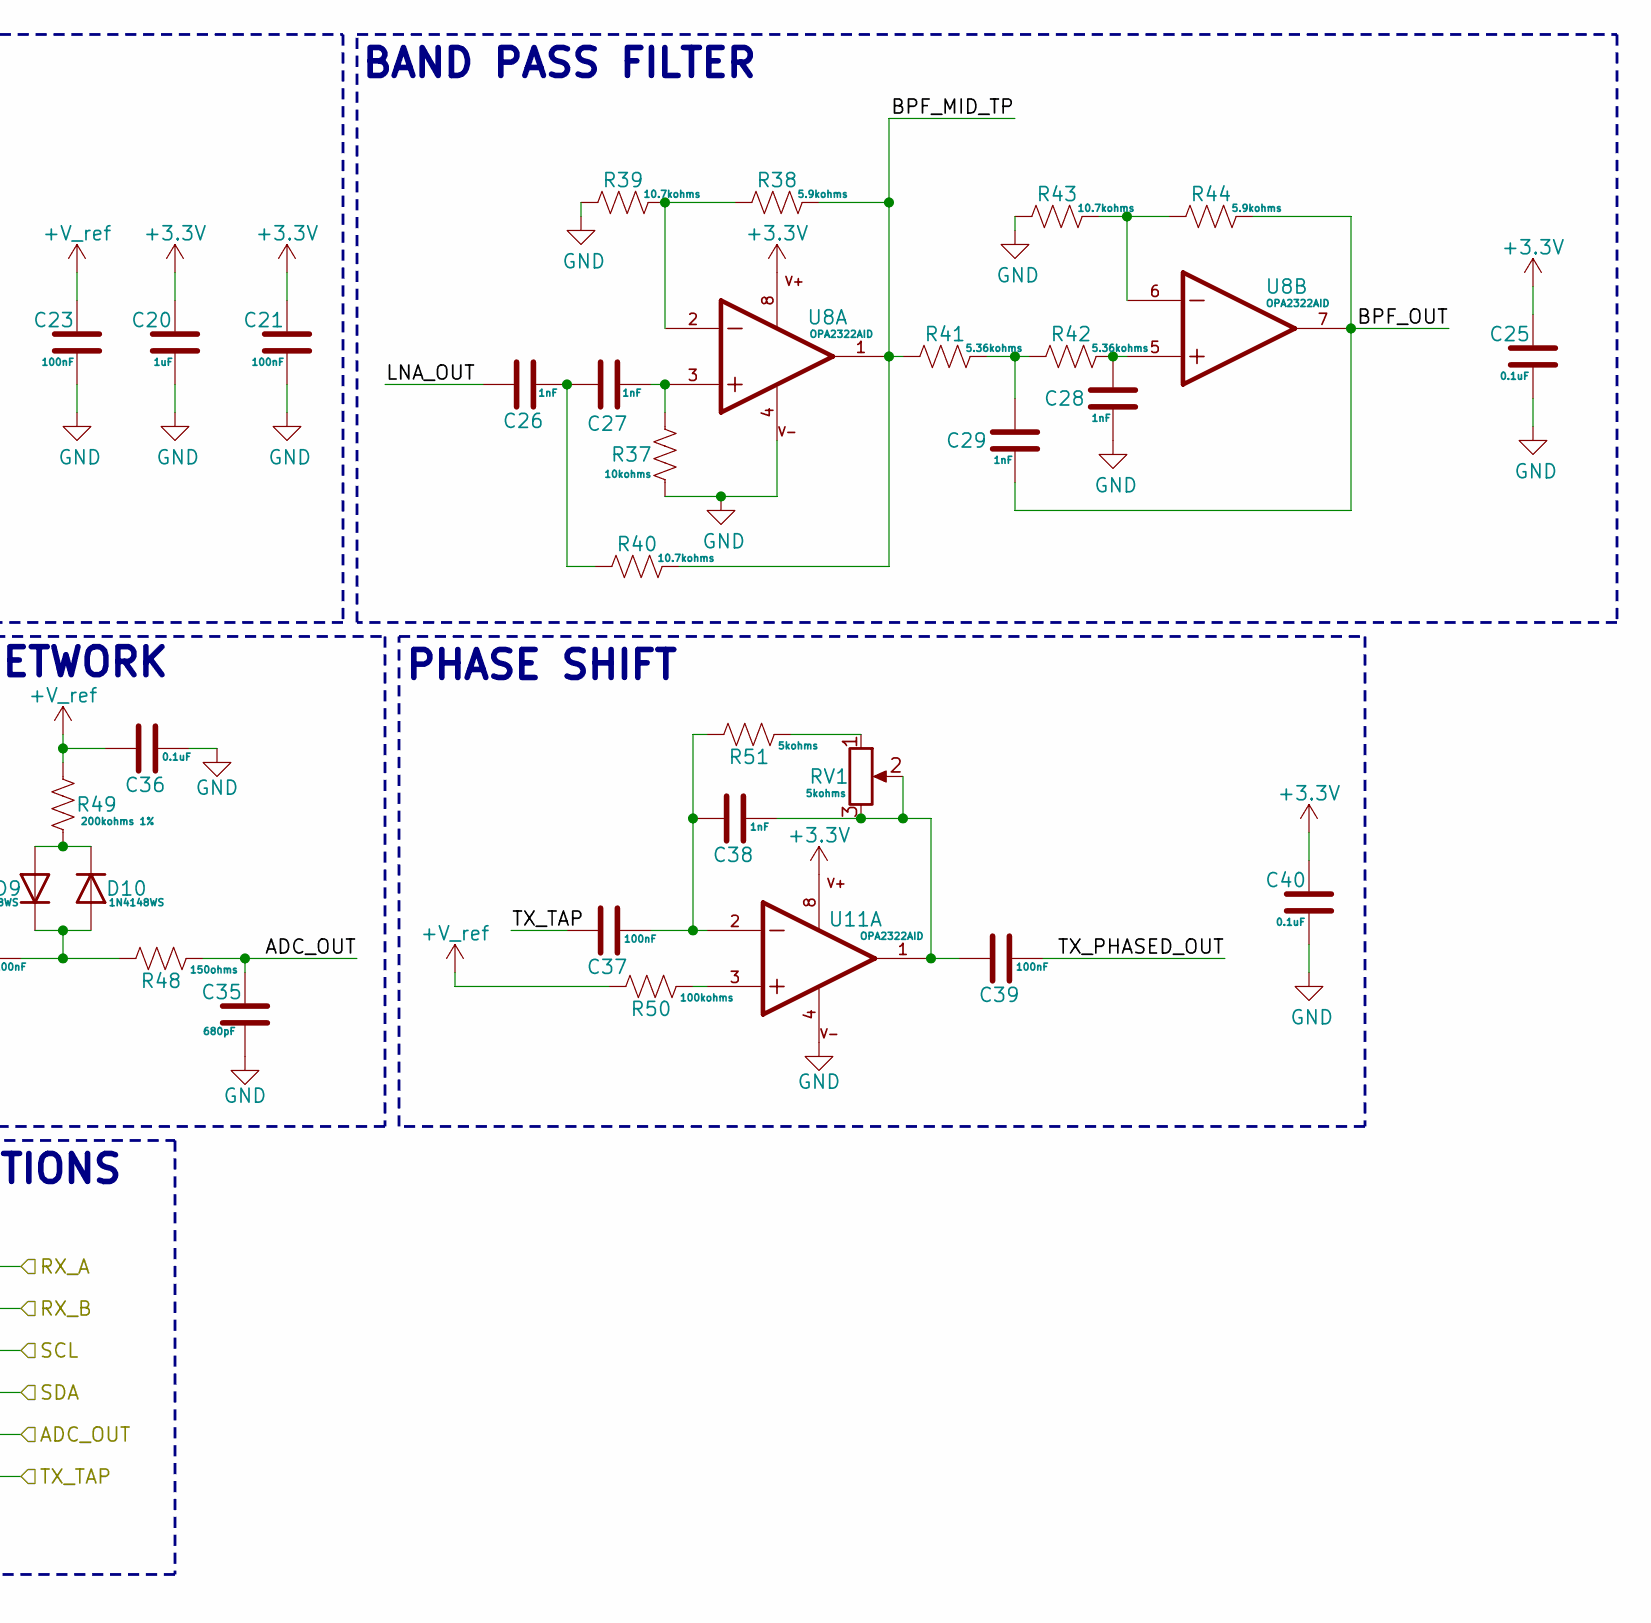
[picture p55: schematic RX.kicad_sch, part in row 1, column 2]

Parts:
C20, C30: 1uF; C_0603_1608Metric
C21, C23, C34, C37, C39, C41: 100nF; C_0603_1608Metric
C22: 4.7uF; C_0603_1608Metric
C24: 22pF; C_0603_1608Metric
C25, C31, C32, C36, C40: 0.1uF; C_0603_1608Metric
C26, C27, C28, C29, C33, C38: 1nF; C_0603_1608Metric
C35: 680pF; C_0603_1608Metric
C42: 33pF; C_0603_1608Metric
D5, D6, D7, D8, D9, D10: 1N4148WS; D_SOD-323
R23, R24: 220ohms; R_0603_1608Metric
R25, R31: 330kohms; R_0603_1608Metric
R32: 47ohms; R_0603_1608Metric
R33, R34: 100ohms; R_0603_1608Metric
R35, R36, R37, R52, R53, R54: 10kohms; R_0603_1608Metric
R38, R44: 5.9kohms; R_0603_1608Metric
R39, R40, R43: 10.7kohms; R_0603_1608Metric
R41, R42: 5.36kohms; R_0603_1608Metric
R45: 5.1kohms; R_0603_1608Metric
R46: 4.7kohms; R_0603_1608Metric
R47: 51ohms; R_0603_1608Metric
R48: 150ohms; R_0603_1608Metric
R49: 200kohms 1%; R_0603_1608Metric
R50: 100kohms; R_0603_1608Metric
R51: 5kohms; R_0603_1608Metric
RV1: 5kohms; Potentiometer_Bourns_3296W_Vertical
TP10, TP11, TP12, TP13, TP14, TP15, TP16, TP18: TestPoint; TestPoint_Pad_D1.0mm
U7: INA333AIDGKR; VSSOP-8_3x3mm_P0.65mm
U8, U10, U11: OPA2322AID; IC_OPA2322AID; PARTREV A
U9: AD5246BKSZ50-RL7; KS_6_ADI

Connections:
+3.3V: C20.1, C21.1, C25.1, C30.1, C31.1, C32.1, C40.1, U7.7 (V+), U8.8, U9.1 (VDD), U10.8, U11.8; also elsewhere on the board
+V_ref: C22.1, C23.1, C33.1, C36.1, C41.1, D5.2 (A), D6.1 (K), D7.1 (K), D8.2 (A), R25.2, R31.2, R32.2, R45.2, R49.2, R50.1, U10.5, U10.6; also elsewhere on the board
/RX/ADC_OUT: C35.1, R48.2; also elsewhere on the board
/RX/BPF_MID_TP: R38.2, R40.2, R41.1, TP13.1, U8.1
/RX/BPF_OUT: C29.2, R44.2, R53.1, TP14.1, U8.7
/RX/LNA_OUT: C26.1, TP12.1, U7.6
/RX/RX_F_A: D5.1 (K), D6.2 (A), R23.2, R25.1, R33.1, TP10.1
/RX/RX_F_B: D7.2 (A), D8.1 (K), R24.2, R31.1, R34.1, TP11.1
/RX/SCL: U9.3 (SCL); also elsewhere on the board
/RX/SDA: U9.4 (SDA); also elsewhere on the board
/RX/SUM_OUT: C42.2, R54.2, TP18.1, U10.3, U11.7
/RX/TX_PHASED_OUT: C39.2, R52.1, TP16.1
/RX/TX_TAP: C37.1; also elsewhere on the board
/RX/VGA_OUT: C33.2, C34.1, R47.2, TP15.1
/RX_A: R23.1; also elsewhere on the board
/RX_B: R24.1; also elsewhere on the board
GND: C20.2, C21.2, C22.2, C23.2, C25.2, C28.2, C30.2, C31.2, C32.2, C35.2, C36.2, C40.2, R37.1, R39.1, R43.1, U7.4 (V-), U8.4, U9.2 (GND), U10.4, U11.4; also elsewhere on the board
unnamed: C24.1, R35.2, R36.2, U7.1 (Rg)
unnamed: C24.2, R35.1, R36.1, U7.8 (Rg)
unnamed: C26.2, C27.1, R40.1
unnamed: C27.2, R37.2, U8.3
unnamed: C28.1, R42.2, U8.5
unnamed: C29.1, R41.2, R42.1
unnamed: C37.2, C38.1, R51.1, U11.2
unnamed: C38.2, C39.1, RV1.2, RV1.3, U11.1
unnamed: C41.2, U11.5
unnamed: C42.1, R52.2, R53.2, R54.1, U11.6
unnamed: C34.2, D9.1 (K), D10.2 (A), R48.1
unnamed: D9.2 (A), D10.1 (K), R49.1
unnamed: R38.1, R39.2, U8.2
unnamed: R43.2, R44.1, U8.6
unnamed: R46.1, U10.1
unnamed: R50.2, U11.3
unnamed: R51.2, RV1.1
unnamed: R33.2, U7.3 (+)
unnamed: R34.2, U7.2 (-)
unnamed: R32.1, U7.5 (Ref)
unnamed: R46.2, R47.1, U9.6 (B)
unnamed: R45.1, U9.5 (W), U10.2

Notes on the sheet:
Series Damping Resistor Modify sizing with testing
LOW NOISE AMPLIFIER
BAND PASS FILTER
INPUT PROTECTION NETWORK
PHASE SHIFT
CONNECTIONS
SUMMING NODE
Change resistor and capacitor sizing based on testing
Potentially add ESD and a mosfet for quicker blanking
OFFSET NETWORK
TEST POINTS
VARIABLE GAIN AMPLIFIER

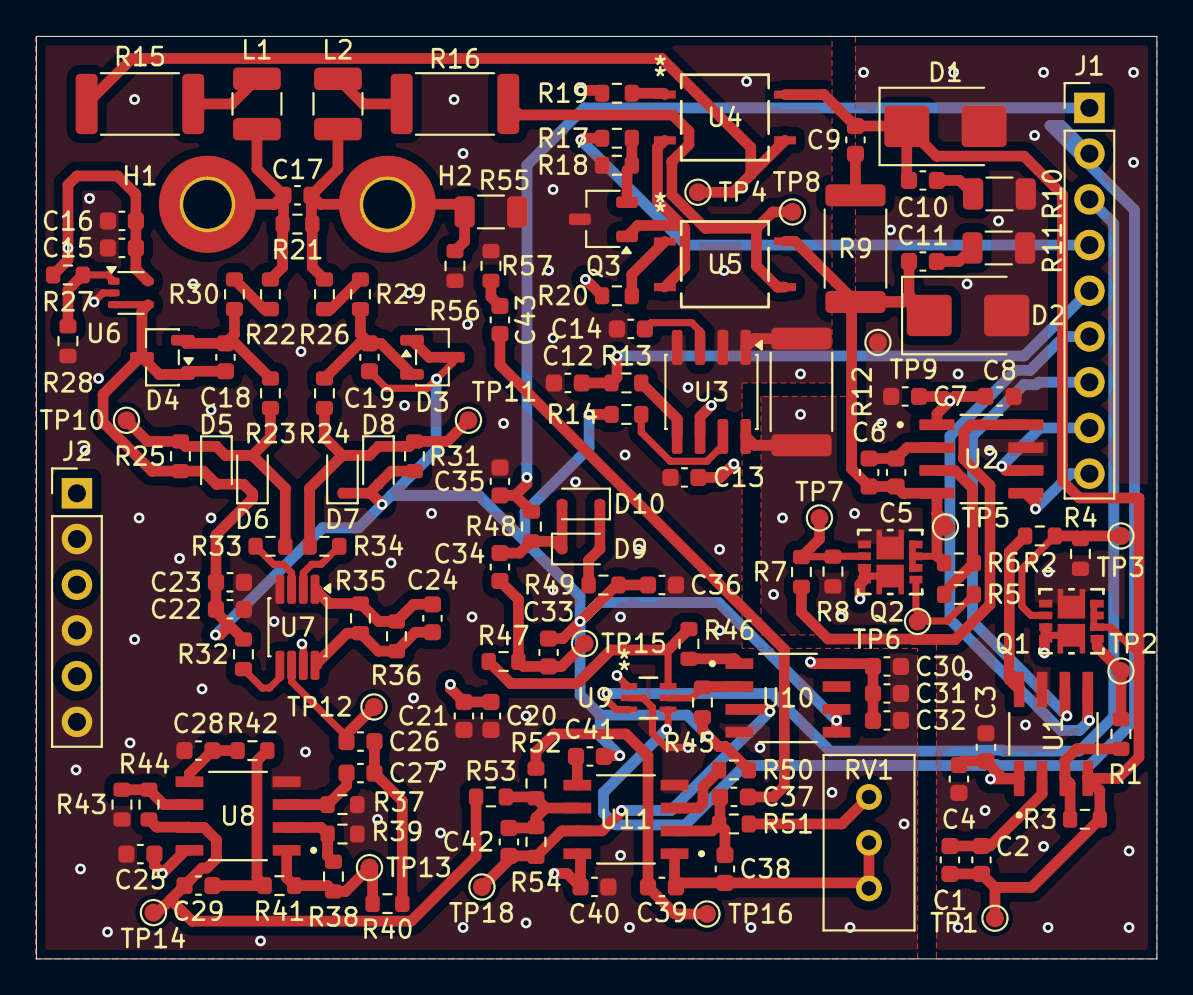
[picture p56: board COMMs.kicad_pcb from above]

Board: 4 copper layers, 62.2 x 51.2 mm, 148 parts (0 on the bottom side), 80 nets.
