Astrelis-Nav/SWARM_COMMs/(commit log)

2026-02-10 Added V1 Board
    [COMMs-B_Cu.gbr, COMMs-B_Mask.gbr, COMMs-B_Paste.gbr, COMMs-B_Silkscreen.gbr, COMMs-Edge_Cuts.gbr, COMMs-F_Cu.gbr, COMMs-F_Mask.gbr, COMMs-F_Paste.gbr]
2026-03-09 Updated COMMs Board
    [COMMs.kicad_sch, RX.kicad_sch, TX.kicad_sch]
2026-03-09 Started CONTROL Board
    [CONTROL.kicad_pcb, CONTROL.kicad_sch]
2026-03-09 Designed PWR Board
    Designed and exported PWR Board (sent to manufacture)
    [PWR-B_Cu.gbr, PWR-B_Mask.gbr, PWR-B_Paste.gbr, PWR-B_Silkscreen.gbr, PWR-Edge_Cuts.gbr, PWR-F_Cu.gbr, PWR-F_Mask.gbr, PWR-F_Paste.gbr]
2026-03-09 Initial Component Layout of Main MCU
    [CONTROL.kicad_pcb, CONTROL.kicad_sch]
2026-03-11 Finished Schematic, Started Placing Components on PCB
    [CONTROL.kicad_pcb, CONTROL.kicad_sch]
2026-03-16 Cleaned up Formating
    Cleaned up formatting and added required exports for delivery
    [PWR.kicad_sch]
2026-03-16 Minor Schematic Updates and PCB Routing
    [CONTROL.kicad_pcb, CONTROL.kicad_sch]
2026-03-18 Completed Rev1 and Documentation
    [CONTROL-B_Cu.gbr, CONTROL-B_Mask.gbr, CONTROL-B_Paste.gbr, CONTROL-B_Silkscreen.gbr, CONTROL-Edge_Cuts.gbr, CONTROL-F_Cu.gbr, CONTROL-F_Mask.gbr, CONTROL-F_Paste.gbr]
2026-03-18 Created Sensor Board
    [SENSOR-B_Cu.gbr, SENSOR-B_Mask.gbr, SENSOR-B_Paste.gbr, SENSOR-B_Silkscreen.gbr, SENSOR-Edge_Cuts.gbr, SENSOR-F_Cu.gbr, SENSOR-F_Mask.gbr, SENSOR-F_Paste.gbr]
2026-03-19 Added Sensor Names to Silkscreen
    [SENSOR-B_Cu.gbr, SENSOR-B_Mask.gbr, SENSOR-B_Paste.gbr, SENSOR-B_Silkscreen.gbr, SENSOR-Edge_Cuts.gbr, SENSOR-F_Cu.gbr, SENSOR-F_Mask.gbr, SENSOR-F_Paste.gbr]
2026-03-20 Updated Sensor Output Files
    [SENSOR-B_Cu.gbr, SENSOR-B_Mask.gbr, SENSOR-B_Paste.gbr, SENSOR-B_Silkscreen.gbr, SENSOR-Edge_Cuts.gbr, SENSOR-F_Cu.gbr, SENSOR-F_Mask.gbr, SENSOR-F_Paste.gbr]
2026-03-20 Small Updates
    [PWR.kicad_sch, RX.kicad_sch]
2026-03-21 Fixed Schematic Errors
    [PWR.kicad_pcb, PWR.kicad_sch]
2026-03-21 RX Initial Schematic Design
    [RX.kicad_pcb, RX.kicad_sch, TX.kicad_pcb, TX.kicad_sch]
2026-03-22 Removed Out of Date Files
    [CONTROL-B_Cu.gbr, CONTROL-B_Mask.gbr, CONTROL-B_Paste.gbr, CONTROL-B_Silkscreen.gbr, CONTROL-Edge_Cuts.gbr, CONTROL-F_Cu.gbr, CONTROL-F_Mask.gbr, CONTROL-F_Paste.gbr]
2026-03-22 Updated Sensor to new Version
    [SENSOR.kicad_pcb, SENSOR.kicad_sch]
2026-03-22 Claude PCB Review
    Made updates based on Claude's Review
    - Added decoupling capacitor
    - Verified CS pins
    - Compared placement and connections to data sheets
    [SENSOR.kicad_pcb, SENSOR.kicad_sch]
2026-03-22 Claude Design Review
    fix: tie ASM330 MSCL/MSDA to GND; DNP mark address jumpers R1/R3
    [SENSOR.kicad_pcb, SENSOR.kicad_sch]
2026-03-22 Update SENSOR.kicad_pcb
    fix: add copper pour keepout under MMC5603NJ (U3)
    [SENSOR.kicad_pcb]
2026-03-22 Added Sensor Board Exports
    [SENSOR-B_Cu.gbr, SENSOR-B_Mask.gbr, SENSOR-B_Paste.gbr, SENSOR-B_Silkscreen.gbr, SENSOR-Edge_Cuts.gbr, SENSOR-F_Cu.gbr, SENSOR-F_Mask.gbr, SENSOR-F_Paste.gbr]
2026-03-22 fix(usb-c): add ESD protection and clean up VBUS handling
    - Add USBLC6-2SC6 TVS diode array on D+ and D- (J4)
    - Add 100k bleed resistor from VBUS to GND (VBUS not powered)
    [CONTROL.kicad_sch]
2026-03-22 Updated USB Port Schematic and PCB
    [CONTROL.kicad_pcb, CONTROL.kicad_sch]
2026-03-22 fix(sd-card): pull up unused DAT1 and DAT2 lines
    - Add 47k pull-up resistors on DAT1 (pin 8) and DAT2 (pin 1) to 3.3V
    - Required by SD spec to prevent undefined bus state during init
    [CONTROL.kicad_pcb, CONTROL.kicad_sch]
2026-03-22 fix(crystals): correct LSE load cap configuration
    - Remove C13 and C14 (1.2pF external load caps on LSE)
    - ABS05W has CL = 4pF; use STM32 internal OSC caps instead
    - HSE caps C11/C12 confirmed correct at 10pF for E3SB16E (CL = 8pF)
    - Note: configure LSE drive to low-power mode in firmware to match ABS05W ESR
    [CONTROL.kicad_pcb, CONTROL.kicad_sch]
2026-03-22 fix(pico): connect power pins and add reset pull-up
    - Connect VSYS (pin 39) to 3.3V rail via header
    - Connect 3V3_EN (pin 37) to 3.3V to keep regulator enabled
    - Add 10k pull-up resistor on RUN (pin 30) to 3.3V
    - Add no-connect on 3V3 (pin 36) — Pico regulator output unused
    - Add no-connect on VBUS (pin 40) — USB power not used
    [CONTROL.kicad_pcb, CONTROL.kicad_sch]
2026-03-22 fix(uart): correct inter-MCU UART cross-connection
    - Swap UART net labels on Pico side to correctly cross TX/RX
    - Pico GPIO4 (pin 6): UART_TX -> UART_RX (connects to STM32 PA9/USART1_TX)
    - Pico GPIO5 (pin 7): UART_RX -> UART_TX (connects to STM32 PA10/USART1_RX)
    - Both MCUs confirmed on 3.3V — no level shifting required
    [CONTROL.kicad_pcb, CONTROL.kicad_sch]
2026-03-22 fix(layout): move HSE and LSE crystals closer to STM32 OSC pins
    - Relocate Y1 (16MHz HSE) directly above STM32 to reduce trace length
    - Relocate Y2 (32.768kHz LSE) alongside Y1 above STM32
    - C11/C12 load caps repositioned to follow crystals
    - Shorter direct traces to PH0/PH1 and PC14/PC15 OSC pins
    [CONTROL.kicad_pcb]
2026-03-22 Added Control Board Outputs
    [CONTROL-B_Cu.gbr, CONTROL-B_Mask.gbr, CONTROL-B_Paste.gbr, CONTROL-B_Silkscreen.gbr, CONTROL-Edge_Cuts.gbr, CONTROL-F_Cu.gbr, CONTROL-F_Mask.gbr, CONTROL-F_Paste.gbr]
2026-03-23 Initial PCB Placement
    [RX.kicad_pcb, RX.kicad_sch]
2026-03-23 Completed Initial PCB Component Placements
    [TX.kicad_pcb, TX.kicad_sch]
2026-03-23 RX_Rev_2 schematic design review fixes
    - Set R14 gain resistor to calculated value for target INA828 gain
    - Resolved C6 ambiguity (marked DNP)
    [RX.kicad_sch]
2026-03-23 Update TX.kicad_sch
    R5, R6, R11, R12: 3.3Ω → 10Ω (gate resistors)
    R17: SHUNT → 0.01 (10mΩ shunt, 2512 footprint already correct)
    [TX.kicad_sch]
2026-03-23 Added PWR Export Files
    [PWR-B_Cu.gbr, PWR-B_Mask.gbr, PWR-B_Paste.gbr, PWR-B_Silkscreen.gbr, PWR-Edge_Cuts.gbr, PWR-F_Cu.gbr, PWR-F_Mask.gbr, PWR-F_Paste.gbr]
2026-03-23 Added Title Summary and Updated Rev 2.1
    [RX.kicad_pcb, RX.kicad_sch]
2026-03-23 Updated Revision Number and Title Block
    [TX.kicad_pcb, TX.kicad_sch]
2026-03-23 Updated Schematic to include Inductor Matching Inductors
    [TX.kicad_pcb, TX.kicad_sch]
2026-03-23 Updated MOSFET
    [TX.kicad_sch]
2026-03-23 Generated TX Board Outputs
    [TX-B_Cu.gbr, TX-B_Mask.gbr, TX-B_Paste.gbr, TX-B_Silkscreen.gbr, TX-Edge_Cuts.gbr, TX-F_Cu.gbr, TX-F_Mask.gbr, TX-F_Paste.gbr]
2026-03-23 RX Board Outputs
    [RX-B_Cu.gbr, RX-B_Mask.gbr, RX-B_Paste.gbr, RX-B_Silkscreen.gbr, RX-Edge_Cuts.gbr, RX-F_Cu.gbr, RX-F_Mask.gbr, RX-F_Paste.gbr]
2026-03-30 PWR - Updated 3D Models for Full Board Export
    [PWR.kicad_pcb, PWR.kicad_sch]
2026-03-30 SENSOR - Added and Exported 3D Model of PCB
    [SENSOR.kicad_pcb, SENSOR.kicad_sch, SENSOR_3D_Model_Rev_1.1.step]
2026-03-30 CONTROL - Added 3D Models for Export
    [CONTROL.kicad_pcb, CONTROL.kicad_sch]
2026-03-30 RX Added 3D Model and Export
    [RX.kicad_pcb, RX_3D_Model_Rev_2.1.step]
2026-03-30 TX 3D Models and Export
    [TX.kicad_pcb]
2026-04-15 Added Voltage Divider
    Added Voltage Divider to 3.3PG and 12VPG
    [PWR.kicad_pcb, PWR.kicad_sch]
2026-04-15 Moved Rev 1.1 to Archive
    [PWR-B_Cu.gbr, PWR-B_Mask.gbr, PWR-B_Paste.gbr, PWR-B_Silkscreen.gbr, PWR-Edge_Cuts.gbr, PWR-F_Cu.gbr, PWR-F_Mask.gbr, PWR-F_Paste.gbr]
2026-04-15 PWR Rev 1.2 Exports
    [PWR-B_Cu.gbr, PWR-B_Mask.gbr, PWR-B_Paste.gbr, PWR-B_Silkscreen.gbr, PWR-Edge_Cuts.gbr, PWR-F_Cu.gbr, PWR-F_Mask.gbr, PWR-F_Paste.gbr]
2026-04-15 Added Boost for V_Piezo
    [PWR.kicad_pcb, PWR.kicad_sch]
2026-04-15 Fixed Typoed Date
    [CONTROL-B_Cu.gbr, CONTROL-B_Mask.gbr, CONTROL-B_Paste.gbr, CONTROL-B_Silkscreen.gbr, CONTROL-Edge_Cuts.gbr, CONTROL-F_Cu.gbr, CONTROL-F_Mask.gbr, CONTROL-F_Paste.gbr]
2026-04-15 Moved COMMs Rev 1 to Achive
    [COMMs-B_Cu.gbr, COMMs-B_Mask.gbr, COMMs-B_Paste.gbr, COMMs-B_Silkscreen.gbr, COMMs-Edge_Cuts.gbr, COMMs-F_Cu.gbr, COMMs-F_Mask.gbr, COMMs-F_Paste.gbr]
2026-04-16 Created OUTPUTs Board
    [OUTPUTs-B_Cu.gbr, OUTPUTs-B_Mask.gbr, OUTPUTs-B_Paste.gbr, OUTPUTs-B_Silkscreen.gbr, OUTPUTs-Edge_Cuts.gbr, OUTPUTs-F_Cu.gbr, OUTPUTs-F_Mask.gbr, OUTPUTs-F_Paste.gbr]
2026-04-30 Updated RX
    [RX-B_Cu.gbr, RX-B_Mask.gbr, RX-B_Paste.gbr, RX-B_Silkscreen.gbr, RX-Edge_Cuts.gbr, RX-F_Cu.gbr, RX-F_Mask.gbr, RX-F_Paste.gbr]
2026-04-30 Updated to KiCAD 10 and exported BOM
    [PWR.kicad_sch]
2026-05-19 Revert "Updated"
    This reverts commit 89be44ed720659141c8ee702c54a520a60db740f.
    [CONTROL.kicad_pcb, CONTROL.kicad_sch, PWR.kicad_pcb, RX.kicad_pcb, RX.kicad_sch]
2026-05-20 Created Rev 2 Project
    Rev 2 project files with all boards under one project
    [SWARM_PCB_Rev_2.kicad_pcb, SWARM_PCB_Rev_2.kicad_sch]
2026-05-20 CONTROL Schematic Rev2
    [CONTROL.kicad_sch]
2026-05-20 HEADER PINS Schematic
    [HEADER_PINS.kicad_sch]
2026-05-20 Made Rev 2 Sensor Schematic
    [SENSOR.kicad_sch]
2026-05-21 Created Power Schematic
    [POWER.kicad_sch]
2026-05-21 Additional Footprints
2026-05-25 Reannotated Schematic
    [CONTROL.kicad_sch, HEADER_PINS.kicad_sch, POWER.kicad_sch, SENSOR.kicad_sch, SWARM_PCB_Rev_2.kicad_pcb]
2026-05-26 Finished Placement for POWER, CONTROL and SENSOR
    [CONTROL.kicad_sch, HEADER_PINS.kicad_sch, POWER.kicad_sch, SENSOR.kicad_sch, SWARM_PCB_Rev_2.kicad_pcb]
2026-05-26 TX Board Schematic
    [CONTROL.kicad_sch, HEADER_PINS.kicad_sch, POWER.kicad_sch, RX.kicad_sch, SENSOR.kicad_sch, SWARM_PCB_Rev_2.kicad_sch, TX.kicad_sch]
2026-06-08 Completed PCB Layout
    [CONTROL.kicad_sch, HEADER_PINS.kicad_sch, POWER.kicad_sch, RX.kicad_sch, SENSOR.kicad_sch, SWARM_PCB_Rev_2.kicad_pcb, SWARM_PCB_Rev_2.kicad_sch, TX.kicad_sch]
2026-06-15 Fixed DRC and ERC errors
    [SWARM_PCB_Rev_2.kicad_pcb]
2026-06-15 Add MPNs to BOM and apply PCB DFM fixes for JLCPCB
    Schematic: added MPN and Manufacturer properties to 205 references
    across all sub-sheets (Murata/Yageo/TI/ST/Hirose/JST etc.).
    Fixed dU7 description to match INA823DR (not INA828).
    PCB: added via tenting (1540 vias), removed stale auto-placement-area
    keepout zones (4 zones), increased annular rings on 482 undersized vias
    (0.05mm -> 0.1mm), added 6 fiducial markers (3x F.Cu + 3x B.Cu).
    [CONTROL.kicad_sch, HEADER_PINS.kicad_sch, POWER.kicad_sch, SENSOR.kicad_sch, SWARM_PCB_Rev_2.kicad_pcb, TX_RX.kicad_sch]
2026-06-15 Add design review package
    Generated DESIGN_REVIEW.md covering board specs, full BOM table,
    DRC/EMC findings with status, fixes applied, open items, and
    JLCPCB manufacturing checklist.
2026-06-16 Fixed Via size and added Copper Pours for POWER BOARD
2026-06-16 Trace Tuning
    [SWARM_PCB_Rev_2.kicad_pcb]
2026-06-17 Design review fixes: feedback resistor, SWCLK, LED MPNs, GND annotation
    - POWER: correct bR10 feedback resistor 187k→255k so TPS55340RTER
    (Vref=0.9V) sets VPiezo to 23.85V (~24V target)
    - POWER: assign MPNs for bD2 (green), bD3/bD4 (blue) JE2835 LEDs
    - CONTROL: add 33Ω series resistor aR18 on SWCLK near debug header aJ4
    - CONTROL: assign MPNs for aD1 (purple) and aD2 (RGB) LEDs
    - Top schematic: document isolated GND domain architecture (H3)
    - PCB layout, sub-sheet, and SPICE updates
    [CONTROL.kicad_sch, HEADER_PINS.kicad_sch, POWER.kicad_sch, SENSOR.kicad_sch, SWARM_PCB_Rev_2.kicad_pcb, SWARM_PCB_Rev_2.kicad_sch, TX_RX.kicad_sch]
2026-06-17 Design review fixes: cap voltage ratings, MPN corrections, FET symbol
    - POWER: upgrade 17x MLCC MPNs to correct voltage ratings (6.3V/10V caps
    on 12–24V rails replaced with 25V/50V Murata GRM equivalents)
    - POWER: fix bR10 MPN to RC0603FR-07255KL (was 187k part, value is 255k)
    - CONTROL: fix aR18 MPN to RC0603FR-0733RL (was 10k part, value is 33R)
    - TX_RX: replace IPD50R3K0CE lib symbol with Device:MOSFET_N for dQ1-dQ4
    - TX_RX: mark dL1/dL2 value as TBD (piezo matching, pending characterisation)
    - DESIGN_REVIEW: full review update with all findings by severity
    [CONTROL.kicad_sch, POWER.kicad_sch, TX_RX.kicad_sch]
2026-06-17 Fix VCAP cap value and I2C pull-up resistors
    - CONTROL: aC3 VCAP changed 2.2uF -> 1uF (GRM188R60J105KE15D) per STM32F446 spec
    - SENSOR: cR1/cR2 I2C pull-ups changed 4.7k -> 2.2k (RC0603FR-072K2L) for 400kHz 4-device bus
    [CONTROL.kicad_sch, SENSOR.kicad_sch]
2026-06-17 Fix HSE crystal load cap MPNs and update design review
    - CONTROL: aC18/aC19 MPN updated to GRM1885C1H100JA01D (10pF C0G 50V 0603)
    to match corrected Value=10p; was GRM188R61A105KA61D (1uF - wrong part)
    - CONTROL: aC16/aC17 1uF decoupling cap MPNs restored (collateral from replace_all)
    - DESIGN_REVIEW: close C2, P6, T5; downgrade T4; note piezo load context
    [CONTROL.kicad_sch]
2026-06-17 Fix dU7 symbol: rename INA828IDR to INA823DR
    INA823 and INA828 are pin-compatible (identical SOIC-8 pinout).
    Renamed embedded lib symbol, sub-symbols, Value, MP, and lib_id
    throughout TX_RX.kicad_sch. No connectivity changes required.
    [TX_RX.kicad_sch]
2026-06-17 Close C4: LSE load caps not needed on STM32F446
    STM32F446 LSE oscillator has built-in internal load capacitors (~5pF each),
    so external load caps for aY1 (32.768kHz) are intentionally omitted.
2026-06-17 Close C8: low LED drive current is intentional
    aD1/aD2 driven at ~0.2mA via 1k series resistors by design
    to minimise power consumption.
2026-06-17 Fix aC15 decoupling cap 10nF→100nF; close C5 and C6 findings
    - aC15: Value 10n→100n, MPN GRM188R71H103KA01D→GRM188R71C104KA01D
    (meets ST ≥100nF recommendation for VBAT/VDD decoupling)
    - C5 closed: VBAT confirmed tied to +3.3V_CONTROL
    - C6 closed: NRST filter cap aC1 = 100nF confirmed
    [CONTROL.kicad_sch]
2026-06-17 Fix T10/H1: swap dU1+dU2 VDD/VSS supply nets; populate J1 Value; close S4
    T10 (Critical): UCC27211D dU1 and dU2 had VDD (pin 1) wired to GND_TXRX and
    VSS (pin 7) wired to 12V_TXRX — completely inverted, would destroy chips at
    power-on. Fixed by swapping lib_id and Value on four power symbols in
    TX_RX.kicad_sch: VDD now on 12V_TXRX, VSS on GND_TXRX.
    H1: J1 Value field was empty in HEADER_PINS.kicad_sch; set to
    "Conn_02x25_Odd_Even" to match J2–J4.
    S4: cU2 VDD_IO confirmed on +3.3V_SENSOR; INT1/INT2 wired separately —
    no issue found, closed as confirmed-good.
    [HEADER_PINS.kicad_sch, TX_RX.kicad_sch]
2026-06-17 Close P5/C3: bR10 and aR18 MPNs already correct in schematic
    P5: bR10 MPN was already RC0603FR-07255KL (255k) — finding was stale.
    C3: aR18 MPN was already RC0603FR-0733RL (33Ω) — finding was stale.
    Updated BOM table and notes to reflect confirmed MPNs.
2026-06-18 Fixed some small errors and added the Output board
    [CONTROL.kicad_sch, HEADER_PINS.kicad_sch, OUTPUT.kicad_sch, POWER.kicad_sch, SENSOR.kicad_sch, SWARM_PCB_Rev_2.kicad_pcb, SWARM_PCB_Rev_2.kicad_sch, TX_RX.kicad_sch]
2026-06-18 Design review fixes: P7/P8/C10/C11/T4 + MPN audit
    - P7: bR3 36k→4.3k, bR4 82k→4.3k (blue LEDs now 2.05mA each)
    - P8: bD1 lib_id Diode:SS34→Device:D_TVS; embed D_TVS lib_symbol in POWER.kicad_sch
    - C10: aR19 33Ω (RC0603FR-0733RL) added on SWO line (user-placed)
    - C11: aFB1 footprint Resistor_SMD:R_0603_1608Metric→Inductor_SMD:L_0603_1608Metric
    - T4: dD1/dD2 SS14-E3/61T bootstrap Schottky diodes added on HB_A/HB_B; MPN set
    - BOM: MPNs added to J25–J28 (Samtec SSQ), aJ1/aJ4 (Harwin M50)
    - DESIGN_REVIEW.md: close T4, T8/T9, P7, P8, C10, C11, H2, dC9, bL1/bL2 items
    [CONTROL.kicad_sch, POWER.kicad_sch, TX_RX.kicad_sch]
2026-06-18 Close GP-001 and RP-001: stitching vias confirmed in layout
    1,593 vias present in GND fills (1,093 manually placed), exceeding
    the 54-site GP-001 target. RP-001 return-path coverage confirmed.
    Only T2 (dL1/dL2 piezo inductors) remains open pending piezo
    characterisation.
2026-06-19 Resolved all DRC and ERC errors
    [CONTROL.kicad_sch, HEADER_PINS.kicad_sch, OUTPUT.kicad_sch, POWER.kicad_sch, SENSOR.kicad_sch, SWARM_PCB_Rev_2.kicad_pcb, SWARM_PCB_Rev_2.kicad_sch, TX_RX.kicad_sch]
2026-06-19 to delete
    [SWARM_PCB_Rev_2.kicad_pcb]
2026-06-19 Completed Panalization
    [SWARM_PCB_Rev_2.kicad_pcb]
2026-06-19 Revert "to delete"
    This reverts commit 543c70bcba01ecf78262208d4f10808184dfb0ad.
    [POWER.kicad_sch, SWARM_PCB_Rev_2.kicad_pcb]
2026-06-19 Finalized Design of Rev 2.1 and fixed all ERC and DRC errors
    [SWARM_PCB_Rev_2.kicad_pcb]
2026-06-19 Generated Output Files
    [SWARM_PCB_Rev_2-B_Cu.gbr, SWARM_PCB_Rev_2-B_Mask.gbr, SWARM_PCB_Rev_2-B_Paste.gbr, SWARM_PCB_Rev_2-B_Silkscreen.gbr, SWARM_PCB_Rev_2-Edge_Cuts.gbr, SWARM_PCB_Rev_2-F_Cu.gbr, SWARM_PCB_Rev_2-F_Mask.gbr, SWARM_PCB_Rev_2-F_Paste.gbr]
2026-06-22 Updated Via size to 0.25mm and ReExported Files
    [CONTROL.kicad_sch, HEADER_PINS.kicad_sch, POWER.kicad_sch, SENSOR.kicad_sch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]
2026-06-25 Cleaned up Schematic and Exported
    [CONTROL.kicad_sch, POWER.kicad_sch, SENSOR.kicad_sch, SWARM_PCB_Rev_2.kicad_sch, TX_RX.kicad_sch]
2026-07-07 Updated Silkscreen and Solder Mask Colour
    [SWARM_PCB_Rev_2.kicad_pcb]
